openai/gym/gym/envs/robotics/assets/stls/fetch/laser_link.stl

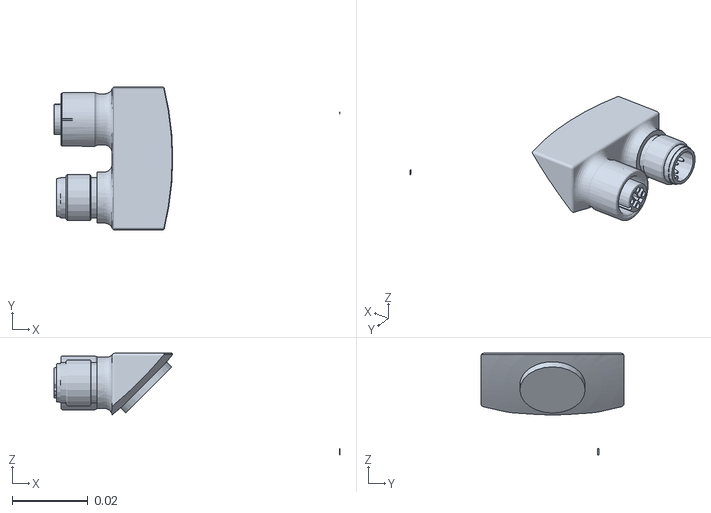
[picture p1: CAD file, 2018-02-26]
gym/envs/robotics/assets/stls/fetch/laser_link.stl
0.0754 x 0.0377 x 0.0268
