openai/gym/gym/envs/robotics/assets/stls/hand/TH2_z.stl

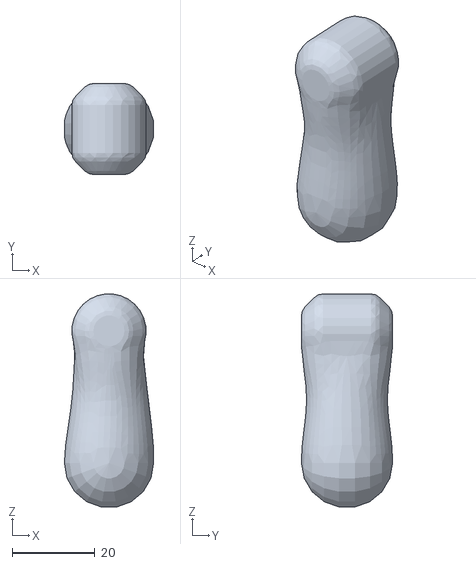
[picture p2: CAD file, 2018-02-26]
gym/envs/robotics/assets/stls/hand/TH2_z.stl
21.6 x 22.1 x 51.6
