openai/gym/gym/envs/robotics/assets/stls/fetch/base_link_collision.stl

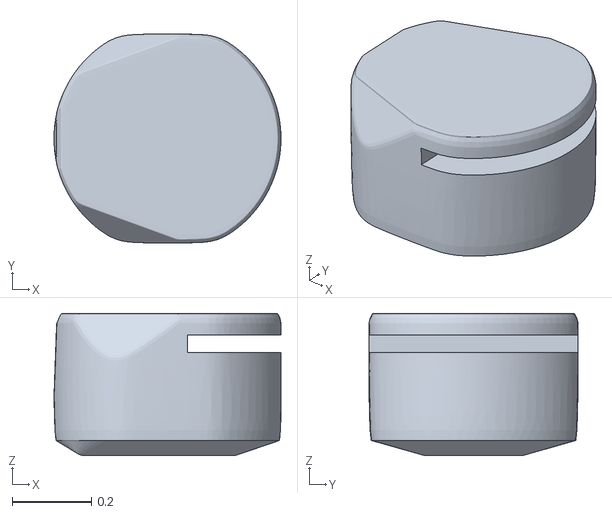
[picture p3: CAD file, 2018-02-26]
gym/envs/robotics/assets/stls/fetch/base_link_collision.stl
0.573 x 0.528 x 0.359
