openai/gym/gym/envs/robotics/assets/stls/hand/F1.stl

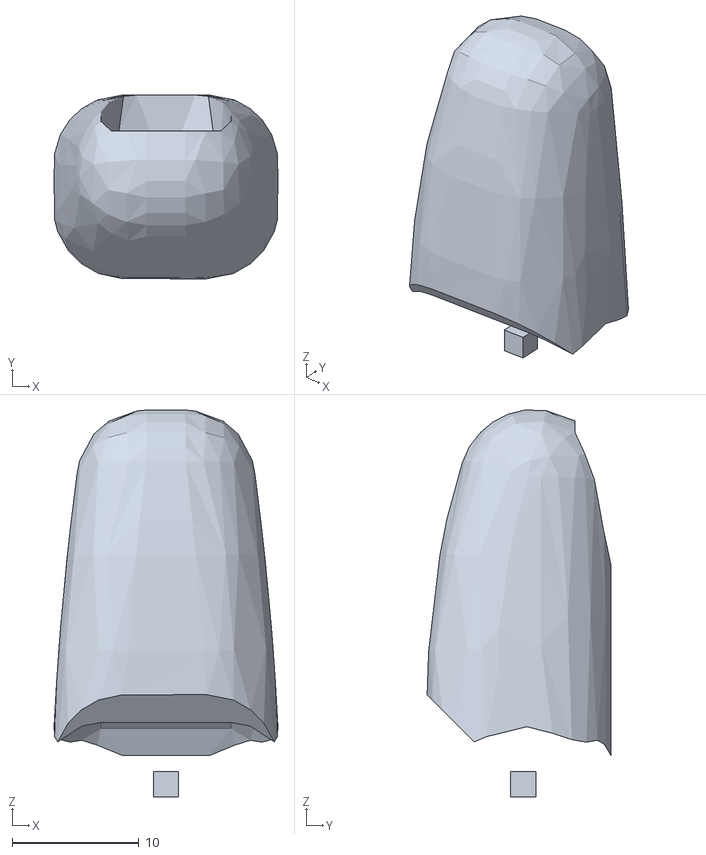
[picture p4: CAD file, 2018-02-26]
gym/envs/robotics/assets/stls/hand/F1.stl
17.7 x 14.5 x 30.5
