openai/gym/gym/envs/robotics/assets/stls/fetch/forearm_roll_link_collision.stl

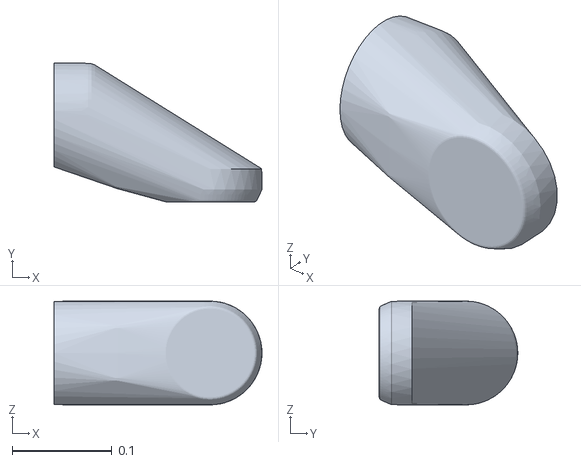
[picture p5: CAD file, 2018-02-26]
gym/envs/robotics/assets/stls/fetch/forearm_roll_link_collision.stl
0.208 x 0.139 x 0.104
