openai/gym/gym/envs/robotics/assets/stls/hand/lfmetacarpal.stl

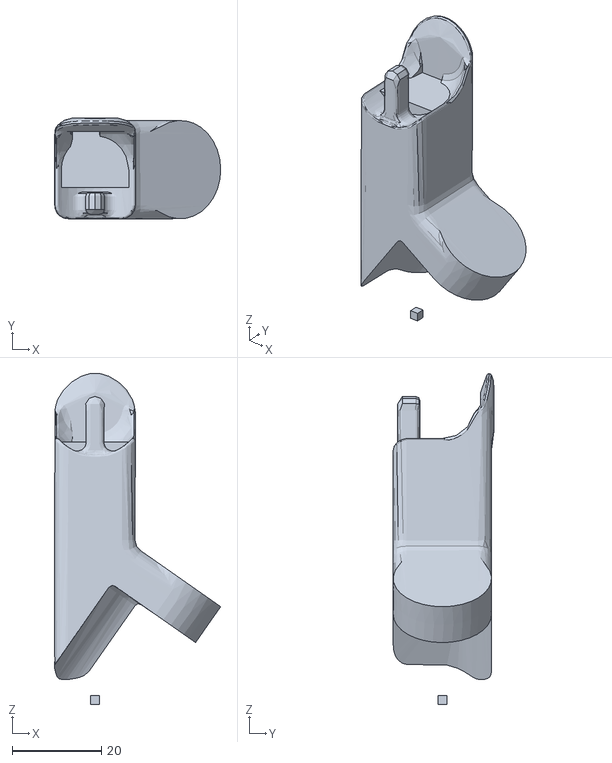
[picture p6: CAD file, 2018-02-26]
gym/envs/robotics/assets/stls/hand/lfmetacarpal.stl
37.3 x 22.5 x 74.1
