openai/gym/gym/envs/robotics/assets/stls/fetch/r_wheel_link_collision.stl

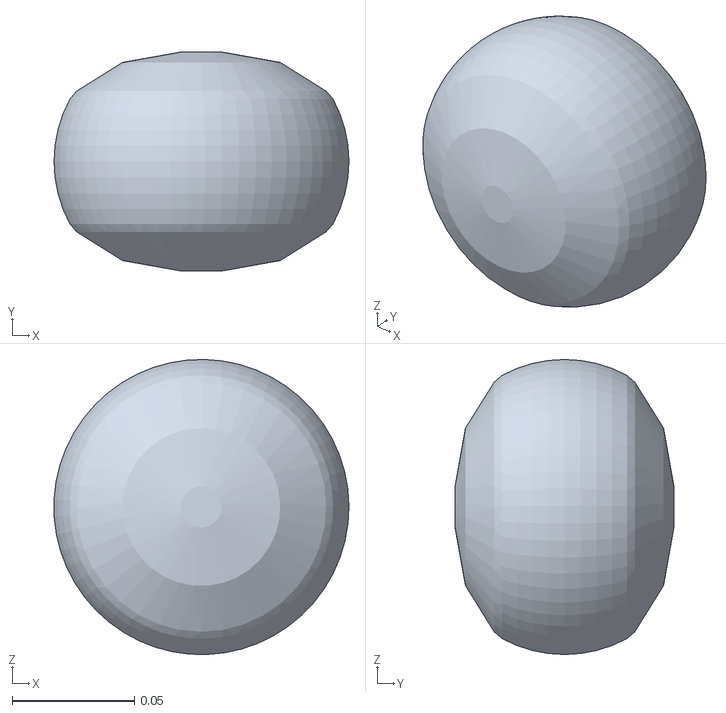
[picture p7: CAD file, 2018-02-26]
gym/envs/robotics/assets/stls/fetch/r_wheel_link_collision.stl
0.121 x 0.0895 x 0.121
