openai/gym/gym/envs/robotics/assets/stls/hand/palm.stl

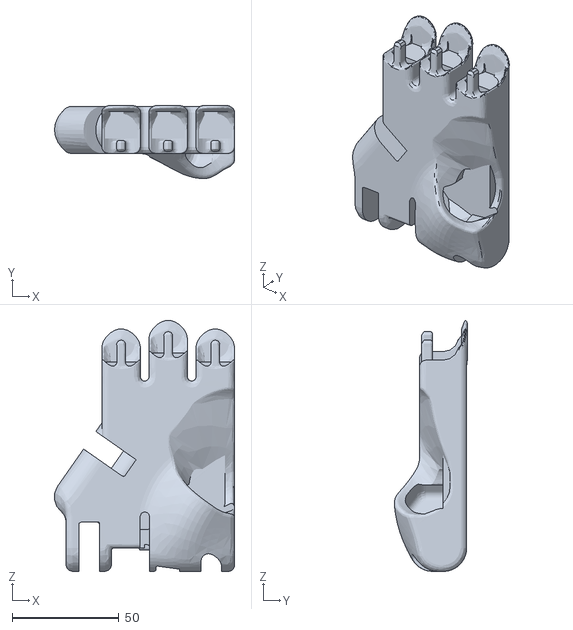
[picture p8: CAD file, 2018-02-26]
gym/envs/robotics/assets/stls/hand/palm.stl
84.2 x 34.3 x 117.3
