openai/gym/gym/envs/robotics/assets/stls/fetch/bellows_link_collision.stl

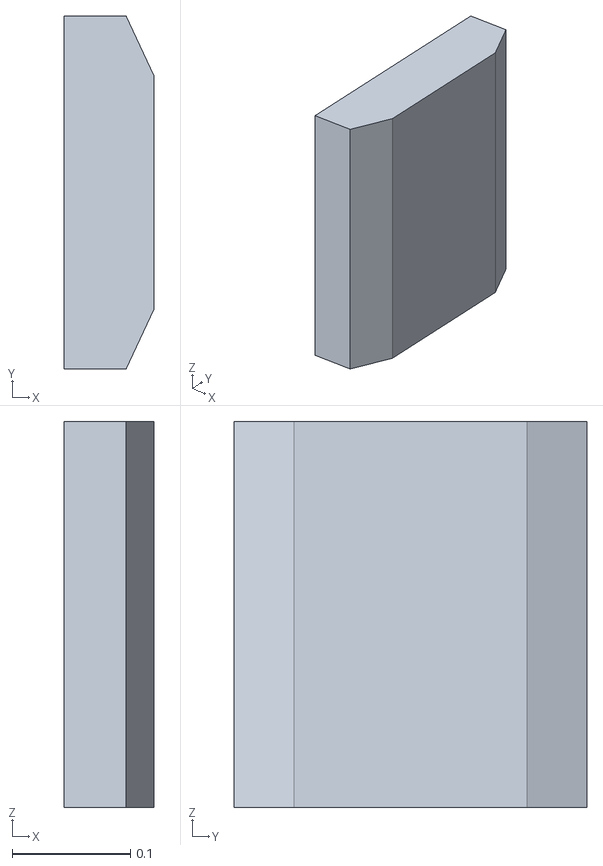
[picture p9: CAD file, 2018-02-26]
gym/envs/robotics/assets/stls/fetch/bellows_link_collision.stl
0.0764 x 0.299 x 0.327
