openai/gym/gym/envs/robotics/assets/stls/hand/wrist.stl

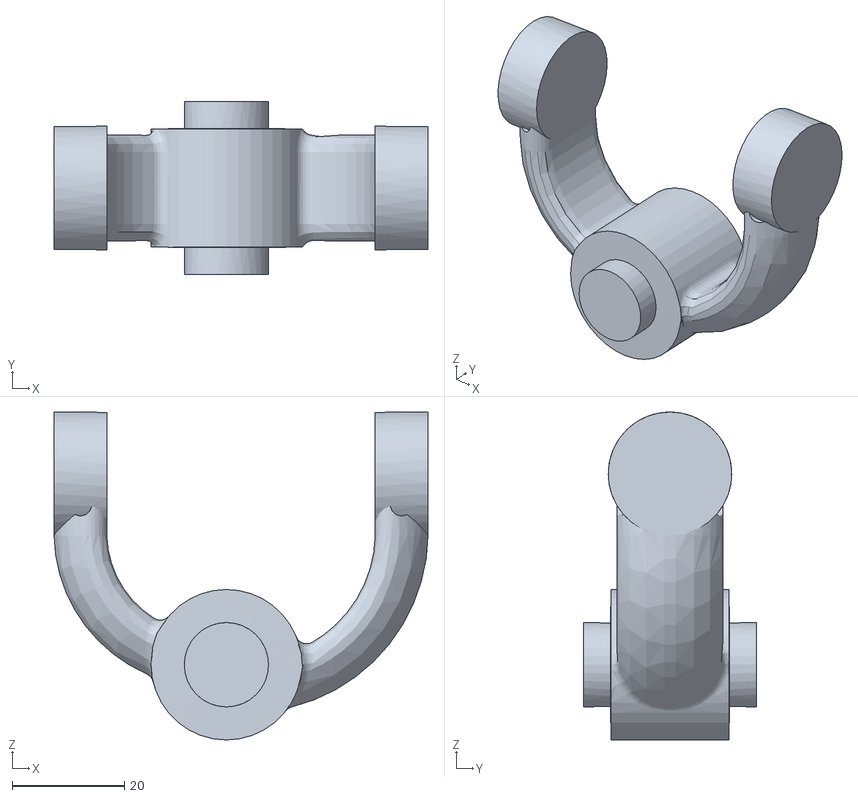
[picture p10: CAD file, 2018-02-26]
gym/envs/robotics/assets/stls/hand/wrist.stl
66.6 x 30.8 x 58.4
