openai/gym/gym/envs/robotics/assets/stls/fetch/wrist_flex_link_collision.stl

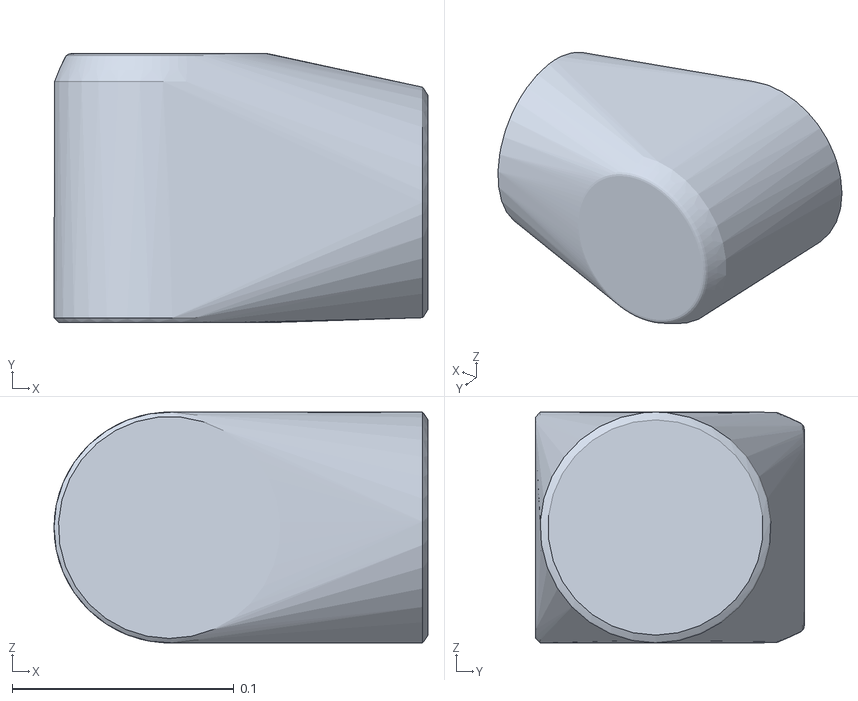
[picture p11: CAD file, 2018-02-26]
gym/envs/robotics/assets/stls/fetch/wrist_flex_link_collision.stl
0.168 x 0.121 x 0.104
