openai/gym/gym/envs/robotics/assets/stls/hand/F2.stl

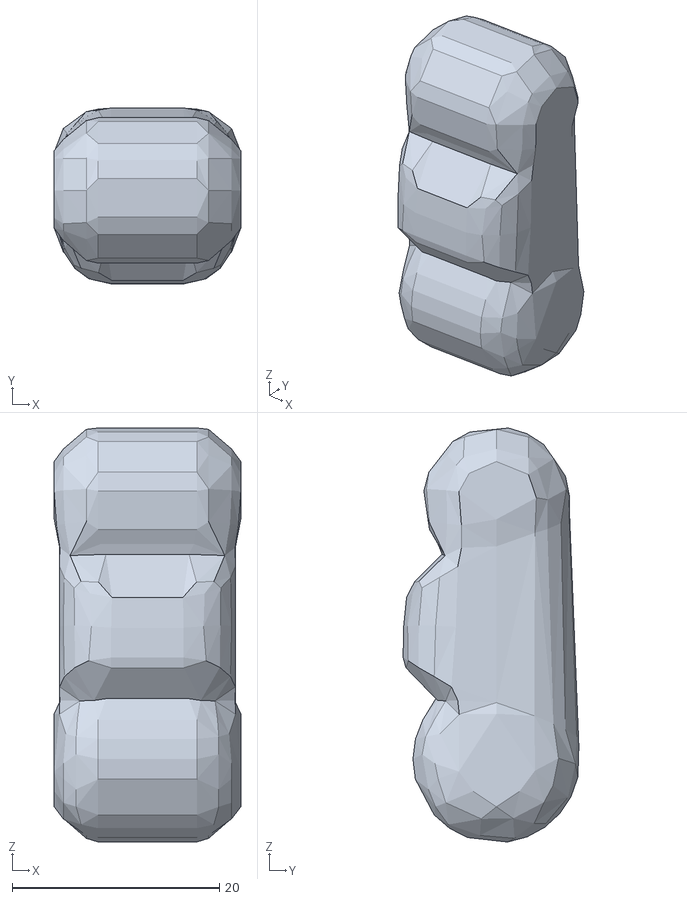
[picture p12: CAD file, 2018-02-26]
gym/envs/robotics/assets/stls/hand/F2.stl
18.0 x 17.0 x 39.9
