openai/gym/gym/envs/robotics/assets/stls/fetch/torso_fixed_link.stl

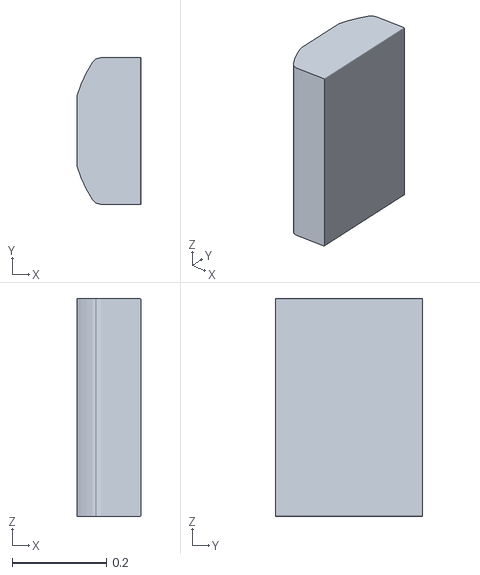
[picture p13: CAD file, 2018-02-26]
gym/envs/robotics/assets/stls/fetch/torso_fixed_link.stl
0.136 x 0.311 x 0.462
