openai/gym/gym/envs/robotics/assets/stls/hand/TH3_z.stl

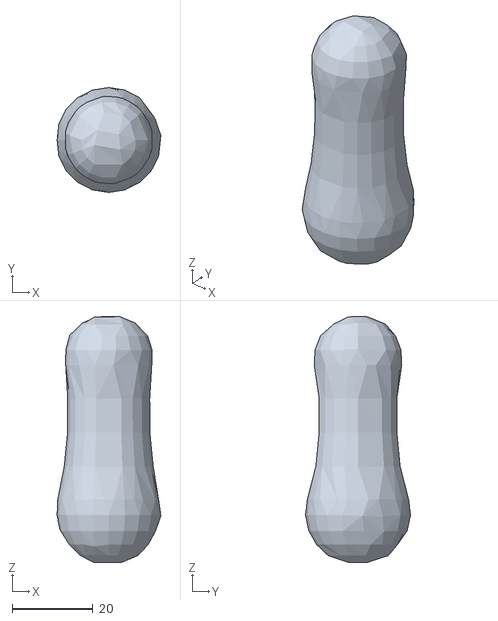
[picture p14: CAD file, 2018-02-26]
gym/envs/robotics/assets/stls/hand/TH3_z.stl
25.7 x 26.0 x 60.8
