openai/gym/gym/envs/robotics/assets/stls/fetch/gripper_link.stl

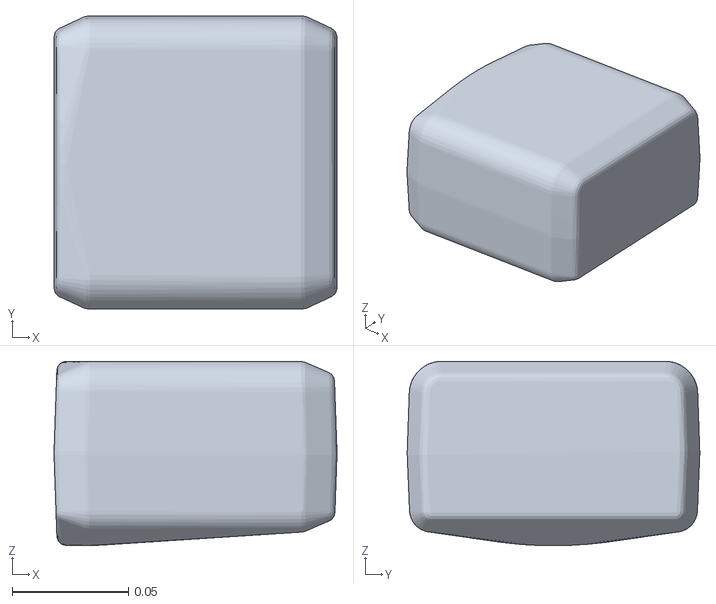
[picture p15: CAD file, 2018-02-26]
gym/envs/robotics/assets/stls/fetch/gripper_link.stl
0.122 x 0.126 x 0.0795
