openai/gym/gym/envs/robotics/assets/stls/hand/TH1_z.stl

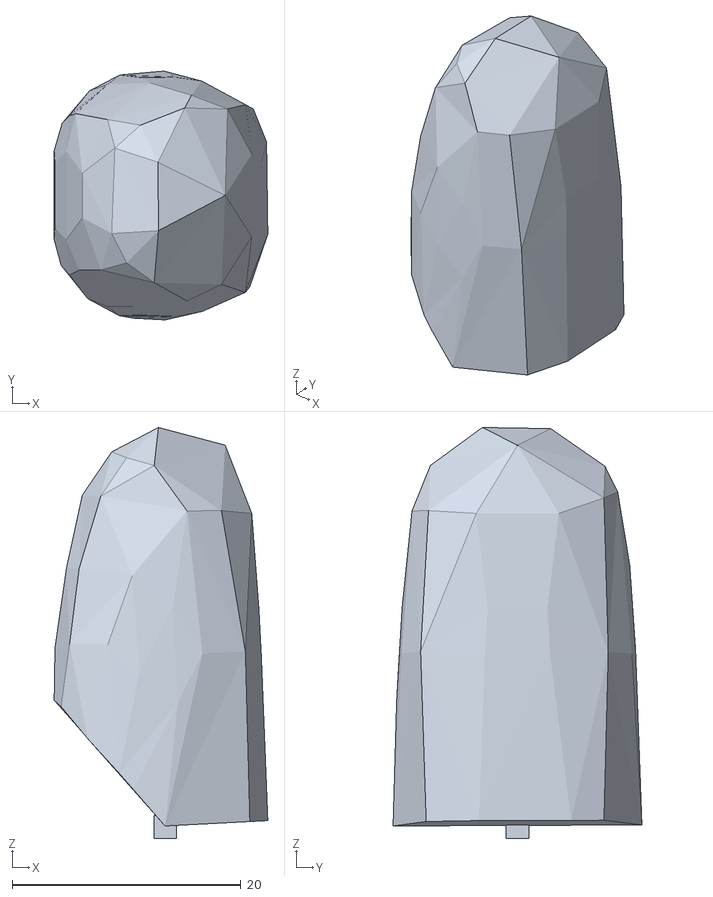
[picture p16: CAD file, 2018-02-26]
gym/envs/robotics/assets/stls/hand/TH1_z.stl
18.7 x 21.8 x 35.9
