openai/gym/gym/envs/robotics/assets/stls/fetch/head_tilt_link_collision.stl

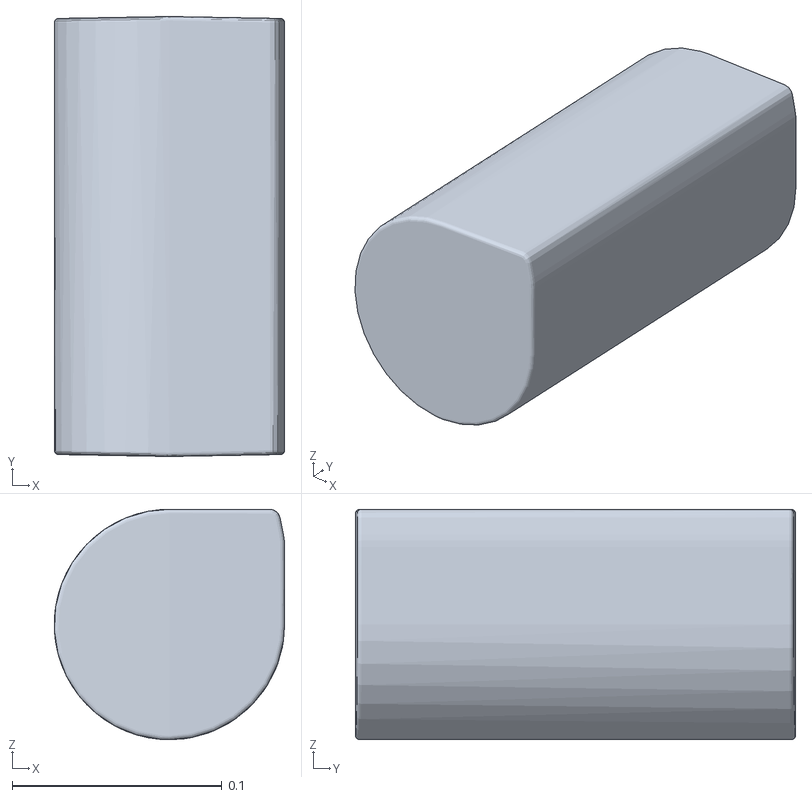
[picture p17: CAD file, 2018-02-26]
gym/envs/robotics/assets/stls/fetch/head_tilt_link_collision.stl
0.11 x 0.21 x 0.11
