openai/gym/gym/envs/robotics/assets/stls/hand/knuckle.stl

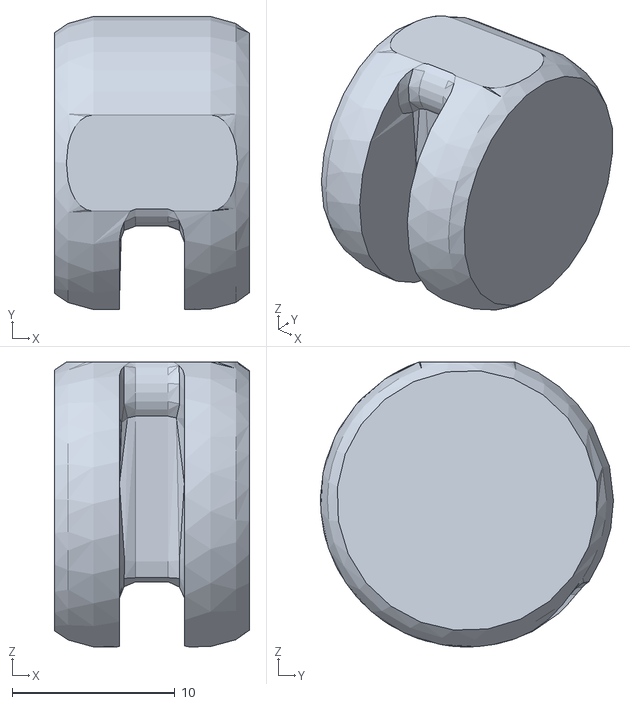
[picture p18: CAD file, 2018-02-26]
gym/envs/robotics/assets/stls/hand/knuckle.stl
12.0 x 18.0 x 17.5
