openai/gym/gym/envs/robotics/assets/stls/fetch/head_pan_link_collision.stl

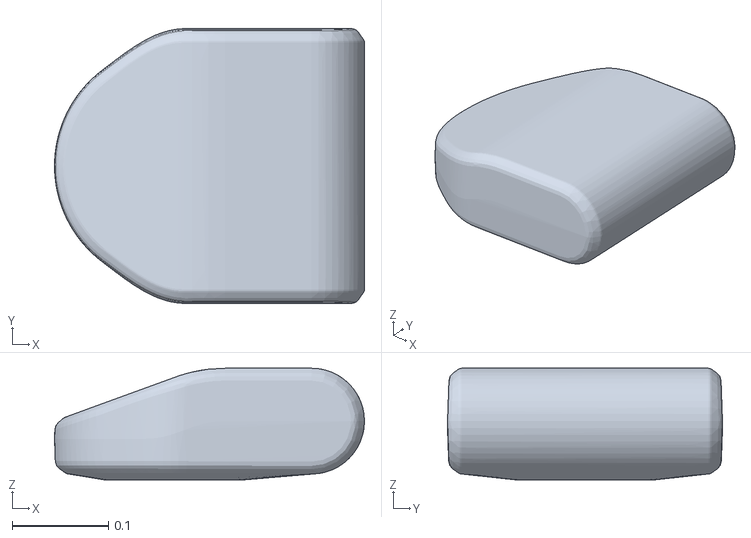
[picture p19: CAD file, 2018-02-26]
gym/envs/robotics/assets/stls/fetch/head_pan_link_collision.stl
0.322 x 0.286 x 0.116
