openai/gym/gym/envs/robotics/assets/stls/hand/forearm_electric_cvx.stl

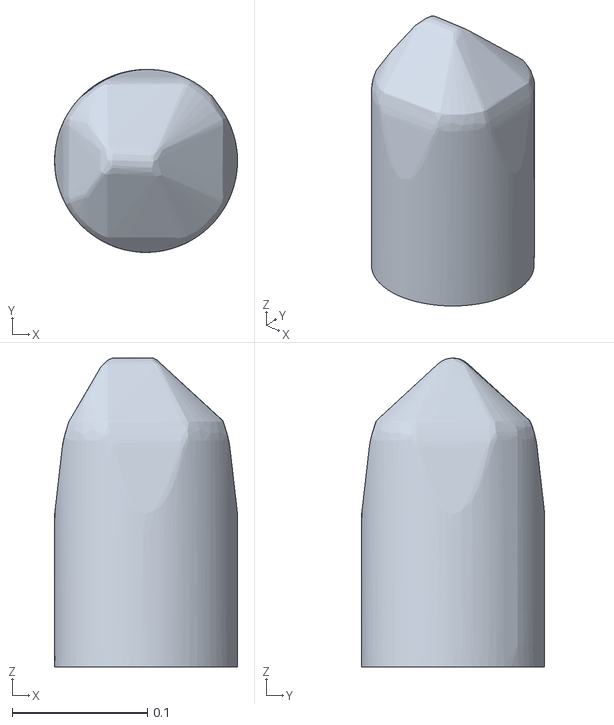
[picture p21: CAD file, 2018-02-26]
gym/envs/robotics/assets/stls/hand/forearm_electric_cvx.stl
0.135 x 0.135 x 0.228
