openai/gym/gym/envs/robotics/assets/stls/fetch/wrist_roll_link_collision.stl

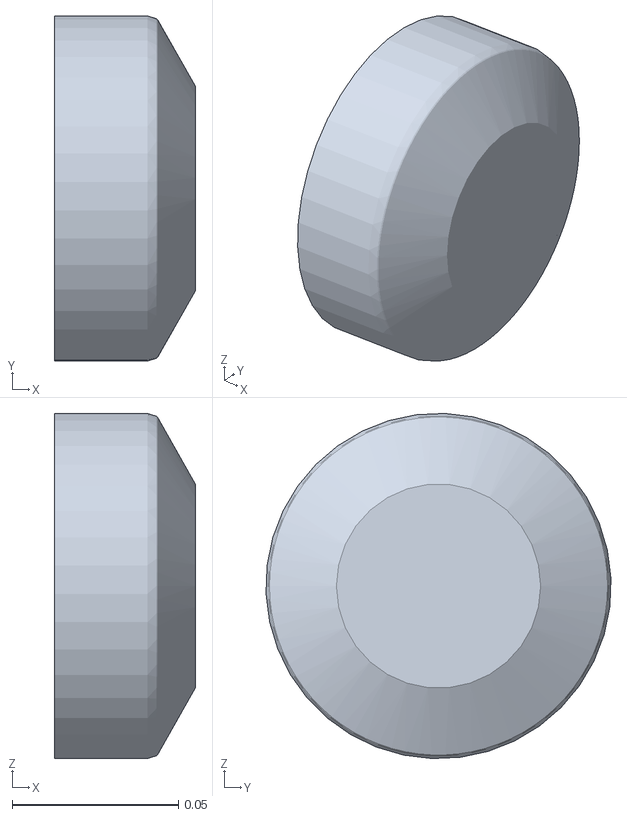
[picture p22: CAD file, 2018-02-26]
gym/envs/robotics/assets/stls/fetch/wrist_roll_link_collision.stl
0.0425 x 0.104 x 0.104
