openai/gym/gym/envs/robotics/assets/stls/hand/F3.stl

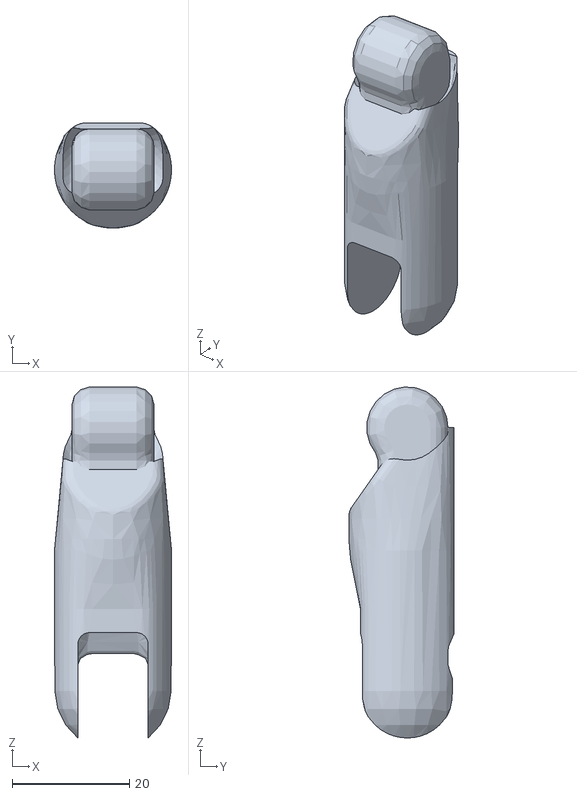
[picture p23: CAD file, 2018-02-26]
gym/envs/robotics/assets/stls/hand/F3.stl
20.0 x 18.0 x 59.9
