openai/gym/gym/envs/robotics/assets/stls/fetch/elbow_flex_link_collision.stl

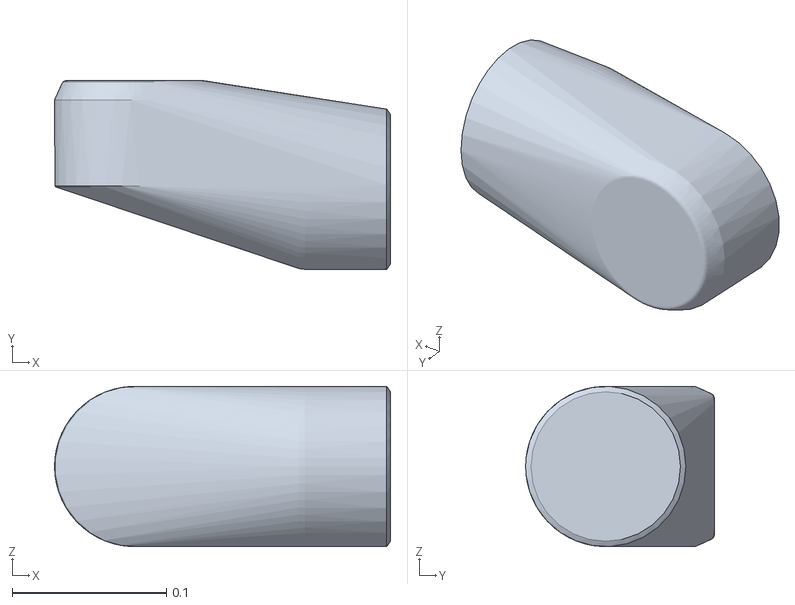
[picture p24: CAD file, 2018-02-26]
gym/envs/robotics/assets/stls/fetch/elbow_flex_link_collision.stl
0.218 x 0.123 x 0.104
