openai/gym/gym/envs/robotics/assets/stls/fetch/upperarm_roll_link_collision.stl

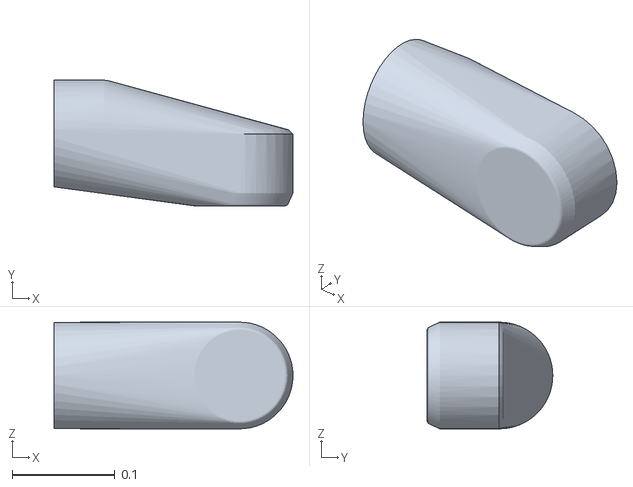
[picture p25: CAD file, 2018-02-26]
gym/envs/robotics/assets/stls/fetch/upperarm_roll_link_collision.stl
0.233 x 0.123 x 0.104
