openai/gym/gym/envs/robotics/assets/stls/fetch/shoulder_pan_link_collision.stl

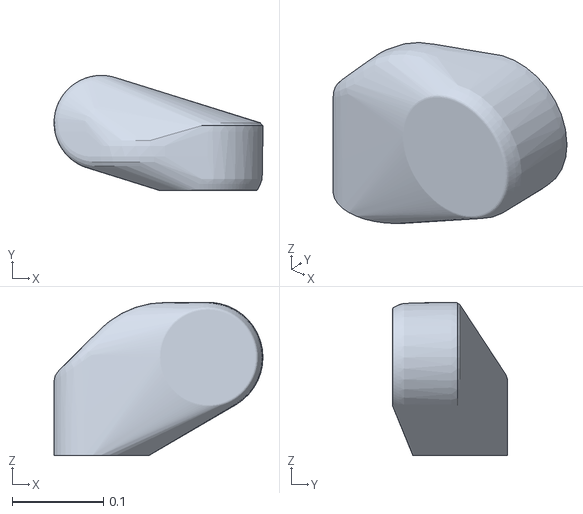
[picture p26: CAD file, 2018-02-26]
gym/envs/robotics/assets/stls/fetch/shoulder_pan_link_collision.stl
0.229 x 0.127 x 0.168
