openai/gym/gym/envs/robotics/assets/stls/fetch/estop_link.stl

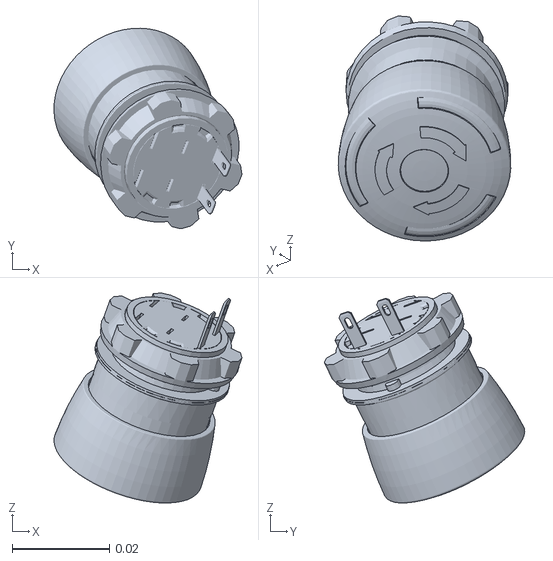
[picture p27: CAD file, 2018-02-26]
gym/envs/robotics/assets/stls/fetch/estop_link.stl
0.0387 x 0.0413 x 0.0433
