openai/gym/gym/envs/robotics/assets/stls/fetch/torso_lift_link_collision.stl

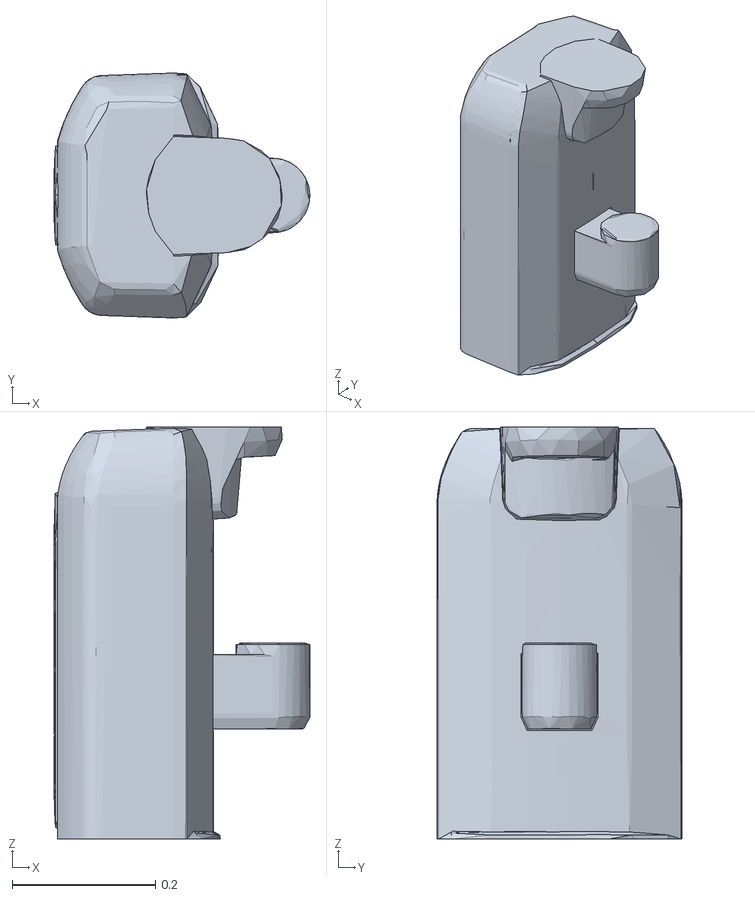
[picture p28: CAD file, 2018-02-26]
gym/envs/robotics/assets/stls/fetch/torso_lift_link_collision.stl
0.357 x 0.342 x 0.575
