openai/gym/gym/envs/robotics/assets/stls/fetch/shoulder_lift_link_collision.stl

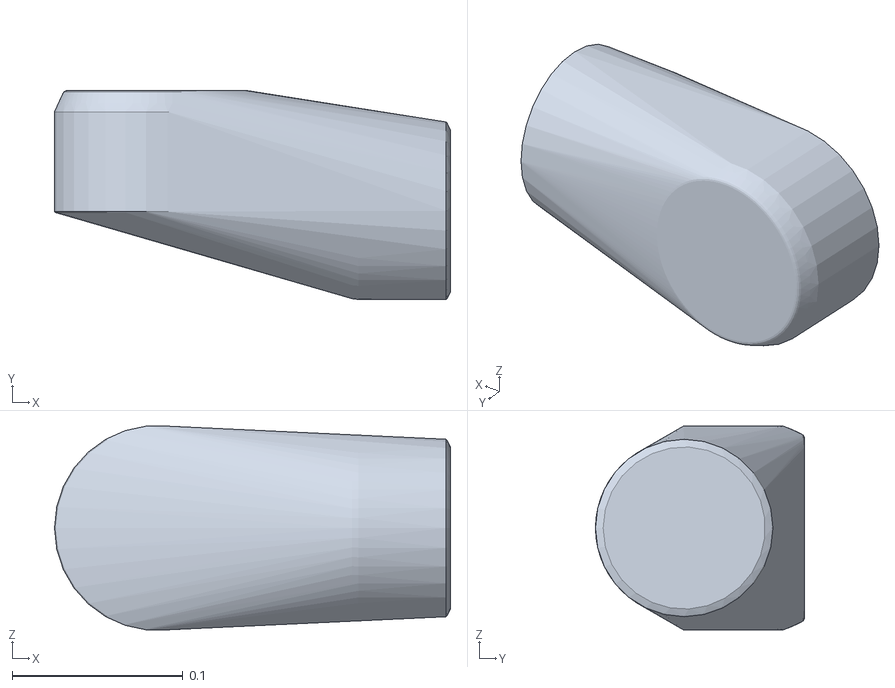
[picture p29: CAD file, 2018-02-26]
gym/envs/robotics/assets/stls/fetch/shoulder_lift_link_collision.stl
0.232 x 0.123 x 0.119
