openai/gym/(list of files, cad)

Other CAD files:
gym/envs/robotics/assets/stls/fetch/l_wheel_link_collision.stl
