openai/gym/docs/tutorials.md

## Getting Started With OpenAI Gym: The Basic Building Blocks

https://blog.paperspace.com/getting-started-with-openai-gym/

A good starting point explaining all the basic building blocks of the Gym API.

## Reinforcement Q-Learning from Scratch in Python with OpenAI Gym
Good Algorithmic Introduction to Reinforcement Learning showcasing how to use Gym API for Training Agents.

https://www.learndatasci.com/tutorials/reinforcement-q-learning-scratch-python-openai-gym/

## Tutorial: An Introduction to Reinforcement Learning Using OpenAI Gym

https://www.gocoder.one/blog/rl-tutorial-with-openai-gym
