openai/gym/(threads)

Thread 3 (2016-04-27):

ipython render window can't be closed

iandanforth, 2016-04-27:
If you attempt to create a notebook with the first CartPole example, the code runs but the rendered window cannot be closed:

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

Neither the standard x, nor ctrl-c, nor terminating the kernel through the notebook UI cause the window to close. If you kill the parent ipython process from the cmd line, that will kill all the child windows as expected.

System: Ubuntu 14.04 64.

Pretty cool this works at all though!

joschu, 2016-04-27:
You should be able to do env.render(close=True)

iandanforth, 2016-04-27:
Thanks! That works. FYI my thought process was to 1. Try reset 2. look for top level methods like env.exit, env.stop, env.close etc.

gdb, 2016-04-28:
Yeah, the `render(close=...)` method is a bit of a compromise: we want to keep the env API as simple as possible, both for implementors and consumers of the interface. I didn't want to add a top-level `close` method, since it's hard to know exactly *what* that'd mean (is the environment now permanently dead)? But if things get more complex, we could add a linked `renderer` object a la `monitor`.

erickrf, 2016-10-18:
I can't solve the problem with `env.render(close=True)` under macOS Sierra. If I try it, the renderized window just goes blank. Each time I call `env.render()`, a new window is created, and I can see all of them under mission control. Is there some way to close them?

capybaralet, 2017-04-18:
I have this problem as well.

If I make two envs (both called env), I lose the handle for the first one, so I can't close the window with env.render.

Is there a solution in this case? (other than closing the interactive session)

ethanluoyc, 2017-05-16:
I think this API is rather confusing indeed. I expect is to allow me to render the rgb view without opening a window but apparently that is not what it is doing. How can I get the desired behaviour?

tlbtlbtlb, 2017-05-16:
Unfortunately the rendering engine (OpenGL) is part of the window system,
and it needs at least an invisible window to associate it with some display
hardware.  Using a separate rendering engine for off-screen drawing is a
big project. Can you describe your use case to help us decide what we might
build?

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
--
Trevor Blackwell   tlb@openai.com    650 776 7870

ethanluoyc, 2017-05-19:
That is unfortunate. I do not really have a hard requirement for not displaying the window, but it is just that sometimes I do not need to see the window at all during training.

tlbtlbtlb, 2017-05-19:
If you don't need the window at all, just don't call `env.render()`.

ethanluoyc, 2017-05-21:
@tlbtlbtlb I think I can't. In my experiment I am using the visual image data directly as feature input. However, I think there is no other API for me to obtain that other than using `render`?

ahsteven, 2018-03-01:
Hi I just installed gym atari today. And ran the test code for atari:

`import gym
env = gym.make('SpaceInvaders-v0')
env.reset()
env.render()`

The Atar window pops open. however when I try to close with

env.render(close=True)

I get the error:
Traceback (most recent call last):
  File "<stdin>", line 1, in <module>
TypeError: render() got an unexpected keyword argument 'close'

cuongqn, 2018-03-04:
@ahsteven I think close is now a top level method. Using `env.close()` at the end when you want to close the window works for Windows 10 on Python 3.5.0.

lcukerd, 2018-05-08:
@cuongqn How do I close it after I interrupt the Kernel? `env.close()` is written at the end and will not work in case of Kernel interrupt. How do I close the window now?

shuruiz, 2018-06-11:
The env.render(close=True) command does not work for me. I got the following error:
---------------------------------------------------------------------------
TypeError                                 Traceback (most recent call last)
<ipython-input-4-56748e507b21> in <module>()
     13                 print("Total reward for episode: {}".format(episode_reward))
     14                 break
---> 15 random_agent(10)

<ipython-input-4-56748e507b21> in random_agent(num_episodes)
      6
      7         for t in range(1000):
----> 8             env.render(close=True)
      9             action =env.action_space.sample()
     10             observation, reward, done,info = env.step(action)

TypeError: render() got an unexpected keyword argument 'close'

nemanja-rakicevic, 2018-07-10:
In the new version of gym==0.9 you should use `env.close()`  but it doesn't close the render window...

skyler237, 2018-11-18:
A workaround I found is to simply wrap the training/simulation loop in a try-finally block so that even if I exit the loop early, the window will close.
For example:
`try:
    # training loop
finally:`

jimhoggey, 2019-07-17:
> env.render(close=True)

this did not work for me in gym retro parallel learning
but what did work was `self.env.render(close=True)`
thanks so much for the help
this has been a long issue that I could't fix but I finally did :)))))

insublee, 2019-10-30:
`env.render(close=True)`
didn't work for me. but
`env.render(mode='close')`
work.

sprakashdash, 2020-03-29:
You can also try `env.close()`. That too works for me!

DhruvaG2000, 2020-07-04:
I am using jupyter-notebook
env.render(close=True)
didn't work, it says 'close' keyword not recognized.
env.close() worked better, but even then sometimes a black window remained.
I had to exit() to close in that case. I guess gym isn't made to run in ipython-like environments?

sprakashdash, 2020-07-04:
The version compatibility might be an issue. The best compatibility is found with `python 3.6` and `gym 0.15`. Another hack is to use `env.render()` at the end of the for loop to close the window (in the same cell) and it works like charm!

samisnotinsane, 2021-06-03:
This issue is still ongoing. When I run CartPole-v0 demo:

```
import gym

env = gym.make('CartPole-v0')
env.reset()

for _ in range(1000):
    env.render()
    env.step(env.action_space.sample()) #take a random action

env.close()
```

The demo runs and then when I go to close it by clicking red X on the window, it freezes. I can force quit using OS and this kills the kernel. Once I restart kernel, I can run again but same behaviour repeats.

System spec:
```
Mac OS Big Sur   : 11.2.3
Python           : 3.8.5
Gym              : 0.18.0
jupyter core     : 4.7.0
jupyter-notebook : 6.1.4
qtconsole        : not installed
ipython          : 7.19.0
ipykernel        : 5.3.4
jupyter client   : 6.1.7
jupyter lab      : 2.2.9
nbconvert        : 6.0.7
ipywidgets       : 7.5.1
nbformat         : 5.0.8
traitlets        : 5.0.5
```

adyomin, 2021-07-23:
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

I get the following warning when I run this, the undefined behavior part seems potentially relevant:

> /home/adyomin/miniconda3/envs/sb3/lib/python3.8/site-packages/gym/logger.py:30: UserWarning: WARN: You are calling 'step()' even though this environment has already returned done = True. You should always call 'reset()' once you receive 'done = True' -- any further steps are undefined behavior.
  warnings.warn(colorize('%s: %s'%('WARN', msg % args), 'yellow'))

Checking for episode termination does solve the issue for me:

```
import gym

env = gym.make('CartPole-v0')
env.reset()

for _ in range(1000):
    env.render()
    obs, rewards, dones, info = env.step(env.action_space.sample()) #take a random action
    if dones:
        env.close()
        break
```

eemelipa, 2021-08-02:
@samisnotinsane as a workaround try to add `from gym.utils import play` to your imports. So run

```
import gym
from gym.utils import play

#%%

env = gym.make('CartPole-v0')
env.reset()

#%%

for _ in range(1000):
    env.render()
    env.step(env.action_space.sample()) #take a random action

env.close()
```

where "#%%" is a code cell separation. That helped for me. No idea why, but now the window closes from the cross and with env.close()  🤷

Almost like the plain gym import is missing something relevant for rendering on Mac.

I've got

```
Mac Os Big Sur      11.5
Python              3.7.11
gym                 0.18.3
jupyter-client      6.1.12
jupyter-console     6.4.0
jupyter-core        4.7.1
ipykernel           5.3.4
ipython             7.22.0
```

Closed 2016-04-28.

Thread 4 (2016-04-27):

video rendering doesn't work on windows

222464, 2016-04-27:
Hello,

I am able to run the gym on my windows machine, for the most part. However, despite ffmpeg being installed and added to the PATH (and detected), I get the following error when trying to render video:

`Clearing 2 monitor files from previous run (because force=True was provided)
[2016-04-27 16:31:49,407] Starting new video recorder writing to C:\tmp\random-agent-results\openaigym.video.0.17236.video000000.mp4
/dev/stdin: No such file or directory
Traceback (most recent call last):
  File "Gym.py", line 76, in <module>
    ob = env.reset()
  File "C:\Users\BlackBox\Anaconda3\envs\py27\lib\site-packages\gym-0.0.3-py2.7.egg\gym\core.py", line 87, in reset
    self.monitor._after_reset(observation)
  File "C:\Users\BlackBox\Anaconda3\envs\py27\lib\site-packages\gym-0.0.3-py2.7.egg\gym\monitoring\monitor.py", line 237, in _after_reset
    self.video_recorder.capture_frame()
  File "C:\Users\BlackBox\Anaconda3\envs\py27\lib\site-packages\gym-0.0.3-py2.7.egg\gym\monitoring\video_recorder.py", line 111, in capture_frame
    self._encode_image_frame(frame)
  File "C:\Users\BlackBox\Anaconda3\envs\py27\lib\site-packages\gym-0.0.3-py2.7.egg\gym\monitoring\video_recorder.py", line 161, in _encode_image_frame
    self.encoder.capture_frame(frame)
  File "C:\Users\BlackBox\Anaconda3\envs\py27\lib\site-packages\gym-0.0.3-py2.7.egg\gym\monitoring\video_recorder.py", line 284, in capture_frame
    self.proc.stdin.write(frame.tobytes())
IOError: [Errno 22] Invalid argument
[2016-04-27 16:31:50,016] VideoRecorder encoder exited with status 1`

When not using video, and explicitly calling env.render(), it works fine.

It seems to be a Linux-specific thing? Is there a quick way to fix this to get it to run on windows?

jonasschneider, 2016-04-27:
Hi, sorry, we currently aren't testing anything on Windows specifically. However, we'd love to help with getting everything to work there (and will definitely merge changes that fix compatibility).

If you have the time, could you try just replacing `/dev/stdin` with `-` in the `video_recorder.py` line mentioned in your log? This particular issue might be an easy fix.

222464, 2016-04-28:
Yes, it seems to work now. Thanks!

Closed 2016-04-28.

Thread 16 (2016-04-28):

[working deep RL demo][need help]Lasagne+Agentnet baselines

justheuristic, 2016-04-28:
Greetings!
We happen to have just pushed into the open source one of the Lasagne-based library for reinforcement learning algorithm design.

* The repo's here: [AgentNet](https://github.com/yandexdataschool/AgentNet)
* [A step-by-step demo for Atari SpaceInvaders ](https://github.com/yandexdataschool/AgentNet/blob/master/examples/Playing%20Atari%20with%20Deep%20Reinforcement%20Learning%20%28OpenAI%20Gym%29.ipynb)
* [Neural Kung-Fu with GRU and actor-critic](https://github.com/yandexdataschool/AgentNet/blob/master/examples/Deep%20Kung-Fu%20with%20GRUs%20and%20A2c%20algorithm%20%28OpenAI%20Gym%29.ipynb)

On the bright side,
- it is capable of sustaining virtually any custom RL (and even non-RL) architecture using minimalistic Lasagne network design
- it has most of the generic reinforcement learning algorithms (Q-learning, K-step algos, SARSA, Advantage Actor-Critic)
- It is also capable of interacting with any external environment with a simple wrapper.

On the gloomy one,  it has been made public ~4 days ago and doesn't have a community yet. Prior to that, it's only been used by several Yandex researchers for tinkering.

I would very much like to provide a set of baseline training/testing stands for several problems (and i will do so shortly), for people to be able to experiment with NN architecture, but i'm a bit doubtful about
- whether the interface of the library doesn't have any flaws worth immediate fixing
- whether there is someone interested in tinkering with openai baselines, provided they're readable and performing reasonably.

The most basic Reinforcement Learning pipeline looks [like this](https://github.com/yandexdataschool/AgentNet/blob/master/examples/Basic%20tutorial%20on%20Boolearn%20Reasoning%20problem.ipynb)

The questions are, again, if there is anyone interested in having such baselines for gym problems, and if so, what are possible api improvements you would recommend?

wojzaremba, 2016-04-28:
Having good, simple baselines is super important. This could tell which simple algorithms work. Feel free to submit your algs, and we will reproduce it, and review it.

justheuristic, 2016-04-29:
It actually turned out that our interfaces are even closer - around 30 lines of code from my example to start plating atari with simple convolutional q-network.

 - [The demo for Atari AirRaid ](https://github.com/yandexdataschool/AgentNet/blob/master/examples/AirRaid%20-%20Simple%20ConvNet.ipynb) (current notebook output is training session that was interrupted earlier than should be)
- [Some tinkering with SpaceInvaders](https://github.com/yandexdataschool/AgentNet/tree/master/research/gym)

Could you please try to run them on your side to see if they are indeed reproducible?

The problem is, to simplify the code i avoided bot recurrent memory layers and DeepMind tricks from atari article - simply trained a NN that tries to act based on current image frame - and of course i forgot that the atari games have flickering effect and some frames are plain rubbish.
So the next step (after some sleep) is definitely adding memory, since that is why the library was built in the first place.

Gym is indeed a super-unified interface, as switching through several atari games boiled down to simply switching their names in the notebook header.

Now the main question is, if these demos are at least somewhat readable, what would be the best course of actions to make them more interpretable?

justheuristic, 2016-04-29:
[updated comment above: the demo became more readable and has better scores]

wojzaremba, 2016-04-29:
Awesome. Looking forward for you submissions.

justheuristic, 2016-04-30:
This one is clearly early-stopped (learning curve still goes up almost linearly), but it works ~somehow~ nevertheless.
https://gym.openai.com/evaluations/eval_yv5uO0fRiS7eNaZGFKacw#reproducibility

justheuristic, 2016-04-30:
The question stands: how to make these more understandable?

justheuristic, 2016-05-01:
Thanks.
Added more detailed NN setup.

Again, please suggest any ways this thing can get easier to understand.

gdb, 2016-05-01:
(I might recommend asking in chat — I think one helpful approach might be to ask a beginner to work through it.)

justheuristic, 2016-05-02:
Well, i was stupid not to. Thanks!

Upd - trained NN to hurt humans using Kung-Fu, GRU and advantage actor-critic
https://github.com/yandexdataschool/AgentNet/blob/master/examples/Deep%20Kung-Fu%20with%20GRUs%20and%20A2c%20algorithm%20%28OpenAI%20Gym%29.ipynb

gdb, 2016-05-16:
(Going to close this; please let me know if there's more to discuss!)

Closed 2016-05-16.

Thread 9 (2016-04-28):

Error try to run monitoring

harshhemani, 2016-04-28:
When trying to run following code on Ubuntu MATE 14.04 LTS on intel i7:
```
import gym
env = gym.make("CartPole-v0")
env.monitor.start("/tmp/cartpole-experiment-1")
for i_episode in xrange(20):
    observation = env.reset()
    for t in xrange(100):
        env.render()
        print observation
        action = env.action_space.sample()
        observation, reward, done, info = env.step(action)
        if done:
            print "Episode finished after {} timesteps".format(t+1)
            break

env.monitor.close()
```

I get following error:
```
[2016-04-28 10:59:12,799] Making new env: CartPole-v0
[2016-04-28 10:59:12,800] Creating monitor directory /tmp/cartpole-experiment-1
[2016-04-28 10:59:12,801] Starting new video recorder writing to /tmp/cartpole-experiment-1/openaigym.video.0.8846.video000000.mp4
avconv version 9.18-6:9.18-0ubuntu0.14.04.1, Copyright (c) 2000-2014 the Libav developers
  built on Mar 16 2015 13:19:10 with gcc 4.8 (Ubuntu 4.8.2-19ubuntu1)
Traceback (most recent call last):
  File "temp.py", line 5, in <module>
    observation = env.reset()
  File "/usr/local/lib/python2.7/dist-packages/gym/core.py", line 87, in reset
    self.monitor._after_reset(observation)
  File "/usr/local/lib/python2.7/dist-packages/gym/monitoring/monitor.py", line 237, in _after_reset
    self.video_recorder.capture_frame()
  File "/usr/local/lib/python2.7/dist-packages/gym/monitoring/video_recorder.py", line 111, in capture_frame
    self._encode_image_frame(frame)
  File "/usr/local/lib/python2.7/dist-packages/gym/monitoring/video_recorder.py", line 161, in _encode_image_frame
    self.encoder.capture_frame(frame)
  File "/usr/local/lib/python2.7/dist-packages/gym/monitoring/video_recorder.py", line 284, in capture_frame
    self.proc.stdin.write(frame.tobytes())
AttributeError: 'numpy.ndarray' object has no attribute 'tobytes'
[2016-04-28 10:59:13,196] Finished writing results. You can upload them to the scoreboard via gym.upload('/tmp/cartpole-experiment-1')
```

Clearly the frame returned by `encoder.capture_frame()` is storing returning ndarray in the `frame`. How can I solve this?
PS: Without monitor, code runs perfectly.

rodrigob, 2016-04-28:
Please check that you are using a recent version of numpy.

Seems that tobytes was introduced in 1.9 back in 2014.
https://github.com/numpy/numpy/issues/6163

harshhemani, 2016-04-29:
Updates numpy, and it worked.
Also, tried fix#9 with old numpy, and it still worked.
Thanks.

Closed 2016-04-29.

Thread 41 (2016-05-01):

More discreet environments (Box2D)

olegklimov, 2016-05-01:
Hello,

I've found very few discreet environments to play with. It's MountainCar and CartPole, that's all, if you don't count Atari. All MuJoCo games have continuous actions.

I happen to have a few Box2D reinforcement learning environments, that I want to port. I think it's a good idea because Box2D is open-source, easy to install (pip install box2d) like the rest of gym. Should be a good start for new people.

1) CartPole swing up, physics, friction, more reward if kept in center (3 actions).

2) MoonLander (6-wide state, 4 actions).

3) PipedalWalker (16-wide state, 4 actuated joints, 3*3*3*3=81 actions).

Greg, John please tell me if you don't need it and not going to merge it, I'll stop.

rickhenderson, 2016-05-02:
Have you posted code for your environments? Maybe if people saw them and tried them out then more people would request they get added. I'm new here so just throwing out suggestions.

joschu, 2016-05-02:
+1: a good first step would be to post the code somewhere, e.g., in it's own github repo.
I'd recommend creating the envs with continuous action spaces. If people need discrete actions, they can discretize themselves.

olegklimov, 2016-05-02:
Please someone test if it works for you.

https://github.com/olegklimov/gym/commits/box2d

I'll make one or two more environments and publish a PR.

olegklimov, 2016-05-02:
To test, run one of these:

```bash
python examples/agents/keyboard.py LunarLander-v0
python examples/agents/keyboard.py CartPoleSwingUp-v0
```

You should get be able to play from keyboard like this:

https://youtu.be/ZTlpZSN5gdA

I don't have a working learning agent at hand, cannot test reward and states of this two environments. If you have, please give it a try.

joschu, 2016-05-02:
These are nice! I'm running learning algorithms on them now.

jonasschneider, 2016-05-03:
These are really cool. Can you open a PR so we can start discussing the code? (In particular, I'm wondering if we can make Box2D installation any easier.)

joschu, 2016-05-03:
What's the reward function for lunar lander? I'm getting the following behavior, is it optimal?
[openaigym.video.0.24.video035000.mp4.zip](https://github.com/openai/gym/files/247258/openaigym.video.0.24.video035000.mp4.zip)
My algorithm didn't solve cart-pole swing-up, but maybe that's just because it's not exploring well enough. Have you verified that it's possible to solve with keyboard control in the allotted timesteps?

jonasschneider, 2016-05-03:
I think the reward function might be missing a component that forces you to land eventually, e.g. a "running out of fuel", or maybe the alive penalty just has to be higher.

Could also imagine penalizing high accelerations, high distances from the helipad, and/or forceful/non-upright ground impact.

olegklimov, 2016-05-03:
> Could also imagine penalizing high accelerations, high distances from the helipad, and/or forceful/non-upright ground impact.

`shaping = - abs(state[0]) - abs(state[1]) - abs(state[2]) - abs(state[3]) - abs(state[4])`

It is distance from helipad (`state[0]` and `state[1]`), high speed (`state[2]` and `state[3]`) and high angular velocity (`state[4]`).

Total potential change from top of the screen to target is about 1.4, i.e. to get to helipad and have zero speed is about 1.4 total reward. On landing (body not awake) it receives additional +1. On crash, -1.

I'm not saying it has no bugs, sure there's something.

> I'm getting the following behavior, is it optimal

Optimal is to come down and get zero speed (+1.4) and land (another +1). Solved is more than 2.0. Hopefully.

olegklimov, 2016-05-03:
> Can you open a PR

I'm working on third environment (with normal and hardcore version), then I'll make another branch (I noticed botched merge on current branch) and PR.

olegklimov, 2016-05-03:
https://github.com/openai/gym/pull/54

gdb, 2016-05-16:
(#54 is merged; closing issue.)

Rokas98765, 2017-11-05:
Is there any chance anyone would know why I'm getting this error? 'pip install gym' worked but it only installed 3 environments, when I try to install 'pip install box2d' this error comes up:

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

Closed 2016-05-16.

Thread 71 (2016-05-08):

Env.step() with no action

keleftheriou, 2016-05-08:
Intuitively, an algorithm should at any point also have the choice of *not* acting at all.

At least in the example of control/physics environments, being able to not act might sometimes be the "best" choice. Defining "best" here can be a long discussion, but as an example an algorithm might be optimizing for *efficiency* (reward/effort), rather than absolute reward.

jonasschneider, 2016-05-08:
This seems like it's mostly a semantic issue with env action spaces. In some envs, "not acting" is meaningless -- take board games like Chess or Go (the latter we have as an env already) for example: if it's your turn, you can't meaningfully choose to "not act".

Also, _efficiency/effort_ are ill-defined concepts whose semantics depend on the env. In fact, what you propose is already implemented in some envs. For example, the mujoco envs penalize you (i.e. reduce reward) based on the joint torques that you specify, i.e. what could intuitively be described as the "effort".

So it seems like this is a per-env semantic issue. We're happy about proposals for definitions of efficiency for specific envs, though!

tlbtlbtlb, 2016-05-08:
In (I think) all the physics environments the actions are converted to torques, so a vector of 0s is a reasonable least-effort action. That might not be obvious from the `action_space`, which usually is a `Box` with `low=[-1, ...]` and `high=[+1, ...]`.

keleftheriou, 2016-05-09:
I've only been playing with the 'CartPole-v0' environment so far, and that has an `action_space` of `spaces.Discrete(2)` which led me to my comment.

I wonder if making `Env.step()` have `action=None` as a default could work, letting the environment  complain if it can't accept it. The API would be more general this way, and the potential for API misuse by either environment users or environment authors seems low.

 Alternatively, 'CartPole-v0' could just be changed to take a `Box` `action_space` instead of a `Discrete` one, although it feels like this particular environment might have been purposefully made to not take variable force values.

Good to know about the mujoco environments utilizing a notion of "effort" through the `reward` returned, thanks.

gdb, 2016-05-09:
The feedback makes sense; thanks for the input!

This isn't part of the standard formulation of RL, so I think for now we shouldn't add it (and I'm not sure if it'd make sense for every env). I'm going to close for now, but if we see more demand for something like this, we'll revisit!

ivanvoid, 2022-09-02:
So you wanna say this issue was never resolved?
Yea 4 years later, please add option to stay still in 'CartPole-v1',
or just help to figure out how to make it possible, this also will be really appreciated.

soroush-bn, 2023-05-26:
@gdb I came across the same problem when I want to add additional actions for "Taxi" environment, I want to add diagonal movements to the grid world, however, it is not possible to perform such action when agent is on the edge of the grid, thus, whether I need to create my custom env or use a "NOOP" action and pass it to env.step() function to see the observation and etc.

meghbhalerao, 2024-12-16:
https://github.com/openai/gym/issues/71#issuecomment-217780087 - why would this not be a part of the standard formualation of RL?
We can have an MDP with an action = None, which would essentially have the following transition probablity distribution -
T(s'|s,a = None) = 1 if s'= s, else = 0.
I think it would be useful to have this, say, if one simply wants to get the current env state. Or am I missing something here?

leafstar, 2025-01-24:
> [#71 (comment)](https://github.com/openai/gym/issues/71#issuecomment-217780087) - why would this not be a part of the standard formualation of RL? We can have an MDP with an action = None, which would essentially have the following transition probablity distribution - T(s'|s,a = None) = 1 if s'= s, else = 0. I think it would be useful to have this, say, if one simply wants to get the current env state. Or am I missing something here?

I don't think so. In cartpole environment, intuitively, if you do nothing when the pole is not vertical to the cart, finally it will fall. Therefore the state will also be changed even if you do nothing.

Closed 2016-05-09.

Thread 95 (2016-05-12):

occasional exception when resetting the environment

yakticus, 2016-05-12:
Symptom is an exception while resetting the environment during monitoring:

```
File "/Users/julie/github/gym/gym/core.py", line 102, in reset
    self.monitor._after_reset(observation)
  File "/Users/julie/github/gym/gym/monitoring/monitor.py", line 250, in _after_reset
    self.video_recorder.capture_frame()
  File "/Users/julie/github/gym/gym/monitoring/video_recorder.py", line 105, in capture_frame
    frame = self.env.render(mode=render_mode)
  File "/Users/julie/github/gym/gym/core.py", line 153, in render
    return self._render(mode=mode, close=close)
  File "/Users/julie/github/gym/gym/envs/classic_control/cartpole.py", line 132, in _render
    return self.viewer.get_array()
  File "/Users/julie/github/gym/gym/envs/classic_control/rendering.py", line 102, in get_array
    arr = arr.reshape(self.height, self.width, 4)
ValueError: total size of new array must be unchanged
```

Unfortunately I don't have exact steps to reproduce as it seems to happen sporadically when using the CartPole-V0 environment (I haven't tried others). Will give more details as they are uncovered.

If it helps, information about my python environment is attached.

[pythonenv.txt](https://github.com/openai/gym/files/262094/pythonenv.txt)

tlbtlbtlb, 2016-05-12:
Puzzling. Could you try replacing the arr.reshape with
```
    try:
        arr = arr.reshape(self.height, self.width, 4)
    except:
        print arr.shape, self.height, self.width
        raise
```
to see what shape it has?

Does your Mac have a Retina screen?

yakticus, 2016-05-12:
This is what I get for `arr.shape, self.height, self.width`:

`(84,) 400 600`

yakticus, 2016-05-12:
some additional context that's worth mentioning - I wrote a quick & dirty wrapper API for the gym so that I could use it from non-Python code. Could the error arise by having the `env` be a global thing that is re-used more than once?

https://gist.github.com/yakticus/de3639c23675a4f6e05b54e5faef56d4

yakticus, 2016-05-12:
> Does your Mac have a Retina screen?
yes

JKCooper2, 2016-05-13:
When you say env is being reused in that do you mean that monitor is being started and closed multiple times? When an env in created a monitor is created along with it which is given a unique monitor id (which is selected using a global variable and a lock). When monitor.close is run it removes the monitor from the monitors dictionary which can cause issues when you try and restart it

Try adding `env = gym.make(envname)` just before line 20 of your wrapper so that each time you call monitor(state=on) the monitor it's doing it with a fresh environment (and a usable monitor)

yakticus, 2016-05-13:
I wasn't aware of the coupling between environment and monitor. Creating a new environment for each monitor seems to have addressed the problem. On a related note, Is there already a place in the repo or website carved out to create more in-depth documentation about the APIs and architecture of the gym? If not, I could start something under docs/api.md so that others don't make the same mistake I did.

JKCooper2, 2016-05-14:
Not currently, although it has been discussed as to how best to document the code so people are aware of what's going on. I think they want to remain very flexible with anything that's done while the beta is running and not make any decisions before they have enough information.Maybe bring this up in chat and seeing if they're happy with an api.md file as a starting point.

gdb, 2016-05-14:
Very happy with an api.md file. And yes, not quite ready to double down on another documentation source yet, though I'm sure as we add more of these doc files we'll figure out what we need over time. Thanks!

Closed 2016-05-16.

Thread 106 (2016-05-18):

Write more documentation about environments

joschu, 2016-05-18:
We should write a more detailed explanation of every environment, in particular, how the reward function is computed.

JKCooper2, 2016-06-02:
Here's how I imagined a basic environment documentation page looking [link](https://docs.google.com/document/d/1bCDna95FRfvFA850qwqqLqZxENdU70psiqaOGob9oLI/edit?usp=sharing). Let me know if you have any suggestions then I'll transfer it to MarkDown and see how it looks in that

nealmcb, 2016-06-13:
@JKCooper2, thanks for the link.  That page seems pretty complete.

I'm not sure how you see the Challenge section working.  Can you add or point to some examples?

But I wonder where we want to document these things.  To avoid duplication, I'd think the code should contain the primary documentation, including what is documented in your sections 1 and 2: Overview and Environment.  I suggest that we should just document each aspect in the appropriate part of the code.  There could ideally be a standard build tool to pull out the appropriate documentation (via tags of some sort?) and update a main landing page on the site for each environment, presumably https://gym.openai.com/envs/CartPole-v0, which also documents how various algorithms have worked on it.

For the "Research" section, a link to some pages on the site that describe relevant research would also be fine in the code.  Or we might just want to just link from the landing page to an associated wiki page on the site, that could discuss research, proposed algorithms, etc.

JKCooper2, 2016-06-14:
For the Challenge section I was thinking that it would have a list of criteria that means you could tell whether your algorithm could theoretically solve the environment (ignoring hyper-parameters / computational limitations).

Examples would include:
 - 1A Discrete versus 1B continuous observation space
 - 2A Discrete versus 2B continuous action space
 - 3A One versus 3B n dimensions in the action space (e.g. Acrobot has three discrete action but they exist along one dimension of the force applied, versus Walker or something where you can control different joints independently)
 - If discrete action: 4A Two versus 4B more than two discrete actions
 - 5 Multiple rewards are available at a single point in time
 - 6 Stochastic action effect (Action can be switched by environment according to percentage)
 - 7 Goal changes over time
 - 8 Observation state incomplete (The observation provided doesn't always contain critical information, e.g. in basketball when the goal end swaps if this were only provided once per quarter)
 - 9 No reward surrounding initial state - any sequence of 20 actions by the agent from the starting state won't results in seeing a reward
 - 10 Task recognition (agent will be trained over multiple environments and need to be able to determine which environment it is currently in)
 - 11 Generalisation (agent will be run over one environment and then needs to apply knowledge to another environment with the same challenge set)

CartPole: 1B, 2A, 3A, 4A
Acrobot: 1B, 2A, 3A, 4B, 9
MountainCar: 1B, 2A, 3A, 4A, 9
Pendulum: 1B, 2B, 3A
Taxi: 1A, 2A, 3B, 4B, 7
Pacman: 1B, 2A, 3B, 4B, 5, 7
Pacmac-Ram: 1B, 2A, 3B, 4B, 5, 7, 8 (maybe)

The idea then being if I create an algorithm that can handle 1B, 2A, 3A, 3B, 4A, 4B, 9 then it should be capable of solving (with only hyper-parameter changes) CartPole and Acrobot, but won't be capable of solving any of the others

That's obviously an incomplete set and the definitions some may not make sense or need to be altered, but it would have a lot of benefits:
1. Easy to tell what your algorithm will/won't work on and why
2. Focus for creating environment's that have challenge sets that don't already exist
3. Good comparability on algorithms with matching 'abilities'
4. Focus for creating algorithms with specific abilities
5. Much simpler to take an rl agent and apply it to a real-world problems (just define the problem and select an algorithm that meets the challenge criteria)
6. Test task recognition and generalisation over similar environments (based on matching challenge sets)

JKCooper2, 2016-06-14:
For the environment documentation I was imagining it like a project/assignment description. I don't think people should need to look in the code for information about how the environment works, and would prefer it to be listed independently even if it means some duplication (although not a lot because it would only be updated if the environment version changes).

The Research section was partly to make it easier for researchers to identify was relevant papers exist for what they are working on, but also to encourage people to replicate existing research algorithms in order to improve the benchmark quality. I think replicated published research algorithms should be given special treatment or at least marked differently so people can easily see "This algorithm is a working copy of this paper". Having wiki style info regarding the papers could be useful, but I think it would work better to have links from the environment documentation research section to a summary page for the paper that has that information.

I was thinking it would sit on something like https://readthedocs.org/ where the documentation would be updated via git and you can have sub-menu's on the side to choose which section you're viewing.

Discussion and comments should be separate from documentation, maybe a forum. The goals as I see it should be to make it simple for people to understand the task (docs), share relevant information (research), come up with new ideas (forum/gitter), and focus effort (challenges/requests for research).

nealmcb, 2016-06-16:
Thanks.  I agree that the documentation should be clear about research that it was based on etc, and the forum/wiki would just be to make it easier for folks to comment and add information.

Re: "Challenge", that was the sense I had, and your details help a lot.

The code already defines a lot of this with great precision via the Env.{action_space,        observation_space,reward_range} variables.  I'm hoping it would be easier to just capture that information via introspection, hopefully as part of the build process, and automatically generate a concise and easy to use representation of it for inclusion in the documentation.  Otherwise, we run the risk of the documentation lagging behind the code or disagreeing with it.

I haven't yet looked at enough environments here to be sure what you mean by 7, 8, 9, but more generally, a useful categorization scheme for AI environments, based on Russell and Norvig (2009), is at https://en.wikibooks.org/wiki/Artificial_Intelligence/AI_Agents_and_their_Environments:

> "[they] can be remembered with the mnemonic "D-SOAKED." They are:

> - Deterministicness (deterministic or stochastic or Non-deterministic): An environment is deterministic if the next state is perfectly predictable given knowledge of the previous state and the agent's action.
 - Staticness (static or dynamic): Static environments do not change while the agent deliberates.
- Observability (full or partial): A fully observable environment is one in which the agent has access to all information in the environment relevant to its task.
- Agency (single or multiple): If there is at least one other agent in the environment, it is a multi-agent environment. Other agents might be apathetic, cooperative, or competitive.
- Knowledge (known or unknown): An environment is considered to be "known" if the agent understands the laws that govern the environment's behavior. For example, in chess, the agent would know that when a piece is "taken" it is removed from the game. On a street, the agent might know that when it rains, the streets get slippery.
- Episodicness (episodic or sequential): Sequential environments require memory of past actions to determine the next best action. Episodic environments are a series of one-shot actions, and only the current (or recent) percept is relevant. An AI that looks at radiology images to determine if there is a sickness is an example of an episodic environment. One image has nothing to do with the next.
- Discreteness (discrete or continuous or ): A discrete environment has fixed locations or time intervals. A continuous environment could be measured quantitatively to any level of precision."

As far as I've seen, the gym might not yet support some of these options.  But adding a way to encode and document and perhaps declare (in the code) the rest of those would indeed be helpful.  I imagine this has come up before - does anyone know if we can leverage other existing work on a typology of environments?

nealmcb, 2016-06-17:
To play around with extracting useful documentation automatically from the code, I wrote a little program to query a bunch of things about the environments for display in a markdown table.  Here is the code and the output, on the subset for which make() works for me at the moment.  A few variables which don't vary in this dataset are commented out.

```
from gym import envs

class NullE:
    def __init__(self):
        self.observation_space = self.action_space = self.reward_range = "N/A"

envall = envs.registry.all()

table = "|Environment Id|Observation Space|Action Space|Reward Range|tStepL|Trials|rThresh\n" # |Local|nonDet|kwargs|
table += "|---|---|---|---|---|---|---|---|---|---|\n"

for e in envall:
    try:
        env = e.make()
    except:
        env = NullE()
        continue  #  Skip these for now
    table += '| {}|{}|{}|{}|{}|{}|{}|\n'.format(e.id,   #|{}|{}|{}
       env.observation_space, env.action_space, env.reward_range,
       e.timestep_limit, e.trials, e.reward_threshold) # ,
       # getattr(e, 'local_only', -1), e.nondeterministic, getattr(e, 'kwargs', ""))

print(table)
```

|Environment Id|Observation Space|Action Space|Reward Range|tStepL|Trials|rThresh
|---|---|---|---|---|---|---|---|---|---|
| CartPole-v0|Box(4,)|Discrete(2)|(-inf, inf)|200|100|195.0|
| NChain-v0|Discrete(5)|Discrete(2)|(-inf, inf)|1000|100|None|
| RepeatCopy-v0|Discrete(6)|Tuple(Discrete(2), Discrete(2), Discrete(5))|(-inf, inf)|200|100|75.0|
| Reverse-v0|Discrete(3)|Tuple(Discrete(2), Discrete(2), Discrete(2))|(-inf, inf)|200|100|25.0|
| ReversedAddition-v0|Discrete(4)|Tuple(Discrete(4), Discrete(2), Discrete(3))|(-inf, inf)|200|100|25.0|
| Acrobot-v0|Box(4,)|Discrete(3)|(-inf, inf)|200|100|-100|
| FrozenLake-v0|Discrete(16)|Discrete(4)|(-inf, inf)|100|100|0.78|
| Taxi-v1|Discrete(500)|Discrete(6)|(-inf, inf)|200|100|9.7|
| Pendulum-v0|Box(3,)|Box(1,)|(-inf, inf)|200|100|None|
| OneRoundNondeterministicReward-v0|Discrete(1)|Discrete(2)|(-inf, inf)|1000|100|None|
| ReversedAddition3-v0|Discrete(4)|Tuple(Discrete(4), Discrete(2), Discrete(3))|(-inf, inf)|200|100|25.0|
| Roulette-v0|Discrete(1)|Discrete(38)|(-inf, inf)|100|100|None|
| MountainCar-v0|Box(2,)|Discrete(3)|(-inf, inf)|200|100|-110.0|
| FrozenLake8x8-v0|Discrete(64)|Discrete(4)|(-inf, inf)|200|100|0.99|
| DuplicatedInput-v0|Discrete(6)|Tuple(Discrete(2), Discrete(2), Discrete(5))|(-inf, inf)|200|100|9.0|
| Blackjack-v0|Tuple(Discrete(32), Discrete(11), Discrete(2))|Discrete(2)|(-inf, inf)|1000|100|None|
| Copy-v0|Discrete(6)|Tuple(Discrete(2), Discrete(2), Discrete(5))|(-inf, inf)|200|100|25.0|
| TwoRoundDeterministicReward-v0|Discrete(3)|Discrete(2)|(-inf, inf)|1000|100|None|
| TwoRoundNondeterministicReward-v0|Discrete(3)|Discrete(2)|(-inf, inf)|1000|100|None|
| OneRoundDeterministicReward-v0|Discrete(1)|Discrete(2)|(-inf, inf)|1000|100|None|

tlbtlbtlb, 2016-06-17:
That table is extremely useful.

JKCooper2, 2016-06-17:
I like the table. It should be possible to export the bounds of the box spaces as well with some minor adjustments. The environments will only change very rarely so I wouldn't get too hung up on having it being exported. The D-SOAKED listing is good but I don't think it covers enough of the agents required abilities, e.g. All of the environments in the classic control section fall under the same D-SOAKED criteria yet you can't take all of the algorithms that solved one and have them solve the rest.

For '7 Goal changes over time' an example could be [Reacher](https://gym.openai.com/envs/Reacher-v1) that has a randomly located target as opposed to [Acrobot](https://gym.openai.com/envs/Acrobot-v0) where the target is always the same. This can also mean that a straight decaying exploration rate mightn't be effective
For '8 Observation state incomplete' I mean that the agent could be given information that it needs to use in future states. E.g. Reacher where the agent is told the position and then has 50 time steps (without being retold the position, it just gets information about it's own location) to reach towards the goal, being scored on the 50th step
'9 Fixed reward surrounding initial state' is to cover exploration scenarios like MountainCar, Acrobot, FrozenLake where the agent needs to perform a long chain of actions in order to see a different reward.

nealmcb, 2016-06-17:
Yes - adding the bounds is on my list.  I actually think that the repr function of a space should conform to the norm and return a full, evalable string with the bounds.  Perhaps the str function could return what repr does now, for simplicity and better upward-compatibility.  And for convenience, the constructor should work with a list of low or high bounds, not just an array of them.

In the meantime, here is a version of the table sorted by parameterization, with hot links, for your viewing pleasure.  One of the values of generating the documentation from the source, or at least from a nice clean machine-readable format, is the ease of sorting, comparing, searching etc.

Note that it seems that some of the environments don't have a page on the gym site yet, and generate "Something went wrong! We've been notified and are fixing it.".  E.g. https://gym.openai.com/envs/OneRoundNondeterministicReward-v0

|Environment Id|Observation Space|Action Space|Reward Range|tStepL|Trials|rThresh
|---|---|---|---|---|---|---|---|---|---|
| [MountainCar-v0](https://gym.openai.com/envs/MountainCar-v0)|Box(2,)|Discrete(3)|(-inf, inf)|200|100|-110.0|
| [SemiSupervisedPendulumRandom-v0](https://gym.openai.com/envs/SemiSupervisedPendulumRandom-v0)|Box(3,)|Box(1,)|(-inf, inf)|1000|100|None|
| [SemiSupervisedPendulumDecay-v0](https://gym.openai.com/envs/SemiSupervisedPendulumDecay-v0)|Box(3,)|Box(1,)|(-inf, inf)|1000|100|None|
| [SemiSupervisedPendulumNoise-v0](https://gym.openai.com/envs/SemiSupervisedPendulumNoise-v0)|Box(3,)|Box(1,)|(-inf, inf)|1000|100|None|
| [Pendulum-v0](https://gym.openai.com/envs/Pendulum-v0)|Box(3,)|Box(1,)|(-inf, inf)|200|100|None|
| [CartPole-v0](https://gym.openai.com/envs/CartPole-v0)|Box(4,)|Discrete(2)|(-inf, inf)|200|100|195.0|
| [Acrobot-v0](https://gym.openai.com/envs/Acrobot-v0)|Box(4,)|Discrete(3)|(-inf, inf)|200|100|-100|
| [InterpretabilityCartpoleObservations-v0](https://gym.openai.com/envs/InterpretabilityCartpoleObservations-v0)|Box(4,)|Tuple(Discrete(2), Box(4,), Box(4,), Box(4,), Box(4,), Box(4,))|(-inf, inf)|1000|100|None|
| [InterpretabilityCartpoleActions-v0](https://gym.openai.com/envs/InterpretabilityCartpoleActions-v0)|Box(4,)|Tuple(Discrete(2), Discrete(2), Discrete(2), Discrete(2), Discrete(2), Discrete(2))|(-inf, inf)|1000|100|None|
| [OneRoundNondeterministicReward-v0](https://gym.openai.com/envs/OneRoundNondeterministicReward-v0)|Discrete(1)|Discrete(2)|(-inf, inf)|1000|100|None|
| [OneRoundDeterministicReward-v0](https://gym.openai.com/envs/OneRoundDeterministicReward-v0)|Discrete(1)|Discrete(2)|(-inf, inf)|1000|100|None|
| [Roulette-v0](https://gym.openai.com/envs/Roulette-v0)|Discrete(1)|Discrete(38)|(-inf, inf)|100|100|None|
| [FrozenLake-v0](https://gym.openai.com/envs/FrozenLake-v0)|Discrete(16)|Discrete(4)|(-inf, inf)|100|100|0.78|
| [TwoRoundDeterministicReward-v0](https://gym.openai.com/envs/TwoRoundDeterministicReward-v0)|Discrete(3)|Discrete(2)|(-inf, inf)|1000|100|None|
| [TwoRoundNondeterministicReward-v0](https://gym.openai.com/envs/TwoRoundNondeterministicReward-v0)|Discrete(3)|Discrete(2)|(-inf, inf)|1000|100|None|
| [Reverse-v0](https://gym.openai.com/envs/Reverse-v0)|Discrete(3)|Tuple(Discrete(2), Discrete(2), Discrete(2))|(-inf, inf)|200|100|25.0|
| [ReversedAddition-v0](https://gym.openai.com/envs/ReversedAddition-v0)|Discrete(4)|Tuple(Discrete(4), Discrete(2), Discrete(3))|(-inf, inf)|200|100|25.0|
| [ReversedAddition3-v0](https://gym.openai.com/envs/ReversedAddition3-v0)|Discrete(4)|Tuple(Discrete(4), Discrete(2), Discrete(3))|(-inf, inf)|200|100|25.0|
| [NChain-v0](https://gym.openai.com/envs/NChain-v0)|Discrete(5)|Discrete(2)|(-inf, inf)|1000|100|None|
| [Taxi-v1](https://gym.openai.com/envs/Taxi-v1)|Discrete(500)|Discrete(6)|(-inf, inf)|200|100|9.7|
| [Copy-v0](https://gym.openai.com/envs/Copy-v0)|Discrete(6)|Tuple(Discrete(2), Discrete(2), Discrete(5))|(-inf, inf)|200|100|25.0|
| [RepeatCopy-v0](https://gym.openai.com/envs/RepeatCopy-v0)|Discrete(6)|Tuple(Discrete(2), Discrete(2), Discrete(5))|(-inf, inf)|200|100|75.0|
| [DuplicatedInput-v0](https://gym.openai.com/envs/DuplicatedInput-v0)|Discrete(6)|Tuple(Discrete(2), Discrete(2), Discrete(5))|(-inf, inf)|200|100|9.0|
| [FrozenLake8x8-v0](https://gym.openai.com/envs/FrozenLake8x8-v0)|Discrete(64)|Discrete(4)|(-inf, inf)|200|100|0.99|
| [OffSwitchCartpole-v0](https://gym.openai.com/envs/OffSwitchCartpole-v0)|Tuple(Discrete(2), Box(4,))|Discrete(2)|(-inf, inf)|1000|100|None|
| [Blackjack-v0](https://gym.openai.com/envs/Blackjack-v0)|Tuple(Discrete(32), Discrete(11), Discrete(2))|Discrete(2)|(-inf, inf)|1000|100|None|

Timopheym, 2016-06-22:
@gdb why not to open a wiki here so we can move this awesome table there and have a community-driven documentation?

nealmcb, 2016-06-23:
I like that idea, @Timopheym.  I don't know if we want to use the wiki feature here, but I went ahead to put up an example of using it for this.  I also expanded the table to 158 environments: all the ones I could "make" with a standard pip install gym[all]:
  https://github.com/openai/gym/wiki/Table-of-environments

gdb, 2016-06-23:
(Enabled the wiki! Please make edits!)

On Wednesday, June 22, 2016, Neal McBurnett <notifications@github.com>
wrote:

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

--
Sent from mobile

kovacspeter, 2016-06-23:
It would be great if there were also bounds for Box actions eg. [-1,1]. And also MuJoCo environments are currently missing.

nkming2, 2017-04-30:
The table is currently not shown correctly on the wiki page. This patch should fix that. Cheers
https://gist.github.com/nkming2/f04d7a350d1e497014b23258ea9f4304

abhigenie92, 2017-07-09:
Is there a way for defining an environment, where I can change the action space at each step?

aurelien-clu, 2017-10-27:
@abhigenie92
How is the action space changing at each step?

If it changes across several expected configuration you could have the following:
- a model with all the possible action as outputs
- a custom final layer choosing the action among the available ones (your changing action space)
- possibly the information about the expected action space as input (ex: Situation A, B or C) to help your model or a negative reward if the model does not recognize the situation (by having activated 'bad' outputs)

Otherwise I think you need to define your own Space class by extending gym.Space:
https://github.com/openai/gym/blob/master/gym/core.py

madvn, 2017-11-02:
Does something like this exist for MuJoCo environments? I am especially interested in finding the values of simulation specific params in MuJoCo such as 'dt' and also termination conditions.

rkaplan, 2018-03-16:
Also wondering if there are more details about the MuJoCo environments. It would be nice to have more information about them on the website. Specifically I'm trying to check which MuJoCo environments are deterministic / stochastic.

ling-pan, 2018-07-15:
I am wondering what each byte in the RAM means. Could anyone explain each field in the RAM, please?

nikonikolov, 2018-07-25:
Hey, I fully agree there should be more documentation about environments. In my personal experience the most commonly needed information is:

1. Observation: space type, shape, limits, components interpretation (if any - e.g. position, speed, etc.)
2. Action space type, shape and limits, components interpretation
3. Deterministic or stochastic. If stochastic, in what way exactly

It is not that this information cannot be found, but it usually takes much more time than it can take if it was properly summarized. For example, currently there is no documentation about stochasticity in MuJoCo environments and only a couple have information about the interpretation of components in the observation/action space. For Atari environments, there is no clear documentation about all the different versions and one has to dig through the code.

I have already collected some info which is currently not in the wiki (mainly about the atari environments, but it is very likely that I will also have to do the same for the MuJoCo ones). I really want to share this info on the wiki. Is there a required/recommended way to do this, or I can just follow the current examples such as https://github.com/openai/gym/wiki/BipedalWalker-v2.

bionicles, 2018-12-31:
`import gym

class String(gym.Space):
    def __init__(self, length=None, min_length=1, max_length=280, min=0, max=127):
        self.length = length
        self.min_length = min_length
        self.max_length = max_length
        self.min = min
        self.max = max

    def sample():
        length = random.randint(self.min, self.max)
        string = ""
        for i in range(length):
            ord = random.randint(min, max)
            character = str(chr(ord))
            string += character
        return string

    def contains(self, x):
        return type(x) is "str" and len(x) > 0`

bionicles, 2018-12-31:
Can a Box shape have None for a dimension?

For example, in our Schrodinger Pymol Env for Bitpharma, we use Atoms and Residues tensors of shape:

residues: (None, 7)
atoms: (None, 17)

For that specific application it might be nice if the core Shape class had an update_dimension method shapes during Reset:
fetch molecule
num_atoms = cmd.count_atoms("all")
self.update_variable("num_atoms", num_atoms)
--> this would recalculate shapes

Also in stock trading the order book is variable size, in music songs are arbitrary lengths. Does Box support this or should we make a new subclass of shape?

Graph shape would be extremely useful because everything is a fractal network...adjacency list variant would rock.

One challenge is -- how do you deal with the fact it's impossible to enumerate all possible shapes?

bionicles, 2018-12-31:
also, it would be epic for meta learning to define a ComputationGraphSpace, then we could make RL agents attend to their own processes ... introspection is probably handy. Do you think AI should be unable to accept its own schematic as input?

adalvigi, 2019-02-24:
@nikonikolov could you please share your info on the Atari environments? I'm finding it very hard to figure them out

nikonikolov, 2019-03-05:
Below is the info I have from my logs. This is from a few months ago, I have not checked if there have been any changes since then.

`AtariEnvNoFrameskip-v4`
  - max_ep_steps = 400000 (300000 for SpaceInvaders)
  - observe every single frame
  - deterministic actions

`AtariEnvNoFrameskip-v0`
  - max_ep_steps = 400000 (300000 for SpaceInvaders)
  - observe every single frame
  - stochastic actions - repeat previous action with probability 0.25

`AtariEnvDeterministic-v4`
  - max_ep_steps = 100000
  - repeat action 4 times and observe only the last frame (3 times for SpaceInvaders)
  - deterministic actions

`AtariEnvDeterministic-v0`
  - max_ep_steps = 100000
  - repeat action 4 times and observe only the last frame (3 times for SpaceInvaders)
  - stochastic actions - repeat previous action with probability 0.25

`AtariEnv-v4`
  - max_ep_steps = 100000
  - repeat action a random number from [2,3,4] and observe only the last frame (random frameskip)
  - deterministic actions

`AtariEnv-v0`
  - max_ep_steps = 100000
  - repeat action a random number from [2,3,4] and observe only the last frame (random frameskip)
  - stochastic actions - repeat previous action with probability 0.25

Additional points to bear in mind:
- The initial state is deterministic
- Most of the Atari papers (including DQN and derivatives by DeepMind) set the max number of steps that the simulator executes to 108000.

Please someone correct me if I got anything wrong.

nealmcb, 2019-04-18:
I dare say this should be part of the Gym codebase, and integrated into updates to the algorithms. But for now here is the latest version of the code, with more sensible natural sorting integrated into it, and used just now to update the [table in the wiki](https://github.com/openai/gym/wiki/Table-of-environments) with the wealth of new environments in Gym.

```
import re
from operator import attrgetter
from gym import envs

class NullE:
    def __init__(self):
        self.observation_space = self.action_space = self.reward_range = "N/A"

def natural_keys(text):
    '''
    alist.sort(key=natural_keys) sorts in human order
    http://nedbatchelder.com/blog/200712/human_sorting.html
    (See Toothy's implementation in the comments)

    >>> alist = [
    ...          'Orange County--1-3-288-117',
    ...          'Orange County--48256-242',
    ...          'Orange County--1-3-388-203',
    ...          'Orange County--1-19-19-150',
    ...          'Orange County--1-1-64-290',
    ...          'Orange County--1-1-55-256']
    >>> alist.sort(key=natural_keys)
    >>> from pprint import pprint
    >>> pprint(alist)
    [u'Orange County--1-1-55-256',
     u'Orange County--1-1-64-290',
     u'Orange County--1-3-288-117',
     u'Orange County--1-3-388-203',
     u'Orange County--1-19-19-150',
     u'Orange County--48256-242']
    '''

    return [ atoi(c) for c in re.split('(\d+)', text.split('|')[2]) ]

def atoi(text):
    "Convert text to integer, or return it unmodified if it isn't numeric"

    return int(text) if text.isdigit() else text

# TODO: Make first column a link, e.g. to [WizardOfWor-ram-v0](https://gym.openai.com/envs/WizardOfWor-ram-v0)
envall = envs.registry.all()

URL_PREFIX = 'https://gym.openai.com/envs'

table = []
for e in envall:
    try:
        env = e.make()
    except:
        env = NullE()
        continue  #  Skip these for now
    table.append('| {}|{}|{}|{}|{}|{}|{}|'.format(
       '[%s](%s/%s)' % (e.id, URL_PREFIX, e.id),
       env.observation_space, env.action_space, env.reward_range,
       e.timestep_limit, e.trials, e.reward_threshold)) # ,
       # getattr(e, 'local_only', -1), e.nondeterministic, getattr(e, 'kwargs', ""))

    # if len(table) > 30:  # For quicker testing
    #   break

# Sort by 2nd column: Observation Space name
table = sorted(table, key=natural_keys)

# Add headings
table = ["|Environment Id|Observation Space|Action Space|Reward Range|tStepL|Trials|rThresh", # |Local|nonDet|kwargs|
         "|---|---|---|---|---|---|---|"] + table

print('\n'.join(table))
```

tycho01, 2019-10-07:
env tables inspired by @nealmcb but using Pandas in a notebook:

```python
from collections import OrderedDict
from operator import mul
from functools import reduce
import numpy as np
import pandas as pd
from gym import envs

def space_size(spc):
  '''number of bytes in a space'''
  return 1 if not spc.shape else spc.dtype.itemsize * (spc.shape if spc.shape is int else reduce(mul, spc.shape, 1))

def space_cont(spc):
  '''whether a space is continuous'''
  return np.issubdtype(spc.dtype, np.floating)

def env_props(env):
  obs = env.observation_space
  act = env.action_space
  return OrderedDict([
    ('name', env.spec.id),
    ('obs_cont', space_cont(obs)),
    ('obs_size', space_size(obs)),
    ('stochastic', env.spec.nondeterministic),  # - deterministic vs stochastic (~= ^?)
    ('act_cont', space_cont(act)),
    ('act_size', space_size(act)),
#     ('reward_range', env.reward_range),
#     ('timestep_limit', env.timestep_limit),
#     ('trials', env.trials),
#     ('reward_threshold', env.reward_threshold),
  ])

def make_env(env_):
    try:
        env = env_.make()
    except:
        env = None
    return env

envall = envs.registry.all()
envs = [make_env(env) for env in envall]
envs = [x for x in envs if x is not None]

rows = [env_props(env) for env in envs]

# our env dataframe, show in a notebook cell
df = pd.DataFrame(rows)
df

# and a pivot!
mean = lambda x: round(np.mean(x), 2)
idx = ['obs_cont', 'act_cont', 'stochastic']
aggs = {
    'name': len,
    'obs_size': mean,
    'act_size': mean,
}
pd.pivot_table(df, index=idx, aggfunc=aggs)
```

Amritpal-001, 2020-07-07:
@joschu @JKCooper2 @nealmcb I compiled documentation on **Fetch environments**
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

Thread 143 (2016-05-30):

Box2d episode 5: Segfault strikes back

justheuristic, 2016-05-30:
A few ticks ago there was an [issue](https://github.com/openai/gym/issues/114) about 2 `BipedalWalker-v1` in parallel causing SegFault whence the first was reset() after the second got initialized.

Than there was a fix that finally allowed us to reset several Box2D `BipedalWalker-v2` 's, but unfortunately we still can't play them.

The new bone of contention looks thusly:
```
import gym
def segfault(env_name = "BipedalWalker-v2"):
    ll0 = gym.make(env_name)
    ll0.reset()
    ll1 = gym.make(env_name)
    ll1.reset()
    ll0.reset()
    ll1.reset()
    ll1.step(ll1.action_space.sample())
    ll0.step(ll1.action_space.sample())
    print "and nothing happened"
```

As usual, it works okay with LunarLander, but fails with BipedalWalker
```
>>> segfault("LunarLander-v2")
[2016-05-30 14:42:40,877] Making new env: LunarLander-v2
libGL error: failed to open drm device: No such file or directory
libGL error: failed to load driver: i965
[2016-05-30 14:42:43,056] Making new env: LunarLander-v2
and nothing happened
```

```
>>> segfault("BipedalWalker-v2")
[2016-05-30 14:43:07,731] Making new env: BipedalWalker-v2
[2016-05-30 14:43:07,769] Making new env: BipedalWalker-v2
Segmentation fault
```

A single bipedal walker works nice and stable in the same setup.

jietang, 2016-05-31:
@olegklimov, any ideas?

olegklimov, 2016-06-02:
I'll look within a few days.

justheuristic, 2016-06-06:
olegklimov@ any ideas so far?

olegklimov, 2016-06-06:
Right now I'm doing the other thing :(  The good news is you can start several environments using that other thing, each one in its own process. Maybe this will help you, to be out soon. But I'll return to this bug anyway, it should be fixed, obviously, crashes are not good.

olegklimov, 2016-06-13:
Okey, don't ask me why this fixes anything, because I don't know :)  But now I can run your code, in a loop.

jietang, 2016-06-14:
I don't really understand what the mechanism behind this fix is. It seems like there are some underlying issues behind how _reset() and contactListeners interact. For example it cropped up as https://github.com/openai/gym/issues/114, and it's now manifesting itself in this different way.

If we're able to repro the segfault, can we dig in and try to understand where it's coming from? Perhaps we're not supposed to directly modify the contactlistener attribute but to use the public interface on b2World instead (http://nullege.com/codes/show/src@b@l@bloodyhell-HEAD@bloodyhell@world@__init__.py/37/Box2D.b2World)?

olegklimov, 2016-06-14:
Well, the fix makes life cycle of contactListener longer. The docs [here](https://github.com/pybox2d/pybox2d/wiki/manual) says "be sure your listener remains in scope while the world object exists". It doesn't work directly this way, because we don't destroy world every reset(), but somehow still works.

And the same things don't happen in LunarLander because initially there are no contacts, so nothing happens at all.

olegklimov, 2016-06-14:
And mechanism for crash is around this lines: some events enqueue towards contactListener, it gets unreferenced by world and disappears, events cause callbacks in contactListener. Sometimes it gets fancier than this, unreferenced object immediately gets replaced by other unrelated object at same memory location, callback becomes strange unrelated method call.

olegklimov, 2016-06-14:
...and they store reference to contactListener in python object in your example, see `self._contact_listener = ContactListener()`

olegklimov, 2016-06-14:
I just found CarRacing also has this bug (fixed), reproducible exactly like in OP.

gdb, 2016-06-15:
Is this now closable?

olegklimov, 2016-06-16:
Sure. I've observed crash go away. @justheuristic please post more bugs, please reopen this one if it breaks again.

justheuristic, 2016-06-16:
Sorry for slow reaction. The bugs are gone indeed.
Thank you again for fixing the issue!

Closed 2016-06-16.

Thread 164 (2016-06-08):

Build error by running "pip install -e .[all]" on OSX 10.11.5

sumethy, 2016-06-08:
Running pip install -e .[all] produces something like:

Failed building wheel for pachi-py
  Running setup.py clean for pachi-py
Failed to build pachi-py

make is version 3.5.2
pip is version 8.1.2

The attached file is the full output
[gym install error.txt](https://github.com/openai/gym/files/304371/gym.install.error.txt)

tlbtlbtlb, 2016-06-08:
It seems like it's trying to build binaries for OSX 10.5, which is incompatible with some recent libraries. Are you on a recent version of OSX? Do you have some global XCode setting requesting an older binary compatibility?

sumethy, 2016-06-09:
I am on the latest OSX version: 10.11.5. I don't even have Xcode installed, just the command line tools, version 7.3.

jietang, 2016-06-09:
Can you run `env | grep OSX_` and `env | grep PATH` and report the results?

sumethy, 2016-06-09:
`env | grep OSX_` produces nothing
`env | grep PATH` produces
```
PATH=/Users/sumethy/miniconda2/bin:/Users/sumethy/torch/install/bin:/Library/Frameworks/Python.framework/Versions/2.7/bin:/usr/local/bin:/usr/bin:/bin:/usr/sbin:/sbin:/opt/X11/bin:/Library/TeX/texbin
CLASSPATH=:/Users/sumethy/algs4/algs4.jar
```

qubey, 2016-06-12:
I suspect the warnings aren't the real issue - it seems like this is the final error that causes the overall failure:
```
    ld: targeted OS version does not support use of thread local variables in _fast_srandom for architecture x86_64
    clang: error: linker command failed with exit code 1 (use -v to see invocation)
```

I'm getting the same issue here.  It seems like this might have something to do with it? http://stackoverflow.com/questions/28094794/why-does-apple-clang-disallow-c11-thread-local-when-official-clang-supports (not too sure though)

act65, 2016-06-12:
same issue here

tlbtlbtlb, 2016-06-13:
For some reason, your system is trying to build for OSX 10.5 compatibility which doesn't have some features (like thread-local variables) required by pachi. OSX 10.5 is quite old (10.6 came out in 2009).

Perhaps you have a very old Python installation. Try `brew upgrade python`.

Or maybe your XCode is out of date, it probably requires XCode 7.

If that doesn't work, could you provide the output of `python -v` and `gcc -v`?

mthrok, 2016-06-13:
I had the same issue (`clang` try to build 10.5) when installing pachi-py from `openai/pachi-py` repo.

In my case, the following command solved it.

`MACOSX_DEPLOYMENT_TARGET=10.11 python setup.py install`

After installing pachi-py, gym installation succeeded.

sumethy, 2016-06-14:
I think the problem is with Anaconda Python. I simply removed Anaconda, built a new Python environment with homebrew. Then running `pip install -e '.[all]'` just worked without any problem.

du-phan, 2016-06-15:
Hi I have the same problem as you. I see that you have solved it by removing Anaconda, but I want to keep it, do you have any other suggestions ? Thank you!

sumethy, 2016-06-16:
@du-phan I am not sure about this, but try making a symbolic link to Anaconda's python into /usr/local/bin just like the way Homebrew does with its python.

lebo1990, 2016-07-18:
@du-phan Did you solve this problem still under Anaconda environment?

adam-erickson, 2016-11-27:
The solution of @mthrok solves this for Anaconda.

sumethy, 2016-11-30:
Just an update. Now I am on MacOS 10.12 with miniconda3 python, inside a conda virtual environment (python 3.5.2) and
```
export MACOSX_DEPLOYMENT_TARGET=10.12
pip install -e '.[all]'
```
works.

Greenwicher, 2016-12-06:
@mthrok  Thanks a lot, it solved similar issue when I tried to build the openai/universe

JulianNorton, 2016-12-19:
Still having this issue, I uninstalled anaconda and changed Deployment Target. No luck.

weiliu620, 2017-07-14:
@sumethy @mthrok thanks very much. I'm on OS X 10.12 and Anaconda python 3.5. You trick of exporting environment variable works.

chtano, 2017-12-22:
Hi
The command MACOSX_DEPLOYMENT_TARGET=10.11 pip install -e '.[all]'
works for me which also can be seen in #811.
Now I have problem with ppaquette-gym...

Vanban-Wu, 2018-01-03:
Hi,

I used the command MACOSX_DEPLOYMENT_TARGET=10.12 then pip install -e '.[all]'
It works for me. But I run into the same problem as 'chtano' user on the ppaquette-gym... Any suggestion to his problem. By the way, I am a MacOS user running on Sierra version. Thanks much.

Vanban-Wu, 2018-01-09:
The solution to ppaquette-gym-doom is by downgrading boost to 1.64 version for MacOS users until they fix the compatibility in newer version:

1. Downgrade the boost version to 1.64 by executing  "brew edit boost"  to edit boost's formula and replace it with the content of this file https://raw.githubusercontent.com/Homebrew/homebrew-core/3df9cdfc25f796ec8d3ffd0a0a12476cf6d413d5/Formula/boost.rb

then  "brew edit boost-python" to edit boost-python's formula and replace it using the content of this file https://raw.githubusercontent.com/Homebrew/homebrew-core/d22f78c56a1c7d8e711a407c2dae5fc42f4ae6c2/Formula/boost-python.rb

 2. brew unlink boost

3. brew unlink boost-python

4. brew install boost boost-python

5. pip install ppaquette-gym-doom

Closed 2016-06-14.

Thread 165 (2016-06-09):

Parallel versions of classic control environment doesn't work !

darshanhegde, 2016-06-09:
I have implemented synchronous parallel DQN, and wanted to test it on classic control environments. I want to test it on rgb_array observation space that are images instead of Box(n,) (joint angles etc. ), but my algorithm requires that I implement a parallel version of the classic environments (k such environments) which takes list of k actions and returns k (observation, reward, done, info) tuples and I'm using env.render() method to get the rgb_array observation that I need.  My implementation looks something like this -

```
import gym
from multiprocessing import Process, Pipe

class EnvWorker(Process):

    def __init__(self, env_name, pipe, name=None):
        Process.__init__(self, name=name)
        self.env = gym.make(env_name)
        self.pipe = pipe
        self.name = name
        print "Environment initialized. ", self.name

    def run(self):
        while True:
            action = self.pipe.recv()
            _, reward, done, _ = self.env.step(action)
            observation = self.env.render(mode="rgb_array")
            self.pipe.send((observation, reward, done))
            if done:
                print "Done with an epsidode for %s" % self.name
                self.env.reset()
    
class ParallelEnvironment(object):

    def __init__(self, env_name, num_env):
        assert num_env > 0, "Number of environments must be postive."
        self.num_env = num_env
        self.workers = []
        self.pipes = []
        self.sample_env = gym.make(env_name)
        for env_idx in range(num_env):
            p_start, p_end = Pipe()
            env_worker = EnvWorker(env_name, p_end, name=str(env_idx))
            env_worker.start()
            self.workers.append(env_worker)
            self.pipes.append(p_start)

    def step(self, actions):
        observations, rewards, dones = [], [], []
        for idx in range(self.num_env):
            self.pipes[idx].send(actions[idx])
        for idx in range(self.num_env):
            observation, reward, done = self.pipes[idx].recv()
            observations.append(observation)
            rewards.append(reward)
            dones.append(done)
        return observations, rewards, dones

    def get_action_space(self):
        return self.sample_env.action_space

    def __del__(self):
        """
        Terminate all spawned processes.
        """
        for worker in self.workers:
            worker.terminate()
            worker.join()

# Works fine if I use Atari environment
num_envs = 4
p_env = ParallelEnvironment("Breakout-v0", num_envs)
action_space = p_env.get_action_space()
for i in range(100):
    actions = [action_space.sample() for _ in range(num_envs)]
    obs, rwds, dones = p_env.step(actions)
    print obs[0].shape

# Just hangs and throws following error if I use classic control environment
num_envs = 4
p_env = ParallelEnvironment("MountainCar-v0", num_envs)
action_space = p_env.get_action_space()
for i in range(100):
    actions = [action_space.sample() for _ in range(num_envs)]
    obs, rwds, dones = p_env.step(actions)
    print obs[0].shape
```

Here is the error it throws -
```
XIO:  fatal IO error 11 (Resource temporarily unavailable) on X server ":0"
      after 141 requests (141 known processed) with 0 events remaining.
XIO:  fatal IO error 11 (Resource temporarily unavailable) on X server ":0"
      after 141 requests (141 known processed) with 0 events remaining.
XIO:  fatal IO error 11 (Resource temporarily unavailable) on X server ":0"
      after 141 requests (141 known processed) with 0 events remaining.
XIO:  fatal IO error 11 (Resource temporarily unavailable) on X server ":0"
      after 142 requests (142 known processed) with 2 events remaining.
```

Can someone suggest a better way of doing this ?

mthrok, 2016-06-09:
I run your code on my MacBookPro and it worked.

my env is gym version 0.1.3 installed with anaconda pip + git

darshanhegde, 2016-06-10:
Thanks. That is really strange ! I was running this inside a docker container, if I run on my local machine with 0.1.3 gym version, it actually works !

empyreanx, 2018-02-06:
Did you every resolve this when using the docker container?

Closed 2016-06-10.

Thread 204 (2016-06-17):

pip install gym failed, can not install pachi-py

du-phan, 2016-06-17:
Hi all, when installing gym, I encountered this problem:  `Failed building wheel for pachi-py`, the final error message is:
`Command "/Users/admin/anaconda/bin/python -u -c "import setuptools, tokenize;__file__='/private/var/folders/jx/x83g474d0pbcqkq46l2x4vvm0000gn/T/pip-build-EIn18D/pachi-py/setup.py';exec(compile(getattr(tokenize, 'open', open)(__file__).read().replace('\r\n', '\n'), __file__, 'exec'))" install --record /var/folders/jx/x83g474d0pbcqkq46l2x4vvm0000gn/T/pip-v9kCGg-record/install-record.txt --single-version-externally-managed --compile" failed with error code 1 in /private/var/folders/jx/x83g474d0pbcqkq46l2x4vvm0000gn/T/pip-build-EIn18D/pachi-py/``

There are some other people having the same issue as mine  (#164) , it seems like it's trying to build binaries for OSX 10.5, and the problem comes from Anaconda. They tried to uninstall Anaconda and succeeded. However I don't want to remove Anaconda as I rely heavily on it, do you have any ideas ? Thank you!

timothy2008, 2016-06-19:
I have the exact same issue as you
The error message is:
Command "/Users/timothy/anaconda/bin/python -u -c "import setuptools, tokenize;__file__='/private/var/folders/37/gr5h7vhj2gnb7cbxzjp5bt6w0000gn/T/pip-build-JXGjpF/pachi-py/setup.py';exec(compile(getattr(tokenize, 'open', open)(__file__).read().replace('\r\n', '\n'), __file__, 'exec'))" install --record /var/folders/37/gr5h7vhj2gnb7cbxzjp5bt6w0000gn/T/pip-RSu5_K-record/install-record.txt --single-version-externally-managed --compile" failed with error code 1 in /private/var/folders/37/gr5h7vhj2gnb7cbxzjp5bt6w0000gn/T/pip-build-JXGjpF/pachi-py/
I doubt this error cause by:
ld: targeted OS version does not support use of thread local variables in _fast_srandom for architecture x86_64
    clang: error: linker command failed with exit code 1 (use -v to see invocation)
    error: command 'g++' failed with exit status 1
at previous stage of compiling.

timothy2008, 2016-06-21:
This is the build log
`Timothys-MacBook-Pro:gym timothy$ pip install -e '.[all]'
Obtaining file:///Users/timothy/Documents/gym/gym
Requirement already satisfied (use --upgrade to upgrade): numpy>=1.10.4 in /Library/Frameworks/Python.framework/Versions/2.7/lib/python2.7/site-packages (from gym==0.1.3)
Requirement already satisfied (use --upgrade to upgrade): requests>=2.0 in /Library/Frameworks/Python.framework/Versions/2.7/lib/python2.7/site-packages (from gym==0.1.3)
Requirement already satisfied (use --upgrade to upgrade): six in /Library/Frameworks/Python.framework/Versions/2.7/lib/python2.7/site-packages (from gym==0.1.3)
Requirement already satisfied (use --upgrade to upgrade): pyglet>=1.2.0 in /Library/Frameworks/Python.framework/Versions/2.7/lib/python2.7/site-packages (from gym==0.1.3)
Requirement already satisfied (use --upgrade to upgrade): atari_py>=0.0.17 in /Library/Frameworks/Python.framework/Versions/2.7/lib/python2.7/site-packages (from gym==0.1.3)
Requirement already satisfied (use --upgrade to upgrade): Pillow in /Library/Frameworks/Python.framework/Versions/2.7/lib/python2.7/site-packages (from gym==0.1.3)
Requirement already satisfied (use --upgrade to upgrade): PyOpenGL in /Library/Frameworks/Python.framework/Versions/2.7/lib/python2.7/site-packages (from gym==0.1.3)
Requirement already satisfied (use --upgrade to upgrade): pachi-py>=0.0.19 in /Library/Frameworks/Python.framework/Versions/2.7/lib/python2.7/site-packages (from gym==0.1.3)
Requirement already satisfied (use --upgrade to upgrade): box2d-py in /Library/Frameworks/Python.framework/Versions/2.7/lib/python2.7/site-packages (from gym==0.1.3)
Collecting doom_py>=0.0.11 (from gym==0.1.3)
  Using cached doom-py-0.0.15.tar.gz
Collecting mujoco_py>=0.4.3 (from gym==0.1.3)
Collecting imageio (from gym==0.1.3)
  Using cached imageio-1.5-cp26.cp27.cp33.cp34.cp35-none-macosx_10_5_x86_64.macosx_10_6_intel.whl
Collecting keras (from gym==0.1.3)
Collecting theano (from gym==0.1.3)
Collecting pyyaml (from keras->gym==0.1.3)
  Using cached PyYAML-3.11.zip
Collecting scipy>=0.11 (from theano->gym==0.1.3)
  Using cached scipy-0.17.1-cp27-cp27m-macosx_10_6_intel.macosx_10_9_intel.macosx_10_9_x86_64.macosx_10_10_intel.macosx_10_10_x86_64.whl
Installing collected packages: doom-py, mujoco-py, imageio, scipy, theano, pyyaml, keras, gym
  Running setup.py install for doom-py ... error
    Complete output from command /Library/Frameworks/Python.framework/Versions/2.7/Resources/Python.app/Contents/MacOS/Python -u -c "import setuptools, tokenize;__file__='/private/var/folders/37/gr5h7vhj2gnb7cbxzjp5bt6w0000gn/T/pip-build-oZe0bx/doom-py/setup.py';exec(compile(getattr(tokenize, 'open', open)(__file__).read().replace('\r\n', '\n'), __file__, 'exec'))" install --record /var/folders/37/gr5h7vhj2gnb7cbxzjp5bt6w0000gn/T/pip-gXL6KD-record/install-record.txt --single-version-externally-managed --compile:
    running install
    running build
    -- The C compiler identification is AppleClang 7.3.0.7030031
    -- The CXX compiler identification is AppleClang 7.3.0.7030031
    -- Check for working C compiler: /Applications/Xcode.app/Contents/Developer/Toolchains/XcodeDefault.xctoolchain/usr/bin/cc
    -- Check for working C compiler: /Applications/Xcode.app/Contents/Developer/Toolchains/XcodeDefault.xctoolchain/usr/bin/cc -- works
    -- Detecting C compiler ABI info
    -- Detecting C compiler ABI info - done
    -- Detecting C compile features
    -- Detecting C compile features - done
    -- Check for working CXX compiler: /Applications/Xcode.app/Contents/Developer/Toolchains/XcodeDefault.xctoolchain/usr/bin/c++
    -- Check for working CXX compiler: /Applications/Xcode.app/Contents/Developer/Toolchains/XcodeDefault.xctoolchain/usr/bin/c++ -- works
    -- Detecting CXX compiler ABI info
    -- Detecting CXX compiler ABI info - done
    -- Detecting CXX compile features
    -- Detecting CXX compile features - done
    -- Looking for pthread.h
    -- Looking for pthread.h - found
    -- Looking for pthread_create
    -- Looking for pthread_create - found
    -- Found Threads: TRUE
    -- Boost version: 1.60.0
    -- Found the following Boost libraries:
    --   filesystem
    --   thread
    --   system
    --   date_time
    --   chrono
    --   regex
    --   iostreams
    --   atomic
    -- Found BZip2: /usr/lib/libbz2.dylib (found version "1.0.6")
    -- Looking for BZ2_bzCompressInit
    -- Looking for BZ2_bzCompressInit - found
    -- Found JPEG: /Users/timothy/anaconda/lib/libjpeg.dylib
    -- Found ZLIB: /Users/timothy/anaconda/lib/libz.dylib (found version "1.2.8")
    -- Could NOT find GME (missing:  GME_LIBRARIES GME_INCLUDE_DIR)
    -- Using system zlib
    -- Using system jpeg library
    -- Using system bzip2 library
    -- Using internal gme library
    -- Performing Test HAVE_NO_ARRAY_BOUNDS
    -- Performing Test HAVE_NO_ARRAY_BOUNDS - Success
    -- Looking for strdup
    -- Looking for strdup - found
    -- Looking for strndup
    -- Looking for strndup - found
    -- Looking for sys/types.h
    -- Looking for sys/types.h - found
    -- Looking for stdint.h
    -- Looking for stdint.h - found
    -- Looking for stddef.h
    -- Looking for stddef.h - found
    -- Check size of char
    -- Check size of char - done
    -- Check size of short
    -- Check size of short - done
    -- Check size of int
    -- Check size of int - done
    -- Check size of long
    -- Check size of long - done
    -- /Users/timothy/anaconda/include
    -- /usr/include
    -- /private/var/folders/37/gr5h7vhj2gnb7cbxzjp5bt6w0000gn/T/pip-build-oZe0bx/doom-py/doom_py/src/vizdoom/lzma/C
    -- Looking for itoa
    -- Looking for itoa - not found
    -- Performing Test DUMB_CAN_USE_SSE
    -- Performing Test DUMB_CAN_USE_SSE - Success
    -- Could NOT find PkgConfig (missing:  PKG_CONFIG_EXECUTABLE)
    -- Found SDL2: /usr/local/lib/libSDL2main.a;/usr/local/lib/libSDL2.dylib;-framework Cocoa
    -- Found OpenAL: /Applications/Xcode.app/Contents/Developer/Platforms/MacOSX.platform/Developer/SDKs/MacOSX10.11.sdk/System/Library/Frameworks/OpenAL.framework
    -- Could not find FMOD include files
    -- Could NOT find SndFile (missing:  SNDFILE_LIBRARY SNDFILE_INCLUDE_DIR)
    -- Could NOT find MPG123 (missing:  MPG123_LIBRARIES MPG123_INCLUDE_DIR)
    -- Could NOT find FluidSynth (missing:  FLUIDSYNTH_LIBRARIES FLUIDSYNTH_INCLUDE_DIR)
    -- Looking for filelength
    -- Looking for filelength - not found
    -- Looking for strupr
    -- Looking for strupr - not found
    -- Looking for stricmp
    -- Looking for stricmp - not found
    -- Looking for strnicmp
    -- Looking for strnicmp - not found
    -- Looking for clock_gettime in rt
    -- Looking for clock_gettime in rt - not found
    -- Looking for clock_gettime
    -- Looking for clock_gettime - not found
    -- Could not find clock_gettime. Timing statistics will not be available.
    -- Performing Test HAS_VA_COPY
    -- Performing Test HAS_VA_COPY - Success
    -- Boost version: 1.60.0
    -- Found the following Boost libraries:
    --   thread
    --   system
    --   date_time
    --   chrono
    --   atomic
    -- Fluid synth libs: FLUIDSYNTH_LIBRARIES-NOTFOUND
    -- Found PythonInterp: /Library/Frameworks/Python.framework/Versions/2.7/Resources/Python.app/Contents/MacOS/Python (found suitable version "2.7.11", minimum required is "2.7")
    -- Found PythonLibs: /Library/Frameworks/Python.framework/Versions/2.7/lib/python2.7/config/libpython2.7.dylib (found suitable version "2.7.11", minimum required is "2.7")
    -- Using python library: /Library/Frameworks/Python.framework/Versions/2.7/lib/python2.7/config/libpython2.7.dylib
    -- Using python include: /Library/Frameworks/Python.framework/Versions/2.7/include/python2.7
    -- Could NOT find Boost
    -- Could NOT find Boost
    -- Boost library python-py27:
    -- Could NOT find Boost
    -- Boost library python27:
    -- Could NOT find Boost
    -- Boost library python-py2:
    -- Could NOT find Boost
    -- Boost library python2:
    -- Boost version: 1.60.0
    -- Found the following Boost libraries:
    --   python
    -- Found NUMPY: /Library/Frameworks/Python.framework/Versions/2.7/lib/python2.7/site-packages/numpy/core/include
    -- Found components for NumPy
    -- NUMPY_ROOT_DIR    = /usr/local
    -- NUMPY_INCLUDES    = /Library/Frameworks/Python.framework/Versions/2.7/lib/python2.7/site-packages/numpy/core/include
    -- NUMPY_LIBRARIES   = /Library/Frameworks/Python.framework/Versions/2.7/lib/python2.7/site-packages/numpy/core/lib/libnpymath.a
    -- NUMPY_API_VERSION = 1.11.0
    -- Configuring done
    CMake Warning (dev):
      Policy CMP0042 is not set: MACOSX_RPATH is enabled by default.  Run "cmake
      --help-policy CMP0042" for policy details.  Use the cmake_policy command to
      set the policy and suppress this warning.

      MACOSX_RPATH is not specified for the following targets:

       libvizdoom_shared

    This warning is for project developers.  Use -Wno-dev to suppress it.

    -- Generating done
    -- Build files have been written to: /private/var/folders/37/gr5h7vhj2gnb7cbxzjp5bt6w0000gn/T/pip-build-oZe0bx/doom-py/doom_py
    Scanning dependencies of target freedoom2
    ./download_freedoom.sh: line 10: wget: command not found
    unzip:  cannot find or open ./bin/freedoom-0.10.1.zip, ./bin/freedoom-0.10.1.zip.zip or ./bin/freedoom-0.10.1.zip.ZIP.
    make[2]: *** [CMakeFiles/freedoom2] Error 9
    make[1]: *** [CMakeFiles/freedoom2.dir/all] Error 2
    make[1]: *** Waiting for unfinished jobs....
    Scanning dependencies of target libvizdoom_shared
    Scanning dependencies of target libvizdoom_static
    [  0%] Building CXX object CMakeFiles/libvizdoom_shared.dir/src/lib/ViZDoomController.cpp.o
    [  0%] Building CXX object CMakeFiles/libvizdoom_static.dir/src/lib/ViZDoomController.cpp.o
    [  1%] Building CXX object CMakeFiles/libvizdoom_static.dir/src/lib/ViZDoomExceptions.cpp.o
    [  2%] Building CXX object CMakeFiles/libvizdoom_shared.dir/src/lib/ViZDoomExceptions.cpp.o
    [  2%] Building CXX object CMakeFiles/libvizdoom_static.dir/src/lib/ViZDoomGame.cpp.o
    /private/var/folders/37/gr5h7vhj2gnb7cbxzjp5bt6w0000gn/T/pip-build-oZe0bx/doom-py/doom_py/src/lib/ViZDoomController.cpp:656:17: warning: 50 enumeration values not handled in switch: 'AMMO0', 'AMMO1', 'AMMO2'... [-Wswitch]
            switch (var) {
                    ^
    /private/var/folders/37/gr5h7vhj2gnb7cbxzjp5bt6w0000gn/T/pip-build-oZe0bx/doom-py/doom_py/src/lib/ViZDoomController.cpp:656:17: warning: 50 enumeration values not handled in switch: 'AMMO0', 'AMMO1', 'AMMO2'... [-Wswitch]
            switch (var) {
                    ^
    1 warning generated.
    [  2%] Building CXX object CMakeFiles/libvizdoom_shared.dir/src/lib/ViZDoomGame.cpp.o
    1 warning generated.
    [  2%] Building CXX object CMakeFiles/libvizdoom_shared.dir/src/lib/ViZDoomUtilities.cpp.o
    [  2%] Building CXX object CMakeFiles/libvizdoom_static.dir/src/lib/ViZDoomUtilities.cpp.o
    [  2%] Linking CXX static library bin/libvizdoom.a
    [  2%] Built target libvizdoom_static
    [  2%] Linking CXX shared library bin/libvizdoom.dylib
    [  2%] Built target libvizdoom_shared
    make: *** [all] Error 2

    Could not build doom-py: Command '['make', '-j', '3']' returned non-zero exit status 2. (HINT: are you sure cmake is installed? You might also be missing a library. doom_py requires boost, boost-python, sdl2 on OSX (installable via 'brew install boost boost-python sdl2')

    Traceback (most recent call last):
      File "<string>", line 1, in <module>
      File "/private/var/folders/37/gr5h7vhj2gnb7cbxzjp5bt6w0000gn/T/pip-build-oZe0bx/doom-py/setup.py", line 88, in <module>
        include_package_data=True,
      File "/Library/Frameworks/Python.framework/Versions/2.7/lib/python2.7/distutils/core.py", line 151, in setup
        dist.run_commands()
      File "/Library/Frameworks/Python.framework/Versions/2.7/lib/python2.7/distutils/dist.py", line 953, in run_commands
        self.run_command(cmd)
      File "/Library/Frameworks/Python.framework/Versions/2.7/lib/python2.7/distutils/dist.py", line 972, in run_command
        cmd_obj.run()
      File "/Library/Frameworks/Python.framework/Versions/2.7/lib/python2.7/site-packages/setuptools/command/install.py", line 61, in run
        return orig.install.run(self)
      File "/Library/Frameworks/Python.framework/Versions/2.7/lib/python2.7/distutils/command/install.py", line 563, in run
        self.run_command('build')
      File "/Library/Frameworks/Python.framework/Versions/2.7/lib/python2.7/distutils/cmd.py", line 326, in run_command
        self.distribution.run_command(command)
      File "/Library/Frameworks/Python.framework/Versions/2.7/lib/python2.7/distutils/dist.py", line 972, in run_command
        cmd_obj.run()
      File "/private/var/folders/37/gr5h7vhj2gnb7cbxzjp5bt6w0000gn/T/pip-build-oZe0bx/doom-py/setup.py", line 63, in run
        build_func()
      File "/private/var/folders/37/gr5h7vhj2gnb7cbxzjp5bt6w0000gn/T/pip-build-oZe0bx/doom-py/setup.py", line 34, in build_osx
        build_common('dylib', cmake_arg_list=['-DOSX_COCOA_BACKEND=OFF'])
      File "/private/var/folders/37/gr5h7vhj2gnb7cbxzjp5bt6w0000gn/T/pip-build-oZe0bx/doom-py/setup.py", line 29, in build_common
        subprocess.check_call(['make', '-j', str(cores_to_use)], cwd='doom_py')
      File "/Library/Frameworks/Python.framework/Versions/2.7/lib/python2.7/subprocess.py", line 540, in check_call
        raise CalledProcessError(retcode, cmd)
    subprocess.CalledProcessError: Command '['make', '-j', '3']' returned non-zero exit status 2

    ----------------------------------------
Command "/Library/Frameworks/Python.framework/Versions/2.7/Resources/Python.app/Contents/MacOS/Python -u -c "import setuptools, tokenize;__file__='/private/var/folders/37/gr5h7vhj2gnb7cbxzjp5bt6w0000gn/T/pip-build-oZe0bx/doom-py/setup.py';exec(compile(getattr(tokenize, 'open', open)(__file__).read().replace('\r\n', '\n'), __file__, 'exec'))" install --record /var/folders/37/gr5h7vhj2gnb7cbxzjp5bt6w0000gn/T/pip-gXL6KD-record/install-record.txt --single-version-externally-managed --compile" failed with error code 1 in /private/var/folders/37/gr5h7vhj2gnb7cbxzjp5bt6w0000gn/T/pip-build-oZe0bx/doom-py/`

This is another result after mdfind.....
`Timothys-MacBook-Pro:gym timothy$ mdfind Developer | grep "\(CommandLineTools\)\|\(Xcode\)"
/Applications/Xcode.app
/Library/Developer/CommandLineTools/Library/Developer
Timothys-MacBook-Pro:gym timothy$ xcode-select -p
/Applications/Xcode.app/Contents/Developer `

jietang, 2016-06-23:
It looks like it's now failing because it can't find wget to download the freedoom dependency

```
    ./download_freedoom.sh: line 10: wget: command not found
    unzip:  cannot find or open ./bin/freedoom-0.10.1.zip, ./bin/freedoom-0.10.1.zip.zip or ./bin/freedoom-0.10.1.zip.ZIP.
```

Can you try brew install wget and then rerunning?

I've added it to our dependency list.

timothy2008, 2016-06-25:
I have installed openssl and wget on mac, but it seems when using wget, openssl cannot verify github.com 's certificate.

```
 -- Generating done
    -- Build files have been written to: /private/var/folders/37/gr5h7vhj2gnb7cbxzjp5bt6w0000gn/T/pip-build-77zlW2/doom-py/doom_py
    Scanning dependencies of target freedoom2
    --2016-06-25 21:25:01--  https://github.com/freedoom/freedoom/releases/download/v0.10.1/freedoom-0.10.1.zip
    Resolving github.com... 192.30.252.122
    Connecting to github.com|192.30.252.122|:443... connected.
    ERROR: cannot verify github.com's certificate, issued by 'CN=DigiCert SHA2 Extended Validation Server CA,OU=www.digicert.com,O=DigiCert Inc,C=US':
      Unable to locally verify the issuer's authority.
    To connect to github.com insecurely, use `--no-check-certificate'.
    unzip:  cannot find or open ./bin/freedoom-0.10.1.zip, ./bin/freedoom-0.10.1.zip.zip or ./bin/freedoom-0.10.1.zip.ZIP.
    make[2]: *** [CMakeFiles/freedoom2] Error 9
    make[1]: *** [CMakeFiles/freedoom2.dir/all] Error 2
    make[1]: *** Waiting for unfinished jobs....
    Scanning dependencies of target libvizdoom_static
    Scanning dependencies of target libvizdoom_shared
    [  1%] Building CXX object CMakeFiles/libvizdoom_static.dir/src/lib/ViZDoomExceptions.cpp.o
    [  1%] Building CXX object CMakeFiles/libvizdoom_static.dir/src/lib/ViZDoomController.cpp.o
    [  1%] Building CXX object CMakeFiles/libvizdoom_shared.dir/src/lib/ViZDoomController.cpp.o
    [  1%] Building CXX object CMakeFiles/libvizdoom_static.dir/src/lib/ViZDoomGame.cpp.o

```

I believe it is because in /System/Library/OpenSSL/certs/ ,there is no .pem and .cer for github.com. Therefore I downloaded the .pem file by

`echo -n | openssl s_client -connect github.com:443 | sed -ne '/-BEGIN CERTIFICATE-/,/-END CERTIFICATE-/p' >  /System/Library/OpenSSL/certs/github.pem`

Unfortunately, it doesn't work at all. wget still not able to verify the CA of github.com.
```
Timothys-MacBook-Pro:tmp timothy$ wget https://github.com
--2016-06-25 21:56:40--  https://github.com/
Resolving github.com... 192.30.252.128
Connecting to github.com|192.30.252.128|:443... connected.
ERROR: cannot verify github.com's certificate, issued by 'CN=DigiCert SHA2 Extended Validation Server CA,OU=www.digicert.com,O=DigiCert Inc,C=US':
  Unable to locally verify the issuer's authority.
To connect to github.com insecurely, use `--no-check-certificate'.
```

Do you have any alternative methods suggest to me?
Thank you very much :)

jietang, 2016-06-29:
Weird.

As a workaround, I suggest cloning the github.com/openai/doom_py repo directly, then running the steps in the doom_py/doom_py/download_freedom.sh script by hand (i.e. downloading and unzipping the freedoom .wad files)

Then you can run
```
python setup.py bdist_wheel
python setup.py install
```
to install doom_py.

Lastly you'll need to rerun `sudo pip install -e '.[all]' `on gym

fferreres, 2016-10-03:
I had the same problem, exactly, regarding pachi_py. The environment variable comment resolved the issue. I installed all of Xcode, and pointed it to a 10.12 SDK. Unfortunately, I am not a developer and I am not sure if I needed all of Xcode -huge thing- vs the command line tools which I used for brew.

Thanks for the solution

scientist1642, 2016-10-08:
Also you should make sure that cmake is installed, tested on 10.12 as well.

fferreres, 2016-10-13:
I was able to solve the problem by fully installing Xcode (not just the
CLT) and exporting the ENV variables to the latest sdk source. Thanks.

On Sat, Oct 8, 2016 at 4:16 PM, Zura Isakadze <notifications@github.com>
wrote:

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

JulianNorton, 2016-12-19:
several issues I had that *finally* got it working.

1. Uninstall anaconda or conda
`rm -rf ~/anaconda`
2. Reinstall pip and pip3
  * pip install --force-reinstall --upgrade pip
  * pip3 install --force-reinstall --upgrade pip3
3. `brew install cmake`
4. `brew install swig`

Instassa, 2017-03-11:
I've been trying to follow the above instructions. However when I am trying `pip install --force-reinstall --upgrade pip & pip3 install --force-reinstall --upgrade pip3`, I get the following:
```
[1] 44921
You are using pip version 7.1.0, however version 9.0.1 is available.
You should consider upgrading via the 'pip install --upgrade pip' command.
Collecting pip
Downloading/unpacking pip3
  Using cached pip-9.0.1-py2.py3-none-any.whl
Installing collected packages: pip
  Found existing installation: pip 7.1.0
    Uninstalling pip-7.1.0:
Exception:
Traceback (most recent call last):
  File "/usr/lib/python2.7/site-packages/pip/basecommand.py", line 223, in main
    status = self.run(options, args)
  File "/usr/lib/python2.7/site-packages/pip/commands/install.py", line 308, in run
    strip_file_prefix=options.strip_file_prefix,
  File "/usr/lib/python2.7/site-packages/pip/req/req_set.py", line 640, in install
    requirement.uninstall(auto_confirm=True)
  File "/usr/lib/python2.7/site-packages/pip/req/req_install.py", line 726, in uninstall
    paths_to_remove.remove(auto_confirm)
  File "/usr/lib/python2.7/site-packages/pip/req/req_uninstall.py", line 125, in remove
    renames(path, new_path)
  File "/usr/lib/python2.7/site-packages/pip/utils/__init__.py", line 314, in renames
    shutil.move(old, new)
  File "/usr/lib64/python2.7/shutil.py", line 302, in move
    os.unlink(src)
OSError: [Errno 13] Permission denied: '/usr/bin/pip'

  Real name of requirement pip3 is pip2
  Could not find any downloads that satisfy the requirement pip3
Cleaning up...
No distributions at all found for pip3
Storing debug log for failure in /afs/inf.ed.ac.uk/user/s16/s1686829/.pip/pip.log
[1]+  Exit 2                  pip install --force-reinstall --upgrade pip
```

After this bullet points 3. and 4. of instructions run normally, but then `pip3 install gym[all]` doesn't.

Any ideas what is going wrong?

tlbtlbtlb, 2017-03-11:
> Permission denied
Add `sudo` at the beginning of the command.

Instassa, 2017-03-12:
> Add `sudo` at the beginning of the command.

When I enter `sudo pip install --force-reinstall --upgrade pip & pip3 install --force-reinstall --upgrade pip3`
I get the following error:
```
[3] 14276
Downloading/unpacking pip3
  Real name of requirement pip3 is pip2
  Could not find any downloads that satisfy the requirement pip3
Cleaning up...
No distributions at all found for pip3
Storing debug log for failure in /afs/inf.ed.ac.uk/user/s16/s1686829/.pip/pip.log

```

JulianNorton, 2017-03-12:
Hey @Instassa ,

http://stackoverflow.com/a/39946882/1943206 might be a good series of steps to try.

https://gist.github.com/JulianNorton/ce4b267d1bc7c675b20427885e23dabc is my personal list that's helped me in the past.

Instassa, 2017-03-16:
Thank you Julian, now everything is installing all right, however when I run my code I get the following error: `AttributeError: module '_Box2D' has no attribute 'RAND_LIMIT_swigconstant'`

It seems to do something with swig, however swig installation went without errors.

Full error I get is this:
```
Using TensorFlow backend.
/disk/scratch/s1686829/anaconda/lib/python3.6/site-packages/keras/legacy/interfaces.py:86: UserWarning: Update your `Dense` call to the Keras 2 API: `Dense(6, input_shape=(6,), kernel_initializer="lecun_uniform")`
  '` call to the Keras 2 API: ' + signature)
/disk/scratch/s1686829/anaconda/lib/python3.6/site-packages/keras/legacy/interfaces.py:86: UserWarning: Update your `Dense` call to the Keras 2 API: `Dense(100, kernel_initializer="lecun_uniform")`
  '` call to the Keras 2 API: ' + signature)
/disk/scratch/s1686829/anaconda/lib/python3.6/site-packages/keras/legacy/interfaces.py:86: UserWarning: Update your `Dense` call to the Keras 2 API: `Dense(50, kernel_initializer="lecun_uniform")`
  '` call to the Keras 2 API: ' + signature)
/disk/scratch/s1686829/anaconda/lib/python3.6/site-packages/keras/legacy/interfaces.py:86: UserWarning: Update your `Dense` call to the Keras 2 API: `Dense(27, kernel_initializer="lecun_uniform")`
  '` call to the Keras 2 API: ' + signature)
[2017-03-16 11:54:57,445] Making new env: CarRacing-v0
Traceback (most recent call last):
  File "CarRacing_newQlearning.py", line 356, in <module>
    Rewards, Times, CummulativeRewards, Weights = Q_learning(model, epochs = 1, stages = 100, gamma = 0.975, epsilon = 0.99, batchSize = 100, buffer = 3000, randSeed = 42, replay = None)
  File "CarRacing_newQlearning.py", line 192, in Q_learning
    env = gym.make('CarRacing-v0')
  File "/disk/scratch/s1686829/anaconda/lib/python3.6/site-packages/gym/envs/registration.py", line 161, in make
    return registry.make(id)
  File "/disk/scratch/s1686829/anaconda/lib/python3.6/site-packages/gym/envs/registration.py", line 119, in make
    env = spec.make()
  File "/disk/scratch/s1686829/anaconda/lib/python3.6/site-packages/gym/envs/registration.py", line 85, in make
    cls = load(self._entry_point)
  File "/disk/scratch/s1686829/anaconda/lib/python3.6/site-packages/gym/envs/registration.py", line 17, in load
    result = entry_point.load(False)
  File "/disk/scratch/s1686829/anaconda/lib/python3.6/site-packages/setuptools-27.2.0-py3.6.egg/pkg_resources/__init__.py", line 2258, in load
  File "/disk/scratch/s1686829/anaconda/lib/python3.6/site-packages/setuptools-27.2.0-py3.6.egg/pkg_resources/__init__.py", line 2264, in resolve
  File "/disk/scratch/s1686829/anaconda/lib/python3.6/site-packages/gym/envs/box2d/__init__.py", line 1, in <module>
    from gym.envs.box2d.lunar_lander import LunarLander
  File "/disk/scratch/s1686829/anaconda/lib/python3.6/site-packages/gym/envs/box2d/lunar_lander.py", line 4, in <module>
    import Box2D
  File "/disk/scratch/s1686829/anaconda/lib/python3.6/site-packages/Box2D/__init__.py", line 20, in <module>
    from .Box2D import *
  File "/disk/scratch/s1686829/anaconda/lib/python3.6/site-packages/Box2D/Box2D.py", line 435, in <module>
    _Box2D.RAND_LIMIT_swigconstant(_Box2D)
AttributeError: module '_Box2D' has no attribute 'RAND_LIMIT_swigconstant'
```

JulianNorton, 2017-03-16:
@Instassa
I think this is the right thread and solution:
* https://github.com/openai/gym/issues/100
* https://github.com/openai/gym/issues/100#issuecomment-219545876

christopherhesse, 2019-05-03:
The box2d swig error should be fixed in master, we also don't use doom_py or pachi_py in gym so any errors with those should be filed on their respective repos.

Closed 2019-05-03.

Thread 247 (2016-07-13):

Rendering causes crash when gym is wrapped in a ROS node

evenmarbles, 2016-07-13:
I wrote a ROS node wrapping openaigym to run the environments an then pass the action from another ROS. But for some reason the code crashes with exit code 139 whenever rendering is turned on. The program works fine without rendering.

Furthermore, when rendering is turned on, it starts by displaying the environment in the window, but crashes when updating the rendering after receiving its first action from the other node. To be more precise it crashes when executing the command glClearColor(1, 1, 1, 1) in gym.env.classic_control.rendering.py (so far I tried it for the CartPole and the MountainCar domains).

As an interesting tidbit, when I am running the ROS node openaigym wrapper, and sample actions in the node and pass it directly into the function dealing with updating the environment and rendering it (without involving the agent ROS node, the program runs just fine (doesn't crash).

So my best guess is that the crash is somehow related to using tcp (since this is how the information is passed from the agent to the environment) and pyglet/opengl.

tlbtlbtlb, 2016-07-14:
Exit code 139 == segmentation fault.

How is the process connecting to the X server?

evenmarbles, 2016-07-14:
The error shown below is without connecting to the X server. However, when I try to connect to the X server as follows:
$ xvfb-run --auto-servernum -s "-screen 0 1400x900x24" bash
$ rosrun ....

I am getting the following error:
_pyglet.gl.glx_info.GLXInfoException: pyglet requires an X server with GLX_

Checking:
$ glxinfo
Reveals the following error:
_name of display: :99
Xlib:  extension "GLX" missing on display ":99".
...
Error: couldn't find RGB GLX visual or fbconfig_

Do you have any suggestions?

tlbtlbtlb, 2016-07-14:
Your installation of xvfb doesn't support GLX (needed for OpenGL).

There is lots written about it at http://stackexchange.com/search?q=xvfb+GLX

Here's what worked for me on ubuntu 14.04 inside a Docker container on an AWS instance:
```
apt-get install \
    xorg-dev \
    libglu1-mesa libgl1-mesa-dev \
    xvfb \
    libxinerama1 libxcursor1 \

xvfb-run -a -s "-screen 0 1400x900x24 +extension RANDR" -- python XXX.py
```

jietang, 2016-07-21:
@evenmarbles any updates here?

luongminh97, 2016-07-21:
@tlbtlbtlb Can you share the AMI you used? I can't seem to get pass the "pyglet requires an X server with GLX" error with your configuration.

hholst80, 2016-07-21:
I get the same error as you @luongminh97. I was recommended to try http://www.karlrunge.com/x11vnc/Xdummy but opt-out and just disabled rendering for now. I also tried virtualgl which works good for `glxgears` and `glxinfo` but `pyglet` still wasn't happy.

tlbtlbtlb, 2016-07-21:
I run this inside docker containers, based on 64-bit Ubuntu 14.04. I haven't tried directly inside an AMI-based system.

The X server log may reveal why it failed to enable GLX.

DavidSanwald, 2016-11-13:
@luongminh97 @hholst80

What @pemami4911  wrote on #366 (THANKS!)  finally pointed me into the right direction.

I didn't xvfb and sadly also X-dummy to work for a long time but when I followed pemami4911's hint and installed the Nvidia driver with --no-opengl-files option and CUDA with --no-opengl-libs xvfb worked right away.
I did not have to do anything complicated, just installing drivers with --no-opengl-files and CUDA with --no-opengl-libs. Just in case I documented the necessary steps [here](https://davidsanwald.github.io/ec2-openAI-gym-tensorflow-GPU-cuda-deep-learning.html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)

vlad17, 2017-08-29:
@DavidSanwald / @tlbtlbtlb do you still do this? It works for me, but it seems that his forces rendering onto the CPU (just basing this off of watching nvidia-smi), and it'd be nice to render on the GPU.

Closed 2019-10-13.

Thread 275 (2016-08-06):

How to obtain skipped frames from the Atari envs?

danijar, 2016-08-06:
Many RL papers stack the last couple of frames into a single observation to address partial observability. The Atari envs repeat actions for 2, 3, or 4 frames, which is also common. However, they only return the new frame afterwards. How can I access the skipped frames from the Atari envs in order to reproduce algorithms such as DQN?

gdb, 2016-08-06:
There's not currently an interface for this.

cc/ @joschu what do you think we should do here?

joschu, 2016-08-06:
You can stack the frames returned by the environment
That's the same thing done in the other papers that use the Atari domain, such as deepmind's paper.
I.e., they stack frames (t, t-4, t-8, t-12), not (t,t-1,t-2,t-3).

danijar, 2016-08-08:
@joschu I know, but the environment already applies each action 2-4 times in a row and the env only returns one observation afterwards. Could you reopen please, or am I getting this wrong?

joschu, 2016-08-08:
That's how we've decided to define the Environment, since that's how it worked in previous papers that reported results on Atari.
If you want to use the skipped frames, you can make a new Environment for your own use.

danijar, 2016-08-09:
Okay, so previous papers skip 2-4 frames and use the last four non-skipped frames as input?

joschu, 2016-08-09:
Correct. (and they are generally a bit ambiguous about it.)
None of the previous papers use the stochastic frame skipping, though.
We did that because otherwise the games are fully deterministic.

danijar, 2016-08-09:
For example, the [2015 Nature paper][1] by Mnih et al. first introduces history frames as:

> The function w from algorithm 1 described below applies this preprocessing to the m most recent frames and stacks them to produce the input to the Q-function, in which m=4, although the algorithm is robust to different values of m (for example, 3 or 5).

By that point, the didn't talk about frame skipping yet, so I assume that the m most recent frames refer to the m last game ticks. They then describe frame skipping later as:

> Following previous approaches to playing Atari 2600 games, we also use a simple frame-skipping technique. More precisely, the agent sees and selects actions on every kth frame instead of every frame, and its last action is repeated on skipped frames.

But I assume that by frames they refer to inputs to the Q-function, in which case, the history stack contains all frames, not just skipped ones.

Anyways, if you're sure about that, that would be very helpful. I can't reproduce DQN and A3C results so far, but it might as well be a problem with the algorithms.

[1]: https://storage.googleapis.com/deepmind-data/assets/papers/DeepMindNature14236Paper.pdf

mthrok, 2016-08-09:
@danijar

You may be interested in these discussions.

https://groups.google.com/forum/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

https://groups.google.com/forum/#!msg/deep-q-learning/7VK6nmj8x8Q/CSOc5SAcAwAJ;context-place=msg/deep-q-learning/JyDjxVKHiFQ/KxGEeLxSBQAJ

https://groups.google.com/forum/#!msg/arcade-learning-environment/N0syOKmRAH4/Gwsjx2KZAgAJ

danijar, 2016-08-10:
Thanks a lot, that made it clear. They stack the last non-skipped frames. Mnih et al. 2015 also take the max of two consecutive frames, at the emulator level. This is not possible with Gym I guess?

joschu, 2016-08-10:
I didn't know about the max operation--good to know. It could be done, but I'm inclined not to, as we're  not necessarily trying to precisely replicate the experimental setup from that paper.

mthrok, 2016-08-10:
Let me summarize this because we see not a few people ask the question on frame skipping.

DeepMind's original DQN paper
- used frame skipping (for fast playing/learning) and
- applied pixel-wise max (to handle flickering) to consecutive frames.

so an input to the neural network is consisted of four frame;

`[max(T-1, T), max(T+3, T+4), max(T+7, T+8), max(T+11, T+12)]`

ALE provides mechanism for frame skipping (combined with adjustable random action repeat) and color averaging over skipped frames. This is also used in `simple_dqn`'s [ALEEnvironment](https://github.com/tambetm/simple_dqn/blob/5c2dab7c6e43a347c2b5bcfe5c2e0b55101191b8/src/environment.py#L44-L46)

Gym's Atari Environment has [built-in stochastic frame skipping](https://github.com/openai/gym/blob/bde0de609d3645e76728b3b8fc2f3bf210187b27/gym/envs/atari/atari_env.py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) common to all games.

The reason behind Gym's stochastic frame skipping is, as mentioned above, to make environment stochastic. (I guess without this, the game will be completely deterministic?)
cf. Interesting thing is that, in `simple_dqn` same randomness is achieved by having agent performs [random number of dummy actions at the beginning of each episode](https://github.com/tambetm/simple_dqn/blob/fe3d97b7ff08edd1b9083299c85e7526eaff3733/src/main.py#L64) when using `ALEEnvironment`.

I think if someone want to reproduce the behavior of the original DQN paper, the easiest will be disabling frame skip and color averaging in `ALEEnvironment` then construct the mechanism on agent side.

danijar, 2016-08-10:
@mthrok Would it be realistic to have a constructor argument to the `AtariEnv` that speficies the choices for the stochastic frame skipping? The default value could be `(2, 3, 3)` and that is what the pre-registered Atari envs use. However, it would make it easy to register the same envs without frame skipping `(0,)`. It would be nice to not having to switch to pure ALE for this.

mthrok, 2016-08-10:
@danijar
Looking at the discussion in https://github.com/openai/gym/pull/282, I thought the same thing (If `kwarg` is introduced to environment creation, we can customize the env for DQN recreation.) and I think the approach is consistent. But since I am outside of the organization so all I can do is just 👍.

allohvk, 2022-10-29:
> That's how we've decided to define the Environment, since that's how it worked in previous papers that reported results on Atari. If you want to use the skipped frames, you can make a new Environment for your own use.

That is not right. Old Atari consoles used the slow decay property of the phospohors (which scintillate the screen) by using 2 successive frames to fully display an object. So a single frame may not contain the full info and a max operator on 2 successive frames at any point of time will have the complete information necessary for the NN to interpret. This max operator works on 2 SUCCESSIVE frames. If we skip a few frames then max will NOT make sense. So it is a legit ask from the OP

Closed 2016-08-06.

Thread 280 (2016-08-09):

Some atari videos are rendered with flashing black screen

ppwwyyxx, 2016-08-09:
For example, here: https://gym.openai.com/evaluations/eval_zIeNk5MxSGOmvGEUxrZDUw
I observed the same thing when I used monitor to record a video.

Haven't checked if the observed state is also like this.

lakshayg, 2017-04-10:
A solution to this problem was pointed out in #378 by @tlbtlbtlb. I am quoting his comment here
> There are versions of the environments that do what I think you want, formed by adding Deterministic or NoFrameSkip to the name. For example, env.make("AirRaidDeterministic-v3").

You can see a list of all the available environments at  https://pastebin.com/pefCGyL7 or
 by running the script https://github.com/openai/gym/blob/master/examples/scripts/list_envs

doronsobol, 2017-10-20:
I tried @lakshayg  idea and ran all the versions of "AirRaid" and I still get mostly black screen.

Using older versions of gym I don't get black screens but those weird images:
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
instead of:
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

If someone have an idea of how to fix that, either by fixing the images of the older version, or by other methods it would be very helpfull.

the code I used:
`env = gym.make('AirRaidNoFrameskip-v0')
env.reset()
game_count = 1
for i in range(50000):
    action_n = env.action_space.sample()
    state, _, done, info = env.step(action_n)
    env.render()
    if done:
        env.reset()`

Thanks

tlbtlbtlb, 2017-10-20:
You probably have incompatible versions of gym and atari-py. Try `pip install atari-py`.

doronsobol, 2017-10-20:
@tlbtlbtlb Thanks for the quick answer, but I'm using the latest atari-py (0.1.1) and gym (0.9.4) and I keep getting black screens - specifically in this game (AirRaid) in all of it's versions.

tlbtlbtlb, 2017-10-20:
Random intervals of blackness are part of the AirRaid game. I think it's simulating the city shutting off the power so the bombers can't see it clearly.  https://en.wikipedia.org/wiki/Air_Raid_(video_game).

It's not a great game, and it was a commercial failure back in the 70s (only a few were sold.) It does seem like an interesting one for RL research, because the agent needs to remember where the attackers are when the screen is black.

A good sanity check on the game-vs-gym behavior is to install [Stella](https://stella-emu.github.io/index.html) which lets you play all the Atari games. It's called "AIR_RAID.BIN" in the menu.

doronsobol, 2017-10-20:
I played this game in Stella and didn't get those black frames, I seems that in the gym almost all of the frames are black.

tlbtlbtlb, 2017-10-20:
Playing under Stella 4.7.3, most of the frames are black. Screen capture from my Mac: https://www.youtube.com/watch?v=tuMfNpsNSns&feature=youtu.be

ppwwyyxx, 2017-10-20:
That's weird. I was playing it with stella 5.0.2 on Linux. Can't see those black frames.
Rom downloaded from atari-py: https://github.com/openai/atari-py/blob/master/atari_py/atari_roms/air_raid.bin

wookayin, 2018-01-21:
For those who might find this thread in the future: see also #596.

trav1s, 2018-01-26:
I had the same issue as @doronsobol with other atari games like breakout and pong. its clearly a display bug and not normal. The workaround from @stefanutti also worked for me:
pip install atari-py==0.0.21

seems some kind of version incompatibility between atari-py and other packages.

wookayin, 2018-10-04:
Any solutions with using recent version of atari-py, say 0.1.6? Why is it happening?

christopherhesse, 2019-08-23:
I looked into the original `air_raid` issue here: https://github.com/openai/gym/issues/1650 and it looks like it's a problem with ALE.

Closed 2019-08-23.

Thread 388 (2016-10-23):

mujoco environments errors

shaneshixiang, 2016-10-23:
Ant-v1  ValueError: b'torso' is not in list
Reacher-v1 ValueError: b'fingertip' is not in list

Other domains work. Thanks!

tlbtlbtlb, 2016-10-24:
This doesn't happen in our tests. Could you provide more details: version of Python, version of Gym, complete stack trace, etc.

shaneshixiang, 2016-11-01:
Python version: Python 3.5.2 |Anaconda 4.2.0 (x86_64)
Gym version: gym 0.4.0

Essentially, line below in get_body_com, mujoco_env.py fails. Called from ant.py and reacher.py.
 idx = self.model.body_names.index(six.b(body_name))

Thanks!

tlbtlbtlb, 2016-11-01:
I can't reproduce this, either with gym-0.4.0 or gym-0.4.9 (latest). Perhaps you have an old version of Mujoco or mujoco_py?

Could you report the result of this script:
```
import gym
import mujoco_py
print(mujoco_py.config.mjpro_path)
e=gym.make('Ant-v1')
print(e.model.body_names)
print(e.reset())
print(e.step(e.action_space.sample()))
```

shaneshixiang, 2016-11-01:
Thanks! Problem was with mujoco_py. rllab had local mujoco_py and it was using that instead.

Closed 2016-11-01.

Thread 427 (2016-12-19):

Blackjack bug for "env.reset()"

RuofanKong, 2016-12-19:
I'm running`Blackjack-v0` with Python 3. I see that `env.reset()` does not reset environment properly, and `state = env.reset()` generates the non-starting `state` for each episode. For example, `(20, 8, False)` is set as the first `state` for the episode, which looks not right as the state first value should be less than 11 in theory. And this would cause the incorrect training results. I wonder if you could help to fix the issue. Thanks!

machinaut, 2016-12-19:
The observation is: player current total, dealer visible total, and whether the player has a usable Ace.

In this case, a draw of 20 could indicate (for example) the player has two 10s.

The blackjack environment class has a documentation string that tries to capture this:
https://github.com/openai/gym/blob/b5108b384ed1e29f3d241d654666b8e347f0f7b9/gym/envs/toy_text/blackjack.py#L64

RuofanKong, 2016-12-19:
Yes I know. But I don't think 20 should appear immediately after I call `state = env.reset()` because the sum for the first card cannot exceed 11.

RuofanKong, 2016-12-19:
OK. Looks like `state = env.reset()` contains data for the first 2 cards in the episode. But seems I still got strange sequence of observations. The following code generates 100-episode games with random actions:

```
import gym

env = gym.make("Blackjack-v0")
env.seed(10)
for i_episode in range(100):
   observation = env.reset()
   print("==============================")
   print("Episode {}:".format(i_episode))
   print("observation reset as: ", observation)
   for t in range(10000):
     action = env.action_space.sample()
     observation, reward, done, info = env.step(action)
     print("action: ", action)
     print("observation: ", observation)
     print("reward: ", reward)
     print("done: ", done)
     if done:
       print("Episode finished after {} timesteps.\n".format(t+1))
       break
```
For some of episodes, the starting observation for `state = env.reset()` is incorrect, for example:

```
==============================
Episode 4:
observation reset as:  (21, 3, True)
action:  1
observation:  (18, 3, False)
reward:  0
done:  False
action:  1
observation:  (27, 3, False)
reward:  -1
done:  True
Episode finished after 2 timesteps.
```
You could see card sum for the second observation 18 is less than the one for the first observation 21, which looks incorrect, and you probably may get issues for several episodes like that. So I wonder if there is something wrong in `env.reset()`. Thanks for any helps!

tlbtlbtlb, 2016-12-20:
I believe the behavior is correct. The first observation `(21, 3, True)` means the player has cards including an ace that sum to 21. Could be [Ace, 10]. It's legal (though silly) to hit on this observation. In this case, it updated to `(18, 3, False)` which probably means the cards are [Ace, 10, 7] which sum to 18 because you now count the ace as 1 instead of 11.

The logic for this is in `usable_ace` and `sum_hand`.

Closed 2016-12-22.

Thread 433 (2016-12-22):

bipedal_walker causes AssertionError

4SkyNet, 2016-12-22:
I get this assertion error in bipedal_walker environments sometimes:
`AssertionError: r.LengthSquared() > 0.0f`

It's a bit strange for me, since I clipped the action before:
`np.clip(action, self.gym.action_space.low, self.gym.action_space.high)`

Can you provide some additional details, which can explain this behaviour?

tlbtlbtlb, 2016-12-22:
@olegklimov The assertion is from
https://github.com/erincatto/Box2D/blob/374664b2a4ce2e7c24fbad6e1ed34bebcc9ab6bc/Box2D/Box2D/Collision/b2DynamicTree.h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
possibly called by this:
https://github.com/openai/gym/blob/312c8b439c5d164c08e111c99ccd2ba8cf3a5857/gym/envs/box2d/bipedal_walker.py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

although I don't see how it could generate identical values for p1 and p2.

@4SkyNet a Python stack trace showing the values of the arguments to the RayCast would be very helpful.

4SkyNet, 2016-12-23:
Thx for your reply > yep, you're right, my call stack is looks like as follows:

`File ".../rl-server/clients/pkg/rl_client_gym/game_env.py", line 80, in act
    screen, reward, terminal, info = self.gym.step(action)`

`File ".../anaconda2/envs/tst/lib/python2.7/site-packages/gym/core.py", line 122, in step
    observation, reward, done, info = self._step(action)`

`File ".../anaconda2/envs/tst/lib/python2.7/site-packages/gym/envs/box2d/bipedal_walker.py", line 390, in _step self.world.RayCast(self.lidar[i], self.lidar[i].p1, self.lidar[i].p2)`

`AssertionError: r.LengthSquared() > 0.0f`

As I said before > I clip any `action` to pass through:
`screen, reward, terminal, info = self.gym.step(action)`

Since that it's a bit strange for me (but most of the time everything is ok)

tlbtlbtlb, 2016-12-23:
Something is causing `(self.lidar[i].p1 - self.lidar[i].p2).LengthSquared() > 0` to be false. If you can look at the values with the python debugger, it might be obvious why. If there's a NaN in there, it's due to a simulator numerical instability in the previous step.

olegklimov, 2016-12-30:
+1 for NaN. I've worked *a lot* with the Walker, have never seen this. @4SkyNet do you have a way to reproduce?

4SkyNet, 2017-01-23:
Sorry for the long delay --> I've ultimately reproduce this error on that machine, which I use for these experiments. Training passed around 12 mil states for 4 parallel clients and all of them died due this error.

I print out the clipped actions for each client before stacking in this assertion.

For the 1st client it looks like as follows:
```python
('act', array([-1., -1., -1., -1.]))
('act', array([-1., -1., -1., -1.]))
('act', array([-1., -1., -1., -1.]))
('act', array([-1., -1., -1., -1.]))
('act', array([-1., -1., -1., -1.]))
('act', array([-1., -1., -1., -1.]))
('act', array([ nan, nan, nan, nan]))
```

2nd looks fine and I take only the last action:
```python
('reset', array([ 0.81319702, 0.01847262, -0.28210664, 0.08144218]))
('act', array([ nan, nan, nan, nan]))
```
3rd also produce some inermediate warning before crashing:
```python
('act', array([ 0.5295043, 1. , -1. , -1. ]))
('act', array([-1., 1., -1., -1.]))
('act', array([ 0.10607028, -1. , -1. , -/home/dvm/anaconda2/envs/tensorflow/lib/python2.7/site-packages/gym/envs/box2d/bipedal_walker.py:371: RuntimeWarning: invalid value encountered in absolute
self.joints[0].maxMotorTorque = float(MOTORS_TORQUE * np.clip(np.abs(action[0]), 0, 1))
/home/dvm/anaconda2/envs/tensorflow/lib/python2.7/site-packages/gym/envs/box2d/bipedal_walker.py:373: RuntimeWarning: invalid value encountered in absolute
self.joints[1].maxMotorTorque = float(MOTORS_TORQUE * np.clip(np.abs(action[1]), 0, 1))
/home/dvm/anaconda2/envs/tensorflow/lib/python2.7/site-packages/gym/envs/box2d/bipedal_walker.py:375: RuntimeWarning: invalid value encountered in absolute
self.joints[2].maxMotorTorque = float(MOTORS_TORQUE * np.clip(np.abs(action[2]), 0, 1))
/home/dvm/anaconda2/envs/tensorflow/lib/python2.7/site-packages/gym/envs/box2d/bipedal_walker.py:377: RuntimeWarning: invalid value encountered in absolute
self.joints[3].maxMotorTorque = float(MOTORS_TORQUE * np.clip(np.abs(action[3]), 0, 1))
1. ]))
('act', array([-1. , -0.47727501, -1. , -1. ]))
('act', array([ nan, nan, nan, nan]))
```
And the 4th also likes ones as 1st:
```python
('act', array([-1. , -1. , -0.84609199, -1. ]))
('act', array([-1., -1., -1., -1.]))
('act', array([-1., -1., -1., -1.]))
('act', array([ nan, nan, nan, nan]))
```

And all of them die with the assertion error mentioned above after that:
```python
Traceback (most recent call last):
...
File ".../my_gym_client/game_env.py", line 81, in act
screen, reward, terminal, info = self.gym.step(action)
File ".../gym/core.py", line 122, in step
observation, reward, done, info = self._step(action)
File ".../gym/envs/box2d/bipedal_walker.py", line 390, in _step
self.world.RayCast(self.lidar[i], self.lidar[i].p1, self.lidar[i].p2)
AssertionError: r.LengthSquared() > 0.0f
```
btw, I've also checked `gym` version on that machine.
It a bit old to my mind:  `0.5.6`

tlbtlbtlb, 2017-01-23:
That looks like your agent is generating the NaNs, and submitting them as the action. That's a problem with your agent, not the gym environment. Actions are required to be within the action space, which is `[-1, -1, -1, -1] to [+1, +1, +1, +1]`.

However, we should fix the gym env to reject such actions immediately rather than propagating NaNs into the simulator. The only checks are like `np.clip(action[0], -1, 1)`, which preserves NaNs. @olegklimov, can you add a check to raise an exception in BipedalWalker._step if action has NaNs?

4SkyNet, 2017-01-23:
Ohh, yeah > it could be my fault > I must to check (at fist) actions produced by my NN with `mu` and `sigma`
(anyway the same trick works fine with trpo-gae instead of da3c continuous)

olegklimov, 2017-02-04:
@tlbtlbtlb Let's close this, there's a lot of environments you can break if you pass NaNs as action?

4SkyNet, 2017-02-04:
@olegklimov definitely! It's ridiculous error, but anyway - I don't have time to check it out for sure again in nearest future (and it seems pretty obvious as is).

4SkyNet, 2017-02-14:
@tlbtlbtlb @olegklimov the problem is in `softplus` function - I've performed experiments one more time.
Anyway, thx for help and care!

edieson, 2020-05-01:
@4SkyNet Hi, I am also experiencing this issue, sac actor produces nan action for BipedalWalkerHardcore-v3, any suggestions on which part of the code to investigate?

Closed 2017-02-14.

Thread 447 (2016-12-29):

Framework for runners and agents?

bstriner, 2016-12-29:
Hi everybody,

Is there a plan to standardize a framework for runners and agents, especially for testing?

A standard API for agents like `new_episode()`, `observe(observation)`, `act()` would mean you could write a standardized test runner that creates an environment, sets the seed, runs the agent, etc. Maybe needs a few callbacks for customization but should ultimately cut down on the amount of boiler plate we have to write. Of course people could still write their own environment loops, but it wouldn't be required.

Looking at examples around the web, not everyone is respecting the done flag, resetting the environment properly, setting the seed, etc. An environment loop within the framework could help.

I would also add `learn(reward, done)` to the API, which the runner would call in training mode but not in test mode.

Please let me know your thoughts on the best way to put agents and environments into a loop in the most reusable way possible.

Cheers,
Ben

bstriner, 2016-12-29:
In cem.py, should `num_steps` be `env.timestep_limit` instead of `200`?

cem.py is an interesting example because it learns over batches of agents. The most common Gym use-case is probably running a single agent and learning each timestep. Maybe second-most common is running single agents or batches of agents and learning at the end of each episode. A handful of configurations would probably cover the majority of situations and eliminate a lot of boilerplate. Changes like timestep_limit could be managed centrally without changing user code.

examples/agents/tabular_q_agent.py looks interesting but there isn't any code to run it. I might add a main like in the other example agents.

BTW, cem.py is using the old Monitor API.

Thanks,
Ben

futurely, 2017-01-02:
The Monitor API has been updated in https://github.com/openai/gym/pull/453.

futurely, 2017-01-02:
"rllab is a framework for developing and evaluating reinforcement learning algorithms, fully compatible with OpenAI Gym. "
https://github.com/openai/rllab

bstriner, 2017-01-05:
Thanks @futurely and @tlbtlbtlb! rllab was the missing component in my mind.

So as I understand it now: roughly speaking, gym is for environments and rllab is for agents. Gym is stand-alone and provides some exemplary agents, but for additional work on agents, rllab is the openai sister project. I'll try working within rllab and raise any agent-related issues there.

Would it make sense to link rllab from the gym readme?

Something like: Gym provides a stand-alone environment for reinforcement learning but additional reinforcement learning agents and a framework for reinforcement learning may be found in the OpenAI sister project, [rllab](https://github.com/openai/rllab).

Cheers,
Ben

futurely, 2017-01-06:
Rllab has implemented many algorithms and is a good starting point. But its development was not very active recently.
https://github.com/openai/rllab/graphs/contributors
https://github.com/openai/rllab/graphs/commit-activity
https://github.com/openai/rllab/graphs/code-frequency

RL is hot today and choices are abundant.
https://github.com/search?o=desc&q=reinforcement+learning&s=stars&type=Repositories&utf8=%E2%9C%93

Some of the latest researches such as dueling network and prioritized replay are not always implemented in the most popular projects.
https://github.com/search?utf8=%E2%9C%93&q=Dueling+Network
https://github.com/search?q=Dueling+Network&type=Code&utf8=%E2%9C%93
https://github.com/search?utf8=%E2%9C%93&q=prioritized+replay
https://github.com/search?q=prioritized+replay&type=Code&utf8=%E2%9C%93

bstriner, 2017-01-06:
If rllab hasn't had enough recent activity, the release of Gym might be a good opportunity to renew interest. If I my goal is to implement the latest research in a reusable framework so other people can use it, maybe rllab is the thing to work on.

Making a standalone module for such-and-such algorithm is good and all, but I would rather be contributing to something bigger.

So, does implementing prioritized replay and dueling networks in rllab sound like a worthwhile project, or is there some better framework out there that we should be using?

Thanks,
Ben

tlbtlbtlb, 2017-01-06:
Universe-starter-agent is intended as a simple agent where you can rip out the algorithm and replace it with something like DQN with prioritized replay. But you could start from scratch too.
I don't think it's important to implement it as part of a particular framework now: if it works and produces better results on some environments, that'll be awesome.

Closed 2017-01-16.

Thread 468 (2017-01-24):

Creating GL Context

melrobin, 2017-01-24:
I am having problems getting a started with gym.  A very simple program fails when trying to load the GL context and I really do not know how to fix it:

[melrobin@scorpion ~]$ python test_gym.py
[2017-01-23 01:36:51,002] Making new env: CartPole-v0
Traceback (most recent call last):
  File "test_gym.py", line 5, in <module>
    env.render()
  File "/home/melrobin/packages/gym/gym/core.py", line 174, in render
    return self._render(mode=mode, close=close)
  File "/home/melrobin/packages/gym/gym/envs/classic_control/cartpole.py", line 113, in _render
    from gym.envs.classic_control import rendering
  File "/home/melrobin/packages/gym/gym/envs/classic_control/rendering.py", line 23, in <module>
    from pyglet.gl import *
  File "/usr/lib/python2.7/site-packages/pyglet/gl/__init__.py", line 236, in <module>
    import pyglet.window
  File "/usr/lib/python2.7/site-packages/pyglet/window/__init__.py", line 1817, in <module>
    gl._create_shadow_window()
  File "/usr/lib/python2.7/site-packages/pyglet/gl/__init__.py", line 205, in _create_shadow_window
    _shadow_window = Window(width=1, height=1, visible=False)
  File "/usr/lib/python2.7/site-packages/pyglet/window/xlib/__init__.py", line 163, in __init__
    super(XlibWindow, self).__init__(*args, **kwargs)
  File "/usr/lib/python2.7/site-packages/pyglet/window/__init__.py", line 516, in __init__
    context = config.create_context(gl.current_context)
  File "/usr/lib/python2.7/site-packages/pyglet/gl/xlib.py", line 188, in create_context
    return XlibContext13(self, share)
  File "/usr/lib/python2.7/site-packages/pyglet/gl/xlib.py", line 296, in __init__
    super(XlibContext13, self).__init__(config, share)
  File "/usr/lib/python2.7/site-packages/pyglet/gl/xlib.py", line 199, in __init__
    raise gl.ContextException('Could not create GL context')
pyglet.gl.ContextException: Could not create GL context

The program is a simple program that I cut and pasted:
import gym
env = gym.make('CartPole-v0')
env.reset()
for _ in range(1000):
    env.render()
    env.step(env.action_space.sample()) # take a random action

My graphics card is an NVIDIA GTX 980.

tlbtlbtlb, 2017-01-24:
Your X server isn't configured to run OpenGL. You can test by running `glxgears` or `glxinfo` at the command prompt (the first one should show spinning gears, the second will give a dump of OpenGL details). If you're using Ubuntu, see https://en.wikibooks.org/wiki/OpenGL_Programming/Installation/Linux

melrobin, 2017-01-24:
OK, this was indeed the problem.  I ran the program on the console with no issues.

livey, 2017-11-29:
use nvidia-xconfig solved the problem
http://uk.download.nvidia.com/XFree86/Linux-x86_64/256.44/README/editxconfig.html

CodArs-van, 2018-04-01:
@livey Could you be more specific on how you solved the problem?

livey, 2018-04-03:
@CodArs-van  just use the command nvidia-xconfig

JobJob, 2018-10-23:
mac users see https://github.com/openai/gym/issues/462#issuecomment-432259137

kcang2, 2019-07-23:
Hi, sorry to reopen this issue. But I am still seeing this error although I run this on terminal.

`import click
import numpy as np
import gym
from simplepg.simple_utils import include_bias, weighted_sample

def point_get_action(theta, ob, rng=np.random):
    ob_1 = include_bias(ob)
    mean = theta.dot(ob_1)
    return rng.normal(loc=mean, scale=1.)

def cartpole_get_action(theta, ob, rng=np.random):
    ob_1 = include_bias(ob)
    logits = ob_1.dot(theta.T)
    return weighted_sample(logits, rng=rng)

@click.command()
@click.argument("env_id", type=str, default="Point-v0")
def main(env_id):
    # Register the environment
    rng = np.random.RandomState(42)

    if env_id == 'CartPole-v0':
        env = gym.make('CartPole-v0')
        get_action = cartpole_get_action
        obs_dim = env.observation_space.shape[0]
        action_dim = env.action_space.n
    elif env_id == 'Point-v0':
        from simplepg import point_env
        env = gym.make('Point-v0')
        get_action = point_get_action
        obs_dim = env.observation_space.shape[0]
        action_dim = env.action_space.shape[0]
    else:
        raise ValueError(
            "Unsupported environment: must be one of 'CartPole-v0', 'Point-v0'")

    env.seed(42)

    # Initialize parameters
    theta = rng.normal(scale=0.01, size=(action_dim, obs_dim + 1))

    while True:
        ob = env.reset()
        done = False
        # Only render the first trajectory
        # Collect a new trajectory
        rewards = []
        while not done:
            action = get_action(theta, ob, rng=rng)
            next_ob, rew, done, _ = env.step(action)
            ob = next_ob
            env.render()
            rewards.append(rew)

        print("Episode reward: %.2f" % np.sum(rewards))

if __name__ == "__main__":
    main()`

Here is the output:
`Traceback (most recent call last):
  File "simplepg/rollout.py", line 80, in <module>
    main()
  File "/opt/conda/envs/deeprlbootcamp/lib/python3.5/site-packages/click/core.py", line 722, in __call__
    return self.main(*args, **kwargs)
  File "/opt/conda/envs/deeprlbootcamp/lib/python3.5/site-packages/click/core.py", line 697, in main
    rv = self.invoke(ctx)
  File "/opt/conda/envs/deeprlbootcamp/lib/python3.5/site-packages/click/core.py", line 895, in invoke
    return ctx.invoke(self.callback, **ctx.params)
  File "/opt/conda/envs/deeprlbootcamp/lib/python3.5/site-packages/click/core.py", line 535, in invoke
    return callback(*args, **kwargs)
  File "simplepg/rollout.py", line 72, in main
    env.render()
  File "/opt/conda/envs/deeprlbootcamp/lib/python3.5/site-packages/gym/core.py", line 150, in render
    return self._render(mode=mode, close=close)
  File "/opt/conda/envs/deeprlbootcamp/lib/python3.5/site-packages/gym/core.py", line 286, in _render
    return self.env.render(mode, close)
  File "/opt/conda/envs/deeprlbootcamp/lib/python3.5/site-packages/gym/core.py", line 150, in render
    return self._render(mode=mode, close=close)
  File "/root/code/bootcamp_pg/simplepg/point_env.py", line 69, in _render
    from gym.envs.classic_control import rendering
  File "/opt/conda/envs/deeprlbootcamp/lib/python3.5/site-packages/gym/envs/classic_control/rendering.py", line 23, in <module>
    from pyglet.gl import *
  File "/opt/conda/envs/deeprlbootcamp/lib/python3.5/site-packages/pyglet/gl/__init__.py", line 236, in <module>
    import pyglet.window
  File "/opt/conda/envs/deeprlbootcamp/lib/python3.5/site-packages/pyglet/window/__init__.py", line 1816, in <module>
    gl._create_shadow_window()
  File "/opt/conda/envs/deeprlbootcamp/lib/python3.5/site-packages/pyglet/gl/__init__.py", line 205, in _create_shadow_window
    _shadow_window = Window(width=1, height=1, visible=False)
  File "/opt/conda/envs/deeprlbootcamp/lib/python3.5/site-packages/pyglet/window/xlib/__init__.py", line 163, in __init__
    super(XlibWindow, self).__init__(*args, **kwargs)
  File "/opt/conda/envs/deeprlbootcamp/lib/python3.5/site-packages/pyglet/window/__init__.py", line 515, in __init__
    context = config.create_context(gl.current_context)
  File "/opt/conda/envs/deeprlbootcamp/lib/python3.5/site-packages/pyglet/gl/xlib.py", line 186, in create_context
    return XlibContextARB(self, share)
  File "/opt/conda/envs/deeprlbootcamp/lib/python3.5/site-packages/pyglet/gl/xlib.py", line 296, in __init__
    super(XlibContext13, self).__init__(config, share)
  File "/opt/conda/envs/deeprlbootcamp/lib/python3.5/site-packages/pyglet/gl/xlib.py", line 199, in __init__
    raise gl.ContextException('Could not create GL context')
pyglet.gl.ContextException: Could not create GL context
`

FYI, this code was taken from [https://drive.google.com/open?id=0B1BwaUH2mk-EbktzeURrNktQVjQ](url)

JonathanLehner, 2022-06-19:
after running nvidia-xconfig you need to reboot or reload the config

Touutae-lab, 2022-07-30:
> Your X server isn't configured to run OpenGL. You can test by running `glxgears` or `glxinfo` at the command prompt (the first one should show spinning gears, the second will give a dump of OpenGL details). If you're using Ubuntu, see https://en.wikibooks.org/wiki/OpenGL_Programming/Installation/Linux

i still have the same problem Couldn't Create GL context even i can run that command

Closed 2017-01-24.

Thread 473 (2017-01-27):

Bad reward function on LunarLander

SamuelePolimi, 2017-01-27:
The robot receives a reward >100. in the position shown:
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

These are the last sequences of <state, action, reward, done,  info>:

('state: ', array([ 0.66872807,  0.31876364,  0.93155613, -1.29488436, -0.51435429,
        0.1669438 ,  0.        ,  0.        ]))
('action: ', 3)
('reward: ', -2.1935851844794727)
('done: ', False)
('info: ', {})
('state: ', array([ 0.67817574,  0.29887105,  0.93890667, -1.32398567, -0.50774068,
        0.13227191,  0.        ,  0.        ]))
('action: ', 2)
('reward: ', -2.1533557847858331)
('done: ', False)
('info: ', {})
('state: ', array([ 0.68794422,  0.27886062,  0.97039976, -1.33165029, -0.50046468,
        0.14552021,  0.        ,  0.        ]))
('action: ', 3)
('reward: ', -2.8515008774707256)
('done: ', False)
('info: ', {})
('state: ', array([ 0.69780025,  0.2584075 ,  0.98143816, -1.36203613, -0.4958019 ,
        0.09325559,  0.        ,  0.        ]))
('action: ', 1)
('reward: ', -0.98382723840089059)
('done: ', False)
('info: ', {})
('state: ', array([ 0.70758858,  0.23759413,  0.97278767, -1.38539073, -0.48901996,
        0.13563849,  0.        ,  0.        ]))
('action: ', 2)
('reward: ', -2.1572379230373029)
('done: ', False)
('info: ', {})
('state: ', array([ 0.71770306,  0.21670242,  1.00481367, -1.39043999, -0.48160586,
        0.14828198,  0.        ,  0.        ]))
('action: ', 3)
('reward: ', -2.5708908531227892)
('done: ', False)
('info: ', {})
('state: ', array([ 0.72787399,  0.19539009,  1.01184149, -1.41900749, -0.47577116,
        0.11669427,  0.        ,  0.        ]))
('action: ', 2)
('reward: ', 8.7827422640659272)
('done: ', False)
('info: ', {})
('state: ', array([ 0.73852997,  0.17441626,  1.05992413, -1.39633013, -0.46950805,
        0.12526217,  1.        ,  0.        ]))
('action: ', 2)
('reward: ', 124.30866382855071)
('done: ', False)
('info: ', {})

Also, there is the issue that when the robot is in the right position (so standing between the flags, landing softly, and remaining in that position), it doesn't receive the correct reward and neither the episode finishes.

olegklimov, 2017-01-28:
This is a correct reward. It is received because hitting a mountain with the leg reduces speed.

You just hit one of things that makes this environment interesting. I've observed agents that try to exploit this bad minima at first, by falling down with great speed, one of legs forward. Good agent eventually gets out of it.

When lander is in the right position and shuts down engines, episode reliably ends. This is tested a lot. Episode ends sometimes even with engines still working, good agent learns how to power down engines from probability of that happening.

I can also assure you there are algorithms that solve this problem, that is one of the most simple tasks in Gym. Working solution should take less than 1M, very good solutions 2M frames.

SamuelePolimi, 2017-01-28:
I trust you, but honestly, it doesn't seem to me a good idea to give such an high reward in that position. I hope that in NASA they don't consider it a good landing too.
While a lot of time my lander lands in a good position, and it doesn't receive any reward higher than 100.
In my own opinion this is a bit wired.
I am using this environment from a while, and I saw it working properly. Then probably I updated something, and now it is no working anymore.

olegklimov, 2017-01-28:
Please note that in order to get positive reward for losing speed, you first get a lot of negative reward for gaining speed.

DollarAkshay, 2019-04-29:
@olegklimov

> Working solution should take less than 1M, very good solutions 2M frames.

Why would a very good solution take more frames than a working solution ? And here when you say !m, you mean 1 million frames ?

Closed 2017-05-16.

Thread 509 (2017-02-24):

How can i deal with 'libGL error: failed to load driver: swrast.'

lfwin, 2017-02-24:
I am using a xrdp remote connecting to a Ubuntu14.04 desktop machine, which successfully installed tensorflow and caffe.
After i install gym and run
`import gym
env = gym.make('CartPole-v0')
env.reset()
for _ in range(1000):
    env.render()
    env.step(env.action_space.sample()) # take a random action`

libGL error occurs.
using "LIBGL_DEBUG=verbose glxgears" , it outputs:
`libGL: screen 0 does not appear to be DRI3 capable
libGL: OpenDriver: trying /usr/lib/x86_64-linux-gnu/dri/tls/swrast_dri.so
libGL: OpenDriver: trying /usr/lib/x86_64-linux-gnu/dri/swrast_dri.so
libGL: driver does not expose __driDriverGetExtensions_swrast(): /usr/lib/x86_64-linux-gnu/dri/swrast_dri.so: undefined symbol: __driDriverGetExtensions_swrast
libGL: Can't open configuration file /home/lfwin/.drirc: No such file or directory.
libGL: Can't open configuration file /home/lfwin/.drirc: No such file or directory.
3751 frames in 5.0 seconds = 750.148 FPS
4278 frames in 5.0 seconds = 855.515 FPS`

I googled, but need reinstall nvidia drivers.

EDIT: After i update nvidia drivers, it works  in local Ubuntu14.04 desktop machine, but still have error in remote connection

tlbtlbtlb, 2017-02-24:
Can you give more detail on what the current problem is?

lfwin, 2017-02-24:
Hi, tlbtlbtlb
Now, the problem is when running on remote computer using xrdp,
`
import pdb
import gym
env = gym.make('CartPole-v0')
env.reset()
for _ in range(1000):
    env.render()
    #pdb.set_trace()
    env.step(env.action_space.sample()) # take a random action
    print("success")
`
 this error below happens:
"
libGL error: failed to load driver: swrast
Traceback (most recent call last):
  File "/home/lfwin/workspace/homework/hw1/test_gym.py", line 7, in <module>
    env.render()
  File "/usr/local/lib/python2.7/dist-packages/gym/core.py", line 174, in render
    return self._render(mode=mode, close=close)
  File "/usr/local/lib/python2.7/dist-packages/gym/envs/classic_control/cartpole.py", line 142, in _render
    return self.viewer.render(return_rgb_array = mode=='rgb_array')
  File "/usr/local/lib/python2.7/dist-packages/gym/envs/classic_control/rendering.py", line 84, in render
    self.window.dispatch_events()
  File "/usr/local/lib/python2.7/dist-packages/pyglet/window/xlib/__init__.py", line 840, in dispatch_events
    self.dispatch_pending_events()
  File "/usr/local/lib/python2.7/dist-packages/pyglet/window/xlib/__init__.py", line 880, in dispatch_pending_events
    EventDispatcher.dispatch_event(self, *self._event_queue.pop(0))
  File "/usr/local/lib/python2.7/dist-packages/pyglet/event.py", line 365, in dispatch_event
    if getattr(self, event_type)(*args):
  File "/usr/local/lib/python2.7/dist-packages/pyglet/window/__init__.py", line 722, in on_resize
    gl.glOrtho(0, width, 0, height, -1, 1)
  File "/usr/local/lib/python2.7/dist-packages/pyglet/gl/lib.py", line 104, in errcheck
    raise GLException(msg)
pyglet.gl.lib.GLException: invalid value
"

but if i run locally in ubuntu14.04  computer, all goes right!!

tlbtlbtlb, 2017-02-24:
You need the swrast driver installed for OpenGL rendering to work in headless mode. Typically, `apt-get intall -y mesa-utils and libgl1-mesa-glx` will do it. But if you have proprietary video drivers installed, it may take some googling to find the answer.

lfwin, 2017-02-25:
Hi,
I run test LIBGL_DEBUG=verbose glxinfo|grep renderer, it outputs
PowerEdge-R730:~$ LIBGL_DEBUG=verbose glxinfo|grep renderer
libGL: OpenDriver: trying /usr/lib/x86_64-linux-gnu/dri/tls/swrast_dri.so
libGL: OpenDriver: trying /usr/lib/x86_64-linux-gnu/dri/swrast_dri.so
libGL: driver does not expose __driDriverGetExtensions_swrast(): /usr/lib/x86_64-linux-gnu/dri/swrast_dri.so: undefined symbol: __driDriverGetExtensions_swrast
libGL: Can't open configuration file /home/lfwin/.drirc: No such file or directory.
libGL: Can't open configuration file /home/lfwin/.drirc: No such file or directory.
libGL error: failed to load driver: swrast

and swarast_dri.so can be find  as follows.
PowerEdge-R730:~$ locate swrast_dri.so
/usr/lib/i386-linux-gnu/dri/swrast_dri.so
/usr/lib/x86_64-linux-gnu/dri/swrast_dri.so

Also, video drivers, mesa-utils and libgl1-mesa-glx all upgraded.

tlbtlbtlb, 2017-02-25:
It's a common problem with Ubuntu 14.04 and nVidia drivers. Easy solutions are to uninstall the nvidia drivers, or upgrade to Ubuntu 16.04. Many other solutions at https://encrypted.google.com/search?hl=en&q=driver%20does%20not%20expose%20__driDriverGetExtensions_swrast

frankcarey, 2017-04-02:
Note: I fixed this by using nvidia-docker instead

allenyllee, 2017-10-31:
Based on the dockerfile of nvidia/cuda, I can solve this problem.
https://gitlab.com/nvidia/cuda/blob/ubuntu16.04/8.0/runtime/Dockerfile

Or you can just use it with nvidia-docker to create another container run all the stuff without touching your OS environments.

ruapotato, 2018-07-02:
Wait so I'm seeing this in a basic chroot (drivers installed on the host and chroot.. trying to load steam)
what part of the Nvidia docker is fixing this? I don't want to use docker but I want 3d drivers.

carlsummer, 2018-10-20:
VMware Ubuntu

2018/10/20 12:53:47 I1020 12:53:47.639172 3702 gymvnc.go:550] [0:localhost:5900] connection established
libGL error: unable to load driver: vmwgfx_dri.so
libGL error: driver pointer missing
libGL error: failed to load driver: vmwgfx
libGL error: unable to load driver: swrast_dri.so
libGL error: failed to load driver: swrast
Traceback (most recent call last):
universe-iizbj6-0 | [tigervnc]  SConnection: Client needs protocol version 3.8
universe-iizbj6-0 | [tigervnc]  SConnection: Client requests security type VncAuth(2)

BuhuanJin, 2020-04-19:
When on CentOS7:
yum install -y mesa-libGLw-devel.x86_64

boogert-lab, 2020-07-23:
Thanks  BuhuanJin, this solved a lot of problems.

itayave, 2020-10-08:
I deal with it in Redhat-8.2 (aarch64) with installing the mesa driver:

sudo dnf install -y mesa-dri-drivers

rohanjuneja, 2021-02-20:
I am receiving a similar issue, and it did't resolved even after updating mesa drivers. Kindly could you please help me with this?
Output of glxgears:
libGL error: No matching fbConfigs or visuals found
libGL error: failed to load driver: swrast
X Error of failed request:  BadValue (integer parameter out of range for operation)
  Major opcode of failed request:  149 (GLX)
  Minor opcode of failed request:  3 (X_GLXCreateContext)
  Value in failed request:  0x0
  Serial number of failed request:  28
  Current serial number in output stream:  30

samlaf, 2021-04-27:
For future reference, you can run your programs with the prefix `LIBGL_DEBUG=verbose` to get debug output.
See https://askubuntu.com/a/566522

bsprime, 2021-07-12:
> You need the swrast driver installed for OpenGL rendering to work in headless mode. Typically, `apt-get intall -y mesa-utils and libgl1-mesa-glx` will do it. But if you have proprietary video drivers installed, it may take some googling to find the answer.

Gazebo on ubuntu, NVIDIA graphics card.
I have encountered this problem while launching gazebo which was installed with ROS neotic.
`sudo apt-get intall -y mesa-utils and libgl1-mesa-glx` has fixed this problem

Jamlee, 2022-11-06:
When on CentOS7:
yum install -y mesa-libGLw-devel.x86_64 # not work

yum install -y mesa-dri-drivers # worked for me

Tectract, 2023-01-13:
commmenting for posterity only to help anyone who lands here

For me, I was working on an old ubuntu 14.04 box, after a motherboard replacement and much messing around with the graphics drivers, which for me were old mesa drivers.

I got out my old backup archive HD for this machine and it had a different libGL.so.0.1.2.0 for me to try, in /usr/lib/fglrx

pointing my system /usr/lib/libGL.so and /usr/lib/libGL.so.1 files in a symlink to this /usr/lib/fglrx/libGLS.so.0.1.2.0 worked for me to restore headless libGL working again on this old machine. So if you are getting this error it means you are likely using the wrong version of libGL.so for your machine to load the swrast libs.

18611429192, 2024-05-23:
> When on CentOS7: yum install -y mesa-libGLw-devel.x86_64

yeah, thanks. You help me a lot.

Closed 2017-02-24.

Thread 550 (2017-04-04):

changing screen size of the rendered environments

julian-ramos, 2017-04-04:
Hi all,

First of, this is not an issue but a request/question I guess this would be a more relevant question for stackoverflow but my guess is that it may be harder to get an answer there. For a very specific application I'm working on the current screen size of the environment produced by the atari environment is way to small, is there any way to modify the screen size without modifying atary_py?

I checked in atary_py and could not find a way to do it there.

tlbtlbtlb, 2017-04-04:
Indeed, on Retina Macs the image is kinda hard to see. The logic is in `gym.envs.classic_control.rendering.SimpleImageViewer` at  https://github.com/openai/gym/blob/master/gym/envs/classic_control/rendering.py#L315 if someone wants to make an attempt at enlarging it. As a proposed policy:
```
  if is_retina:
    scale = max(1, 1000//max(width, height))
  else:
    scale = max(1, 500//max(width, height))
```

andrewschreiber, 2017-04-19:
Investigating this issue. Turns out that using `pyglet` to get screen resolution on a Retina screen results in scaled, not true dimensions.

```
import pyglet
platform = pyglet.window.get_platform()
display = platform.get_default_display()
screen = display.get_default_screen()
screen
// CocoaScreenMode(width=1280, height=800, depth=32, rate=0.0)
```
Now searching for other means of detecting a scaled screen. The pyglet team seems aware of this issue, perhaps we can use [their fix](https://bitbucket.org/pyglet/pyglet/commits/c6c387c)...

julian-ramos, 2017-04-19:
Hi all,

I actually found the next fix, not sure where I found it but it works
```

from gym.envs.classic_control import rendering
def repeat_upsample(rgb_array, k=1, l=1, err=[]):
    # repeat kinda crashes if k/l are zero
    if k <= 0 or l <= 0:
        if not err:
            print "Number of repeats must be larger than 0, k: {}, l: {}, returning default array!".format(k, l)
            err.append('logged')
        return rgb_array

    # repeat the pixels k times along the y axis and l times along the x axis
    # if the input image is of shape (m,n,3), the output image will be of shape (k*m, l*n, 3)

    return np.repeat(np.repeat(rgb_array, k, axis=0), l, axis=1)

viewer = rendering.SimpleImageViewer()
env = gym.make(mapName)
env.reset()
action=0
while run:
    rgb = env.render('rgb_array')
    upscaled=repeat_upsample(rgb,4, 4)
    viewer.imshow(upscaled)
    observation, reward, done, info = env.step(action)

```

andrewschreiber, 2017-04-19:
Okay, glad to hear it. @tlbtlbtlb let me know if you're still interested in a solution within Gym itself.

Closed 2017-04-19.

Thread 585 (2017-05-09):

Descriptions of action spaces & observation spaces

econti, 2017-05-09:
Do descriptions of different environment's action spaces & observation spaces exist anywhere? For example, with Humanoid-V1 the action space is a 17-D vector that presumably maps to different body parts, but are these numbers torques, angles, etc.? Same goes with the observation space - a brief description of what the 376 dimensions correspond to would be incredibly useful to know.

olegklimov, 2017-05-09:
You don't want to know this, unless you're engineering (as opposed to learning) a solution.

If you still need to know which is which, just try those actions one by one, watch the robot.

stevenschmatz, 2017-05-11:
A description could still be useful to understand what the RL algorithm learned.

econti, 2017-05-12:
I see your point @olegklimov, but to @stevenschmatz's point, just for the sake of understanding what your network has learned, it helps to know some detail about the action space and observation space. I do agree with you though that you technically don't need to know these details if you're learning a solution.

filmo, 2017-07-02:
I'm with @econti. I think a description would be good. There may be a case where we want to neutralize certain actions or parts of the observed state space and it's far easier to zero them out if we could consult a description table than to iterate through them all to manually figure them out.

@olegklimov is of course right in that it's not needed for RL learning, but I disagree that there isn't a valid use-case.

erwincoumans, 2018-03-02:
For the Ant, the observation is:
~~~~~~
 def _get_obs(self):
        return np.concatenate([
            self.sim.data.qpos.flat[2:],
            self.sim.data.qvel.flat,
            np.clip(self.sim.data.cfrc_ext, -1, 1).flat,
        ])
~~~~~~
self.sim.data.qpos are the positions, with the first 7 element the 3D position (x,y,z) and orientation (quaternion x,y,z,w) of the torso, and the remaining 8 positions are the joint angles.

The [2:], operation removes the first 2 elements from the position, which is the X and Y position of the agent's torso.

self.sim.data.qvel are the velocities, with the first 6 elements the 3D velocity (x,y,z) and 3D angular velocity (x,y,z) and the remaining 8 are the joint velocities.

The cfrc_ext are the external forces (force x,y,z and torque x,y,z) applied to each of the links at the center of mass. For the Ant, this is 14*6: the ground link, the torso link, and 12 links for all legs (3 links for each leg).

For the Humanoid, the observation adds some more fields:
~~~~~~
def _get_obs(self):
        data = self.sim.data
        return np.concatenate([data.qpos.flat[2:],
                               data.qvel.flat,
                               data.cinert.flat,
                               data.cvel.flat,
                               data.qfrc_actuator.flat,
                               data.cfrc_ext.flat])
~~~~~~

The qfrc_actuator are likely the actuator forces. cinert seems the center of mass based inertia and cvel the center of mass based velocity.

You can track the meaning of the actual joints from the xml file, but it requires some effort. For the humanoid, my PyBullet script that reads the MuJoCo XML file gives:

~~~~~~
b'abdomen_z'
b'abdomen_y'
b'abdomen_x'
b'right_hip_x'
b'right_hip_z'
b'right_hip_y'
b'right_knee'
b'right_ankle_y'
b'right_ankle_x'
b'left_hip_x'
b'left_hip_z'
b'left_hip_y'
b'left_knee'
b'left_ankle_y'
b'left_ankle_x'
b'right_shoulder1'
b'right_shoulder2'
b'right_elbow'
b'left_shoulder1'
b'left_shoulder2'
b'left_elbow'
~~~~~~

stevenschmatz, 2018-03-14:
I think this will need to be done on a case-by-case basis with some documentation. I could get started on this issue this weekend.

benelot, 2018-05-23:
Maybe this helps to some of you:
-https://github.com/openai/mujoco-py/blob/master/mujoco_py/pxd/mjdata.pxd

There are smaller description at the side of each field and it tells you what it is computed by. Unfortunately, it might only help people working intensively with physics engines (like @erwincoumans).

QuXinghuaNTU, 2019-07-17:
Is there any document that describes such physical meaning of other environments (e.g., Walker2D, Hopper and HalfCheetah)? The humanoid in pybullet has 44 dimensions in state space, but only 21 of them are explained in physical meaning. Does that mean some dimensions are unknown with respect to the physical meaning? Additionally, the xml file for urdf is a little bit hard to read.

ajithvallabai, 2020-05-26:
Is there explanation for Walker2D like this https://github.com/openai/gym/wiki/Humanoid-V1 . In xml file only 9 are there other parameters are not there .Totaly there are 22 . @QuXinghuaNTU  were u able to find it

QuXinghuaNTU, 2020-05-28:
> Is there explanation for Walker2D like this https://github.com/openai/gym/wiki/Humanoid-V1 . In xml file only 9 are there other parameters are not there .Totaly there are 22 . @QuXinghuaNTU were u able to find it

Hi,
Indeed, there are some parameters that are unknown of their physical meaning.
I tried to find such documents but failed.
One possible way (from my side) to know the exact meaning of each dimension is by playing the agent with changing the value of each dimension. That, however, is quite time-consuming. Due to I have moved to Atari for a period, it's hard for me to help you on that currently.
If someday I come back to Mujoco, I will post the results here then.
Stay safe and good luck with your research

ryanmaxwell96, 2020-07-07:
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

Can you clarify this? There are 29 observations I believe, but I tried adding up the number you were referring to and got at least 35. For example, what do you mean by 14*6?

ryanmaxwell96, 2020-07-07:
Specifically, I'd really like to know what the state[2] is referring to since that is the one that is triggering the "notdone" signal for Antv2

ryanmaxwell96, 2020-07-07:
I think that is because of parameters .2 and 1 the line:
notdone = np.isfinite(state).all() \
            and state[2] >= 0.2 and state[2] <= 1.0
In ant.py. If I change 0.2 to 0.4 and 1.0 to 2.0, it starts to clearly die if it flips over

ryanmaxwell96, 2020-07-08:
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

My bad. The obs just include qpos and qvel which normally adds up to 29 but the [2:] brings it down to 27. So apparently the contact forces are not actually apart of the observations I think.

ryanmaxwell96, 2020-07-10:
Can someone tell me where each observation is in the 27 length vector? Specifically, which are the observations for each of the joints? (i.e.  Which ones are the left back leg joints, left front leg joints, etc.)

ryanmaxwell96, 2020-07-10:
> Can someone tell me where each observation is in the 27 length vector? Specifically, which are the observations for each of the joints? (i.e. Which ones are the left back leg joints, left front leg joints, etc.)

Ok, so I was not able to figure it out through the code, but I locked each leg in succession and identified which part of the observation was moving. Here are my results:

(Front looking to the right)
Pos (Torso)
0 x

1 y

2 z

Orient (Torso)
3 x

4 y

5 z

6 w

joint angles
7 1 Front left leg hip angle <---

8 2 Front left leg ankle angle <---

9 3 Back left leg hip angle <---

10 4 Back left leg ankle angle <---

11 5 Back left leg hip angle <---

12 6 Back right leg ankle angle <---

13 7 Front right leg hip angle <---

14 8 Front right leg ankle angle <---

Vel (Torso)

15 x

16 y

17 z

Angular Vel (Torso)
18 x

19 y

20 z

joint vel
21 1 Front left leg hip angle <---

22 2 Front left leg ankle angle <---

23 3 Back left leg hip angle <---

24 4 Back left leg ankle angle <---

25 5 Back right leg hip angle <---

26 6 Back right leg ankle angle <---

27 7 Front right leg hip angle <---

28 8 Front right leg ankle angle <---

caffett, 2020-08-03:
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

Why are there 29 variables...

QuXinghuaNTU, 2020-08-04:
Your index starts from 0. That's why there are totally 29 variables.

caffett, 2020-08-04:
> Your index starts from 0. That's why there are totally 29 variables.

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

Is not 27 variables...

27 7 Front right leg hip angle
28 8 Front right leg ankle angle

always unchange?

caffett, 2020-08-04:
https://atomscott.github.io/football/ruby/2019/06/28/Understanding-the-Environment.html This might be useful.

ryanmaxwell96, 2020-08-25:
I disagree that the input action is torque between +1 and -1. For one, I just did a test and I had one value over 1 (1.7). Plus, I can lock legs by setting them to 0.2. If this was torque, a value of 0.2 should not be locking anything. So it seems like it is position instead. Can someone confirm?

ryanmaxwell96, 2020-08-25:
Nevermind. I agree that it is torque now. It was getting stuck at the boundaries specified in ant.xml

fhln, 2020-09-14:
> I disagree that the input action is torque between +1 and -1. For one, I just did a test and I had one value over 1 (1.7). Plus, I can lock legs by setting them to 0.2. If this was torque, a value of 0.2 should not be locking anything. So it seems like it is position instead. Can someone confirm?

The ctrl range is limited between -1 and +1 whether the input is. And strictly speaking, the input action is not torque but torque*150, because of gear definition in ant.xml. More information of these actuators' definition can be found in  http://mujoco.org/book/XMLreference.html#actuator

ferreirafabio, 2020-12-22:
> You don't want to know this, unless you're engineering (as opposed to learning) a solution.
>
> If you still need to know which is which, just try those actions one by one, watch the robot.

Are you completely serious or are you trolling? If you’re serious, let me be serious and straightforward: your response is complete BS. Of course the thread opener wants to know this if he/she is asking for it. Notice that we lack even an overview of some meta features of the Mujoco environments such as „is the action space discrete or continuous?“, „how many dimensions does it have?“, „is it one-hot-encoded?“, or „which joint am I controlling with dimension x?“ and so on.

Dolokhow, 2021-04-23:
> ... Is it the z level of the torso, but this is confusing because new episodes are not triggered when the Ant flips over?

Hi! I am having trouble understanding what you meant by new episodes not being triggered when the ant flips over. I unfortunately do not have access to MuJoCo so I cannot test this myself, but the answer to the following question is critical for me: Does the episode terminate immediately as the ant flips over, or is there a certain period when the ant is flipped over and we are waiting for it to recover? Judging by your very next response it seems to be the latter. Could you please confirm this?

ryanmaxwell96, 2021-04-23:
Hey! I believe the when the ant torso gets closer than some threshold to the ground, the episode immediately restarts. I think you can see this in the ant.py file where z=state[2]

Dolokhow, 2021-04-23:
Got it, thanks!

desueto, 2022-01-21:
Hi everyone! I'm kinda stuck in the same problem: I would like to control a robotic EE in position only, so I wrote in the actuator part of XML code <position> and all the magic stuff needed. The problem I encounter is that during RL the action is sampled in the ctrlrange butI would like to have the whole joint space while keeping a limited action sample. Is that any way to solve this stuff? Thanks!

PBarde, 2022-03-14:
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

Hi @erwincoumans, does your script work for all the gym-mujoco envs? If yes I'd be really interested in it, is it publicly available?
Thanks!

BenGravell, 2023-12-29:
In case anyone from the future stumbles on this thread.

As of December 29, 2023 the following are true:

https://www.gymlibrary.ml/ is broken, presumably deprecated in favor of https://gymnasium.farama.org.

The new gymnasium docs include tables for the complete action and observation spaces. e.g. `Ant` https://gymnasium.farama.org/environments/mujoco/ant/ looks something like this:

Action Space

| Num | Action                                                | Control Min | Control Max | Name (in corresponding XML file) | Joint | Unit        |
|-----|-------------------------------------------------------|-------------|-------------|----------------------------------|-------|-------------|
| 0   | Torque applied on the rotor between the torso and back right hip | -1          | 1           | hip_4 (right_back_leg)           | hinge | torque (N m) |
| 1   | Torque applied on the rotor between the back right two links | -1          | 1           | angle_4 (right_back_leg)         | hinge | torque (N m) |
| 2   | Torque applied on the rotor between the torso and front left hip | -1          | 1           | hip_1 (front_left_leg)           | hinge | torque (N m) |
| 3   | Torque applied on the rotor between the front left two links | -1          | 1           | angle_1 (front_left_leg)         | hinge | torque (N m) |
| 4   | Torque applied on the rotor between the torso and front right hip | -1          | 1           | hip_2 (front_right_leg)          | hinge | torque (N m) |
| 5   | Torque applied on the rotor between the front right two links | -1          | 1           | angle_2 (front_right_leg)        | hinge | torque (N m) |
| 6   | Torque applied on the rotor between the torso and back left hip | -1          | 1           | hip_3 (back_leg)                 | hinge | torque (N m) |
| 7   | Torque applied on the rotor between the back left two links | -1          | 1           | angle_3 (back_leg)               | hinge | torque (N m) |

Observation Space

| Num      | Observation                                          | Min  | Max  | Name (in corresponding XML file) | Joint | Unit                |
|----------|------------------------------------------------------|------|------|----------------------------------|-------|---------------------|
| 0        | z-coordinate of the torso (centre)                   | -Inf | Inf  | torso                            | free  | position (m)        |
| 1        | x-orientation of the torso (centre)                  | -Inf | Inf  | torso                            | free  | angle (rad)         |
| 2        | y-orientation of the torso (centre)                  | -Inf | Inf  | torso                            | free  | angle (rad)         |
| 3        | z-orientation of the torso (centre)                  | -Inf | Inf  | torso                            | free  | angle (rad)         |
| 4        | w-orientation of the torso (centre)                  | -Inf | Inf  | torso                            | free  | angle (rad)         |
| 5        | angle between torso and first link on front left     | -Inf | Inf  | hip_1 (front_left_leg)           | hinge | angle (rad)         |
| 6        | angle between the two links on the front left        | -Inf | Inf  | ankle_1 (front_left_leg)         | hinge | angle (rad)         |
| 7        | angle between torso and first link on front right    | -Inf | Inf  | hip_2 (front_right_leg)          | hinge | angle (rad)         |
| 8        | angle between the two links on the front right       | -Inf | Inf  | ankle_2 (front_right_leg)        | hinge | angle (rad)         |
| 9        | angle between torso and first link on back left      | -Inf | Inf  | hip_3 (back_leg)                 | hinge | angle (rad)         |
| 10       | angle between the two links on the back left         | -Inf | Inf  | ankle_3 (back_leg)               | hinge | angle (rad)         |
| 11       | angle between torso and first link on back right     | -Inf | Inf  | hip_4 (right_back_leg)           | hinge | angle (rad)         |
| 12       | angle between the two links on the back right        | -Inf | Inf  | ankle_4 (right_back_leg)         | hinge | angle (rad)         |
| 13       | x-coordinate velocity of the torso                   | -Inf | Inf  | torso                            | free  | velocity (m/s)      |
| 14       | y-coordinate velocity of the torso                   | -Inf | Inf  | torso                            | free  | velocity (m/s)      |
| 15       | z-coordinate velocity of the torso                   | -Inf | Inf  | torso                            | free  | velocity (m/s)      |
| 16       | x-coordinate angular velocity of the torso           | -Inf | Inf  | torso                            | free  | angular velocity (rad/s) |
| 17       | y-coordinate angular velocity of the torso           | -Inf | Inf  | torso                            | free  | angular velocity (rad/s) |
| 18       | z-coordinate angular velocity of the torso           | -Inf | Inf  | torso                            | free  | angular velocity (rad/s) |
| 19       | angular velocity of angle between torso and front left link | -Inf | Inf  | hip_1 (front_left_leg)           | hinge | angle (rad)         |
| 20       | angular velocity of the angle between front left links | -Inf | Inf  | ankle_1 (front_left_leg)         | hinge | angle (rad)         |
| 21       | angular velocity of angle between torso and front right link | -Inf | Inf  | hip_2 (front_right_leg)          | hinge | angle (rad)         |
| 22       | angular velocity of the angle between front right links | -Inf | Inf  | ankle_2 (front_right_leg)        | hinge | angle (rad)         |
| 23       | angular velocity of angle between torso and back left link | -Inf | Inf  | hip_3 (back_leg)                 | hinge | angle (rad)         |
| 24       | angular velocity of the angle between back left links | -Inf | Inf  | ankle_3 (back_leg)               | hinge | angle (rad)         |
| 25       | angular velocity of angle between torso and back right link | -Inf | Inf  | hip_4 (right_back_leg)           | hinge | angle (rad)         |
| 26       | angular velocity of the angle between back right links | -Inf | Inf  | ankle_4 (right_back_leg)         | hinge | angle (rad)         |
| excluded | x-coordinate of the torso (centre)                   | -Inf | Inf  | torso                            | free  | position (m)        |
| excluded | y-coordinate of the torso (centre)                   | -Inf | Inf  | torso                            | free  | position (m)        |

I say "something like" because a straight copy-paste of the tables from https://gymnasium.farama.org/environments/mujoco/ant/ into the GitHub comment editor did not work, so I asked ChatGPT to convert from HTML to a Markdown compatible table, and that's what I pasted here. There could be translation errors, but I'm not inclined to waste time poring over it, it's close enough to get the main idea that the details that were missing years ago have been filled in.

@jkterry1 Thanks to the maintainers for keeping gym alive & documented!

Closed 2022-03-14.

Thread 659 (2017-07-16):

Classic control `render(mode='rgb_array', close=True)` returns `None`

denizs, 2017-07-16:
# Short Version:

## Expected Behaviour
`env.render(mode='rgb_array', close=True)` returns a numpy array containing the raw pixel representation of the current state.

## Actual Behaviour
The call returns `None` for classic control `env`s leveraging `pyglet` to render, e.g. `CartPole-v0`, `MountainCar-v0`

## How to reproduce:
```python
env = gym.make('CartPole-v0')
env.reset()
obs = env.render(mode='rgb_array', close=True)
print(obs is None)  # >>> True
```

## Reason
The rgb values are extracted from the window `pyglet` renders to. Calling `render` with `close=True`, opening a window is omitted, causing the observation to be `None`.

## Consequences
All python-only `env`s rely on being executed on the main thread when learning from pixels (at least on OSX), as the os doesn't allow UI changes on sub processes. This makes them unsuitable for any parallel / asynchronous agents such as A3C.

## Question
Is there any possibility to make `render(mode='rgb_array', close=True)` work for cc `env`s by e.g. directly writing the changes to an image buffer, making it suitable for A3C and other agents relying on multiple subprocesses?

## Related Issues:
#347

# Slightly less short:

Hi all,
I'm currently working on multiple RL agents, including an A3C implementation, which I'd like use on classic control (cc) `env`s.

As those don't return their pixel representations as their observation, the agents retrieve the rgb values by calling `render(mode='rgb_array')` on the `env` instance.

Unfortunately, this fails for cc `env`s when being called on a subprocess as required by the A3C architecture, while working fine with e.g. `PongDeterministic-v3` and other Atari environments.

Reviewing the implementation, I understand that all cc `env`s leverage pyglet to render to a window and then obtain the rgb values from it, causing python to crash in a parallel setting, as OSX doesn't allow UI operations on sub processes.

After some research, I found #347 introducing the `close` argument of `render()`. Unfortunately it returns `None` for cc `env`s as those require a window to be open.

Is there any possibility to make `render(mode='rgb_array', close=True)` work for cc `env`s by e.g. directly writing the changes to an image buffer, making it suitable for A3C and other agents relying on multiple subprocesses?

I know that this is somewhat more a pyglet related issue, but in case someone can point me in the right direction, I'd be glad to put this into a PR. 🙂

Thanks in advance,
Deniz

A minimal setup to reproduce this would something like:

```python
import gym
from multiprocessing import Process

class Worker(Process):
    def __init__(self, env_name, name=None, render_rgb=False):
        Process.__init__(self, name=name)
        self.env = gym.make(env_name)
        self.env.reset()
        self.render_rgb = render_rgb
        print('Environment initialized. {}'.format(self.name))

    def run(self, render_rgb=False):
        for _ in range(100):
            action = self.env.action_space.sample()
            obs, reward, done, _ = self.env.step(action)
            print(obs)
            if self.render_rgb:
                observation = self.env.render(mode='rgb_array')
            if done:
                print('Done with an epsidode for {}'.format(self.name))
                self.env.reset()

class Agent(object):

    def __init__(self, env_name, num_env, render_rgb=False):
        assert num_env > 0, 'Number of environments must be postive.'
        self.num_env = num_env
        self.workers = []

        for env_idx in range(num_env):
            env_worker = Worker(env_name, name=str(env_idx),
                                   render_rgb=render_rgb)
            self.workers.append(env_worker)

        for w in self.workers:
            w.start()

        for w in self.workers:
            w.join()

if __name__ == '__main__':

    first = Agent('MountainCar-v0', 4, render_rgb=False)  # works

    second = Agent('PongDeterministic-v3', 4, render_rgb=True)  # works

    third = Agent('MountainCar-v0', 4, render_rgb=True)  # will fail
```

olegklimov, 2017-07-16:
You can't have picture without window open.

You don't need picture to learn classic envs.

To visualize learned policy, it works just fine.

Why this issue?

denizs, 2017-07-17:
I know, that I can learn from the observations provided `env.resest()` and `env.step()`, however I'd like my agent to learn from pixel input and not from physical states as it is the case for classic envs. 🙁

olegklimov, 2017-07-17:
You want continuous control from pixels? You best bet is Hopper (super easy task) for Roboschool. You can adjust camera angle in the code, to suit your needs.

Let me close this, nothing to fix.

denizs, 2017-07-17:
Ok thanks :)

sbhaaf, 2017-11-11:
This feature would also be useful if you're assembling the frames to visualize performance in, say, a Jupyter notebook hosted on remote device.

andrecavalcante, 2018-09-20:
This might help https://github.com/hardmaru/WorldModelsExperiments/blob/master/carracing/render_env.py

abagaria, 2019-11-26:
I am also looking for the same feature. Hopper and car-racing are continuous control environments. It would be valuable to be able to experiment with the classic control envs in Gym with pixel observations and without having to open a pyglet window (which slows down training immensely and precludes training on remotely on a cluster).

DuaneNielsen, 2020-01-01:
Gym is a set of TOY environments.  These are used for testing and debugging code that will later be deployed on bigger problems.

Cartpole-v0 is the most basic control problem, a discrete action space, with very low dimensionality and a nearly linear dynamics model.

This means your testing cycle is going to be MUCH shorter than hopper.  Beleive me, I've run both experiements and hopper is many times more complex an RL problem than any of the classic control problems.

Getting results faster means faster development times.

That's why as many features as possible around classic control problems are helpful.

BarisYazici, 2020-02-06:
If you just want to test your algorithm in a simple environment with pixel observations. I would recommend using [Pong-v0](https://gym.openai.com/envs/Pong-v0/) or similar Atari envs based on the documentation by default it supports RGB screen image observations. Action space is discrete as well which might help with training or testing your algorithm.

DuaneNielsen, 2020-02-07:
I agree, Pong-v0 is my first choice for testing with pixel inputs.

Dynamics of Pong is pretty non-linear though, because you have collisions.
Also the input distribution changes as you learn due to the opponent AI.
Pong also requires a little bit of exploration, whereas cartpole doesn't
require any.

All good!

To be honest, it's not hard at all to hack Pygame to give you pixel inputs,
or write your own cartpole simulator for that matter.

Perhaps I will do that and contribute to the project instead of banging on
about it on a github thread :)

On Thu, Feb 6, 2020 at 10:07 AM BarisYazici <notifications@github.com>
wrote:

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

--
Duane
Broadcom
480 760 1559

Closed 2017-07-17.

Thread 681 (2017-08-08):

env.action_space.sample() doesn't follow env.seed() ?

tylerlekang, 2017-08-08:
When I set env.seed(0) (or some other seed) I expected all random elements of env to produce deterministically. However, the env.action_space.sample() function still seems to output randomly.

```
a1 = []
a2 = []

env1 = gym.make('FrozenLake-v0')
env1.seed(0)

s1 = env1.reset()

for _ in range(4):
    a1.append(env1.action_space.sample())

env2 = gym.make('FrozenLake-v0')
env2.seed(0)

s2 = env2.reset()

for _ in range(4):
    a2.append(env2.action_space.sample())

print a1
print a2
```

produces different results for a1 and a2. For example:

```
[1, 0, 2, 2]
[0, 3, 2, 1]
```

Perhaps this was/is desired, but as mentioned above, I thought that setting env.seed() would override that.

koulanurag, 2017-08-08:
That's an acceptable behaviour. The idea of using a seed is to re-generate the same behaviour in case you would like to investigate.
Let's say we have script:
```
>>> import random
>>> random.random()
0.27949910319377835
>>> random.seed(10)
>>> random.random()
0.5714025946899135
>>> random.random()
0.4288890546751146
```

Now, If we run the script again, We will get the same behaviour after setting the same seed. However, if you look closely; the behaviour before setting the seed is different.

```
>>> import random
>>> random.random()
0.20718499743982566
>>> random.seed(10)
>>> random.random()
0.5714025946899135
>>> random.random()
0.4288890546751146
```

I hope this may help!

fjwolski, 2017-08-09:
see in gym source code how do spaces sample; e.g. https://github.com/openai/gym/blob/339415aa03a9b039a51f67798a44f8cd21464091/gym/spaces/box.py#L28-L29 they use separate random number generator that lives in gym.spaces.prng. If you want action / observation space to sample deterministically you will need to
```
from gym.spaces.prng import seed
seed(123)
```

tylerlekang, 2017-08-09:
OK, thanks for that info.

I was questioning if that should be the case, given a seemingly "overarching" nature of a simple line like env.seed(). BUT, if that is the way they want it to be done (or perhaps how it has to be done), I'm fine with that.

jfaleiro, 2019-02-16:
For newer versions use `env.action_space.np_random.seed(123)` - depending on the specific environment you might need `env.seed(123)` for a deterministic behavior.

orrp, 2022-02-24:
Is there a reason why `env.action_space.np_random.seed` is not set by `env.seed`?

RedTachyon, 2022-03-04:
@orrp I think the main reason is that `env.action_space.np_random` doesn't really have to be used often, and probably shouldn't be used for actual algorithms anyways, so it's only initialized when it's actually necessary. We already have the method `env.action_space.seed()`

Oh, and `env.seed` is deprecated now

DominikRoB, 2022-05-14:
@RedTachyon Can you point me to a place where the current handling of seeding is described?

I was just about to set up env.seed just to see here its deprecated?

stefanbschneider, 2022-07-26:
> For newer versions use env.action_space.np_random.seed(123) - depending on the specific environment you might need env.seed(123) for a deterministic behavior.

This means that any space can be seeded independent of an environment. Spaces optionally also take a seed during construction.

Closed 2017-08-09.

Thread 718 (2017-09-13):

Gym Docs Page Is Down

donamin, 2017-09-13:
Hi
https://gym.openai.com/docs
This address is not working.

TheShoutingParrot, 2017-09-13:
Me too. I just get redirected me he3e

Dudder, 2017-09-13:
Same here.

israelzuniga, 2017-09-13:
Both leaderboard and docs sites are down. Seems that now as OpenAI is fully focusing on the library:

[https://twitter.com/gdb/with_replies](https://twitter.com/gdb/with_replies)

gdb, 2017-09-13:
Yep, that's accurate — we'll do a static export of the site soon, but we really haven't maintained it at all, and the library is the focus of the project!

patrafter1999, 2017-09-14:
gym/universe is a truly great framework to experiment RL. Since the doc site is gone now, there is no way to read through all source codes when you try to find out about an environment such as available actions, game descriptions, etc. Although the site may not be perfect, it will be greatly appreciated if you can get the site back up as soon as possible. Great work!!

korroktheslavemaster, 2017-09-14:
https://scoreboard-site-1764008611.us-west-2.elb.amazonaws.com/
They just changed dns [https://twitter.com/gdb/status/908101501058400256](url)

superxingzheng, 2017-09-15:
The site is helpful when people want to look for best implementations or algorithms.

icoxfog417, 2017-09-15:
The leaderboard site is not only useful to share the training result, but also a good first challenge for the beginners to tackle with reinforcement learning.

I held the hands-on event for novices and its goal is to upload the agent to OpenAI Gym site. Many participants had a fun to do it. I understand it is not the main work of OpenAI, but it was so great feature. So I hope it'll keep on somewhere.

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

(Sorry for only Japanese)
https://github.com/icoxfog417/techcircle_openai_handson

gdb, 2017-09-15:
I have an update!

- Read-only export of the old site here: https://gym.openai.com/read-only.html. All the old links should work, and https://gym.openai.com will redirect to the Github repo. (Might still be some caching weirdness for the next hour or so.)
- @hardmaru is going try out setting up the wiki to allow people to submit scores (https://twitter.com/hardmaru/status/908121667854942209). This will be a community-maintained way of submitting scores, and hopefully will be better curated than the Gym site was!

I'm super appreciative that this thread exists — honestly we weren't sure whether there was enough demand to even make the read-only export worthwhile. Thanks everyone, and look forward to seeing how @hardmaru's setup works!

patrafter1999, 2017-09-15:
Thanks a million, gdb!!!!!!!!!!

patrafter1999, 2017-09-15:
The main links in https://gym.openai.com/read-only.html still lead us to
github site. However, https://scoreboard-site-1764008611.us-west-2.elb.
amazonaws.com/ works. I'm just happy with it.

On Fri, Sep 15, 2017 at 12:31 PM, Greg Brockman <notifications@github.com>
wrote:

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

benelot, 2017-09-18:
@hardmaru: If you need any help, just call me in!

ceobillionaire, 2017-09-30:
The Static export ( https://gym.openai.com/read-only.html  ) doesn't displays the env. videos and the learning performance curves are missing.

gdb, 2017-09-30:
I've checked internally. Sadly, there was a miscommunication about what was included in the static export during the shutdown of the old Gym infra. The production S3 bucket containing the videos and learning curves was deleted. This means that we no longer have copies of the videos and learning curves. Sorry for this — was definitely not our intention. On the plus side, all of that data was uploaded directly from clients, so people still may have the primary copy of what was lost.

The rest of the export is intact and isn't going anywhere.

jner14, 2017-11-03:
@gdb If it were me I would just take down the site completely.  As it is now it just reflects poorly on the OpenAI project which I'm personally a fan of.  It's very frustrating to not be able to access the site in its entirety.

benelot, 2017-11-04:
It is common practice for migration to put up a site in read-only mode. It
is not meant to be used any further except for taking the information and
reusing it somewhere else. I think a more community driven approach could
bebetter anyway.

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

dyelax, 2017-11-07:
Super disappointed about this. The ability to easily compare RL results on standardized environments was OpenAI's biggest contribution to the AI community IMO. Sad to see we are regressing in terms of transparency

jner14, 2017-11-07:
@dyelax , I agree.  It feels like they just used the community to get a jump start by taking the best algorithms or finding the best talent and now they don't need the rest of us anymore.

gdb, 2017-11-07:
As I said above, the Gym website never had a big impact, and so we never maintained it. The Gym library, on the other hand, has been very successful. As this thread is no longer about technical reports, I'm going to close it. Feel free to shoot me an email (gdb@openai.com) if you'd like to discuss anything directly.

Closed 2017-11-07.

Thread 828 (2018-01-17):

Observation returning null elements.

scottazord, 2018-01-17:
Hi All, when running the below application, i'm receiving a [null] observation list on env.reset().

I'm unsure how to go about debugging this, any tips?

```
# basic CartPole simulation

import gym
import universe  # register the universe environments

env = gym.make('gym-core.CartPole-v0') # create the environment
env.configure(remotes=1)  # automatically creates a local docker container

def basic_policy(obs): # determines what action to take
    angle = obs[2]
    return 0 if angle < 0 else 1

totals = [] # list of the total reward accumulated for each episode, 10

for episode in range(10):
    episode_rewards = 0 # the rewards for the episode, in this case just "staying alive" or running as long as possible
    obs = env.reset() # initial obersevation, carts horizontal positon (0.0 for center), carts velocity, pole angle, angular velocity (how fast the pole is falling)
    if obs[0] != None:
        action = 1 # move the cart left or right
        for step in range (500): # 1000 total steps, dont want to run forever
            action = basic_policy(obs) # perform an action based on the policy and oberserved env
            env.render()
            obs, reward, done, info = env.step(action) # update the oberservations and reward with the action
            episode_rewards += reward # add the reward at the current time step, 1 in this case
            if done:
                totals.append(episode_rewards)
                break
    else:
        print("empty")

print(totals)
print('The longest number of timesteps the pole was balanced: ' + str(max(totals)))

```

christopherhesse, 2019-09-28:
This sounds like a universe issue, and involves importing universe.  Since universe is no longer supported I will close this issue, please file a new one if this happens just using gym.

Closed 2019-09-28.

Thread 849 (2018-01-30):

Unable to install gym

HenryZhou7, 2018-01-30:
The command I tried to run is
```
pip install gym[all]
```
And it gave me the following output
```
$ pip install gym[all]
Collecting gym[all]
  Using cached gym-0.9.6.tar.gz
Requirement already satisfied: numpy>=1.10.4 in .../python2.7/site-packages (from gym[all])
Requirement already satisfied: requests>=2.0 in .../python2.7/site-packages (from gym[all])
Requirement already satisfied: six in .../python2.7/site-packages (from gym[all])
Requirement already satisfied: pyglet>=1.2.0 in .../python2.7/site-packages (from gym[all])
Requirement already satisfied: Box2D-kengz in .../python2.7/site-packages (from gym[all])
Requirement already satisfied: PyOpenGL in .../python2.7/site-packages (from gym[all])
Requirement already satisfied: atari_py>=0.1.1 in .../python2.7/site-packages (from gym[all])
Requirement already satisfied: Pillow in .../python2.7/site-packages (from gym[all])
Collecting mujoco_py>=1.50 (from gym[all])
  Using cached mujoco-py-1.50.1.34.tar.gz
    Complete output from command python setup.py egg_info:
    Traceback (most recent call last):
      File "<string>", line 1, in <module>
      File "/tmp/pip-build-14edRC/mujoco-py/setup.py", line 2, in <module>
        import importlib.util
    ImportError: No module named util

    ----------------------------------------
Command "python setup.py egg_info" failed with error code 1 in /tmp/pip-build-14edRC/mujoco-py/
```
Can someone help me right here?

hengyuan-hu, 2018-01-31:
try to use python3 and pip3 install. The importlib in python2 seems not compatible

HenryZhou7, 2018-01-31:
Thanks!

I tried with a python3.6 anaconda environment and can bypass that stage. However there is still error saying
```
The C compiler "/usr/bin/cc" is not able to compile a simple test program.

    It fails with the following output:

     Change Dir: /var/tmp/pip-build-9z2q4qq1/pachi-py/pachi_py/build/CMakeFiles/CMakeTmp
...
...
...
fatal error: error closing /tmp/ccFI003w.s: No space left on device
```
It says that there is no space left on device. But there are still hundreds of GBs on my mounted disk. What could be causing this problem? Thanks!

hengyuan-hu, 2018-01-31:
I cannot reproduce this error. In fact, when I try pip3 install gym[all], the installation just hangs at the mujoco installation step. Normally I develop RL stuff in linux and don't use conda so I am not very familiar with this issue.

This problem seems like a permission or system issue. You may want to search online for solution.

hungChien, 2018-03-23:
I used pip3 to install, but I just got stuck at the mujoco-py1.50 installation.I don't know where the problem is.

Accessant, 2018-03-23:
Ignore mujoco - it's the physics engine for 1/3 of the default games, but it's unneeded for the rest.

-------- Original Message --------
Subject: Re: [openai/gym] Unable to install gym (#849)
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

asdalow, 2018-11-22:
I get same error running this:
git clone https://github.com/openai/gym.git
cd gym
sudo pip3 install -e '.[all]'

How do I ignore mujoco?

Sandy4321, 2020-04-24:
please with this problem for windows 10
error is:
E:\WINPYTHON_FULL_apr22\WPy64-3770\scripts>pip install gym[all]
Requirement already satisfied: gym[all] in e:\winpython_full_apr22\wpy64-3770\python-3.7.7.amd64\lib\site-packages (0.17.1)
Requirement already satisfied: numpy>=1.10.4 in e:\winpython_full_apr22\wpy64-3770\python-3.7.7.amd64\lib\site-packages (from gym[all]) (1.18.2+mkl)
Requirement already satisfied: cloudpickle<1.4.0,>=1.2.0 in e:\winpython_full_apr22\wpy64-3770\python-3.7.7.amd64\lib\site-packages (from gym[all]) (1.3.0)
Requirement already satisfied: scipy in e:\winpython_full_apr22\wpy64-3770\python-3.7.7.amd64\lib\site-packages (from gym[all]) (1.4.1)
Requirement already satisfied: pyglet<=1.5.0,>=1.4.0 in e:\winpython_full_apr22\wpy64-3770\python-3.7.7.amd64\lib\site-packages (from gym[all]) (1.5.0)
Requirement already satisfied: six in e:\winpython_full_apr22\wpy64-3770\python-3.7.7.amd64\lib\site-packages (from gym[all]) (1.14.0)
Collecting atari-py~=0.2.0; extra == "all"
  Downloading atari_py-0.2.6-cp37-cp37m-win_amd64.whl (1.8 MB)
     |████████████████████████████████| 1.8 MB 656 kB/s
Collecting mujoco-py<2.0,>=1.50; extra == "all"
  Downloading mujoco-py-1.50.1.68.tar.gz (120 kB)
     |████████████████████████████████| 120 kB 6.8 MB/s
Collecting box2d-py~=2.3.5; extra == "all"
  Downloading box2d-py-2.3.8.tar.gz (374 kB)
     |████████████████████████████████| 374 kB ...
Requirement already satisfied: imageio; extra == "all" in e:\winpython_full_apr22\wpy64-3770\python-3.7.7.amd64\lib\site-packages (from gym[all]) (2.8.0)
Requirement already satisfied: Pillow; extra == "all" in e:\winpython_full_apr22\wpy64-3770\python-3.7.7.amd64\lib\site-packages (from gym[all]) (7.0.0)
Collecting opencv-python; extra == "all"
  Downloading opencv_python-4.2.0.34-cp37-cp37m-win_amd64.whl (33.0 MB)
     |████████████████████████████████| 33.0 MB 819 kB/s
Requirement already satisfied: future in e:\winpython_full_apr22\wpy64-3770\python-3.7.7.amd64\lib\site-packages (from pyglet<=1.5.0,>=1.4.0->gym[all]) (0.18.2)
Collecting glfw>=1.4.0
  Downloading glfw-1.11.0-py2.py27.py3.py30.py31.py32.py33.py34.py35.py36.py37.py38-none-win_amd64.whl (492 kB)
     |████████████████████████████████| 492 kB 3.3 MB/s
Requirement already satisfied: Cython>=0.27.2 in e:\winpython_full_apr22\wpy64-3770\python-3.7.7.amd64\lib\site-packages (from mujoco-py<2.0,>=1.50; extra == "all"->gym[all]) (0.29.15)
Requirement already satisfied: cffi>=1.10 in e:\winpython_full_apr22\wpy64-3770\python-3.7.7.amd64\lib\site-packages (from mujoco-py<2.0,>=1.50; extra == "all"->gym[all]) (1.14.0)
Collecting lockfile>=0.12.2
  Downloading lockfile-0.12.2-py2.py3-none-any.whl (13 kB)
Requirement already satisfied: pycparser in e:\winpython_full_apr22\wpy64-3770\python-3.7.7.amd64\lib\site-packages (from cffi>=1.10->mujoco-py<2.0,>=1.50; extra == "all"->gym[all]) (2.20)
Building wheels for collected packages: mujoco-py, box2d-py
  Building wheel for mujoco-py (setup.py) ... error
  ERROR: Command errored out with exit status 1:
   command: 'E:\WINPYTHON_FULL_apr22\WPy64-3770\python-3.7.7.amd64\python.exe' -u -c 'import sys, setuptools, tokenize; sys.argv[0] = '"'"'C:\\Users\\sndr\\AppData\\Local\\Temp\\pip-install-sql0jwqj\\mujoco-py\\setup.py'"'"'; __file__='"'"'C:\\Users\\sndr\\AppData\\Local\\Temp\\pip-install-sql0jwqj\\mujoco-py\\setup.py'"'"';f=getattr(tokenize, '"'"'open'"'"', open)(__file__);code=f.read().replace('"'"'\r\n'"'"', '"'"'\n'"'"');f.close();exec(compile(code, __file__, '"'"'exec'"'"'))' bdist_wheel -d 'C:\Users\sndr\AppData\Local\Temp\pip-wheel-5jiwopt6'
       cwd: C:\Users\sndr\AppData\Local\Temp\pip-install-sql0jwqj\mujoco-py\
  Complete output (27 lines):
  running bdist_wheel
  running build
  Traceback (most recent call last):
    File "<string>", line 1, in <module>
    File "C:\Users\sndr\AppData\Local\Temp\pip-install-sql0jwqj\mujoco-py\setup.py", line 44, in <module>
      tests_require=read_requirements_file('requirements.dev.txt'),
    File "E:\WINPYTHON_FULL_apr22\WPy64-3770\python-3.7.7.amd64\lib\site-packages\setuptools\__init__.py", line 144, in setup
      return distutils.core.setup(**attrs)
    File "E:\WINPYTHON_FULL_apr22\WPy64-3770\python-3.7.7.amd64\lib\distutils\core.py", line 148, in setup
      dist.run_commands()
    File "E:\WINPYTHON_FULL_apr22\WPy64-3770\python-3.7.7.amd64\lib\distutils\dist.py", line 966, in run_commands
      self.run_command(cmd)
    File "E:\WINPYTHON_FULL_apr22\WPy64-3770\python-3.7.7.amd64\lib\distutils\dist.py", line 985, in run_command
      cmd_obj.run()
    File "E:\WINPYTHON_FULL_apr22\WPy64-3770\python-3.7.7.amd64\lib\site-packages\wheel\bdist_wheel.py", line 223, in run
      self.run_command('build')
    File "E:\WINPYTHON_FULL_apr22\WPy64-3770\python-3.7.7.amd64\lib\distutils\cmd.py", line 313, in run_command
      self.distribution.run_command(command)
    File "E:\WINPYTHON_FULL_apr22\WPy64-3770\python-3.7.7.amd64\lib\distutils\dist.py", line 985, in run_command
      cmd_obj.run()
    File "C:\Users\sndr\AppData\Local\Temp\pip-install-sql0jwqj\mujoco-py\setup.py", line 28, in run
      import mujoco_py  # noqa: force build
    File "C:\Users\sndr\AppData\Local\Temp\pip-install-sql0jwqj\mujoco-py\mujoco_py\__init__.py", line 3, in <module>
      from mujoco_py.builder import cymj, ignore_mujoco_warnings, functions, MujocoException
    File "C:\Users\sndr\AppData\Local\Temp\pip-install-sql0jwqj\mujoco-py\mujoco_py\builder.py", line 20, in <module>
      from lockfile import LockFile
  ModuleNotFoundError: No module named 'lockfile'
  ----------------------------------------
  ERROR: Failed building wheel for mujoco-py
  Running setup.py clean for mujoco-py
  Building wheel for box2d-py (setup.py) ... error
  ERROR: Command errored out with exit status 1:
   command: 'E:\WINPYTHON_FULL_apr22\WPy64-3770\python-3.7.7.amd64\python.exe' -u -c 'import sys, setuptools, tokenize; sys.argv[0] = '"'"'C:\\Users\\sndr\\AppData\\Local\\Temp\\pip-install-sql0jwqj\\box2d-py\\setup.py'"'"'; __file__='"'"'C:\\Users\\sndr\\AppData\\Local\\Temp\\pip-install-sql0jwqj\\box2d-py\\setup.py'"'"';f=getattr(tokenize, '"'"'open'"'"', open)(__file__);code=f.read().replace('"'"'\r\n'"'"', '"'"'\n'"'"');f.close();exec(compile(code, __file__, '"'"'exec'"'"'))' bdist_wheel -d 'C:\Users\sndr\AppData\Local\Temp\pip-wheel-lrgkhbru'
       cwd: C:\Users\sndr\AppData\Local\Temp\pip-install-sql0jwqj\box2d-py\
  Complete output (16 lines):
  Using setuptools (version 46.0.0).
  running bdist_wheel
  running build
  running build_py
  creating build
  creating build\lib.win-amd64-3.7
  creating build\lib.win-amd64-3.7\Box2D
  copying library\Box2D\Box2D.py -> build\lib.win-amd64-3.7\Box2D
  copying library\Box2D\__init__.py -> build\lib.win-amd64-3.7\Box2D
  creating build\lib.win-amd64-3.7\Box2D\b2
  copying library\Box2D\b2\__init__.py -> build\lib.win-amd64-3.7\Box2D\b2
  running build_ext
  building 'Box2D._Box2D' extension
  swigging Box2D\Box2D.i to Box2D\Box2D_wrap.cpp
  swig.exe -python -c++ -IBox2D -small -O -includeall -ignoremissing -w201 -globals b2Globals -outdir library\Box2D -keyword -w511 -D_SWIG_KWARGS -o Box2D\Box2D_wrap.cpp Box2D\Box2D.i
  error: command 'swig.exe' failed: No such file or directory
  ----------------------------------------
  ERROR: Failed building wheel for box2d-py
  Running setup.py clean for box2d-py
Failed to build mujoco-py box2d-py
Installing collected packages: atari-py, glfw, lockfile, mujoco-py, box2d-py, opencv-python
    Running setup.py install for mujoco-py ... error
    ERROR: Command errored out with exit status 1:
     command: 'E:\WINPYTHON_FULL_apr22\WPy64-3770\python-3.7.7.amd64\python.exe' -u -c 'import sys, setuptools, tokenize; sys.argv[0] = '"'"'C:\\Users\\sndr\\AppData\\Local\\Temp\\pip-install-sql0jwqj\\mujoco-py\\setup.py'"'"'; __file__='"'"'C:\\Users\\sndr\\AppData\\Local\\Temp\\pip-install-sql0jwqj\\mujoco-py\\setup.py'"'"';f=getattr(tokenize, '"'"'open'"'"', open)(__file__);code=f.read().replace('"'"'\r\n'"'"', '"'"'\n'"'"');f.close();exec(compile(code, __file__, '"'"'exec'"'"'))' install --record 'C:\Users\sndr\AppData\Local\Temp\pip-record-iavd20ki\install-record.txt' --single-version-externally-managed --compile --install-headers 'E:\WINPYTHON_FULL_apr22\WPy64-3770\python-3.7.7.amd64\Include\mujoco-py'
         cwd: C:\Users\sndr\AppData\Local\Temp\pip-install-sql0jwqj\mujoco-py\
    Complete output (56 lines):
    running install
    running build

    You appear to be missing MuJoCo.  We expected to find the file here: E:\WINPYTHON_FULL_apr22\WPy64-3770\settings\.mujoco\mjpro150

    This package only provides python bindings, the library must be installed separately.

    Please follow the instructions on the README to install MuJoCo

        https://github.com/openai/mujoco-py#install-mujoco

    Which can be downloaded from the website

        https://www.roboti.us/index.html

    Traceback (most recent call last):
      File "<string>", line 1, in <module>
      File "C:\Users\sndr\AppData\Local\Temp\pip-install-sql0jwqj\mujoco-py\setup.py", line 44, in <module>
        tests_require=read_requirements_file('requirements.dev.txt'),
      File "E:\WINPYTHON_FULL_apr22\WPy64-3770\python-3.7.7.amd64\lib\site-packages\setuptools\__init__.py", line 144, in setup
        return distutils.core.setup(**attrs)
      File "E:\WINPYTHON_FULL_apr22\WPy64-3770\python-3.7.7.amd64\lib\distutils\core.py", line 148, in setup
        dist.run_commands()
      File "E:\WINPYTHON_FULL_apr22\WPy64-3770\python-3.7.7.amd64\lib\distutils\dist.py", line 966, in run_commands
        self.run_command(cmd)
      File "E:\WINPYTHON_FULL_apr22\WPy64-3770\python-3.7.7.amd64\lib\distutils\dist.py", line 985, in run_command
        cmd_obj.run()
      File "E:\WINPYTHON_FULL_apr22\WPy64-3770\python-3.7.7.amd64\lib\site-packages\setuptools\command\install.py", line 61, in run
        return orig.install.run(self)
      File "E:\WINPYTHON_FULL_apr22\WPy64-3770\python-3.7.7.amd64\lib\distutils\command\install.py", line 545, in run
        self.run_command('build')
      File "E:\WINPYTHON_FULL_apr22\WPy64-3770\python-3.7.7.amd64\lib\distutils\cmd.py", line 313, in run_command
        self.distribution.run_command(command)
      File "E:\WINPYTHON_FULL_apr22\WPy64-3770\python-3.7.7.amd64\lib\distutils\dist.py", line 985, in run_command
        cmd_obj.run()
      File "C:\Users\sndr\AppData\Local\Temp\pip-install-sql0jwqj\mujoco-py\setup.py", line 28, in run
        import mujoco_py  # noqa: force build
      File "C:\Users\sndr\AppData\Local\Temp\pip-install-sql0jwqj\mujoco-py\mujoco_py\__init__.py", line 3, in <module>
        from mujoco_py.builder import cymj, ignore_mujoco_warnings, functions, MujocoException
      File "C:\Users\sndr\AppData\Local\Temp\pip-install-sql0jwqj\mujoco-py\mujoco_py\builder.py", line 502, in <module>
        mjpro_path, key_path = discover_mujoco()
      File "C:\Users\sndr\AppData\Local\Temp\pip-install-sql0jwqj\mujoco-py\mujoco_py\utils.py", line 93, in discover_mujoco
        raise Exception(message)
    Exception:
    You appear to be missing MuJoCo.  We expected to find the file here: E:\WINPYTHON_FULL_apr22\WPy64-3770\settings\.mujoco\mjpro150

    This package only provides python bindings, the library must be installed separately.

    Please follow the instructions on the README to install MuJoCo

        https://github.com/openai/mujoco-py#install-mujoco

    Which can be downloaded from the website

        https://www.roboti.us/index.html

    ----------------------------------------
ERROR: Command errored out with exit status 1: 'E:\WINPYTHON_FULL_apr22\WPy64-3770\python-3.7.7.amd64\python.exe' -u -c 'import sys, setuptools, tokenize; sys.argv[0] = '"'"'C:\\Users\\sndr\\AppData\\Local\\Temp\\pip-install-sql0jwqj\\mujoco-py\\setup.py'"'"'; __file__='"'"'C:\\Users\\sndr\\AppData\\Local\\Temp\\pip-install-sql0jwqj\\mujoco-py\\setup.py'"'"';f=getattr(tokenize, '"'"'open'"'"', open)(__file__);code=f.read().replace('"'"'\r\n'"'"', '"'"'\n'"'"');f.close();exec(compile(code, __file__, '"'"'exec'"'"'))' install --record 'C:\Users\sndr\AppData\Local\Temp\pip-record-iavd20ki\install-record.txt' --single-version-externally-managed --compile --install-headers 'E:\WINPYTHON_FULL_apr22\WPy64-3770\python-3.7.7.amd64\Include\mujoco-py' Check the logs for full command output.

E:\WINPYTHON_FULL_apr22\WPy64-3770\scripts>

jkterry1, 2022-05-23:
PR #2762 is about to be merged, introducing V4 MuJoCo environments using new bindings and a dramatically newer version of the engine. If this issue still persists with the V4 ones, please create a new issue for it.

Closed 2022-05-23.

Thread 883 (2018-02-12):

Openai headless.

abhigenie92, 2018-02-12:
I am trying to record the video of env, on machine I have sshed to.
Code:
```
import gym
from gym import wrappers
env = gym.make("CartPole-v1")
env = wrappers.Monitor(env, "./try/", force = True)
for i_episode in range(20):
    observation = env.reset()
for t in range(100):
    print(observation)
    action = env.action_space.sample()
    observation, reward, done, info = env.step(action)
    if done:
        print("Episode finished after {} timesteps".format(t+1))
        break
```
Error:
```
python check_code.py
No protocol specified
Traceback (most recent call last):
  File "check_code.py", line 7, in <module>
    observation = env.reset()
  File "/nohome/jaan/abhishek/anaconda3/lib/python3.6/site-packages/gym/core.py", line 104, in reset
    return self._reset()
  File "/nohome/jaan/abhishek/anaconda3/lib/python3.6/site-packages/gym/wrappers/monitoring.py", line 41, in _reset
    self._after_reset(observation)
  File "/nohome/jaan/abhishek/anaconda3/lib/python3.6/site-packages/gym/wrappers/monitoring.py", line 198, in _after_reset
    self._reset_video_recorder()
  File "/nohome/jaan/abhishek/anaconda3/lib/python3.6/site-packages/gym/wrappers/monitoring.py", line 219, in _reset_video_recorder
    self.video_recorder.capture_frame()
  File "/nohome/jaan/abhishek/anaconda3/lib/python3.6/site-packages/gym/monitoring/video_recorder.py", line 106, in capture_frame
    frame = self.env.render(mode=render_mode)
  File "/nohome/jaan/abhishek/anaconda3/lib/python3.6/site-packages/gym/core.py", line 150, in render
    return self._render(mode=mode, close=close)
  File "/nohome/jaan/abhishek/anaconda3/lib/python3.6/site-packages/gym/core.py", line 286, in _render
    return self.env.render(mode, close)
  File "/nohome/jaan/abhishek/anaconda3/lib/python3.6/site-packages/gym/core.py", line 150, in render
    return self._render(mode=mode, close=close)
  File "/nohome/jaan/abhishek/anaconda3/lib/python3.6/site-packages/gym/envs/classic_control/cartpole.py", line 115, in _render
    from gym.envs.classic_control import rendering
  File "/nohome/jaan/abhishek/anaconda3/lib/python3.6/site-packages/gym/envs/classic_control/rendering.py", line 23, in <module>
    from pyglet.gl import *
  File "/nohome/jaan/abhishek/anaconda3/lib/python3.6/site-packages/pyglet/gl/__init__.py", line 239, in <module>
    import pyglet.window
  File "/nohome/jaan/abhishek/anaconda3/lib/python3.6/site-packages/pyglet/window/__init__.py", line 1884, in <module>
    gl._create_shadow_window()
  File "/nohome/jaan/abhishek/anaconda3/lib/python3.6/site-packages/pyglet/gl/__init__.py", line 208, in _create_shadow_window
    _shadow_window = Window(width=1, height=1, visible=False)
  File "/nohome/jaan/abhishek/anaconda3/lib/python3.6/site-packages/pyglet/window/xlib/__init__.py", line 166, in __init__
    super(XlibWindow, self).__init__(*args, **kwargs)
  File "/nohome/jaan/abhishek/anaconda3/lib/python3.6/site-packages/pyglet/window/__init__.py", line 501, in __init__
    display = get_platform().get_default_display()
  File "/nohome/jaan/abhishek/anaconda3/lib/python3.6/site-packages/pyglet/window/__init__.py", line 1833, in get_default_display
    return pyglet.canvas.get_display()
  File "/nohome/jaan/abhishek/anaconda3/lib/python3.6/site-packages/pyglet/canvas/__init__.py", line 82, in get_display
    return Display()
  File "/nohome/jaan/abhishek/anaconda3/lib/python3.6/site-packages/pyglet/canvas/xlib.py", line 86, in __init__
    raise NoSuchDisplayException('Cannot connect to "%s"' % name)
pyglet.canvas.xlib.NoSuchDisplayException: Cannot connect to "None"
```
I followed instructions from here https://github.com/2017-fall-DL-training-program/Setup_tutorial/blob/master/OpenAI-gym-install.md

Anydesk gives me the following error:
```
anydesk
No protocol specified

(anydesk:19087): Gtk-WARNING **: cannot open display: :0
No protocol specified

(anydesk:19089): Gtk-WARNING **: cannot open display: :0
No protocol specified

```

jamsawamsa, 2018-02-15:
bump, having the same issue here

josiahls, 2019-04-27:
I am having the same issue. I call render("rgb_array") and it still loads the env window. This seems like an obvious thing that we would want to avoid. I am using pybullet3 which is a full physics engine, and even that has easy headless rendering

christopherhesse, 2019-07-26:
This looks like a duplicate of https://github.com/openai/gym/issues/366.  The best fix on the gym side would be to support EGL, but it looks like pyglet does not support that yet: https://github.com/openai/gym/issues/1338

Closed 2019-07-26.

Thread 908 (2018-02-25):

Kung Fu Master - sys.meta_path is None error

dalisaydavid, 2018-02-25:
Hi all,

I made a custom agent that uses Q learning to evaluate it's next action. But for some reason, I get a huge string of random digits printed to standard out and then this error pops up when running said code:
```Exception ignored in: <bound method SimpleImageViewer.__del__ of <gym.envs.classic_control.rendering.SimpleImageViewer object at 0x104114eb8>>
Traceback (most recent call last):
  File "/Users/david.dalisay/Arcade-Learning-Environment/lib/python3.6/site-packages/gym/envs/classic_control/rendering.py", line 347, in __del__
  File "/Users/david.dalisay/Arcade-Learning-Environment/lib/python3.6/site-packages/gym/envs/classic_control/rendering.py", line 343, in close
  File "/Users/david.dalisay/Arcade-Learning-Environment/lib/python3.6/site-packages/pyglet/window/cocoa/__init__.py", line 277, in close
  File "/Users/david.dalisay/Arcade-Learning-Environment/lib/python3.6/site-packages/pyglet/window/__init__.py", line 747, in close
ImportError: sys.meta_path is None, Python is likely shutting down
```

I've seen that the program runs fine (screen renders and program plays Kung Fu Master) if I leave out line 60 of the following (I made a comment where the issue is):
```import argparse
from datetime import datetime
import gym
import time
from gym import wrappers, logger
from random import randint

class QLearningAgent(object):
    def __init__(self, action_space):
        self.action_space = action_space
        self.q_table = {}
        self.gamma = 0.8  # discount factor
        self.alpha = 1.0  # learning rate
        self.epsilon = 10 # percentage.

    def update_q_table(self, observation, action, reward):
        function_start_time = datetime.now()
        observation_key = self.get_observation_key(observation)
        current_q_value = self.q_table[observation_key][action]
        new_q_value = current_q_value + self.alpha * (reward + self.gamma * max(self.q_table[observation_key]) - current_q_value)
        self.q_table[observation_key][action] = round(new_q_value, 2)

    def get_observation_key(self, observation):
        return "".join(map(str,observation.flatten()))

    def act(self, observation, reward, done):
        observation_key = self.get_observation_key(observation)
        if observation_key not in self.q_table:
            self.q_table[observation_key] = [0 for action in range(self.action_space.n)]

        if randint(0,100) < self.epsilon:
            action = self.action_space.sample()
        else:
            if sum(self.q_table[observation_key]) > 0:
                action = self.q_table[observation_key].index(max(self.q_table[observation_key]))
            else:
                action = self.action_space.sample()

        return action

if __name__ == '__main__':
    logger.set_level(logger.INFO)

    env = gym.make('KungFuMaster-v4')
    env._max_episode_steps = 1000
    env.seed(0)
    agent = QLearningAgent(env.action_space)

    episode_count = 1
    reward = 0
    done = False

    for i in range(10):
        observation = env.reset()
        observation_index = 0
        while True:
            observation_index += 1
            action = agent.act(observation, reward, done)
            observation, reward, done, _ = env.step(action)

           #### This causes program to break. ###
            agent.update_q_table(observation, action, reward)
            if done:
                break
            env.render()
    env.close()
```

dalisaydavid, 2018-02-25:
This issue is completely unrelated to Gym. I had a dictionary key error. Closing.

Closed 2018-02-25.

Thread 925 (2018-03-04):

Velocity/torque control for Fetch environment

xli4217, 2018-03-04:
Hi, it looks like the current Fetch environments use end-effector position control. I was wondering if it's possible to modify it for joint velocity or torque control. If so where should I start. Thanks

st99315, 2018-05-07:
I have the same question.

WuXinyang2012, 2019-04-08:
same questions. Just want to know how to use the joint velocity/angles rather than directly the position of the gripper to control the robot.

Alonso94, 2019-05-03:
Hi, I have faced the same problem;
For me, modifying the step function works fine:
`    def step(self, action):
        qpos = {
            'robot0:shoulder_pan_joint': action[0],
            'robot0:shoulder_lift_joint': action[1],
            'robot0:upperarm_roll_joint': action[2],
            'robot0:elbow_flex_joint': action[3]
        }
        for name, value in qpos.items():
            self.env.sim.data.set_joint_qpos(name, value)
        self.env.sim.forward()
        ob=self.env._get_obs()
        return ob['achieved_goal']`

kosta-jo, 2021-05-22:
@wangcongrobot Can you add a more detailed guide in step by step manner?

kosta-jo, 2021-05-24:
@xli4217 Have you find the solution? If yes, can you share it?

jkterry1, 2022-05-23:
PR #2762 is about to be merged, introducing V4 MuJoCo environments using new bindings and a dramatically newer version of the engine. If this issue still persists with the V4 ones, please create a new issue for it.

Closed 2022-05-23.

Thread 928 (2018-03-05):

Argument error in env.render()

chennakeshava1998, 2018-03-05:
I was working through the gym tutorial https://gym.openai.com/docs/. But I ran into an error after executing env.render() function. This function executed once properly, but I am not able to execute once more. I understood that after done=True, we need to perform env.reset().  But I wanted to know if there are any other reasons because the error message specifically mentions 'Argument Error'. I ran this code in Jupyter Notebook
Here is the code: (I am not able to show the indentation with markdown, but my code is properly indented)

`import gym`
`env.reset()`
`for _ in range(1000):`
`    env.render()`
`    env.step(env.action_space.sample()) # taking a random action from the possible set of actions`

---------------------------------------------------------------------------
ArgumentError                             Traceback (most recent call last)
<ipython-input-5-24825dd27544> in <module>()
      1 for _ in range(1000):
----> 2     env.render()
      3     env.step(env.action_space.sample()) # taking a random action from the possible set of actions

/usr/local/lib/python3.5/dist-packages/gym/core.py in render(self, mode, close)
    148             elif mode not in modes:
    149                 raise error.UnsupportedMode('Unsupported rendering mode: {}. (Supported modes for {}: {})'.format(mode, self, modes))
--> 150         return self._render(mode=mode, close=close)
    151
    152     def close(self):

/usr/local/lib/python3.5/dist-packages/gym/core.py in _render(self, mode, close)
    284
    285     def _render(self, mode='human', close=False):
--> 286         return self.env.render(mode, close)
    287
    288     def _close(self):

/usr/local/lib/python3.5/dist-packages/gym/core.py in render(self, mode, close)
    148             elif mode not in modes:
    149                 raise error.UnsupportedMode('Unsupported rendering mode: {}. (Supported modes for {}: {})'.format(mode, self, modes))
--> 150         return self._render(mode=mode, close=close)
    151
    152     def close(self):

/usr/local/lib/python3.5/dist-packages/gym/envs/classic_control/cartpole.py in _render(self, mode, close)
    144         self.poletrans.set_rotation(-x[2])
    145
--> 146         return self.viewer.render(return_rgb_array = mode=='rgb_array')

/usr/local/lib/python3.5/dist-packages/gym/envs/classic_control/rendering.py in render(self, return_rgb_array)
     82         self.window.clear()
     83         self.window.switch_to()
---> 84         self.window.dispatch_events()
     85         self.transform.enable()
     86         for geom in self.geoms:

/usr/local/lib/python3.5/dist-packages/pyglet/window/xlib/__init__.py in dispatch_events(self)
    873         # Check for the events specific to this window
    874         while xlib.XCheckWindowEvent(_x_display, _window,
--> 875                                      0x1ffffff, byref(e)):
    876             # Key events are filtered by the xlib window event
    877             # handler so they get a shot at the prefiltered event.

ArgumentError: argument 2: <class 'TypeError'>: wrong type

jleni, 2018-07-05:
At least in my case, it was because the window was previously closed:

From pyglet docs (https://pyglet.readthedocs.io/en/pyglet-1.2-maintenance/api/pyglet/window/pyglet.window.Window.html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)

> After closing the window, the GL context will be invalid. The window instance cannot be reused once closed (see also set_visible).

christopherhesse, 2019-04-19:
Thanks for answering this @jleni!

cduguet, 2020-02-17:
So the workaround would be to create a new env?

ay1011, 2020-05-02:
# Create an environment again solves the problem for me
env = gym.make('MountainCar-v0')

Closed 2019-04-19.

Thread 934 (2018-03-06):

Standard API for multi-agent environments

nicomon24, 2018-03-06:
Hi everyone,
I'm developing a multi-agent env (multi-snake, latest Request for Research) and I thought that having a common API interface for multi-agent environments would be great. Here some of my thoughts:

- Real-time multi-agent environments: each player take an action at every step call (e.g. multi-snake)
  - Step function should accept a vector of actions, while returning a vector of observations, vector of rewards, vector of done flags, vector of infos (as in https://github.com/openai/multiagent-particle-envs/blob/master/multiagent/environment.py)
  - Reset function should also return a vector of observations
  - We could support different observation and actions spaces for different players (e.g. players have different visibility or different set of possible actions) by providing a list *players* in which each element is a tuple *(observation_space, actions_space, reward_range)*
  - Render function should render the observation of a particular player
- Turn-based multi-agent environments: e.g. go or tic-tac-toe
  - Step() should take a player index and an action (check internally if it's the current player's turn)
  - We could also support games in which a turn consists in multiple actions (e.g. risk), by making the step function return a *turn_end* signal
  - Same issue of different observations/actions as before

I'm currently working on this, so I wanted to discuss here if any idea comes up :)

FirefoxMetzger, 2018-03-06:
I think we should differentiate between actual real-time games (where there is actual, continous time) and games where multiple agents make moves in the same turn.

The latter is just a special case of a turn-based multi-agent environment where agents take turns proposing a move and the environment updates jointly after all proposals are available (to the environment).

I think it would also make implementation a lot simpler. You could append a "player=1" as optional input parameter to step, render, action_space (getter), observation_space (getter), [...] and have the environment worry about the logic behind it. From an agent's pov it would look a lot like the usual environments.

The only problem I see is `reset`. Since the agent(s) don't actually reset the environment but rather the learning algorithm does, it gets a bit clunky as to how to pass the initial observations to each agent.

Regarding your proposal for multi-agent environments I think it should be up to the learning algorithm to decide which agent to give control over the current turn. Take self play as an example where there is no need to enforce which players turn it is as both are the same. Still the environment needs to track turns to keep up with potentially different observations or actions.

The same line of thought goes for "multi-step" turn-based environments. It should be up to the algorithm to decide whom to give control over the current turn. If the environment features "multi-step" turns the algorithm has to take care of adhering to that (or not, depending on the setup).

nicomon24, 2018-03-06:
> I think we should differentiate between actual real-time games (where there is actual, continous time) and games where multiple agents make moves in the same turn.

Good point, it would be great! Does gym have any environment with continuous time yet to take inspiration?

> The latter is just a special case of a turn-based multi-agent environment where agents take turns proposing a move and the environment updates jointly after all proposals are available (to the environment).

So every agent makes a blocking call to the step method? Because it must wait for every agent before getting an observation

> Regarding your proposal for multi-agent environments I think it should be up to the learning algorithm to decide which agent to give control over the current turn.

Should we not try to abstract "environment mechanics" from the particular algorithm chosen? This is obviously my personal idea :) For example, in self-play, the environment should not know anything about the fact that we have the same agent playing itself, while it should know that there are N players that must take turns or can take actions jointly.

FirefoxMetzger, 2018-03-06:
I gave this a bit more thought and have to revise my idea. I no longer think it makes sense to have a `player=1` kind of parameter in either `step()`, `render()` or similar. In fact, the current API already supports (almost) all aspects discussed so far.

`render()` is actually `render(self, mode=human)` and while using "human", "rgb_array" and "ansi" have special meaning, nothing stops an environment from implementing `mode=player_one` to render views for specific players if they are only partially observable and different. So that part can go unchanged.

> Reset function should also return a vector of observations
Currently, I would agree. The orchestrating code will have to worry about getting observations to each agent. Again, there is no real need to change the existing API since multidimensional spaces are already supported (e.g. a tuple-space) =). `reset()` is something that the orchestrating code around the agent(s) is concerned with, not the actual agent. [I previously referenced to that code as "learning algorithm" - very poor phrasing on my end, sorry]

`step()` is more interesting. I think there is no argument that `observation` and `action` are already flexible enough to support multi-agent environments as is. `done` doesn't need to be anything more then a flag, because it's main intention is to signal the orchestrating code when an episode terminates.
The only thing stopping your suggestion is `reward`, because according to the spec it only supports `float`. Then again, this is Python and you can easily ignore this detail of the spec and return an array. That is probably the only thing that is missing from the spec to implement what you are looking for.

> We could support different observation and actions spaces for different players
The current API already supports that. The action space (and observation space) can change after every step, so using the "trick" of decomposing one step where every agent makes it's move to multiple steps where agents get to "propose" moves can accomplish unique observation and action spaces.

> So every agent makes a blocking call to the step method?
This forces people that want to use the API to write multi-threaded code. I think the costs will outweigh the benefit (but that is my opinion, feel free to disagree). Instead agents can split their "pick_action" and "update" parts (which many do anyway) and hand control back to the orchestrating code in between. That way each agent's "pick_action" can be executed and passed to the environment by calling `step()` N times (accounting for different observability and actions). On the N-th call the environment updates (which produces the actual reward(s) and observations) and the orchestrating code can pass the appropriate new observations and rewards to the each agent's "update" part.

> Does gym have any environment with continuous time yet to take inspiration?
I don't know actually. RL generally has a problem with continuous time as it is based on MDPs, which assume you get to make a sequence of discrete choices.

nicomon24, 2018-03-06:
> I don't know actually. RL generally has a problem with continuous time as it is based on MDPs, which assume you get to make a sequence of discrete choices.

Yeah, I was kinda reflecting on this, in fact any digital device will "discretize" time, so no worries.

About your "tricks", you're obviously right, there is almost nothing that cannot be done with the current standard environment (in fact, I already did in my env :) ). Since I've seen different repos of multi-agent environment that uses different and specific approaches, I was more interested in finding common "guidelines" for the creation of new multi-agent environments, in order to make them "consistent" with each other (I think the simple and standard interface of gym is its main strength in fact).

ishan00, 2018-10-14:
@nicomon24, @FirefoxMetzger. What is the current status of this issue? Does gym support any multi-agent environment yet?

gvgramazio, 2018-11-07:
Other than multi-agent environment, I think that the general Env class could be expanded also considering under which condition the decision is taken: at the same time, turn based, turn and phase based.

- In pong we have two players that act at the same time. In this case the observation could be shared by both of them and the action could be the concatenation of the actions of the two players. One smaller problem is the reward that is currently defined as float. The biggest problem is how it should be handled the step method in order to take an input from both agents.
- In chess, checkers, battleship, etc. we have turns. Each agent takes rewards and observation from the step function but it should take at least an observation (and maybe also a reward) when the other player make a step. This could be a bit difficult to implement.
- In poker, we have turns but also phases. It means that at each phase of the game the observation_space change. In case of more than two players is also possible that the number of players currently active (i.e. that haven't folded yet) could be variable.

VinQbator, 2019-02-25:
+1
Keeping an eye on the topic. I'm currently dealing with some multi-agent experiments and trying to keep them compatible with gym and keras-rl. Standardized interface would be really nice to have.

alsora, 2019-03-23:
+1
I am currently developing a [Briscola  RL framework](https://github.com/alsora/deep-briscola) (popular italian turn based card game).
Now I would like to integrate it with `gym` in order to also test more advanced algorithms and have more standard APIs.

I'm not an expert of the `gym` APIs, but I think that the main issue here is that there are different possible "timings" about when observe/act/get_reward.

In a standard, single agent, environment we have something like this

```
 def step(self, a):
    done = self.act(a)
    state = self.observe()
    reward = self.get_reward()
    return (state, reward, done, {})
```

In a chess-like, multi-agent, environment I do not see how it is possible to have a single method which does all the following

```
for agent in agents:
    state = env.observe(agent.id)
    action = agent.select_action(state)
    done = env.act(action)

multi_rewards = env.get_reward()
```

billtubbs, 2019-05-25:
This is a good discussion.  I'm also interested in multi-agent environments.

@alsora has identified one important issue:

> I think that the main issue here is that there are different possible "timings" about when observe/act/get_reward.

E.g. in Tic-Tac-Toe, player 1 may get a terminal reward after player 2's move.

I stumbled into this problem a few years ago when I implemented [a tic-tac-toe game environment](https://github.com/billtubbs/game-learner) (as a learning exercise).

I can't see how that could be achieved with the current Gym method:

`observation, reward, done, info = env.step(action)`

If it's any help, the way I solved it in the end was to have three object types:
- agents
- environment (the game)
- controller

Here is how it worked:
```
>>> game = TicTacToeGame()
>>> players = [HumanPlayer("Joe"), TDLearner("TD")]
>>> ctrl = GameController(game, players)
>>> ctrl.play()
```

With this structure in place, the GameController basically manages the communication of rewards so they can be passed to each agent immediately after they take an action or later after all agents made their move.

Hope that helps.  If you do implement multiple agent environments it would be good to allow for the idea of agents that can communicate with each other or share the same value function for example.

koulanurag, 2019-08-18:
I stumbled upon this discussion thread and wanted to share similar work: [ma-gym](https://github.com/koulanurag/ma-gym)

Please, refer to the [Usage Wiki](https://github.com/koulanurag/ma-gym/wiki/Usage) for details on my compliance with the open-ai gym.

I hope this might be useful to others.

AdamGleave, 2019-10-17:
I think this issue should remain open. It's a major lack in Gym's current API that will become only more acute over time with the renewed emphasis on multi-agent systems (OpenAI 5, AlphaStar, ...) in modern deep RL.

yannbouteiller, 2020-01-06:
I have a kinda philosophical question on this matter.

Wandering across projects that use gym in MARL environments, I have noticed that people usually use python lists for e.g. action_n whereas rllib, that I use a lot, typically use dictionaries (e.g. action_dict) for everything. What should be the proper way according to you ?

For example, in multiagent gym environments I found, the return of step(): obs_n, rew_n, done_n, info_n would be python lists, whereas in rllib they would be dictionaries with one entry for each agent name. This allows for variable number of agents over time, heterogeneous episode lengths, etc.

dat-boris, 2020-01-07:
I like that @yannbouteiller.   Using an action dict like rllib's approach is sound [1] for arbitrary agents entering and exiting.

Would love to hear other's who have more experience in using rllib's multi-agent environment to see if there is missing use-case from rllib's API?

[1] https://ray.readthedocs.io/en/latest/rllib-env.html#multi-agent-and-hierarchical

MouseAndKeyboard, 2020-01-08:
I've been thinking about this for a while as I've had multiple projects where having a standard multi-agent API would be great.
In order the achieve "real-time" multi-agent games and separate observations + rewards I think it would be necessary to take some form of "Server-to-Client" architecture in the API

The simulator (server) will run the environment and should execute the agents' (clients') actions as requested.
An important concept to note is that there has to be some implementation of a "default action". For example, in StarCraft II presumably the default action is doing nothing but in contrast in an environment where the agent is controlling a bio-inspired character (e.g. a humanoid), the default action should not be to 'do nothing' as that might suggest making the character to go limp.

A server-client architecture is also more logical because each agent will receive their own observations and rewards (without the need for dealing with tuples).

server-client also allows for agents to connect and disconnect which may help model real world situations where agents can join and leave a simulation.

yannbouteiller, 2020-01-08:
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

All the RL algorithms I know assume a time-step, even in the real time setting, and many MARL algorithms use the global information during training with a global time-step (e.g. centralized critics). I have been thinking about this as well but I don't really see the point of a client-server asynchronous architecture over the current synchronous way of using step() considering these facts?

MouseAndKeyboard, 2020-01-08:
You're leaving it up to the person writing the agents to be calling step at periodic intervals. Ideally you would want this to be handled by the environment otherwise sharing gyms would also require the user to write new code each time.

Perhaps a client-server might be overkill but it naively seems quite intuitive/user friendly.

eager-seeker, 2020-02-06:
> I don't really see the point

> calling step at periodic intervals

> it would be good to allow for the idea of agents that can communicate with each other

Allowing between-env-step inter-agent communication (if, indeed, this is a valid MARL approach) is a possible use-case for asynchronous interactions and multi-node, distributed arrangements. I've tried this with [SPADE](https://github.com/javipalanca/spade) but have been slowed by [scale and memory issues](https://github.com/javipalanca/spade/issues/76). I'd tried some of the gym environment approaches mentioned above (thanks, contributors), but with a single coordinator game-master or tournament-master agent (context is games in this case). This is how I've managed to allow for the inter-agent interactions between steps. Has anyone found a better solution for allowing distributed agents to interact with a central multi-agent gym environment, while allowing for such async interactons between steps?

jkterry1, 2021-07-30:
Check out https://github.com/PettingZoo-Team/PettingZoo. It's linked from the readme now too.

Closed 2021-07-30.

Thread 983 (2018-04-09):

How to specify custom keys to action mapping

ignacioalvmar, 2018-04-09:
This is not so much an issue as a lack of clarity.
I was trying to enable CarRacing-v0 to be played by user using custom keys I thought I could have this using utils.play like this:

```
import gym
from gym.utils.play import *

play(gym.make("CarRacing-v0"))
```
It works fine for the atari environments but in this case I got
```
---------------------------------------------------------------------------
AssertionError                            Traceback (most recent call last)
<ipython-input-3-080385c697d2> in <module>()
      8 # play.keys_to_action = KEYWORD_TO_KEY
      9
---> 10 play(gym.make("CarRacing-v0"))
     11
     12 # mapping of keys

~/Documents/openai/gym/gym/utils/play.py in play(env, transpose, fps, zoom, callback, keys_to_action)
     92         else:
     93             assert False, env.spec.id + " does not have explicit key to action mapping, " + \
---> 94                           "please specify one manually"
     95     relevant_keys = set(sum(map(list, keys_to_action.keys()),[]))
     96

AssertionError: CarRacing-v0 does not have explicit key to action mapping, please specify one manually
```
So I was wondering how to do this custom action mapping?
The comment in the play code says it's a mapping keys_to_action: dict: tuple(int) -> int

The atari_env does it this way:
```
KEYWORD_TO_KEY = {
            'UP':      ord('w'),
            'DOWN':    ord('s'),
            'LEFT':    ord('a'),
            'RIGHT':   ord('d'),
            'FIRE':    ord(' '),
        }
```
I know the car_racing script does this by capturing the keys pressed into an 3 element array and passing that value to env.step. So I tried a similar way here:
```
KEYWORD_TO_KEY = {'STEER':ord('a'),'GAS':ord('w'),'BREAK':ord('s')}
play.keys_to_action = KEYWORD_TO_KEY
```
It didn't work. I know steer is wrong but I thought I'd get at least the vehicle turning one way.
Then I checked remapping the keywords to a custom combination on one of the Atari games.
The game worked but the key mapping was the original not my modification.

Can you throw some more clarity to how to do this custom key mapping?

jamiesalter, 2018-04-29:
I ran into the same thing, but found the answer in the comments of `car_racing.py`

To play the car racing game using your keyboard, you can run `python gym/envs/box2d/car_racing.py`

Alternatively, you can copy the code at the bottom of `car_racing.py` and run:
```
from gym.envs.box2d import car_racing
from pyglet.window import key

a = np.array([0.0, 0.0, 0.0])

def key_press(k, mod):
    global restart
    if k == 0xff0d: restart = True
    if k == key.LEFT:  a[0] = -1.0
    if k == key.RIGHT: a[0] = +1.0
    if k == key.UP:    a[1] = +1.0
    if k == key.DOWN:  a[2] = +0.8  # set 1.0 for wheels to block to zero rotation

def key_release(k, mod):
    if k == key.LEFT and a[0] == -1.0: a[0] = 0
    if k == key.RIGHT and a[0] == +1.0: a[0] = 0
    if k == key.UP:    a[1] = 0
    if k == key.DOWN:  a[2] = 0

env = car_racing.CarRacing()
env.render()
record_video = False
if record_video:
    env.monitor.start('/tmp/video-test', force=True)
env.viewer.window.on_key_press = key_press
env.viewer.window.on_key_release = key_release
while True:
    env.reset()
    total_reward = 0.0
    steps = 0
    restart = False
    while True:
        s, r, done, info = env.step(a)
        total_reward += r
        if steps % 200 == 0 or done:
            print("\naction " + str(["{:+0.2f}".format(x) for x in a]))
            print("step {} total_reward {:+0.2f}".format(steps, total_reward))
            # import matplotlib.pyplot as plt
            # plt.imshow(s)
            # plt.savefig("test.jpeg")
        steps += 1
        if not record_video:  # Faster, but you can as well call env.render() every time to play full window.
            env.render()
        if done or restart: break
env.close()
```

I couldn't get `play(gym.make("CarRacing-v0"), keys_to_action=KEYWORD_TO_KEY)` to work.

As for custom key mappings, you can see what key mappings are being used by default (for Pong for example) by running:
```
from gym.utils.play import *

env = gym.make("Pong-v0")
if hasattr(env, 'get_keys_to_action'):
    keys_to_action = env.get_keys_to_action()
elif hasattr(env.unwrapped, 'get_keys_to_action'):
    keys_to_action = env.unwrapped.get_keys_to_action()
print(keys_to_action)
```

The output is `{(32, 97): 5, (32,): 1, (97,): 3, (32, 100): 4, (): 0, (100,): 2}`
So I think the format of your `KEYWORD_TO_KEY` needs to be `dict: tuple(int) -> int `.  So something like:
```
{
    (ord('w'), ): 1,
    (ord('d'), ): 2,
    ...
}
```

You can get a list of action meanings at the bottom of the `atari_env.py` module.

I'm absolutely new to this so apologies if some of this isn't correct!

christopherhesse, 2019-04-26:
Thanks for answering this @jamiesalter!  It seems like the `play()` function needs some improvements.  There's an example interactive script in `retro` here: https://github.com/openai/retro/blob/master/retro/examples/interactive.py that might be useful to generalize for all gym environments that support `render='rgb_array'` although in this case it would produce two windows and they might not share OpenGL contexts correctly.

winutta, 2019-05-14:
Try reordering the order of the keys and values in the dictionary to match the format in @jamiesalter 's answer. You can also alter the play function in the module to have a selected value for when no keys are pressed (it is set to 0 by default, and has to be an element of the action_space). 👍

Closed 2019-10-12.

Thread 1000 (2018-04-16):

MuJoCo render incompatible with newer versions of MuJoCo Py

AdamGleave, 2018-04-16:
MujucoEnv's render method assumes the viewer has a 500x500 display. If it is larger than this, it will select pixels from the bottom-left corner when called with `mode='rgb_array'`. There's a comment which suggests this size used to be the default for mujoco-py, but with the latest mujoco-py it defaults to the screen resolution: see opengl_context.pyx:89 in _create_window.

This issue can be fixed by adding the line `self.viewer.opengl_context.set_buffer_size(W, H)` in `_get_viewer` to manually specify the desired frame size. (Oddly, I need to set both dimensions to twice the desired size, I think due to an overzealous workaround for Mac's on opengl_context.pyx:113.) But this is pretty hacky.

I'm a little confused why we're rendering anything on the screen for `render(mode='rgb_array')`, which is typically used for video capture in a batch setting. In particular, MjViewer has the annoyance of showing an overlay menu by default, rarely desired for video capture. It might be better to use `mujoco_py.MjRenderContextOffscreen` instead for this purpose. If we allow render to be called with different modes, however, this would require making a breaking change to the interface for `viewer_setup` (or some hacking to make `self.viewer` point to different objects depending on the last call).

I'd be happy to work on a pull request to address these issues if we can agree on a good way forward for this.

AdamGleave, 2018-04-17:
A more serious issue is that close() calls the method finish() on the viewer which no longer exists in the latest mujoco_py version. To reproduce:

1. Install latest version of mujoco-py (1.50.1.56 from PyPi, same as Git master)
2. Run:
`
import gym                                                                                                                                                                                    

env = gym.make('Reacher-v2')
ob = env.reset()
env.step([0.0, 0.0])
env.render()
env.close()
`
3. Output:
`
Creating window glfw                                                                                                                                                                          
Traceback (most recent call last):                                                                                                                                                            
  File "test_mjc.py", line 8, in <module>
    env.close()
  File "/home/adam/dev/gym/gym/core.py", line 288, in close
    return self.env.close()
  File "/home/adam/dev/gym/gym/envs/mujoco/mujoco_env.py", line 115, in close
    self.viewer.finish()
AttributeError: 'MjViewer' object has no attribute 'finish
`

I assume there's some version of mujoco-py where this all worked -- we could perhaps pin the Gym requirements to that version as a workaround, while a more permanent fix is developed?

AdamGleave, 2018-05-14:
Could @matthiasplappert or another Gym committer working on MuJoCo take a look at this? I've had several people e-mail me as a result of this issue, so this seems to be a common problem for people. My PR provides a workaround, but a proper fix will require a coordinated change between gym and mujoco_py.

AdamGleave, 2018-05-15:
Hi Matthias,

1. Apologies about the messy PR -- this was a rebase gone wrong when I incorporated some recent changes in Gym master. This is fixed now (in PR #1013).
2. This is also my impression -- I was hesitant to make this modification as it would be a breaking API change for any end-users that subclass MujocoEnv. Although it is easy enough for people to fix.
3. You're right, there seems to be a lot of code duplication between RobotEnv and MujocoEnv. I'm not sure how to fix this (without resorting to multiple inheritance) given RobotEnv inherits from GoalEnv.

Encapsulating the logic to switch between viewers in a meta viewer could be more elegant, but I think is fundamentally the same approach as my workaround, and so does still feel less clean to me than your proposal (2).

kirk86, 2018-07-26:
Hi folks, I still face the issue of `env.close()` not properly working with `mujoco`. I have the latest gym and latest mujoco installed `mujoco 1.5.0`.

tianheyu927, 2018-08-20:
Is there any progress on fixing `env.close()`?

LonelyCloud97, 2018-10-28:
MjViewer is implemented by GLFW, so maybe you can write env.close() by yourself.
```python
import glfw
import gym
from types import MethodType

# override env.close()
def env_wrapper(env):
    def close(self):
        if self.viewer is not None:
            glfw.terminate()
            self.viewer = None

    env.unwrapped.close = MethodType(close, env.unwrapped)
    return env

def test():
    env = env_wrapper(gym.make("Reacher-v2"))
    env.reset()
    for _ in range(50):
        env.render()
        env.step([0, 0])
    env.close()

if __name__ == '__main__':
    test()

```
It works well with no error, but I am not sure if there are some side effects.
```
"C:\Program Files\Python36\python.exe" D:/File/LAB/project/fix_problem.py
WARN: gym.spaces.Box autodetected dtype as <class 'numpy.float32'>. Please provide explicit dtype.
WARN: gym.spaces.Box autodetected dtype as <class 'numpy.float32'>. Please provide explicit dtype.
Creating window glfw

Process finished with exit code 0
```

AdamGleave, 2018-10-28:
@JiangengDong will this close all GLFW windows from the application? (One can have multiple environments in the same process.)

JiangengDong, 2018-10-29:
@AdamGleave Just as you say, `glfw.terminate()` will close all windows.  A better method is to use `glfw.destroy_window()` instead.

New version:
```python
def close(self):
    if self.viewer is not None:
        glfw.destroy_window(self.viewer.window)
        self.viewer = None
```

Thanks for your advice.

Closed 2018-05-30.

Thread 1004 (2018-04-19):

Present way of returning rgb array, removed close=True.

alcaster, 2018-04-19:
In release v0.9.6 argument close in render method was removed.
What's the current way of returning rgb array.
In basic enviroments for example Mountain car:
```python
import gym

env = gym.make('MountainCar-v0')
    env.reset()
    while 1:
        env.step(env.action_space.sample())
        obs = env.render(mode='rgb_array')
    env.close()
```
The array is returned correctly but the window is still appearing.
This code will run server-side so I only need an array to pass on.

carlosgmartin, 2018-06-12:
I'm having the same issue. How can we render to an array without opening a window?

christopherhesse, 2019-03-22:
It's possible to do it without creating a visible window, but but until pyglet supports EGL rendering, this will still require an X11 server on linux.  Is the problem that the window is visible or that there is a window at all?

christopherhesse, 2019-04-19:
Closing due to lack of activity.

Closed 2019-04-19.

Thread 1015 (2018-04-24):

Box2d won't find some RAND_LIMIT_swigconstant

Omegastick, 2018-04-24:
As far as I'm aware, #100 isn't fixed, but is still closed. This has been acknowledged a couple of times in that issue but isn't being reopened for some reason.

A workaround is to uninstall box2d-kengz (`pip uninstall box2d-kengz`) then install [pybox2d](https://github.com/pybox2d/pybox2d).

Can we get pybox2d as a dependency for gym perhaps?

brtknr, 2018-05-07:
i also have this issue

aransena, 2018-06-07:
Just to pitch in as I haven't seen this particular error/solution noted previously, I've just had this same issue and found it was due to missing a package that would cause an error during Box2D installation, but not stop the installation process.

First uninstall Box2D
`pip uninstall Box2D`

If you try reinstall with pip install Box2D, and see this launchpadlib error
`launchpadlib 1.10.3 requires testresources, which is not installed.`

Uninstall Box2D again, and then install testresources
`pip install testresources`

Then finally resintall Box2D, hopefully now your code runs.
`pip install Box2D`

DuaneNielsen, 2018-07-19:
Yeah, I just hit this same issue on gym.__version__ 0.10.5.  In fact, Box2D did not correctly install as a dependency of gym, then when manually installed, it borks with this "rand_int" error.  Perhaps Box2D was not the best design choice?  Maybe it should be replaced with something more reliable?

alexp9982, 2018-07-26:
Thank you so much aransena, you have fixed my problem!

avilay, 2018-11-12:
## Install [pybox2d](https://github.com/pybox2d/pybox2d) (not available on pypi) instead of Box2D

Hit this issue on Debian 9. Had swig 3.0.10 (this is the one that is installed by default upon running)
```
sudo apt install swig
```

My issue was that I was installing a Python package called Box2D. But when I uninstalled Box2D and installed pybox2d (https://github.com/pybox2d/pybox2d) everything started to work. Note, pybox2d is not available on pypi, so you have to install it following the instructions in INSTALL.md in the github repo. But here it is for your convenience:

#### Download the repo
    wget https://github.com/pybox2d/pybox2d/archive/master.zip

#### Unzip the source
    unzip master.zip

#### Change directory to the unzipped directory
    cd pybox2d-master

#### Build Box2D
This is the original Box2D C++ package found here (https://box2d.org/) and does not own the Python package Box2D.

    python3 setup.py build

Ignore all warnings it shows.

#### Install pybox2d
    python3 setup.py install

Depending on python3 installation, you might have to run the last command with a `sudo`.

christopherhesse, 2019-03-22:
This should be fixed with `box2d-py` (not `pybox2d`) that we now use in setup.py, please file a new issue if that is not the case: https://github.com/openai/gym/blob/master/setup.py#L11

Kamier1, 2023-05-30:
> Thank you so much ！
pip install --user box2d-py==2.3.5

Closed 2019-03-22.

Thread 1050 (2018-05-24):

gym.wrappers.Monitor does not record the correct video on mujoco locomotion environments

zihualiu, 2018-05-24:
`gym.wrappers.Monitor` returns an image of 500x500 section of the screen instead of a full recording of the agent. This problem is only applicable to mujoco environments such as HalfCheetah-v2, Hopper-v2 and is fine for many Atari environments. This problem is also replicable on mac and Ubuntu 16.04.

Minimally reproducible code:
```
import gym
from gym.wrappers import Monitor
env = gym.make('HalfCheetah-v2')
env = Monitor(env, './video')
env.reset()
while True:
	env.render()
	obs, r, done, info = env.step([0,0,0,0,0,0])
	if done: break
```

hzyjerry, 2018-05-30:
I have the same issue

matthiasplappert, 2018-05-30:
Can you re-try this with the lastest version on master? We have just merged a fix for Mujoco rendering that should hopefully help here.

sharma-arjun, 2018-09-11:
I just pulled in the latest master and built it, but it is still not fixed.

christopherhesse, 2019-03-29:
I can't reproduce this issue anymore, is anyone still able to reproduce it?

anandtrex, 2019-04-10:
I still have the problem.
I get this particular warning:
```
/home/anand/.virtualenvs/rl-online/lib/python3.5/site-packages/gym/logger.py:30: UserWarning: WARN: Tried to pass invalid video frame, marking as broken: Your frame has shape (0, 0, 3), but the VideoRecorder is configured for shape (400, 600, 3).
  warnings.warn(colorize('%s: %s'%('WARN', msg % args), 'yellow'))
```

jaekyeom, 2019-04-11:
I haven't tried reproducing this issue, but these might be related: #953 #1182

Rowing0914, 2019-07-17:
I am having the same issue.

```
/usr/local/bin/python3.6 /home/username/Desktop/research/TF_RL/test/MuJoCo/mujoco_recording_test.py
Found 1 GPUs for rendering. Using device 0.
Traceback (most recent call last):
  File "/home/noio0925/Desktop/research/TF_RL/test/MuJoCo/mujoco_recording_test.py", line 5, in <module>
    env.reset()
  File "/usr/local/lib/python3.6/site-packages/gym/wrappers/monitor.py", line 39, in reset
    self._after_reset(observation)
  File "/usr/local/lib/python3.6/site-packages/gym/wrappers/monitor.py", line 188, in _after_reset
    self.reset_video_recorder()
  File "/usr/local/lib/python3.6/site-packages/gym/wrappers/monitor.py", line 209, in reset_video_recorder
    self.video_recorder.capture_frame()
  File "/usr/local/lib/python3.6/site-packages/gym/wrappers/monitoring/video_recorder.py", line 101, in capture_frame
    frame = self.env.render(mode=render_mode)
  File "/usr/local/lib/python3.6/site-packages/gym/core.py", line 233, in render
    return self.env.render(mode, **kwargs)
  File "/usr/local/lib/python3.6/site-packages/gym/envs/mujoco/mujoco_env.py", line 134, in render
    self._get_viewer(mode).render(width, height, camera_id=camera_id)
  File "/usr/local/lib/python3.6/site-packages/gym/envs/mujoco/mujoco_env.py", line 161, in _get_viewer
    self.viewer = mujoco_py.MjRenderContextOffscreen(self.sim, -1)
  File "mujoco_py/mjrendercontext.pyx", line 43, in mujoco_py.cymj.MjRenderContext.__init__
  File "mujoco_py/mjrendercontext.pyx", line 108, in mujoco_py.cymj.MjRenderContext._setup_opengl_context
  File "mujoco_py/opengl_context.pyx", line 128, in mujoco_py.cymj.OffscreenOpenGLContext.__init__
RuntimeError: Failed to initialize OpenGL

Process finished with exit code 1
```

Closed 2019-12-11.

Thread 1083 (2018-06-22):

Bug in multi-dimensional continuous action space envs: single dimension action gets accepted by environment and circumvent Halfcheetah movement penalty

watchernyu, 2018-06-22:
Hi! Would like to report a possible bug, when testing with the HalfCheetah-v2 environment, we find that if you just do env.step() with one single action (instead of a 6-dim action vector specified by the env.action_space), things actually work and the underlying code is extending this one action to a list of the same actions, and you also circumvent HalfCheetah-v2's penalty calculation for 5 out of 6 actions, the result is that you are getting much higher rewards from the environment although your model is not learning as much. Not sure if this is a problem that people are aware of?

I have written the following simple test code to show this bug. If you just put in a scalar action (e.g. 1) to env.step(), it works without giving an error, and also your reward is much higher compared to if you input a vector (1,1,1,1,1,1), if you give an action of 0, the reward is same compared to (0,0,0,0,0,0). If you give a vector of dimension 2-5, there actually will be error message, but a single action works just fine.

The major problem is that for HalfCheetah-v2, a well-trained agent achieves performance approximately the same as an agent that trained on giving only 1 action while getting much higher reward from the environment through this bug, this information can be very misleading for researchers using this environment.

This might also be a problem for other mujoco environments, I'm not sure. Would be great if this can be fixed in future versions! Thanks!

`
import numpy as np
import gym

envname = 'HalfCheetah-v2'
print("testing for ",envname)
env = gym.make(envname)
discrete = isinstance(env.action_space, gym.spaces.Discrete)
print("discrete env: ", discrete)
if discrete:
    n_action = env.action_space.n
else:
    n_action = env.action_space.shape[0]
test_action = 1 ## if test action is 0, then there is no difference in penalty

#######################################
env.seed(100)
np.random.seed(100)

for i_episode in range(5):
    total_reward = 0
    observation = env.reset()
    for t in range(100):
        # env.render()
        action =test_action ## use one single action actually works without error
        observation, reward, done, info = env.step(action)
        total_reward += reward
        if done or t==100-1:
            print("Episode finished, r:",total_reward)
            break

print('#################################')
env.seed(100)
np.random.seed(100)

for i_episode in range(5):
    total_reward = 0
    observation = env.reset()
    for t in range(100):
        # env.render()
        ## this should be the same as using one single action
        ## but gives much higher penalty
        action = [test_action for _ in range(n_action)]
        observation, reward, done, info = env.step(action)
        total_reward += reward
        if done or t==100-1:
            print("Episode finished, r:",total_reward)
            break

print('#################################')
## this part gives the error
## trace the error and can see that
"""
  File "/home/watcher/Desktop/gym/gym/envs/mujoco/half_cheetah.py", line 12, in step
    self.do_simulation(action, self.frame_skip)
    ## in here we can see this line
    reward_ctrl = - 0.1 * np.square(action).sum()
    ## which calculates the penalty for big actions, and this part will be circumvented
    ## if your input action is 1-dim instead of 6-dim
    ## then you get less penalty and no error or warning
File "/home/watcher/Desktop/gym/gym/envs/mujoco/mujoco_env.py", line 104, in do_simulation
    self.sim.data.ctrl[:] = ctrl
    ## this part seems to extend a single action to a list of actions
"""
env.seed(100)
np.random.seed(100)

for i_episode in range(5):
    total_reward = 0
    observation = env.reset()
    for t in range(100):
        # env.render()
        action = env.action_space.sample()
        action = [test_action for _ in range(2)]
        observation, reward, done, info = env.step(action)
        total_reward += reward
        if done or t==100-1:
            print("Episode finished, r:",total_reward)
            break
`

jkterry1, 2022-05-23:
PR #2762 is about to be merged, introducing V4 MuJoCo environments using new bindings and a dramatically newer version of the engine. If this issue still persists with the V4 ones, please create a new issue for it.

Closed 2022-05-23.

Thread 1086 (2018-06-26):

Error installing gym

HamKenza, 2018-06-26:
I tried to install gym on a server 'pip install gym' but I get the following error:

Failed building wheel for atari-py
  Running setup.py clean for atari-py
Failed to build Box2D-kengz atari-py
Installing collected packages: pyglet, chardet, urllib3, idna, requests, PyOpenGL, imageio, glfw, pycparser, cffi, Cython, mujoco-py, Box2D-kengz, atari-py, gym

Exception:
Traceback (most recent call last):
  File "/usr/local/lib/python2.7/dist-packages/pip/basecommand.py", line 215, in main
    status = self.run(options, args)
  File "/usr/local/lib/python2.7/dist-packages/pip/commands/install.py", line 342, in run
    prefix=options.prefix_path,
  File "/usr/local/lib/python2.7/dist-packages/pip/req/req_set.py", line 784, in install
    **kwargs
  File "/usr/local/lib/python2.7/dist-packages/pip/req/req_install.py", line 851, in install
    self.move_wheel_files(self.source_dir, root=root, prefix=prefix)
  File "/usr/local/lib/python2.7/dist-packages/pip/req/req_install.py", line 1064, in move_wheel_files
    isolated=self.isolated,
  File "/usr/local/lib/python2.7/dist-packages/pip/wheel.py", line 345, in move_wheel_files
    clobber(source, lib_dir, True)
  File "/usr/local/lib/python2.7/dist-packages/pip/wheel.py", line 323, in clobber
    shutil.copyfile(srcfile, destfile)
  File "/usr/lib/python2.7/shutil.py", line 84, in copyfile
    copyfileobj(fsrc, fdst)
IOError: [Errno 28] No space left on device

leonardoaraujosantos, 2018-06-27:
Hi @HamKenza, sorry for the lame answer but IMHO the issue seems disk space (check the last message)
```IOError: [Errno 28] No space left on device```

christopherhesse, 2019-03-09:
You should free up some disk space, thanks for answering @leonardoaraujosantos

Closed 2019-03-09.

Thread 1091 (2018-07-02):

Rendering slowly in server

Cuiyirui, 2018-07-02:
My system environment is CentOS, and I can run the demo successfully. The speed of rendering, however, is very very slow, approximate 1 frame per second.
My code is:

> import gym
import time
env = gym.make('CartPole-v0')   # create enviroment
env.mode = 'fast'
observation = env.reset()  # start the process
print(env.action_space)    #action space
print(env.observation_space) # observation space
for i in range(1000):
    env.render()
    print(i)
    env.step(env.action_space.sample()) # take a random action

When I comment "env.render()", the program can run normally.

vishma, 2018-09-06:
I faced the same issue. I think it has to do something with your pyglet versions installed in python environment. As a workaround you can create a virtual environment using conda/pipenv and install gym and other required dependencies. A fresh install worked for me.

conda : https://conda.io/docs/user-guide/tasks/manage-environments.html
pipenv : https://pipenv.readthedocs.io/en/latest/install/#installing-packages-for-your-project

christopherhesse, 2019-02-16:
Thanks for answering this @vishma!  There could also be some issue with your linux setup that causes slow rendering.

Closed 2019-02-16.

Thread 1094 (2018-07-09):

TypeError: 'NoneType' object is not iterable

boyliwensheng, 2018-07-09:
when I run in pycharm with this code.
`import gym`
`env= gym.make('CartPole-v0')`
` env.reset()`
` env.render()`

 I got a error :TypeError: 'NoneType' object is not iterable.  Can you tell me what's wrong with it

mpSchrader, 2018-07-10:
Can you give more information, like version, full trace?

lucko515, 2018-07-17:
Hello, I have the same error.

Here is the trace:

 [33mWARN: gym.spaces.Box autodetected dtype as <class 'numpy.float32'>. Please provide explicit dtype. [0m
Exception ignored in: <bound method Viewer.__del__ of <gym.envs.classic_control.rendering.Viewer object at 0x7fa46c038400>>
Traceback (most recent call last):
  File "/home/luka/Documents/rl/gym/gym/envs/classic_control/rendering.py", line 143, in __del__
  File "/home/luka/Documents/rl/gym/gym/envs/classic_control/rendering.py", line 62, in close
  File "/home/luka/anaconda3/envs/rl/lib/python3.5/site-packages/pyglet/window/xlib/__init__.py", line 480, in close
  File "/home/luka/anaconda3/envs/rl/lib/python3.5/site-packages/pyglet/gl/xlib.py", line 345, in destroy
  File "/home/luka/anaconda3/envs/rl/lib/python3.5/site-packages/pyglet/gl/base.py", line 334, in destroy
  File "/home/luka/anaconda3/envs/rl/lib/python3.5/site-packages/pyglet/gl/xlib.py", line 335, in detach
  File "/home/luka/anaconda3/envs/rl/lib/python3.5/site-packages/pyglet/gl/lib.py", line 97, in errcheck
  File "<frozen importlib._bootstrap>", line 969, in _find_and_load
  File "<frozen importlib._bootstrap>", line 954, in _find_and_load_unlocked
  File "<frozen importlib._bootstrap>", line 887, in _find_spec
TypeError: 'NoneType' object is not iterable

Magic-wei, 2018-07-24:
I had the same error.
- my OS is ubuntu 16.04 LTS, and
- I install gym from source, master branch

I tested the codes like this:
```python
#! /usr/bin/env python3
# -*- coding = utf-8 -*-

import gym
env = gym.make('CartPole-v0')
for i_episode in range(20):
    observation = env.reset()
    for t in range(100):
        env.render()
        print(observation)
        action = env.action_space.sample()
        observation, reward, done, info = env.step(action)
        if done:
            print("Episode finished after {} timesteps".format(t+1))
            break
```
And the trace is here ~ (I show some info before this error, it maybe helpful to figure out the problem)
```bash
[-0.04731956 -0.03730637 -0.0084249  -0.02162919]
[-0.04806568  0.15793539 -0.00885748 -0.31695832]
[-0.04490698  0.35318237 -0.01519665 -0.61242138]
[-0.03784333  0.15827606 -0.02744508 -0.32456331]
[-0.03467781  0.35377783 -0.03393634 -0.62577336]
[-0.02760225  0.15914563 -0.04645181 -0.34396854]
[-0.02441934 -0.03528578 -0.05333118 -0.06628795]
[-0.02512505  0.16055863 -0.05465694 -0.37530881]
[-0.02191388  0.3564126  -0.06216312 -0.68471221]
[-0.01478563  0.55234003 -0.07585736 -0.99629988]
[-0.00373883  0.35830996 -0.09578336 -0.72837245]
[ 0.00342737  0.55461632 -0.11035081 -1.04959954]
[ 0.0145197  0.7510154 -0.1313428 -1.3747836]
[ 0.02954     0.55775656 -0.15883847 -1.12589602]
[ 0.04069514  0.75456248 -0.18135639 -1.46389111]
Episode finished after 15 timesteps
[ 0.01058637  0.02918534  0.00631525  0.01827018]
[ 0.01117008  0.22421616  0.00668065 -0.27241354]
[ 0.0156544   0.41924215  0.00123238 -0.5629819 ]
[ 0.02403924  0.22410292 -0.01002725 -0.26991096]
[ 0.0285213   0.02912549 -0.01542547  0.01959252]
[ 0.02910381  0.22446522 -0.01503362 -0.27791713]
[ 0.03359312  0.41979838 -0.02059197 -0.57530348]
[ 0.04198908  0.22497106 -0.03209803 -0.28917806]
[ 0.04648851  0.42053567 -0.0378816  -0.59180908]
[ 0.05489922  0.61616691 -0.04971778 -0.89617994]
[ 0.06722256  0.8119264  -0.06764138 -1.20406733]
[ 0.08346108  1.00785437 -0.09172272 -1.51715862]
[ 0.10361817  1.20395833 -0.1220659  -1.83700673]
[ 0.12769734  1.40019978 -0.15880603 -2.16497693]
[ 0.15570133  1.20694772 -0.20210557 -1.92523942]
Episode finished after 15 timesteps
Exception ignored in: <bound method Viewer.__del__ of <gym.envs.classic_control.rendering.Viewer object at 0x7ff378b69048>>
Traceback (most recent call last):
  File "/home/wangwei/github/OpenAI/gym/gym/envs/classic_control/rendering.py", line 143, in __del__
  File "/home/wangwei/github/OpenAI/gym/gym/envs/classic_control/rendering.py", line 62, in close
  File "/usr/local/lib/python3.5/dist-packages/pyglet/window/xlib/__init__.py", line 480, in close
  File "/usr/local/lib/python3.5/dist-packages/pyglet/gl/xlib.py", line 345, in destroy
  File "/usr/local/lib/python3.5/dist-packages/pyglet/gl/base.py", line 334, in destroy
  File "/usr/local/lib/python3.5/dist-packages/pyglet/gl/xlib.py", line 335, in detach
  File "/usr/local/lib/python3.5/dist-packages/pyglet/gl/lib.py", line 97, in errcheck
  File "<frozen importlib._bootstrap>", line 969, in _find_and_load
  File "<frozen importlib._bootstrap>", line 954, in _find_and_load_unlocked
  File "<frozen importlib._bootstrap>", line 887, in _find_spec
TypeError: 'NoneType' object is not iterable
```

Magic-wei, 2018-07-24:
@boyliwensheng  maybe it's better to add label **_help wanted_** to this issue.

sunjeet95, 2018-07-27:
Even I am having the same error:

`UserWarning: DEPRECATION WARNING: to improve load times, gym no longer automatically loads gym.spaces. Please run "import gym.spaces" to load gym.spaces on your own. This warning will turn into an error in a future version of gym.
  warnings.warn('DEPRECATION WARNING: to improve load times, gym no longer automatically loads gym.spaces. Please run "import gym.spaces" to load gym.spaces on your own. This warning will turn into an error in a future version of gym.')
WARN: gym.spaces.Box autodetected dtype as <class 'numpy.float32'>. Please provide explicit dtype.
WARN: You are calling 'step()' even though this environment has already returned done = True. You should always call 'reset()' once you receive 'done = True' -- any further steps are undefined behavior.
Exception ignored in: <bound method Viewer.__del__ of <gym.envs.classic_control.rendering.Viewer object at 0x7f29a40d49e8>>
Traceback (most recent call last):
  File "/home/sunjeet/gym/gym/envs/classic_control/rendering.py", line 143, in __del__
  File "/home/sunjeet/gym/gym/envs/classic_control/rendering.py", line 62, in close
  File "/home/sunjeet/anaconda2/envs/tensorflow_gpu_python3/lib/python3.5/site-packages/pyglet/window/xlib/__init__.py", line 480, in close
  File "/home/sunjeet/anaconda2/envs/tensorflow_gpu_python3/lib/python3.5/site-packages/pyglet/gl/xlib.py", line 345, in destroy
  File "/home/sunjeet/anaconda2/envs/tensorflow_gpu_python3/lib/python3.5/site-packages/pyglet/gl/base.py", line 334, in destroy
  File "/home/sunjeet/anaconda2/envs/tensorflow_gpu_python3/lib/python3.5/site-packages/pyglet/gl/xlib.py", line 335, in detach
  File "/home/sunjeet/anaconda2/envs/tensorflow_gpu_python3/lib/python3.5/site-packages/pyglet/gl/lib.py", line 97, in errcheck
  File "<frozen importlib._bootstrap>", line 968, in _find_and_load
  File "<frozen importlib._bootstrap>", line 953, in _find_and_load_unlocked
  File "<frozen importlib._bootstrap>", line 887, in _find_spec
TypeError: 'NoneType' object is not iterable
`

sunjeet95, 2018-07-27:
Even I am the same exact error.

Magic-wei, 2018-07-29:
@mpSchrader More info has been given here. Please help us if you have time. Thx.

mpSchrader, 2018-07-29:
Hi guys,

 For me it looks like it is a problem when Python is shutting down and an environment has been render previously.
 My observation is that everything is working well as long as Python is not shut down. When I run the code as a script I get the error right away. On the other hand when I run the code in the Python shell, I don't get the code right away. The error occurs as soon as I exit the shell.

Overall the problem only occurs when you render the environment. From my point of view this is just a rendering problem.

I will try to find the bug. Nevertheless you should be good to go develop your own code and ignore the error for now!

Best,
Max

mpSchrader, 2018-07-29:
Small addition:
The problem does not occur when you probperly close the env bevor shutting down Python.
Here the proper code:

```Python
import gym
env = gym.make('CartPole-v0')
for i_episode in range(20):
    observation = env.reset()
    for t in range(100):
        env.render()
        print(observation)
        action = env.action_space.sample()
        observation, reward, done, info = env.step(action)
        if done:
            print("Episode finished after {} timesteps".format(t+1))
            print((i_episode+1), "/", 20)
            break
env.close()

```

mpSchrader, 2018-07-29:
Please confirm that this solves your problem! @boyliwensheng
If so please close the issue! :smile:

Magic-wei, 2018-07-29:
@mpSchrader It works! Thank you for help!

pglombardo, 2018-10-12:
This solved the issue for me as well.  Thanks.

HightMike, 2018-11-25:
Thank you

mpSchrader, 2018-12-02:
Hi @YMMS,

the problem result from the following lines:
```python
env = gym.make('CartPole-v0')
...
env = wrappers.Monitor(env, directory=outdir, force=True)
...
env.close()
```
I will explain you why. First you create a regular CartPole environment, which you then use to create a wrapped environment, so you no have two environments. But in the end you only close the wrapped environment.
One solution for that could look as follows:

```python
import gym
from gym import wrappers, logger

logger.set_level(logger.INFO)
env_to_wrap = gym.make('CartPole-v0')
outdir = './random-agent-results'
env = wrappers.Monitor(env_to_wrap, directory=outdir, force=True)
#env = wrappers.Monitor(env, force=True)
for i_episode in range(20):
    observation = env.reset()
    for t in range(100):
        env.render()
        print(observation)
        action = env.action_space.sample()
        observation, reward, done, info = env.step(action)
        if done:
            print("Episode finished after {} timesteps".format(t+1))
            print((i_episode+1), "/", 20)
            break
env.close()
env_to_wrap.close()
```

You should always close every environment you created.
I hope this helps! :-)

YMMS, 2018-12-05:
@mpSchrader Thank you, it works

brandonskerritt, 2018-12-20:
Hey, I still get the NoneType error despite closing my environments

```python
import gym
import numpy as np
from gym import wrappers

# instantiate a gym environment
# version 0 because that's the latest version available for this
env = gym.make('CartPole-v0')

done = False
count = 0

best_length = 0
episode_lengths = []
best_weights = np.zeros(4)
length = []

for i in range(100):
    # allows us to make an more intelligent decision about moving right or left
    # if positive move right, if negative move left
    new_weights = np.random.uniform(-1.0, 1.0, 4)
    length = []
    for j in range(100):
        # you must reset the environment before you use it
        observation = env.reset()
        done = False
        count = 0
        while not done:
            # render the environment visually
            #env.render()
            count += 1

            action = 1 if np.dot(observation, new_weights) > 0 else 0

            # we need to decide an action. either left or right
            # this api gives us a random action from its possible sample space
            # action= env.action_space.sample()

            # vector with 4 quantities, position, cart, angle of pole
            observation, reward, done, info = env.step(action)

            if done:
                break
        length.append(count)

    average_length = float(sum(length) / len(length))

    if average_length > best_length:
        best_length = average_length
        best_weights = new_weights

    episode_lengths.append(average_length)
    if i % 19 == 0:
        print('best length is ', best_length)

done = False
count = 0
# records it
env_to_wrap = gym.make('CartPole-v0')
env = wrappers.Monitor(env_to_wrap, 'MovieFiles', force=True)
#observation = env.reset()

while not done:
    # render the environment visually
    #env.render()
    count += 1

    action = 1 if np.dot(observation, best_weights) > 0 else 0
    observation, reward, done, info = env.step(action)

print('with best weights game lasted ', count)

env.close()
env_to_wrap.close()
```

Any suggestions?

PixnBits, 2018-12-22:
This occurs for me when running the example that uses the done flag in https://gym.openai.com/docs/
I can't find the repo/branch for that site but would like to open a PR to add the `env.close` line if someone knows where that is?

sprakasdash, 2018-12-24:
@brandonskerritt It shows no error when you write:
 `observation = env.reset()` before the second `while not done:` statement.

asdalow, 2019-01-08:
@brandonskerritt
########################## You do:
env = gym.make('CartPole-v0')
env_to_wrap = gym.make('CartPole-v0')
env = wrappers.Monitor(env_to_wrap, 'MovieFiles', force=True)
env.close()
env_to_wrap.close()
########################## You should do:
env = gym.make('CartPole-v0')
env_to_wrap = gym.make('CartPole-v0')
env_wrapped = wrappers.Monitor(env_to_wrap, 'MovieFiles', force=True)
env.close()
env_to_wrap.close()
env_wrapped.close()

christopherhesse, 2019-02-09:
Thanks for looking into this @mpSchrader!

Abhimanyu8713, 2019-02-23:
Thanks it worked.

zhaoyucong, 2019-05-22:
@mpSchrader
Traceback (most recent call last):
  File "VDSR.py", line 161, in <module>
    for w in weights:
TypeError: 'NoneType' object is not iterable

part code：
weights=weights_o.append(weights_w)

	for w in weights:
		loss += tf.nn.l2_loss(w)*1e-4
I am not the reason,can you help me

mpSchrader, 2019-05-22:
Hi @zhaoyucong,
This does not look like a gym issue to me. It looks like the weights you try to iterate over are not a list.
`append` is a inplace function and there for returns the type `None`. Your error there for is in the line:
`weights=weights_o.append(weights_w)`

Closed 2019-02-09.

Thread 1175 (2018-09-22):

Breakout-v4 does not step

nevakanezzar, 2018-09-22:
Environment for Breakout-v4 does not step in case it is provided only 0, 2, or 3 as actions.

Minimum Working Example:

```
import gym

GAME = "Breakout-v4"
#GAME = "MsPacman-v4"

env = gym.make(GAME)
env.reset()

while 1:
    aa = 0 #env.action_space.sample()
    _,_,e_done,_ = env.step(aa)
    print(aa)
    env.render()
    if e_done:
        break

env.close()
```

This currently hangs. aa = 2 and aa = 3 do not work either.

Replacing the game with MsPacman-v4 works as expected. Replacing aa = 0 with actions sampled from env.action_space works as expected.

pzhokhov, 2018-10-23:
This is not a bug, but a property of Breakout. In the starting state, the game waits for player(actor) to hit fire (action 1). Game starts with 5 lives; and every time player (actor) fails to return the ball, number of lives goes down and the game waits for fire again. Hence, if you pass constant actions that are not 1, the actual game never starts.

You should try playing the game yourself with the keyboard, it is fun :) You can use the following script (may need a couple of extra dependencies though):
```
import gym
from gym.utils.play import play

GAME = "Breakout-v4"
# GAME = "MsPacman-v4"

env = gym.make(GAME)
play(env)
```
A key is left, D is right, space is fire.

Closed 2018-10-23.

Thread 1184 (2018-10-03):

MountainCarContinuous-v0 NaN reward

TM6501, 2018-10-03:
The MountainCarContinuous-v0 environment occasionally returns 'NaN' as the return reward from the environment.step(action) function call.

I've been unable to reproduce it consistently, though it is frequent and generally after it happens once, all subsequent calls to environment.step() will return a 'NaN' reward until the environment is reset.

ishan00, 2018-10-09:
Hello, I tried to reproduce this but was unable to do so. Could you please post the observation of the environment (ie `[position, velocity]`) when the reward turns NaN.

Also I looked at the code of `step` for MountainCarContinuous which I am copying below. I couldn't find any line where NaN might appear. It may be the case that the action you are providing to the environment is itself NaN in which case the `math.pow` will return NaN.

https://docs.python.org/2/library/math.html#math.pow

```python
def step(self, action):

        position = self.state[0]
        velocity = self.state[1]
        force = min(max(action[0], -1.0), 1.0)

        velocity += force*self.power -0.0025 * math.cos(3*position)
        if (velocity > self.max_speed): velocity = self.max_speed
        if (velocity < -self.max_speed): velocity = -self.max_speed
        position += velocity
        if (position > self.max_position): position = self.max_position
        if (position < self.min_position): position = self.min_position
        if (position==self.min_position and velocity<0): velocity = 0

        done = bool(position >= self.goal_position)

        reward = 0
        if done:
            reward = 100.0
        reward-= math.pow(action[0],2)*0.1

        self.state = np.array([position, velocity])
        return self.state, reward, done, {}
```

TM6501, 2018-10-09:
When attempting to collect observations to post here, I found that what you suspected is true: NaN is only returned when NaN is passed in.  So, the bug is in my agent, not in the environment.   If you're still interested, I get observations of [nan nan] when the reward is nan.

Sorry to have wasted your time; I wasn't aware of this bug in my code as it seems to only crop up with this particular environment.

Closed 2018-10-09.

Thread 1193 (2018-10-09):

Are Half Cheetah and other Mujoco environments deterministic ?

anchit, 2018-10-09:
We have noticed that some of the Mujoco envs Half Cheetah in particular is not deterministic i.e taking the exact same action from the same state can result in different next states. Here is a minimal script to reproduce the issue. (It terminates after during the 21st iteration)
```python
"""
Gym Environment Testing for a trajectory.

This script records a full (s0, a0, s1, a1, ..., sn) trajectory on a gym env.

It then runs the following tests.

Test 1 - Force simulator to state s0. Play a0, a1, ..., a(n-1) and assert state is sn.
Test 2 - Force simulator to state s1. Play a1, ..., a(n-1) and assert state is sn.
Test 3 - Force simulator to state s0. Play a0. Assert state is s1.
         Next, force simulator to state s1. Play a1, ..., a(n-1) and assert state is sn.

Notes:
     HalfCheetah playback fails after 20th iteration...
"""

import numpy as np
import gym

env_name = "HalfCheetah-v2"
# env_name = "FetchPush-v1"

for _ITER in range(1000):
    print(_ITER)
    states = []
    actions = []

    env = gym.make(env_name)
    env.seed(1234)
    o0 = env.reset()
    # env.render()
    for i in range(100):
        s = env.env.sim.get_state().flatten()
        states.append(s)
        a = env.action_space.sample()
        actions.append(a)
        env.step(a)
        # env.render()

    s = env.env.sim.get_state().flatten()
    states.append(s)

    print("\nPLAYBACK from s0 \n")

    env = gym.make(env_name)
    env.seed(1234)
    env.reset()
    env.env.sim.set_state_from_flattened(states[0])
    env.env.sim.forward()
    # env.render()

    for i in range(100):
        env.step(actions[i])
        # env.render()

    print("state s is {}".format(env.env.sim.get_state().flatten()))
    print("state s should be {}".format(states[-1]))
    assert(np.allclose(env.env.sim.get_state().flatten(), states[-1]))

    print("\nPLAYBACK from s1 \n")

    env = gym.make(env_name)
    env.seed(1234)
    env.reset()
    env.env.sim.set_state_from_flattened(states[1])
    env.env.sim.forward()
    # env.render()

    for i in range(99):
        env.step(actions[i + 1])
        # env.render()

    print("state s is {}".format(env.env.sim.get_state().flatten()))
    print("state s should be {}".format(states[-1]))
    assert(np.allclose(env.env.sim.get_state().flatten(), states[-1]))

    print("\nPLAYBACK from s0, but force state at s1 \n")

    env = gym.make(env_name)
    env.seed(1234)
    env.reset()
    env.env.sim.set_state_from_flattened(states[0])
    env.step(actions[0])
    assert(np.allclose(env.env.sim.get_state().flatten(), states[1]))
    env.env.sim.set_state_from_flattened(states[1])
    env.env.sim.forward()
    # env.render()

    for i in range(99):
        env.step(actions[i + 1])
        # env.render()

    print("state s is {}".format(env.env.sim.get_state().flatten()))
    print("state s should be {}".format(states[-1]))
    assert(np.allclose(env.env.sim.get_state().flatten(), states[-1]))

    print("All tests passed!")
```

Mujoco according to its documentation and comments by Emo on the forums maintain that it is deterministic so we wanted to know what this source of non-determinism may be ?

zacwellmer, 2018-12-21:
Any updates on this?

alimuldal, 2019-06-04:
I suspect this comes from the fact that MuJoCo's constraint solver defaults to using warm-starts, so the previous solution can influence the constraint forces that are calculated for the next step after you reset the state (see [here](https://github.com/deepmind/dm_control/issues/64#issuecomment-442041584)).

You could try disabling warm-starts by setting `<flag warmstart="disabled"/>` [in the XML](http://www.mujoco.org/book/XMLreference.html#option-flag) (this will probably slow down your simulation), or you could [copy over the contents](http://www.mujoco.org/forum/index.php?threads/capturing-a-state-in-simulation.3956/) of `mjData->qacc_warmstart` when you reset the state.

cijerezg, 2022-04-15:
Any updates on this? Halfcheetah seems to be non-deterministic.

jkterry1, 2022-04-15:
So the answer is that it's supposed to be, but likely is not due to issues. This will be merged in the next week or so probably, and should fix this if all goes well: https://github.com/openai/gym/pull/2595

Closed 2022-04-15.

Thread 1197 (2018-10-12):

Import Error when trying to use custom environment

atrox1227, 2018-10-12:
I have created a custom environment to the exact specifications that are listed here:

https://github.com/openai/gym/tree/master/gym/envs

I have the exact file structure and init components listed. I have inserted the folder with all my files in the envs folder of the gym package (created a new folder for my environment, I didn't add it into any of the existing folders). I have added the registration of my environment into the main gym registration init, and it does work because the custom environment shows up when I give the command: print(envs.registry.all())

When I try the command:

gym.make('myEnv-v0')

I get the error:

ImportError: cannot import name 'myEnv'

Trace-back shows the error occurring in the init that is similar to:

"from gym_foo.envs.foo_env import FooEnv"

as is recommended in the link I gave above. I have spent hours trying the figure out how to fix this and would appreciate any help.

atrox1227, 2018-10-12:
I went into my code for the environment and noticed that instead of defining "render", I was instead defining "_render". Changed this and problem went away.

HarshayuGirase, 2019-10-22:
im getting the same error, but inside the render method im doing nothing

Closed 2018-10-12.

Thread 1198 (2018-10-12):

Fail to render gym environment in Pyenv installed python

mjlbach, 2018-10-12:
As context, I'm running all code locally on my Macbook Pro under MacOS Mojave 10.14.

Homebrew recently updated python to 3.7 which is currently not compatible with tensorflow. I reinstalled pyenv so I can manage my active python version and installed tensorflow + ai gym on 3.6.6. When I try to render an environment:

```
import gym
env = gym.make('CartPole-v0')
env.reset()

for i in range(1000):
    env.step(env.action_space.sample())
    env.render()
```

I get a blank rendering window when using the pyenv installed interpreter (3.6.6 and 3.7). When I use the hombrew installed intepreter (3.7) the rendering works fine.

Anyone else have this issue? I posted here as any suggestions as to what the majority of the community is using for their development environment (I've used conda, docker, and singularity before) would be welcome.

damienstanton, 2018-10-15:
I can confirm the same issue, in a similar environment (Python 3.7.0 and macOS 10.14). I have tried in a standalone script, called by the `python` and `ipython` interpreters, as well as a jupyter session.

In my case, the same problem occurs in both the system installed Python as well as in a `venv` module virtual environment. I do not use Anaconda.

venv:
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

System:
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

It is not pictured, but in both cases the mouse is in an infinite "beach ball" loop. I have to kill the kernel/interpreter in all cases.

pzhokhov, 2018-10-23:
@mjlbach @damienstanton your issues actually look different to me.
From what I understand, in @mjlbach 's case, rendering works with python 3.7, but does not with 3.6.6 in pyenv; whereas in @damienstanton 's case rendering does not work with with python 3.7.
Unfortunately, I have no good timeline for the fix (we don't have CI set up for osx - blame travis for lack of python support there, and I don't think anyone working on the gym has switched to Mojave just yet). However, @mjlbach , if you are open to use docker, you should have no problems - we have dockerfiles detailing installation on ubuntu 18.04 and 16.04. Also, if you don't want to deal with X forwarding from docker, but still would like to see what agents are going, it is possible to record and save the videos using VideoRecorder (https://github.com/openai/gym/blob/master/gym/wrappers/monitoring/video_recorder.py)
Sorry I cannot be more helpful here, as soon as I have a way to reproduce this, I'll get back to it.

mjlbach, 2018-10-23:
No worries! I just wanted to document the issue. I've been using gym in a docker environment with X forwarding. Thanks for the suggestion about recording videos!

damienstanton, 2018-10-24:
@mjlbach sounds like a great workaround in the meantime. Could you share how toy use x forwarding in this case for gym?

imanesh, 2018-11-04:
same problem here after upgrading the OSX to Mojave, any fix for this blank screen issue?

Abdisalan, 2018-11-15:
Same issue, using Mojave w/ Python 3.7.1

gauthiermartin, 2018-11-29:
Same issue using Mojave w/ Python 3.7.1

damienstanton, 2018-11-29:
@mjlbach
Can you share how you use
> I've been using gym in a docker environment with X forwarding.

gauthiermartin, 2018-11-30:
Simple pyenv in my local environment

Journerist, 2018-12-07:
same issue here running python 3.6.4 via pyenv

AL-JShen, 2018-12-26:
Same issue. Mojave 10.14.1 with Python 3.7.1.

gauthiermartin, 2018-12-27:
Does anyone other than @AL-JShen confirm that after updating to 10.14.2 the issue is fixed ?

AL-JShen, 2018-12-27:
@gauthiermartin

https://github.com/openai/gym/issues/1236

Check out this thread, a few others in there have also fixed their problems by updating.

damienstanton, 2018-12-28:
This is great news. Not to be too negative, but I'm very glad that my current Mac laptop is the last Mac I will be using professionally 🙂

mjlbach, 2018-12-28:
Closed because 10.14.2 fixes the issue, and alternative solutions (Docker, rendering to video) were available.

Closed 2018-12-28.

Thread 1230 (2018-11-20):

Time limits being handled incorrectly?

JulianoLagana, 2018-11-20:
I recently read the paper [Time Limits in Reinforcement Learning](https://arxiv.org/abs/1712.00378), where the authors discuss what are the correct ways of dealing with time limits in reinforcement learning. Unfortunately, it seems that `gym` is not adhering to these recommendations.

As it currently stands, the `time_limit` wrapper [overwrites the `done` flag returned by the environment to `True`](https://github.com/openai/gym/blob/a488c2fe2fbd4408ba9e193985ec2d86033cab6d/gym/wrappers/time_limit.py#L37) if a timeout ocurred. This makes it impossible for an agent to know whether an episode is being terminated because of a timeout or because the agent reached a terminal state, thus conflating both scenarios.

The problem with this is that now environments which are time limited are not fully observable anymore, hence not MDPs, since their termination function depends on something (time in this case), which is not observable for the agent.

In the paper the authors discuss the consequences of this to learning algorithms, and also show two ways to fix this issue. The first one is to simply add time as part of the state of the agent, if you really want the optimal policy of the MDP to be time-aware. I don't think this is in the spirit of most environments, and it increases the dimensionality of the state, which creates its own problems.

The second one works for value-based RL algorithms, like DDQN. In this, whenever the agent uses a transition to compute the gradients in which the resulting state (`s_prime`) is terminal, the agent computes its target as only the immediate reward, not bootstrapping from the value of the next state (so as to ground the value of the next state, which is terminal, to zero). **However**, if the agent uses a transition which resulted in a timeout, it **should bootstrap** from the value of the next state. This is why it seems necessary to either separate timeout flags from terminal flags, or leave the responsibility of restarting the episode for the user of the environment.

JulianoLagana, 2019-01-29:
This is still an issue. Any idea if this will be addressed?

christopherhesse, 2019-02-15:
The baselines TimeLimit wrapper seems to solve this: https://github.com/openai/baselines/blob/d80acbb4d1f8b3359c143543dd3f21a3b12679c8/baselines/common/retro_wrappers.py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

Would that work for you?  We may want to consider putting that in gym.

JulianoLagana, 2019-02-18:
Their wrapper has exactly the same problem, since [it overwrites the `done` flag when a timeout occurs](https://github.com/openai/baselines/blob/d80acbb4d1f8b3359c143543dd3f21a3b12679c8/baselines/common/retro_wrappers.py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).

By the way, I already solved it for my project by overwriting the gym's `time_limit` wrapper and adding some custom code. I created the issue because, based on my current understanding, the current implementation makes all time-limited environments unnecessarily more difficult to train. This is not a matter of adding functionality. It's about implementing time limits in the "correct" way (as in, time limits that don't transform the MDP into a POMDP, for instance).

christopherhesse, 2019-03-02:
Well if you can recover (`env_done`, `timeout_done`) from the info dict (which you can almost do with the one I linked), then the information would not be lost, right?  If you include the current step count along with the observation, that seems like it would make the MDP gym environments still MDPs.  Though for instance, the Atari environments are POMDPs.

JulianoLagana, 2019-03-04:
You are right, @christopherhesse. I overlooked the fact that the `info` dictionary has the relevant information for deciding if the `done` flag was overwritten.

You are also correct in saying that by adding the current step count to the observation retains observability in the MDP. However, the article I mentioned explains that this will actually yield a policy which is time-dependent (as in e.g., use the knowledge of whether or not it is close to the end of an episode to change its behavior). There are cases where this is indeed what we want (if the original environment is actually supposed to end after a certain amount of time-steps). However, in most scenarios we're adding the `TimeLimit` wrapper because the original environment does *not* terminate after a certain amount of time-steps, but we still want the episodes to not take too long, such that the training data has more diversity.

To illustrate what I wrote above, imagine a continuing environment where the agent is supposed to learn how to move horizontally as fast as possible (something like [Hopper](https://gym.openai.com/envs/Hopper-v2/), for instance). The optimal policy we're looking for is something that can be applied for an infinite amount of steps, and would give us the highest expected return. Probably something that learns how to move efficiently. If we add a time-limit to this environment (maybe to speed up training), at say, 500 time-steps, and add time as part of the observation, the agent could probably learn to make a big leap forward when the episode is close to an end, to maximize its horizontal displacement in exchange for probably falling. This is because the consequence of falling would never be accounted by the agent, since after falling (or maybe right before) the episode would end. This would definitely not be the policy we're looking for.

It would be much better in this particular case to do what they prescribe in [Time Limits in Reinforcement Learning](https://arxiv.org/abs/1712.00378) for these cases, which is bootstrapping from all transitions that ended in a terminal state due to a timeout (and not bootstrapping from all other terminal states, as usual). They showed that this actually yields the time-invariant policy we're looking for in this type of environments.

christopherhesse, 2019-03-22:
Sounds good, but I guess my question is, what needs to change in the TimeLimit wrapper to make it possible to do that?  I think the Gym TimeLimit wrapper should likely support this case, but bootstrapping from particular transitions sounds like it's up to the algorithm.

JulianoLagana, 2019-03-24:
One idea is:  when a time-out occurs, instead of [overwriting the `done` flag](https://github.com/openai/gym/blob/a488c2fe2fbd4408ba9e193985ec2d86033cab6d/gym/wrappers/time_limit.py#L37), add another key to the `info` dictionary that is set to `True`.

zuoxingdong, 2019-03-27:
@JulianoLagana Maybe it's a bit off topic here, I was quite curious about the effects on Time Limit in policy optimization.

I've tested VPG (+GAE) on `HalfCheetah-v2` and `Hopper-v2`, where the bootstrapping continues with the episode cut by Time Limit, i.e. do not set V(s_T) to zero if done=True at T is a result from Time Limit.

But it seems this does not give better final performance. I am wondering if this is expected.

JulianoLagana, 2019-03-28:
@zuoxingdong I suggest you read the [Time-limits paper I mentioned](https://arxiv.org/abs/1712.00378). It's not a hard read at all, and skimming it would probably give you a lot of insight already. In short, correctly handling the time limits won't necessarily give you a performance boost (it may even do the opposite, like I mentioned in the Hopper example previously). Sometimes it does facilitate learning, since learning an MDP is easier than a POMDP in general, which can result in better performance. But that's not the point of it. It's more about making sure that the policy you learn does not exploit artificial time-limits that you created only to increase data variety (or making sure that it does exploit time-limits that are not artificial, but are actually important parts of the task).

christopherhesse, 2019-03-29:
@JulianoLagana @zuoxingdong has a PR here: https://github.com/openai/gym/pull/1402 any objections?

JulianoLagana, 2019-04-01:
@christopherhesse I'm glad this is being addressed! I've added my thoughts to the PR.

ZhaomingXie, 2019-04-10:
Just wondering, why make it so complicated? A quick fix is just never reaches the time limit during training. Honestly, 1000 time steps for a typical Mujoco environment is too long for training purpose.

JulianoLagana, 2019-04-11:
@ZhaomingXie People usually cap the allowed number of time-steps as an easy way to increase data diversity.

christopherhesse, 2019-04-19:
The new timelimit wrapper from https://github.com/openai/gym/pull/1402 should let you recover the underlying `done` of the environment now.

Closed 2019-04-19.

Thread 1253 (2018-12-06):

Custom env - action_space & observation_space

bbartling, 2018-12-06:
Hi I am attempting to create a custom RL env with the step function and I was interested to learn a little more about what is needed for the action_space & observation_space.

There is not a lot of wisdom here on my end but in my Python class for the step function env I am just attempting:
```
    #possible actions from more_heat less heat functions
    self.action_space = np.array([ 0,  1,  2])

    #possible deviation values from temp - setpoint
    self.observation_space = np.arange(50,150,1)
```

The application that I am using it for is to drive an electronic control valve on a piping system where I am hoping to train an RL agent to maintain a temperature setpoint. So there are 3 available actions (not shown) that are functions for more_heat, less_heat, and do_nothing. And the possible ranges of temperatures that are possible for the sensor are values from 50 to 150 degrees. Is this what could be utilized in calculating a Q Table? Something like:

```
action_size = action_space
state_size = observation_space

qtable = np.zeros((state_size, action_size))
print(qtable)
```

But the problem is I get an error for `TypeError: only integer scalar arrays can be converted to a scalar index`

Thank you for any help, tips, wisdom here that I can apply on my quest!

bbartling, 2018-12-10:
I actually used this to print a Q table... But it maybe not best practice. I think this GitHub issue could deleted unless someone could post a best practice answer... Like how I could incorporate 15 buckets with a width of 5 instead of a 150.

```
action_size = action_space.shape[0]
state_size = observation_space.shape[0]
```

christopherhesse, 2019-03-01:
You should just use a `gym.spaces.Discrete` and then have the environment convert to the correct range.

So something like:

```
observation_space = gym.spaces.Discrete(100)
```

And when you have some output, you can convert it to an observation:
```
observation = output - 50
```

Closed 2019-03-01.

Thread 1267 (2018-12-27):

Value Error "Can not squeeze" for CarRacing-v0 environment

Bhaney44, 2018-12-27:
I have tried running the ppo, ddpg, and vpg for the CarRacing-v0 and continuously receive the same ValueError :

ValueError: Can not squeeze dim[1], expected a dimension of 1, got 96 for 'v/Squeeze' (op: 'Squeeze') with input shapes: [?,96,96,1].

Additionally, the below error also appears earlier in the output- invalidArgumentError:

tensorflow.python.framework.errors_impl.InvalidArgumentError: Can not squeeze dim[1], expected a dimension of 1, got 96 for 'v/Squeeze' (op: 'Squeeze') with input shapes: [?,96,96,1].

Below is the command line code I ran in bold and the script code for the VPG I ran. Both, returned the same result.

_Experiment 3
Changes = vpg_

**python -m spinup.run vpg --exp_name Car3 --env CarRacing-v0 --epochs 50 --data_dir /Users/brianhaney/Desktop/Gym/CarRacing --dt**

#results = returned non-zero exit status 1

    from spinup import vpg
    import tensorflow as tf
    import gym

    env_fn = lambda : gym.make('CarRacing-v0')

    ac_kwargs = dict(hidden_sizes=[64,64], activation=tf.nn.relu)

    logger_kwargs = dict(output_dir='path/to/output_dir', exp_name='experiment_name')

    vpg(env_fn=env_fn, ac_kwargs=ac_kwargs, steps_per_epoch=5000, epochs=250,
    logger_kwargs=logger_kwargs)

I am running TensorFlow Version: 1.10.1 on my machine. I'm not sure what the error means - other than some input dimensions for Tensorflow were off. The closest issue I have found on the internet was on [StackOverFlow](https://stackoverflow.com/questions/49083984/valueerror-can-not-squeeze-dim1-expected-a-dimension-of-1-got-3-for-sparse).

The correct response to the question on Stack explains - (vector labels must provide a single specific index for the true class for each row of logits. So, vector labels must include only class-indices.) But, I am not sure that answer is relevant in this case.

Going forward, I have three hypotheses about what is going wrong:
1. There is an issue with Tensorflow on my machine. However, I'm not sure what that could be.
2. There is an issue with the way the environment is being loaded on my machine. I have successfully run other Box2D environments - LunarLander and LunarLanderContinuous - on my machine. But, this error is relating to an input shape - which makes me think it could be an environment problem.
3. For some reason the code I am writing is buggy. I don't think this is the case because the code is pretty straight forward, I have successfully executed all three algorithms in other environments, and follows the same format as the [documentation](https://spinningup.openai.com/en/latest/algorithms/vpg.html). But, it is always a possibility.

I would really appreciate any help, ideas, or suggestions in resolving this issue. Thanks!

FlavioLorenzi, 2019-02-24:
Have you solved this problem??? I have the same now :(

Bhaney44, 2019-02-24:
@FlavioLorenzi I have not solved the problem yet. I have tried running the code on a new machine, but received the same problem. I still need to figure out what the error message:

"Can not squeeze dim[1], expected a dimension of 1, got 96 for 'v/Squeeze' (op: 'Squeeze') with input shapes: [?,96,96,1]."

means. My thought was to review and re-read the [TensorFlow Documentation](https://www.tensorflow.org/tutorials) to try and develop a solution. I am happy to help any way I can and will be sure to post a solution when I develop one!

FlavioLorenzi, 2019-02-24:
I don’t think that’s about TensorFlow but I think the problem is something about the different size of input output data flow between rl-algorithms and Car-Racing observation size(we have a vector of 3 elements: 96, 96, 3). In rl-algo it pretends a vector of size 1 in observation space.
Working with SAC algo I received another similiar error: Could not broadcast input array from shape (96,96,3) into shape (3).
I’m going crazy...

Bhaney44, 2019-02-24:
It sounds like you are ahead of me in trying to resolve the issue. I tried it with SAC, VPG, DDPG, and PPO and I got errors for all of them. What do you mean by: "the different size of input output data flow between rl-algorithms and Car-Racing observation size(we have a vector of 3 elements: 96, 96, 3)"?

FlavioLorenzi, 2019-02-24:
If you look the code, in the observation space of CarRacing, there is a vector (created by .Box) of shape STATE_H,STATE_W and 3 (with STATE=96 in the init part).
So we have a size of 3 elements that I think they describe resolution(number of pixel), while RL algorithms “expect a dimension of 1”.

SAC for example receives this vector as input in its obs-space, but it’s predifined for a code (like lunarLander) with a one-dimensional vector(there’s compatibility!).
So the problem is only whit Car Racing: how convert this sequence? And how “reshape” a vector that describe pixels? 😫

FlavioLorenzi, 2019-02-24:
I hope I was clear. It’s difficult also explain all this... Tell me if you not understand.
I started only yesterday to work on it, I hope to find solution soon. If you have any idea let me know!

Bhaney44, 2019-02-24:
That makes sense. Thanks for the description. I will let you know if I find anything further!

Bhaney44, 2019-02-26:
@FlavioLorenzi this [thread](https://github.com/openai/spinningup/issues/114) may be of help. However, I still cannot figure out how to run the modified SAC algorithm in the CarRacing-v0 environment. Let me know what you think.

FlavioLorenzi, 2019-02-26:
Yes, it seems that RL SpinningUp is only for codes with flat observations and not for image-like (pixel in the CarRacing). So we must create a new function that can take as input this type of image.
The problem is that I have no idea how.

Bhaney44, 2019-02-27:
@FlavioLorenzi This is a cool problem. I am going to work on it today and see what I can come up with.

christopherhesse, 2019-03-01:
I think @FlavioLorenzi is correct here, while Spinning up does support some of the Box2D environments, CarRacing-v0 uses pixel observations which it looks like are not supported.  This discussion should be moved to @FlavioLorenzi's issue on spinning up: https://github.com/openai/spinningup/issues/120

Bhaney44, 2019-03-02:
@FlavioLorenzi @FlavioLorenzi That makes absolutely no sense. "while Spinning up does support some of the Box2D environments, CarRacing-v0 uses pixel observations which "it looks like" are not supported." That description is laced with passive voice revealing a passive mind. Solving the problem of running a deep reinforcement learning algorithm for autonomous vehicle control in a 2-D environment does not require SpinningUp or CarRacing-v0. So it is irrelevant whether pixel observations are supported. Indeed, a convolutional neural network, by definition, observes pixels to make predictions about the value of current and future state-action pair values. [Flavio's Issue](https://github.com/openai/gym/issues/1267) is sufficiently different than this question. This question has not been answered and should be re-opened.

elsheikh21, 2019-03-12:
Did you find any solution for that yet or not???

Bhaney44, 2019-03-12:
No. Nothing.

FlavioLorenzi, 2019-03-12:
Me neither. I moved to another environment...

jachiam, 2019-03-14:
Hi all, author of Spinning Up here. Chiming in to confirm @christopherhesse: the default actor-critic code for SAC (and other algorithms in Spinning Up) creates MLP networks, which expect vector inputs and will produce errors for image-shaped inputs (as you have found). If you want to use the Spinning Up algorithm implementations with CarRacing-v0, you will have to write custom actor-critic functions that are compatible with image-shaped inputs.

Bhaney44, 2019-03-14:
@jachiam First of all, your work on SpinningUp is incredible. It is a phenomenal platform and I sincerely appreciate your hard work. Second, thanks for the response - that clears things up.

jachiam, 2019-03-14:
Glad to help! I also realized shortly after I made that post---there is a second issue for DDPG/TD3/SAC (which is not present, I believe, in VPG/TRPO/PPO). My DDPG/TD3/SAC code build replay buffers and placeholders for observations which also assume vector inputs, and these would need to be amended for the code to support image observations. The VPG/TRPO/PPO codes have examples of how to implement those (since their replay buffers and placeholders use `space.shape` as the basis for their sizes instead of `space.shape[0]`).

Bhaney44, 2019-03-17:
@jachiam @FlavioLorenzi @christopherhesse Would everyone be open to opening the issue because the problem hasn't been solved. A solution would require a modified SAC performing in the car racing environment. I am going to work on developing one. Once, I post it - or someone beats me to it - you can mark it closed. But, my issue still isn't fixed - so, this problem is not closed.

Bhaney44, 2019-03-18:
**This is the ppo I am running from the command line:**

`python -m spinup.run ppo --exp_name carr --env CarRacing-v0 --epochs 50 --data_dir /Users/brianhaney/Desktop --dt`

**This is the error I am getting:**

`Traceback (most recent call last):
  File "/Users/brianhaney/spinningup/spinup/utils/run_entrypoint.py", line 11, in <module>
    thunk()
  File "/Users/brianhaney/spinningup/spinup/utils/run_utils.py", line 162, in thunk_plus
    thunk(**kwargs)
  File "/Users/brianhaney/spinningup/spinup/algos/ppo/ppo.py", line 187, in ppo
    pi, logp, logp_pi, v = actor_critic(x_ph, a_ph, **ac_kwargs)
  File "/Users/brianhaney/spinningup/spinup/algos/ppo/core.py", line 103, in mlp_actor_critic
    v = tf.squeeze(mlp(x, list(hidden_sizes)+[1], activation, None), axis=1)
  File "/anaconda3/envs/spinningup/lib/python3.7/site-packages/tensorflow/python/util/deprecation.py", line 507, in new_func
    return func(*args, **kwargs)
  File "/anaconda3/envs/spinningup/lib/python3.7/site-packages/tensorflow/python/ops/array_ops.py", line 3146, in squeeze
    return gen_array_ops.squeeze(input, axis, name)
  File "/anaconda3/envs/spinningup/lib/python3.7/site-packages/tensorflow/python/ops/gen_array_ops.py", line 9043, in squeeze
    "Squeeze", input=input, squeeze_dims=axis, name=name)
  File "/anaconda3/envs/spinningup/lib/python3.7/site-packages/tensorflow/python/framework/op_def_library.py", line 788, in _apply_op_helper
    op_def=op_def)
  File "/anaconda3/envs/spinningup/lib/python3.7/site-packages/tensorflow/python/util/deprecation.py", line 507, in new_func
    return func(*args, **kwargs)
  File "/anaconda3/envs/spinningup/lib/python3.7/site-packages/tensorflow/python/framework/ops.py", line 3300, in create_op
    op_def=op_def)
  File "/anaconda3/envs/spinningup/lib/python3.7/site-packages/tensorflow/python/framework/ops.py", line 1823, in __init__
    control_input_ops)
  File "/anaconda3/envs/spinningup/lib/python3.7/site-packages/tensorflow/python/framework/ops.py", line 1662, in _create_c_op
    raise ValueError(str(e))
ValueError: Can not squeeze dim[1], expected a dimension of 1, got 96 for 'v/Squeeze' (op: 'Squeeze') with input shapes: [?,96,96,1].
`

_PPO Analysis_

First I am looking at the array_ops.py file and the ops.py file. But I don't know how these files relate to the gym enviornment or the ppo.py. One of the error lines says:

`packages/tensorflow/python/ops/gen_array_ops.py", line 9043, in squeeze "Squeeze", input=input, squeeze_dims=axis, name=name)`

But, the file isn't 9043 lines long - So, I don't know where to keep looking for the bug.

**This is the SAC I am running:**

`spinningup brianhaney$ python -m spinup.run sac --exp_name carr0 --env CarRacing-v0 --epochs 50 --data_dir /Users/brianhaney/Desktop`

**This is the error I am getting:**

`2019-03-17 20:14:43.643281: I tensorflow/core/platform/cpu_feature_guard.cc:141] Your CPU supports instructions that this TensorFlow binary was not compiled to use: AVX2 FMA
Track generation: 923..1158 -> 235-tiles track
Traceback (most recent call last):
  File "/Users/brianhaney/spinningup/spinup/utils/run_entrypoint.py", line 11, in <module>
    thunk()
  File "/Users/brianhaney/spinningup/spinup/utils/run_utils.py", line 162, in thunk_plus
    thunk(**kwargs)
  File "/Users/brianhaney/spinningup/spinup/algos/sac/sac.py", line 259, in sac
    replay_buffer.store(o, a, r, o2, d)
  File "/Users/brianhaney/spinningup/spinup/algos/sac/sac.py", line 24, in store
    self.obs1_buf[self.ptr] = obs
ValueError: could not broadcast input array from shape (96,96,3) into shape (96)`

_SAC Analysis_
In both instances there is an issue with an input array or shape. In the case of the SAC the error is coming from line 24, which is in bold:

`class ReplayBuffer:
    """
    A simple FIFO experience replay buffer for SAC agents.
    """

    def __init__(self, obs_dim, act_dim, size):
        self.obs1_buf = np.zeros([size, obs_dim], dtype=np.float32)
        self.obs2_buf = np.zeros([size, obs_dim], dtype=np.float32)
        self.acts_buf = np.zeros([size, act_dim], dtype=np.float32)
        self.rews_buf = np.zeros(size, dtype=np.float32)
        self.done_buf = np.zeros(size, dtype=np.float32)
        self.ptr, self.size, self.max_size = 0, 0, size

    def store(self, obs, act, rew, next_obs, done):
        **self.obs1_buf[self.ptr] = obs**
        self.obs2_buf[self.ptr] = next_obs
        self.acts_buf[self.ptr] = act
        self.rews_buf[self.ptr] = rew
        self.done_buf[self.ptr] = done
        self.ptr = (self.ptr+1) % self.max_size
        self.size = min(self.size+1, self.max_size)

    def sample_batch(self, batch_size=32):
        idxs = np.random.randint(0, self.size, size=batch_size)
        return dict(obs1=self.obs1_buf[idxs],
                    obs2=self.obs2_buf[idxs],
                    acts=self.acts_buf[idxs],
                    rews=self.rews_buf[idxs],
                    done=self.done_buf[idxs])`

I am not not sure the purpose of this line or how it relates to the value error and input arrays. Any advice would be appreciated.

Thanks

elsheikh21, 2019-03-18:
Guys can you try the following
`
observation = env.reset()
# Crop the image to 84x84
image = image[0:self.84, :]
image = image[:, 96-84:]
# Convert image to grayscale
np.dot(image[..., :3], [0.299, 0.587, 0.114])
# normalize the image
min_image = np.min(image)
max_image = np.max(image)
if min_image != max_image:
      image = 2 * (image - min_image) / (max_image - min_image) - 1.0
else:
     image[:,:] = 0
image = image[:, :, np.newaxis]
# Image shape will be (84, 84, 1)
`

pzhokhov, 2019-03-18:
@Bhaney44 @FlavioLorenzi @christopherhesse I generally hate pulling the rank in this fashion, but, as a DRI for the gym I declare this issue closed, and object to reopening it here, because it has nothing to do with the gym. As suggested by @christopherhesse and supported by the author of spinning up @jachiam spinning up code assumes vector observations, whereas CarRacing Environment produces image observations. Ergo, in order to make Spinning Up code work with CarRacing, one needs to write custom actor-critic functions compatible with spinning up on one end, and with image observations on other end (and modify replay buffers per @jachiam's suggestion). At the fear of repeating myself - the issue is not related to openai gym, or tensorflow for that matter, only to the way spinningup is currently structured. If need be, this discussion can be moved into either https://github.com/openai/spinningup/issues/120 or a new issue in spinning up. @Bhaney44 If you are using ppo, and don't want to figure out how to make spinning up work with image observations, I would recommend using implementation of ppo that is compatible with images out of the box - for instance, openai baselines (https://github.com/openai/baselines) or stable baselines (https://github.com/hill-a/stable-baselines).

Bhaney44, 2019-03-20:
@pzhokhov you "generally hate pulling the rank in this fashion" because you are trying to abuse whatever pseudo-authority you believe you have. In addition to your atrocious use of phrases like "in order to" your response is wrong. As I clearly stated "the problem hasn't been solved." I have worked hard at solving this problem, I am not finished, and no one else has proposed a solution. With that said, I have no interest continuing to interact with you or anyone else at your "non-profit." I will solve future issues on my own.

Brian S. Haney

Closed 2019-03-01.

Thread 1274 (2019-01-02):

Feature Request: spaces.Array

bionicles, 2019-01-02:
I just verified it is not possible to set the default Box space to have a None value in one dimension. This is problematic because often we need to allow inputs of arbitrary lengths -- graphs have different numbers of nodes and edges, songs last variable amounts of time, molecules might be big or small, etc

To solve this I'm testing a new Space called Array which is a clone of Box except without the check for None values. This means we can't sample the values, but really we only use Sample for Actions when we don't have an Agent. We don't usually Sample observations because we can just call Env.reset() and get a real chunk of data...

Array type allows us to specify _partial_ constraints on data -- but then it would be critical for Envs which use this to update the constraints on the Action space after getting data in reset. Otherwise, we can't sample actions when we test the Env.

Another option is to give the Array constructor some default dimensionality and update it later. But then it might fail silently. That's bad. So we'll just move the None checks in Box.__init__ into Array.sample() and if you sample an Array with a None-valued dimension, you get an error

TLDR:
Box -> All dimensions must be specified -> throws an error if the dimensions are not specified
Array -> Some dimensions may be unspecified -> throws an error during SAMPLING if dimensions are not specified.

input welcome!

bionicles, 2019-01-02:
```
class Array(gym.Space):
    def __init__(self, shape, variance=1., mean=0., high=None, low=None, dtype=np.float32):
        self.shape = shape
        self.dtype = dtype
        # sampling
        self.variance = variance
        self.mean = mean
        # constraints
        self.high = high
        self.low = low

    def sample(self):
        if self.shape is not None and None in self.shape:
            raise AttributeError("cannot sample arrays with unspecified dimensionality")
        else:
            sample = np.random.normal(self.mean, self.variance, self.shape)
            if self.low is not None and self.high is not None:
                sample = np.clip(sample, self.low, self.high)
            return sample

    def contains(self, x):
        if x.shape is self.shape:
            if all(self.low < x < self.high):
                return True
        return False
```

bionicles, 2019-01-02:
need to handle integer sampling case ... but it's a start

bionicles, 2019-01-03:
one issue with space.Dict is it doesn't support item assignment: this means we have to create a new space during reset instead of updating the original spaces.Dict object.

how do you make spaces.Dict easier to use?

it would be great if the Dict space were similar to AttrDict ---> then we could set and get attribute values from the dict easily like this:

`self.action_space = spaces.Dict( { "potentials": spaces.Array(shape=(None, 3)) } `

... later in reset we get num_atoms so we can set the shape of the potentials array in the action space:

`self.action_space.potentials.shape[0]  == num_atoms`

right now we have to create a whole new object like this:
`self.action_space = spaces.Dict( { "potentials": spaces.Array(shape=(num_atoms, 3)) } `

Eriz11, 2019-02-13:
@bionicles ¿Have you finally implemented this? I'm also interested in this specific case.

In my case, I have an observation_space within a spaces.Dict. However, one of the input arrays is of the same length every time (say shape=(10,3)) but the other input array can be of an arbitrary length (i.e. sometimes shape=(15,2), other time shape=(20,2) etc.).

Any improvement in that would be awesome.

bionicles, 2019-02-13:
Yeah  it works, I’ll check to see if I tinkered more but it’s basically a fork of box with the ability to set None dimensionality

Eriz11, 2019-02-14:
That's nice. Many thanks for the work.

¿Could you illustrate how to integrate the new space into the framework and use it like the other spaces?

Also, and maybe it is a silly question because on my early deepen into RL, ¿Does having variable length observations function properly within the agents? For example, in some DL algorithms we must fill with zeros when the inputs are not of the same shape.

Thanks in advance for the guidance,

christopherhesse, 2019-04-05:
Seems interesting, if you end up packaging that as a library, might be nice to link from this issue.  I don't think we're going to change the built-in gym spaces at this time though.

Closed 2019-04-05.

Thread 1280 (2019-01-08):

Difference between Breakout-v0, Breakout-v4 and BreakoutDeterministic-v4?

tianlinxu312, 2019-01-08:
Can anyone explain the difference between Breakout-v0, Breakout-v4 and BreakoutDeterministic-v4?

xysun, 2019-02-24:
If you look at the atari_env [source code](https://github.com/openai/gym/blob/master/gym/envs/__init__.py#L449), essentially:
- `v0` vs `v4`: `v0` has `repeat_action_probability` of 0.25 (meaning 25% of the time the previous action will be used instead of the new action), while `v4` has 0 (always follow your issued action)
- `Deterministic`: a fixed frameskip of 4, while for the env without `Deterministic`, frameskip is sampled from (2,5) (code [here](https://github.com/openai/gym/blob/master/gym/envs/atari/atari_env.py#L24))

There is also `NoFrameskip-v4` with no frame skip and no action repeat stochasticity.

tianlinxu312, 2019-02-25:
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

Thank you very much.  That's very clear.

xysun, 2019-02-28:
Glad to help! Can you close the issue now it's solved?

christopherhesse, 2019-03-01:
Thanks for answering @xysun!

rfali, 2021-12-22:
**Breakout-v0 vs Breakout-v4**
v0: repeat_action_probability of 0.25 (meaning 25% of the time the previous action will be used instead of the new action)
v4: repeat_action_probability of 0 (always follow issued action)

**Breakout-v4 vs BreakoutDeterministic-v4 vs BreakoutNoFrameskip-v4**
game-vX: frameskip is sampled from (2,5), meaning either 2, 3 or 4 frames are skipped [low: inclusive, high: exclusive]
game-Deterministic-vX: a fixed frame skip of 4
game-NoFrameskip-vX:  with no frame skip

**Breakout-v4 vs Breakout-ram-v4**
game-vX: Observation Space (128,). Observation is given as a vector of size 128.
game-ram-vX: Observation Space (210,160,3). Observation is given as pixels of Width:210, Height:160, Depth:3

The atari environment source code has been removed from Gym [AFAIK] and you can see it on the ALE's GitHub. See source code [here](https://github.com/mgbellemare/Arcade-Learning-Environment/blob/master/src/gym/envs/atari/environment.py)

Other useful references:
This [video](https://www.youtube.com/watch?v=WnSUQdFnKyY)
ALE v0.7 [Blog](https://brosa.ca/blog/ale-release-v0.7)

alexxcollins, 2022-04-19:
This thread has helped me out a lot.

@rfali - I think you may have a typo and your post should read:

Breakout-v4 vs Breakout-ram-v4
game-**_ram_**-vX: Observation Space (128,). Observation is given as a vector of size 128.
game-vX: Observation Space (210,160,3). Observation is given as pixels of Width:210, Height:160, Depth:3

kknydnai, 2022-04-30:
Dear rfali,
I have checked, what you have written in game-v4 / game-ram-v4 is swapped up as alexxcollins said

rfali, 2022-05-01:
@alexxcollins @kknydnai thanks for noticing that typo, I have updated my comment!

Closed 2019-03-01.

Thread 1303 (2019-01-30):

Cannot Run Any OpenAi Code Even The "Simplest"

iseegr8tfuldeadppl, 2019-01-30:
so i was trying to run the following code copied from the repository and it errored me out with the huge text, i'm not sure what is wrong with docker anyone got a clue!
```
import gym
import universe  # register the universe environments

env = gym.make('flashgames.DuskDrive-v0')
env.configure(remotes=1)  # automatically creates a local docker container
observation_n = env.reset()

while True:
  action_n = [[('KeyEvent', 'ArrowUp', True)] for ob in observation_n]  # your agent here
  observation_n, reward_n, done_n, info = env.step(action_n)
  env.render()
```
`

`kream@KRIMSON:~/openai$ python openai_test.py
[2019-01-31 00:28:49,830] Making new env: flashgames.DuskDrive-v0
/home/kream/.local/lib/python2.7/site-packages/gym/envs/registration.py:17: PkgResourcesDeprecationWarning: Parameters to load are deprecated.  Call .resolve and .require separately.
  result = entry_point.load(False)
[2019-01-31 00:28:49,834] Writing logs to file: /tmp/universe-15684.log
[2019-01-31 00:28:49,836] Connection pool is full, discarding connection: localhost
Traceback (most recent call last):
  File "openai_test.py", line 5, in <module>
    env.configure(remotes=1)  # automatically creates a local docker container
  File "/home/kream/universe/universe/wrappers/timer.py", line 14, in configure
    self.env.configure(**kwargs)
  File "/home/kream/universe/universe/wrappers/render.py", line 21, in configure
    self.env.configure(**kwargs)
  File "/home/kream/universe/universe/wrappers/throttle.py", line 32, in configure
    self.env.configure(**kwargs)
  File "/home/kream/universe/universe/envs/vnc_env.py", line 199, in configure
    use_recorder_ports=record,
  File "/home/kream/universe/universe/remotes/build.py", line 19, in build
    n=n,
  File "/home/kream/universe/universe/remotes/docker_remote.py", line 44, in __init__
    self._assigner = PortAssigner(reuse=reuse)
  File "/home/kream/universe/universe/remotes/docker_remote.py", line 163, in __init__
    self.client, self.info = get_client()
  File "/home/kream/universe/universe/remotes/docker_remote.py", line 157, in get_client
    return docker.Client(base_url=host, version=client_api_version), info
  File "/home/kream/.local/lib/python2.7/site-packages/docker/client.py", line 99, in __init__
    self._version = self._retrieve_server_version()
  File "/home/kream/.local/lib/python2.7/site-packages/docker/client.py", line 124, in _retrieve_server_version
    'Error while fetching server API version: {0}'.format(e)
docker.errors.DockerException: Error while fetching server API version: Timeout value connect was Timeout(connect=60, read=60, total=None), but it must be an int or float.
kream@KRIMSON:~/openai$ `

shuruiz, 2019-02-04:
It's too vague. Can you comment the env.render() line and post the running result again?

christopherhesse, 2019-02-16:
I'm afraid this is an issue with `universe`, which is not currently supported.  Sorry about that!

Closed 2019-02-16.

Thread 1394 (2019-03-17):

Standard pattern for delayed feedback in `Environment`s?

macks22, 2019-03-17:
**I'm wondering if there is a standard pattern to adapt the `Environment` interface for delayed feedback?**

**Delayed feedback** is common in realistic bandit problems and has been studied by many (though a minority of) papers in the academic literature. Basically, you take an action and the reward doesn't arrive immediately. It may eventually arrive after the next N steps, after some amount of time elapses, or after some stochastic period of time or number of steps. For a realistic example, consider display advertising in which the goal is to optimize for product purchases rather than click-throughs.

**Options Considered**
I can imagine a few options that involves bundling the delayed rewards into the `observation`. Basically, on each call to `step`, the `observation` object contains a `delayed_feedback` property. It could be a:

1.  mapping from time steps to rewards that are now arriving for that time step. This would necessitate the agent tracking which observations correspond to which time step, or alternatively, that the environment provide a mapping from time steps to historical observations (via nonstandard methods).
2.  mapping from time steps to tuples of `(observation, action, reward)`. This would mean the environment ends up returning every observation twice and track the actions the agent takes.

Both of these seem to be workable solutions -- even if the rewards arrive after a time delay rather than after some number of `step` calls, the agent will still be able to observe the rewards before taking the next action. I'm inclined to go with the first; it seems to lead to a simpler `Environment`, and agents that deal with delayed feedback will probably be tracking historical observations anyway. **Before choosing one of these, I'd love to know if either is standard or if there is another standard pattern I should use for compatibility with other environments/algorithms?**

Thanks!

christopherhesse, 2019-03-22:
I'm not aware of a standard pattern here, but you should be able to easily do this with a wrapper: https://github.com/openai/gym/blob/master/gym/core.py#L209 and you could just delay the reward stream, though you'd probably have to insert extra observations at the end of an episode for any delayed rewards.

wiesbadener, 2021-02-07:
@macks22  How did you end up implementing it?

> 1. mapping from time steps to rewards that are now arriving for that time step. This would necessitate the agent tracking which observations correspond to which time step, or alternatively, that the environment provide a mapping from time steps to historical observations (via nonstandard methods).

I guess this often represents real use-cases, as the environment model is likely to cause the delays.

E.g. one step in a gym environment represents a certain time increment (dt) of the simulation model. Within this dt the agent didn't observe the response associated with the last action.

An other example would be stock keeping (I think it's mentioned in [Bertsekas' Book "Dynamic Programming and Optimal Control](http://www.athenasc.com/dpbook.html)". The agent orders products to fill up inventory (action). They are delivered with _some time delay_. There is some demand per time step. Stock amount is the state. Reward could be (sales income - stock keeping and purchase costs ).

I think from a mathematical point of view the time delay makes it non-Markovian. But a non-MDP can be transformed into a Markovian one by a redefinition of the state considering history.

daffarg, 2025-07-21:
@macks22 @wiesbadener @christopherhesse Do you have any practical sample code in custom env to handle the delayed feedback problem, especially in `step()` function? I have this problem with my project as the observation can only be obtained 10 seconds later after I applied an action. My current naive approach is using `time.Sleep()` in the `step()` function after I applied an action.

Closed 2019-03-22.

Thread 1409 (2019-03-25):

CartPole.render()  always creates a new window even when 'mode=rgb_array'

ZyUestc, 2019-03-25:
I want to find a method that don't have to create windows so that it runs over server.

christopherhesse, 2019-03-25:
What error do you get when running this on the server?

ZyUestc, 2019-03-26:
Sorry for insufficient description!
This is total: I run jupyter notebook over a ubuntu server,  then I want to test some function. Here is my code first:
import gym
env = gym.make('CartPole-v0')
env.reset()
for _ in range(1000):
    env.render(mode='rgb_array'))
    env.step(env.action_space.sample()) # take a random action
env.close()
then I got error with
---------------------------------------------------------------------------
NoSuchDisplayException                    Traceback (most recent call last)
<ipython-input-4-9942aa34e878> in <module>()
      3 env.reset()
      4 for _ in range(1000):
----> 5     print(env.render(mode='rgb_array'))
      6     env.step(env.action_space.sample()) # take a random action
      7 env.close()

~/gym/gym/core.py in render(self, mode, **kwargs)
    247
    248     def render(self, mode='human', **kwargs):
--> 249         return self.env.render(mode, **kwargs)
    250
    251     def close(self):

~/gym/gym/envs/classic_control/cartpole.py in render(self, mode)
    148
    149         if self.viewer is None:
--> 150             from gym.envs.classic_control import rendering
    151             self.viewer = rendering.Viewer(screen_width, screen_height)
    152             l,r,t,b = -cartwidth/2, cartwidth/2, cartheight/2, -cartheight/2

~/gym/gym/envs/classic_control/rendering.py in <module>()
     25
     26 try:
---> 27     from pyglet.gl import *
     28 except ImportError as e:
     29     raise ImportError('''

/anaconda3/lib/python3.6/site-packages/pyglet/gl/__init__.py in <module>()
    237     # trickery is for circular import
    238     _pyglet.gl = _sys.modules[__name__]
--> 239     import pyglet.window

anaconda3/lib/python3.6/site-packages/pyglet/window/__init__.py in <module>()
   1894 if not _is_pyglet_docgen:
   1895     pyglet.window = sys.modules[__name__]
-> 1896     gl._create_shadow_window()
   1897

/anaconda3/lib/python3.6/site-packages/pyglet/gl/__init__.py in _create_shadow_window()
    206
    207     from pyglet.window import Window
--> 208     _shadow_window = Window(width=1, height=1, visible=False)
    209     _shadow_window.switch_to()
    210

/anaconda3/lib/python3.6/site-packages/pyglet/window/xlib/__init__.py in __init__(self, *args, **kwargs)
    164                     self._event_handlers[message] = func
    165
--> 166         super(XlibWindow, self).__init__(*args, **kwargs)
    167
    168         global _can_detect_autorepeat

/anaconda3/lib/python3.6/site-packages/pyglet/window/__init__.py in __init__(self, width, height, caption, resizable, style, fullscreen, visible, vsync, display, screen, config, context, mode)
    499
    500         if not display:
--> 501             display = get_platform().get_default_display()
    502
    503         if not screen:

/anaconda3/lib/python3.6/site-packages/pyglet/window/__init__.py in get_default_display(self)
   1843         :rtype: `Display`
   1844         """
-> 1845         return pyglet.canvas.get_display()
   1846
   1847 if _is_pyglet_docgen:

/anaconda3/lib/python3.6/site-packages/pyglet/canvas/__init__.py in get_display()
     80
     81     # Otherwise, create a new display and return it.
---> 82     return Display()
     83
     84 if _is_pyglet_docgen:

/anaconda3/lib/python3.6/site-packages/pyglet/canvas/xlib.py in __init__(self, name, x_screen)
     84         self._display = xlib.XOpenDisplay(name)
     85         if not self._display:
---> 86             raise NoSuchDisplayException('Cannot connect to "%s"' % name)
     87
     88         screen_count = xlib.XScreenCount(self._display)

NoSuchDisplayException: Cannot connect to "None"
So I turn to look source code of 'CartPole' then  I **found it always renders image first**,  the parameter 'rgb_array' has influence only on return.  It seems to we should check mode is 'human' or not then renders image).
After I try with 'Breakout-v0' and other environments in 'atari',  I got a np.array instance and not renders image anymore.

christopherhesse, 2019-03-26:
Are you running an X11 server?  If not you should run everything using Xvfb to create a fake one so that rendering will work.  An X11 server is required until pyglet adds EGL support: https://bitbucket.org/pyglet/pyglet/issues/219/egl-support-headless-rendering

christopherhesse, 2019-03-26:
Also see https://github.com/openai/gym#rendering-on-a-server

Closed 2019-03-26.

Thread 1452 (2019-04-22):

Failed to render: Symbol not found

hughplay, 2019-04-22:
Hi,

I am struggling to make `env.render()` work on my Mac.

When I running the code below:

``` py
import gym
env = gym.make('CartPole-v0')
env.reset()
for _ in range(1000):
    env.render()
    env.step(env.action_space.sample()) # take a random action
env.close()
```

Error raised:

```
Traceback (most recent call last):
  File "dqn.py", line 5, in <module>
    env.render()
  File "/Users/hugh/Documents/code/project/rl/gym/gym/core.py", line 249, in render
    return self.env.render(mode, **kwargs)
  File "/Users/hugh/Documents/code/project/rl/gym/gym/envs/classic_control/cartpole.py", line 150, in render
    from gym.envs.classic_control import rendering
  File "/Users/hugh/Documents/code/project/rl/gym/gym/envs/classic_control/rendering.py", line 27, in <module>
    from pyglet.gl import *
  File "/Users/hugh/anaconda3/lib/python3.6/site-packages/pyglet/gl/__init__.py", line 100, in <module>
    from pyglet.gl.lib import GLException
  File "/Users/hugh/anaconda3/lib/python3.6/site-packages/pyglet/gl/lib.py", line 141, in <module>
    from pyglet.gl.lib_agl import link_GL, link_GLU, link_AGL
  File "/Users/hugh/anaconda3/lib/python3.6/site-packages/pyglet/gl/lib_agl.py", line 51, in <module>
    framework='/System/Library/Frameworks/AGL.framework')
  File "/Users/hugh/anaconda3/lib/python3.6/site-packages/pyglet/lib.py", line 118, in load_library
    return self.load_framework(kwargs['framework'])
  File "/Users/hugh/anaconda3/lib/python3.6/site-packages/pyglet/lib.py", line 279, in load_framework
    lib = ctypes.cdll.LoadLibrary(realpath)
  File "/Users/hugh/anaconda3/lib/python3.6/ctypes/__init__.py", line 426, in LoadLibrary
    return self._dlltype(name)
  File "/Users/hugh/anaconda3/lib/python3.6/ctypes/__init__.py", line 348, in __init__
    self._handle = _dlopen(self._name, mode)
OSError: dlopen(/System/Library/Frameworks/AGL.framework/AGL, 6): Symbol not found: _CGLChoosePixelFormat
  Referenced from: /System/Library/Frameworks/AGL.framework/Versions/A/AGL
  Expected in: flat namespace
 in /System/Library/Frameworks/AGL.framework/Versions/A/AGL
```

The environment of mine is shown below:

- System: macOS Mojave 10.14.4
- xcode-select version 2354
- conda: 4.6.13
- Python 3.6.8 :: Anaconda, Inc.

And of course I installed the dependencies by running the following command:

``` sh
brew install cmake boost boost-python sdl2 swig wget
```

So could you help me with this problem?
I find nothing similar with googling and updating `xcode-select` seems not help at all.

hughplay, 2019-04-22:
I found I can run `Breakout-v0` successfully in jupyter lab:

``` py
import gym
from IPython import display
import matplotlib.pyplot as plt
%matplotlib inline

env = gym.make('Breakout-v0')
env.reset()
for _ in range(1000):
    plt.imshow(env.render(mode='rgb_array'))
    display.clear_output(wait=True)
    display.display(plt.gcf())
    env.step(env.action_space.sample())
```

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

But it still failed with `CartPole-v0` and `CartPole-v1` and all [classic control](https://gym.openai.com/envs/#classic_control).

Error when running `CartPole-v0`:

```
---------------------------------------------------------------------------
OSError                                   Traceback (most recent call last)
<ipython-input-25-bd78134a2c9e> in <module>
      7 env.reset()
      8 for _ in range(1000):
----> 9     plt.imshow(env.render(mode='rgb_array'))
     10     display.clear_output(wait=True)
     11     display.display(plt.gcf())

~/Documents/code/project/rl/gym/gym/core.py in render(self, mode, **kwargs)
    247
    248     def render(self, mode='human', **kwargs):
--> 249         return self.env.render(mode, **kwargs)
    250
    251     def close(self):

~/Documents/code/project/rl/gym/gym/envs/classic_control/cartpole.py in render(self, mode)
    148
    149         if self.viewer is None:
--> 150             from gym.envs.classic_control import rendering
    151             self.viewer = rendering.Viewer(screen_width, screen_height)
    152             l,r,t,b = -cartwidth/2, cartwidth/2, cartheight/2, -cartheight/2

~/Documents/code/project/rl/gym/gym/envs/classic_control/rendering.py in <module>
     25
     26 try:
---> 27     from pyglet.gl import *
     28 except ImportError as e:
     29     raise ImportError('''

~/anaconda3/lib/python3.6/site-packages/pyglet/gl/__init__.py in <module>
    222 elif compat_platform == 'darwin':
    223     if _pyglet.options['darwin_cocoa']:
--> 224         from .cocoa import CocoaConfig as Config
    225     else:
    226         from .carbon import CarbonConfig as Config

~/anaconda3/lib/python3.6/site-packages/pyglet/gl/cocoa.py in <module>
     15 from pyglet.gl import agl
     16
---> 17 from pyglet.canvas.cocoa import CocoaCanvas
     18
     19 from pyglet.libs.darwin.cocoapy import *

~/anaconda3/lib/python3.6/site-packages/pyglet/canvas/__init__.py in <module>
     89         from pyglet import options as pyglet_options
     90         if pyglet_options['darwin_cocoa']:
---> 91             from pyglet.canvas.cocoa import CocoaDisplay as Display
     92             from pyglet.canvas.cocoa import CocoaScreen as Screen
     93             from pyglet.canvas.cocoa import CocoaCanvas as Canvas

~/anaconda3/lib/python3.6/site-packages/pyglet/canvas/cocoa.py in <module>
     14 from .base import Display, Screen, ScreenMode, Canvas
     15
---> 16 from pyglet.libs.darwin.cocoapy import *
     17
     18

~/anaconda3/lib/python3.6/site-packages/pyglet/libs/darwin/__init__.py in <module>
      5 if pyglet.options['darwin_cocoa']:
      6
----> 7     from .cocoapy import *
      8
      9 # Carbon implementation:

~/anaconda3/lib/python3.6/site-packages/pyglet/libs/darwin/cocoapy/__init__.py in <module>
     35
     36 from .cocoatypes import *
---> 37 from .cocoalibs import *

~/anaconda3/lib/python3.6/site-packages/pyglet/libs/darwin/cocoapy/cocoalibs.py in <module>
    334 # QUARTZ / COREGRAPHICS
    335
--> 336 quartz = cdll.LoadLibrary(util.find_library('quartz'))
    337
    338 CGDirectDisplayID = c_uint32     # CGDirectDisplay.h

~/anaconda3/lib/python3.6/ctypes/__init__.py in LoadLibrary(self, name)
    424
    425     def LoadLibrary(self, name):
--> 426         return self._dlltype(name)
    427
    428 cdll = LibraryLoader(CDLL)

~/anaconda3/lib/python3.6/ctypes/__init__.py in __init__(self, name, mode, handle, use_errno, use_last_error)
    346
    347         if handle is None:
--> 348             self._handle = _dlopen(self._name, mode)
    349         else:
    350             self._handle = handle

OSError: dlopen(/System/Library/Frameworks/quartz.framework/quartz, 6): Symbol not found: _NSAccessibilityDecrementAction
  Referenced from: /System/Library/Frameworks/QTKit.framework/Versions/A/QTKit
  Expected in: flat namespace
 in /System/Library/Frameworks/QTKit.framework/Versions/A/QTKit
```

christopherhesse, 2019-04-25:
It looks like your mac os libraries are all broken, can you try on a different mac?

hughplay, 2019-04-26:
I think you are right.
I make gym run on my Mac with docker and `render` in jupyter notebook.

No idea about how to fix os libraries...

christopherhesse, 2019-04-26:
Could you try reinstalling the operating system?  I don't think I've seen mac os frameworks unable to find symbols before.

hughplay, 2019-04-27:
That will be a huge engineering.
I will try when I get some time.  :sweat_smile:

christopherhesse, 2019-05-03:
Okay, I'm going to close this issue for now since I doubt it could be reproduced anyway.  Please file a new issue if this happens on multiple machines.

hughplay, 2019-05-31:
I finally find this problem is caused by `export DYLD_FORCE_FLAT_NAMESPACE=1` in my `.zshrc`.
It was used for fixing python crash with vim and YCM plugin. Now I use neovim so everything is fine now., except I reinstalled my system before I found this...

VineetTambe, 2020-03-22:
Okay, but how do you resolve this issue?

Closed 2019-05-03.

Thread 1541 (2019-06-20):

Contact forces are zero in Ant-v2/v3

pratikac, 2019-06-20:
The contact forces are all zero in the the MuJoCo Ant-v2/v3 environments. If one runs

```
import gym
import numpy as np

e = gym.make('Ant-v3')
for _ in range(100):
    e.reset()
    for i in range(1000):
        x=e.step(e.action_space.sample())[0]
        print(np.linalg.norm(x[27:]))
```

the last 84 dimensions in the state out of 111 dimensions are always zero. These dimensions are the contact forces in ant_v3.py (https://github.com/openai/gym/blob/master/gym/envs/mujoco/ant_v3.py#L124). Since the ant is in contact with the ground, I believe there should be some contact forces that are non-zero. Can you please clarify if this is the expected behavior?

AlexanderGri, 2019-10-11:
The same goes for the Humanoid environment - contact forces are zero in the case of MuJoCo 2.0 . The environment uses ([v2](https://github.com/openai/gym/blob/master/gym/envs/mujoco/humanoid.py#L32) and [v3](https://github.com/openai/gym/blob/master/gym/envs/mujoco/humanoid_v3.py#L63)) the `cfrc_ext` field of `PyMjData` which is a proxy to the `cfrc_ext` field of MuJoCo C structure `_mjData` . But the [changelog](https://www.roboti.us/index.html#changelist) to MuJoCo 2.0 contains the following line:

> The function mj_rnePostConstraint **is no longer called by default**. Instead, it is called only when the model contains force-related sensors which need the results of this function. The user **can** still **call it directly** in order **to compute** the mjData fields cacc, **cfrc_ext**, cfrc_int if desired.

Due to this Humanoid and Ant reward structure differs between MuJoCo 2.0 and <2.0 . Is it intentional?

pshvechikov, 2019-10-14:
Also, found this very frustrating.
Algorithm benchmarks differ between versions of MuJoCo.
This can misguide researchers and invalidate comparison to previously published papers.
So, this seems like a severe bug.
Please, @christopherhesse @pzhokhov, led some light on the issue, as soon as it is possible for you.
Thanks in advance.

christopherhesse, 2019-10-18:
Thanks for reporting this bug!  It looks like this could have been introduced by https://github.com/openai/gym/pull/1401

Can you guys verify that using `mujoco-py==1.50.1.68` fixes this issue?

AlexanderGri, 2019-10-19:
Thanks for your response!

Using `mujoco-py<2.0` will fix this issue since older versions enforce using `MuJoCo<2.0` which computes contact forces by default.

I see two other options to not to lose MuJoCo updates:
- Use force-related sensors in `.xml` models as suggested in [changelog](https://www.roboti.us/index.html#changelist)
> > The function mj_rnePostConstraint is no longer called by default. Instead, **it is called only when the model contains force-related sensors which need the results of this function**. The user can still call it directly in order to compute the mjData fields cacc, cfrc_ext, cfrc_int if desired.
- Maybe it is possible to use `mj_rnePostConstraint` with `mujoco-py` API without modifying library. [Here](https://github.com/AlexanderGri/mujoco-py/commit/9ff2ce74d21fb1dab5af6b23041e489200fde98d) is an example of dirty solution requiring recompile

christopherhesse, 2019-11-01:
I don't know if we are supporting two different versions of mujoco for any particular reason.  I think I'd rather just stick to the old version of there is no compelling reason to upgrade.  Any objections?

AlexanderGri, 2019-11-05:
> I don't know if we are supporting two different versions of mujoco for any particular reason. I think I'd rather just stick to the old version of there is no compelling reason to upgrade. Any objections?

I see several possible issues with this decision:
- mujoco<2.0 can't be used to simulate interactions with deformable objects
I saw at least two RL papers of such kind last month (one uses Bullet, the other - mujoco 2.0)
- mujoco 2.0 contains several new features in its simulator `*/mujoco200/sample/simulate.cpp` (but i'm not sure if it is just presented in code samples in 2.0 or it is new functionality)
- gym will restrict itself to the existing features being unable to incorporate new ones (in fact, the generalization of previous two issues)

christopherhesse, 2019-11-08:
gym doesn't depend on any particular mujoco version, just the gym mujoco environments, so this should not affect other uses of gym + mujoco 2.0.

christopherhesse, 2019-11-08:
This means you can't use the gym-mujoco environments with mujoco 2.0 (unless you override the requirements) but they don't really work with mujoco 2.0 anyway.  Users of `pip install gym` will not be affected, only users of `pip install gym[mujoco]`

Thanks for the bug report @pratikac!

DanielTakeshi, 2019-11-22:
@christopherhesse Sorry  for the late question, but I just want to make sure I understand the implication of research that has used MuJoCo 2.0 for these environments (Ant-v2, Hopper-v2, HalfCheetah-v2, etc). Does this issue mean that results and learning curves in papers which use those -v2 environments cannot be considered trusted, reliable, or interesting?

tarod13, 2019-11-22:
I'd say that those results where clearly obtained under different conditions and so comparisons with others that use the previous versions of MuJoCo are pointless. However, comparisons between methods on the same environments should be as valid as other comparisons. In fact, these environments could be harder, since less information is provided to the agent.

DanielTakeshi, 2019-11-22:
@tarod13  That's a good point. My main concern would be if we see a set of papers that show:

- Under MuJoCo 1.5, with environments at v1, algorithm X is better than prior state of the art methods.
- Under MuJoCo 2.0, with environments at v2, algorithm Y is better than prior state of the art methods, including algorithm X.

But, under MuJoCo 1.5, algorithm X is actually still better than Y.

I guess this might be unavoidable, though.

brickerino, 2019-11-22:
Guys, it's a different thing. Versions of environments do not depend on version of MuJoCo and vice versa. You can use v2 or v3 with MuJoCo 1.5 for example.

tarod13, 2019-11-22:
Yes, you are right. However, different versions of MuJoCo make the v2 and v3 environments provide different information. That's why I say that they are not comparable if the MuJoCo version is different and also why using MuJoCo 2.0 may result in ultimately harder environments, while they are actually the same environments.

Closed 2019-11-08.

Thread 1546 (2019-06-21):

VectorEnv close() uses logger which performs late import of `six` resulting in odd error message

christopherhesse, 2019-06-21:
```
from gym.vector import make

venv = make("PongNoFrameskip-v4", num_envs=3)
obs, rews, dones, infos = venv.step(venv.action_space.sample())
print(obs.shape, rews, dones, infos)
```

This script sometimes produces an extra exception:

```
ERROR: Received the following error from Worker-0: AssertionError: Cannot call env.step() before calling reset()
ERROR: Shutting down Worker-0.
ERROR: Received the following error from Worker-2: AssertionError: Cannot call env.step() before calling reset()
ERROR: Shutting down Worker-2.
ERROR: Received the following error from Worker-1: AssertionError: Cannot call env.step() before calling reset()
ERROR: Shutting down Worker-1.
ERROR: Raising the last exception back to the main process.
Traceback (most recent call last):
  File "/Users/csh/miniconda3/envs/py37/lib/python3.7/runpy.py", line 193, in _run_module_as_main
    "__main__", mod_spec)
  File "/Users/csh/miniconda3/envs/py37/lib/python3.7/runpy.py", line 85, in _run_code
    exec(code, run_globals)
  File "/Users/csh/agi/sandbox/oneoff/try_vec_env.py", line 4, in <module>
    obs, rews, dones, infos = venv.step(venv.action_space.sample())
  File "/Users/csh/agi/gym/gym/vector/vector_env.py", line 54, in step
    return self.step_wait()
  File "/Users/csh/agi/gym/gym/vector/async_vector_env.py", line 228, in step_wait
    self._raise_if_errors()
  File "/Users/csh/agi/gym/gym/vector/async_vector_env.py", line 327, in _raise_if_errors
    raise exctype(value)
AssertionError: Cannot call env.step() before calling reset()
Exception ignored in: <function AsyncVectorEnv.__del__ at 0x111340950>
Traceback (most recent call last):
  File "/Users/csh/agi/gym/gym/vector/async_vector_env.py", line 332, in __del__
  File "/Users/csh/agi/gym/gym/vector/async_vector_env.py", line 263, in close
  File "/Users/csh/agi/gym/gym/logger.py", line 30, in warn
  File "/Users/csh/agi/gym/gym/utils/colorize.py", line 27, in colorize
ModuleNotFoundError: import of six halted; None in sys.modules
```

There's an extra `ModuleNotFoundError` due to a late import of `six` in `colorize`.

christopherhesse, 2019-06-21:
Sometimes this script produces the following output:

```
Traceback (most recent call last):
  File "/Users/csh/miniconda3/envs/py37/lib/python3.7/runpy.py", line 193, in _run_module_as_main
    "__main__", mod_spec)
  File "/Users/csh/miniconda3/envs/py37/lib/python3.7/runpy.py", line 85, in _run_code
    exec(code, run_globals)
  File "/Users/csh/agi/sandbox/oneoff/try_vec_env.py", line 4, in <module>
    obs, rews, dones, infos = venv.step(venv.action_space.sample())
  File "/Users/csh/agi/gym/gym/vector/vector_env.py", line 54, in step
    return self.step_wait()
  File "/Users/csh/agi/gym/gym/vector/async_vector_env.py", line 231, in step_wait
    observations_list, rewards, dones, infos = zip(*results)
TypeError: zip argument #1 must support iteration
```

Seems like some sort of race condition.

tristandeleu, 2019-06-22:
This might be a race condition, I can't reproduce it unfortunately

Closed 2019-06-28.

Thread 1614 (2019-07-22):

Installing everything error in macos

ghost, 2019-07-22:
when i install everything,the following will error occur:
.. code:: shell

Building wheel for box2d-py (setup.py) ... error
  ERROR: Complete output from command /anaconda2/envs/gymlab/bin/python -u -c 'import setuptools, tokenize;__file__='"'"'/private/var/folders/0v/m2krff5x0y9_ygsf4ct4pvww0000gn/T/pip-install-Pv2tKa/box2d-py/setup.py'"'"';f=getattr(tokenize, '"'"'open'"'"', open)(__file__);code=f.read().replace('"'"'\r\n'"'"', '"'"'\n'"'"');f.close();exec(compile(code, __file__, '"'"'exec'"'"'))' bdist_wheel -d /private/var/folders/0v/m2krff5x0y9_ygsf4ct4pvww0000gn/T/pip-wheel-GyjM36 --python-tag cp27:

i use macos mojave-10.14.5, conda-4.5.11,python-2.7

pzhokhov, 2019-07-22:
could you post the rest of the output here please? Also, if you are using gym for box2d, atari or mujoco environments, I would recommend using python 3.5+

AlbertTHuanG, 2019-07-24:
the rest of the output:
`Building wheel for box2d-py (setup.py) ... error
  ERROR: Complete output from command /anaconda2/envs/gymlab/bin/python -u -c 'import setuptools, tokenize;__file__='"'"'/private/var/folders/0v/m2krff5x0y9_ygsf4ct4pvww0000gn/T/pip-install-T5iJc5/box2d-py/setup.py'"'"';f=getattr(tokenize, '"'"'open'"'"', open)(__file__);code=f.read().replace('"'"'\r\n'"'"', '"'"'\n'"'"');f.close();exec(compile(code, __file__, '"'"'exec'"'"'))' bdist_wheel -d /private/var/folders/0v/m2krff5x0y9_ygsf4ct4pvww0000gn/T/pip-wheel-5_iUBg --python-tag cp27:
  ERROR: Using setuptools (version 41.0.1).
  running bdist_wheel
  running build
  running build_py
  creating build
  creating build/lib.macosx-10.6-x86_64-2.7
  creating build/lib.macosx-10.6-x86_64-2.7/Box2D
  copying library/Box2D/Box2D.py -> build/lib.macosx-10.6-x86_64-2.7/Box2D
  copying library/Box2D/__init__.py -> build/lib.macosx-10.6-x86_64-2.7/Box2D
  creating build/lib.macosx-10.6-x86_64-2.7/Box2D/b2
  copying library/Box2D/b2/__init__.py -> build/lib.macosx-10.6-x86_64-2.7/Box2D/b2
  running build_ext
  building 'Box2D._Box2D' extension
  swigging Box2D/Box2D.i to Box2D/Box2D_wrap.cpp
  swig -python -c++ -IBox2D -small -O -includeall -ignoremissing -w201 -globals b2Globals -outdir library/Box2D -keyword -w511 -D_SWIG_KWARGS -o Box2D/Box2D_wrap.cpp Box2D/Box2D.i
  Box2D/Common/b2Math.h:67: Warning 302: Identifier 'b2Vec2' redefined by %extend (ignored),
  Box2D/Box2D_math.i:47: Warning 302: %extend definition of 'b2Vec2'.
  Box2D/Common/b2Math.h:158: Warning 302: Identifier 'b2Vec3' redefined by %extend (ignored),
  Box2D/Box2D_math.i:168: Warning 302: %extend definition of 'b2Vec3'.
  Box2D/Common/b2Math.h:197: Warning 302: Identifier 'b2Mat22' redefined by %extend (ignored),
  Box2D/Box2D_math.i:301: Warning 302: %extend definition of 'b2Mat22'.
  Box2D/Common/b2Math.h:271: Warning 302: Identifier 'b2Mat33' redefined by %extend (ignored),
  Box2D/Box2D_math.i:372: Warning 302: %extend definition of 'b2Mat33'.
  Box2D/Collision/b2DynamicTree.h:44: Warning 312: Nested union not currently supported (ignored).
  Box2D/Common/b2Settings.h:144: Warning 506: Can't wrap varargs with keyword arguments enabled
  Box2D/Common/b2Math.h:91: Warning 509: Overloaded method b2Vec2::operator ()(int32) effectively ignored,
  Box2D/Common/b2Math.h:85: Warning 509: as it is shadowed by b2Vec2::operator ()(int32) const.
  creating build/temp.macosx-10.6-x86_64-2.7
  creating build/temp.macosx-10.6-x86_64-2.7/Box2D
  creating build/temp.macosx-10.6-x86_64-2.7/Box2D/Dynamics
  creating build/temp.macosx-10.6-x86_64-2.7/Box2D/Dynamics/Contacts
  creating build/temp.macosx-10.6-x86_64-2.7/Box2D/Dynamics/Joints
  creating build/temp.macosx-10.6-x86_64-2.7/Box2D/Common
  creating build/temp.macosx-10.6-x86_64-2.7/Box2D/Collision
  creating build/temp.macosx-10.6-x86_64-2.7/Box2D/Collision/Shapes
  gcc -fno-strict-aliasing -I/anaconda2/envs/gymlab/include -arch x86_64 -DNDEBUG -g -fwrapv -O3 -Wall -Wstrict-prototypes -I/anaconda2/envs/gymlab/include/python2.7 -c Box2D/Box2D_wrap.cpp -o build/temp.macosx-10.6-x86_64-2.7/Box2D/Box2D_wrap.o -I. -Wno-unused
  warning: include path for stdlibc++ headers not found; pass '-stdlib=libc++' on the command line to use the libc++ standard library instead [-Wstdlibcxx-not-found]
  Box2D/Box2D_wrap.cpp:2686:10: fatal error: 'string' file not found
  #include <string>
           ^~~~~~~~
  1 warning and 1 error generated.
  error: command 'gcc' failed with exit status 1
  ----------------------------------------
  ERROR: Failed building wheel for box2d-py
  Running setup.py clean for box2d-py`

I can use atari in python-2.7.
wait for your reply

AlbertTHuanG, 2019-07-24:
the rest of the output

`Building wheel for box2d-py (setup.py) ... error
  ERROR: Complete output from command /anaconda2/envs/gymlab/bin/python -u -c 'import setuptools, tokenize;__file__='"'"'/private/var/folders/0v/m2krff5x0y9_ygsf4ct4pvww0000gn/T/pip-install-T5iJc5/box2d-py/setup.py'"'"';f=getattr(tokenize, '"'"'open'"'"', open)(__file__);code=f.read().replace('"'"'\r\n'"'"', '"'"'\n'"'"');f.close();exec(compile(code, __file__, '"'"'exec'"'"'))' bdist_wheel -d /private/var/folders/0v/m2krff5x0y9_ygsf4ct4pvww0000gn/T/pip-wheel-5_iUBg --python-tag cp27:
  ERROR: Using setuptools (version 41.0.1).
  running bdist_wheel
  running build
  running build_py
  creating build
  creating build/lib.macosx-10.6-x86_64-2.7
  creating build/lib.macosx-10.6-x86_64-2.7/Box2D
  copying library/Box2D/Box2D.py -> build/lib.macosx-10.6-x86_64-2.7/Box2D
  copying library/Box2D/__init__.py -> build/lib.macosx-10.6-x86_64-2.7/Box2D
  creating build/lib.macosx-10.6-x86_64-2.7/Box2D/b2
  copying library/Box2D/b2/__init__.py -> build/lib.macosx-10.6-x86_64-2.7/Box2D/b2
  running build_ext
  building 'Box2D._Box2D' extension
  swigging Box2D/Box2D.i to Box2D/Box2D_wrap.cpp
  swig -python -c++ -IBox2D -small -O -includeall -ignoremissing -w201 -globals b2Globals -outdir library/Box2D -keyword -w511 -D_SWIG_KWARGS -o Box2D/Box2D_wrap.cpp Box2D/Box2D.i
  Box2D/Common/b2Math.h:67: Warning 302: Identifier 'b2Vec2' redefined by %extend (ignored),
  Box2D/Box2D_math.i:47: Warning 302: %extend definition of 'b2Vec2'.
  Box2D/Common/b2Math.h:158: Warning 302: Identifier 'b2Vec3' redefined by %extend (ignored),
  Box2D/Box2D_math.i:168: Warning 302: %extend definition of 'b2Vec3'.
  Box2D/Common/b2Math.h:197: Warning 302: Identifier 'b2Mat22' redefined by %extend (ignored),
  Box2D/Box2D_math.i:301: Warning 302: %extend definition of 'b2Mat22'.
  Box2D/Common/b2Math.h:271: Warning 302: Identifier 'b2Mat33' redefined by %extend (ignored),
  Box2D/Box2D_math.i:372: Warning 302: %extend definition of 'b2Mat33'.
  Box2D/Collision/b2DynamicTree.h:44: Warning 312: Nested union not currently supported (ignored).
  Box2D/Common/b2Settings.h:144: Warning 506: Can't wrap varargs with keyword arguments enabled
  Box2D/Common/b2Math.h:91: Warning 509: Overloaded method b2Vec2::operator ()(int32) effectively ignored,
  Box2D/Common/b2Math.h:85: Warning 509: as it is shadowed by b2Vec2::operator ()(int32) const.
  creating build/temp.macosx-10.6-x86_64-2.7
  creating build/temp.macosx-10.6-x86_64-2.7/Box2D
  creating build/temp.macosx-10.6-x86_64-2.7/Box2D/Dynamics
  creating build/temp.macosx-10.6-x86_64-2.7/Box2D/Dynamics/Contacts
  creating build/temp.macosx-10.6-x86_64-2.7/Box2D/Dynamics/Joints
  creating build/temp.macosx-10.6-x86_64-2.7/Box2D/Common
  creating build/temp.macosx-10.6-x86_64-2.7/Box2D/Collision
  creating build/temp.macosx-10.6-x86_64-2.7/Box2D/Collision/Shapes
  gcc -fno-strict-aliasing -I/anaconda2/envs/gymlab/include -arch x86_64 -DNDEBUG -g -fwrapv -O3 -Wall -Wstrict-prototypes -I/anaconda2/envs/gymlab/include/python2.7 -c Box2D/Box2D_wrap.cpp -o build/temp.macosx-10.6-x86_64-2.7/Box2D/Box2D_wrap.o -I. -Wno-unused
  warning: include path for stdlibc++ headers not found; pass '-stdlib=libc++' on the command line to use the libc++ standard library instead [-Wstdlibcxx-not-found]
  Box2D/Box2D_wrap.cpp:2686:10: fatal error: 'string' file not found
  #include <string>
           ^~~~~~~~
  1 warning and 1 error generated.
  error: command 'gcc' failed with exit status 1
  ----------------------------------------
  ERROR: Failed building wheel for box2d-py
  Running setup.py clean for box2d-py`

I can use atari in python-2.7
wait for your reply

AlbertTHuanG, 2019-07-24:
the rest of the output

'''
Building wheel for box2d-py (setup.py) ... error
  ERROR: Complete output from command /anaconda2/envs/gymlab/bin/python -u -c 'import setuptools, tokenize;__file__='"'"'/private/var/folders/0v/m2krff5x0y9_ygsf4ct4pvww0000gn/T/pip-install-T5iJc5/box2d-py/setup.py'"'"';f=getattr(tokenize, '"'"'open'"'"', open)(__file__);code=f.read().replace('"'"'\r\n'"'"', '"'"'\n'"'"');f.close();exec(compile(code, __file__, '"'"'exec'"'"'))' bdist_wheel -d /private/var/folders/0v/m2krff5x0y9_ygsf4ct4pvww0000gn/T/pip-wheel-5_iUBg --python-tag cp27:
  ERROR: Using setuptools (version 41.0.1).
  running bdist_wheel
  running build
  running build_py
  creating build
  creating build/lib.macosx-10.6-x86_64-2.7
  creating build/lib.macosx-10.6-x86_64-2.7/Box2D
  copying library/Box2D/Box2D.py -> build/lib.macosx-10.6-x86_64-2.7/Box2D
  copying library/Box2D/__init__.py -> build/lib.macosx-10.6-x86_64-2.7/Box2D
  creating build/lib.macosx-10.6-x86_64-2.7/Box2D/b2
  copying library/Box2D/b2/__init__.py -> build/lib.macosx-10.6-x86_64-2.7/Box2D/b2
  running build_ext
  building 'Box2D._Box2D' extension
  swigging Box2D/Box2D.i to Box2D/Box2D_wrap.cpp
  swig -python -c++ -IBox2D -small -O -includeall -ignoremissing -w201 -globals b2Globals -outdir library/Box2D -keyword -w511 -D_SWIG_KWARGS -o Box2D/Box2D_wrap.cpp Box2D/Box2D.i
  Box2D/Common/b2Math.h:67: Warning 302: Identifier 'b2Vec2' redefined by %extend (ignored),
  Box2D/Box2D_math.i:47: Warning 302: %extend definition of 'b2Vec2'.
  Box2D/Common/b2Math.h:158: Warning 302: Identifier 'b2Vec3' redefined by %extend (ignored),
  Box2D/Box2D_math.i:168: Warning 302: %extend definition of 'b2Vec3'.
  Box2D/Common/b2Math.h:197: Warning 302: Identifier 'b2Mat22' redefined by %extend (ignored),
  Box2D/Box2D_math.i:301: Warning 302: %extend definition of 'b2Mat22'.
  Box2D/Common/b2Math.h:271: Warning 302: Identifier 'b2Mat33' redefined by %extend (ignored),
  Box2D/Box2D_math.i:372: Warning 302: %extend definition of 'b2Mat33'.
  Box2D/Collision/b2DynamicTree.h:44: Warning 312: Nested union not currently supported (ignored).
  Box2D/Common/b2Settings.h:144: Warning 506: Can't wrap varargs with keyword arguments enabled
  Box2D/Common/b2Math.h:91: Warning 509: Overloaded method b2Vec2::operator ()(int32) effectively ignored,
  Box2D/Common/b2Math.h:85: Warning 509: as it is shadowed by b2Vec2::operator ()(int32) const.
  creating build/temp.macosx-10.6-x86_64-2.7
  creating build/temp.macosx-10.6-x86_64-2.7/Box2D
  creating build/temp.macosx-10.6-x86_64-2.7/Box2D/Dynamics
  creating build/temp.macosx-10.6-x86_64-2.7/Box2D/Dynamics/Contacts
  creating build/temp.macosx-10.6-x86_64-2.7/Box2D/Dynamics/Joints
  creating build/temp.macosx-10.6-x86_64-2.7/Box2D/Common
  creating build/temp.macosx-10.6-x86_64-2.7/Box2D/Collision
  creating build/temp.macosx-10.6-x86_64-2.7/Box2D/Collision/Shapes
  gcc -fno-strict-aliasing -I/anaconda2/envs/gymlab/include -arch x86_64 -DNDEBUG -g -fwrapv -O3 -Wall -Wstrict-prototypes -I/anaconda2/envs/gymlab/include/python2.7 -c Box2D/Box2D_wrap.cpp -o build/temp.macosx-10.6-x86_64-2.7/Box2D/Box2D_wrap.o -I. -Wno-unused
  warning: include path for stdlibc++ headers not found; pass '-stdlib=libc++' on the command line to use the libc++ standard library instead [-Wstdlibcxx-not-found]
  Box2D/Box2D_wrap.cpp:2686:10: fatal error: 'string' file not found
  #include <string>
           ^~~~~~~~
  1 warning and 1 error generated.
  error: command 'gcc' failed with exit status 1
  ----------------------------------------
  ERROR: Failed building wheel for box2d-py
  Running setup.py clean for box2d-py
'''

I can use atari in python2.7
wait for your reply

christopherhesse, 2019-07-26:
Is there a reason you are using python2.7?  Python 3.5+ have prebuilt binaries and would be unlikely to fail in this way.

christopherhesse, 2019-07-26:
Based on some google searching you can also try `xcode-select --install` and see if it fixes your header issue.

AlbertTHuanG, 2019-07-30:
> Based on some google searching you can also try `xcode-select --install` and see if it fixes your header issue.

Thanks for the advice, but it didn't work

BolunDai0216, 2019-09-13:
Can you check what python you are using by running "which python" or "which python3", I have experienced issues when using anaconda's python if that makes sense.

When switching to /usr/bin/python3 I noticed a lot of the issues would just magically go away.

christopherhesse, 2019-09-28:
Does it work with python 3.5+?

winstonmo9, 2021-06-13:
I just had the exact same problem....

jkterry1, 2021-07-30:
I'm closing this due to inactivity

Closed 2021-07-30.

Thread 1641 (2019-08-07):

[gym numpy ray] Error pickling numpy random state

giuse, 2019-08-07:
I got a pretty nasty-to-track error using gym with Ray about pickling numpy.random. My money is on a problem with numpy serializing the recently overhauled random state, but 1. I am not competent to make such call (new to Python), 2. could not pinpoint the problem (ay Ray...), 3. was told straight to include you folks in the conversation [ https://github.com/numpy/numpy/issues/14210#issuecomment-519050123 ].

I am copying the original issue below for your convenience, but would appreciate if you could have a look at the discussion so far at https://github.com/numpy/numpy/issues/14210 .
Thanks!

------------------

Still unsure if this problem is on numpy's side, but I tried downgrading to 1.14 (minimum numpy version for my dependencies) and verified it all works, no errors.
Given the recent changes on `random` I thought of bringing it up with you guys, particularly @charris @mattip (from https://github.com/numpy/numpy/pull/14207 )

I am sorry I could not isolate a simple reproducible example yet, my setup is inconveniently convoluted ATM.

I am using [Ray](https://github.com/ray-project/ray) to parallelize calls to the [OpenAI Gym](https://github.com/openai/gym), this in turn implying a numpy random state is pickled for storage on its Redis-based object store. The un-pickling after Redis does not find the function [`__randomstate_ctor()`](https://github.com/numpy/numpy/blob/master/numpy/random/_pickle.py#L62).
I tried adding it to the [__init()__](https://github.com/numpy/numpy/blob/master/numpy/random/__init__.py) on the same fashion as (the suspiciously similar) [__RandomState_ctor()](https://github.com/numpy/numpy/blob/master/numpy/random/__init__.py#L194), but to no avail.

My hope is that someone with a better knowledge of this code will find something useful in the error.

### Reproducing code example:

Sorry too complex yet, unable to isolate it.

### Error message:

(Getting one of each from each worker, hundreds of them running async)

```
2019-08-06 14:18:59,907	ERROR worker.py:1714 -- Failed to unpickle the remote function '__main__.<lambda>' with function ID 84d9aba7e5b48a67d1b84d50bbf3f47e94bd0f4b. Traceback:
Traceback (most recent call last):
  File "/home/giuse/.local/share/virtualenvs/des-htl_CtVS/lib/python3.6/site-packages/ray/function_manager.py", line 424, in fetch_and_register_remote_function
    function = pickle.loads(serialized_function)
AttributeError: Can't get attribute '__randomstate_ctor' on <module 'numpy.random._pickle' from '/home/giuse/.local/share/virtualenvs/des-htl_CtVS/lib/python3.6/site-packages/numpy/random/_pickle.py'>

2019-08-06 14:18:59,861	ERROR worker.py:1654 -- Possible unhandled error from worker: ray_BlockWorker:run() (pid=28613, host=diufrm148)
  File "/home/giuse/des/block_worker.py", line 61, in run
    fitnesses = self.parallel_eval(population)
  File "/home/giuse/des/block_worker.py", line 91, in parallel_eval
    return ray.get([ ev.evaluate.remote(ind) for ev, ind in zip(self.fitness_evaluators, population) ])
ray.exceptions.RayTaskError: ray_FitnessEvaluator:evaluate() (pid=29830, host=diufrm148)
  File "pyarrow/serialization.pxi", line 461, in pyarrow.lib.deserialize
  File "pyarrow/serialization.pxi", line 424, in pyarrow.lib.deserialize_from
  File "pyarrow/serialization.pxi", line 275, in pyarrow.lib.SerializedPyObject.deserialize
  File "pyarrow/serialization.pxi", line 174, in pyarrow.lib.SerializationContext._deserialize_callback
AttributeError: Can't get attribute '__randomstate_ctor' on <module 'numpy.random._pickle' from '/home/giuse/.local/share/virtualenvs/des-htl_CtVS/lib/python3.6/site-packages/numpy/random/_pickle.py'>
```

### Numpy/Python version information:

```
1.17.0 3.6.8 (default, Jan 14 2019, 11:02:34)
[GCC 8.0.1 20180414 (experimental) [trunk revision 259383]]
```

christopherhesse, 2019-08-09:
I tried to pickle a gym space and it seemed to work fine.  It sounds like it could be some ray arrow serialization issue, you should try filing this issue on the ray repo: https://github.com/ray-project/ray

If you're able to make a short reproduction script and it looks like gym is to blame, please create a new issue.

Also as a workaround, you can try to avoid pickling anything that causes this error, some gym envs are unpickleable, so I avoid issues by just never pickling them.

Closed 2019-08-09.

Thread 1673 (2019-09-09):

change torso mass of mujoco environments

HareshMiriyala, 2019-09-09:
Hi all,

I've looked around and I cant seem to find a good way to change the model parameters of an agent on the fly. I ideally want to be changing the torso mass of environments like swimmer, hopper and halfcheetah. I've looked at their xml config files and it doesnt seem intuitive. there is no explicit parameter like 'mass' that i can change.

Here's the xml file for swimmer :

```
<mujoco model="swimmer">
  <compiler angle="degree" coordinate="local" inertiafromgeom="true"/>
  <option collision="predefined" density="4000" integrator="RK4" timestep="0.01" viscosity="0.1"/>
  <default>
    <geom conaffinity="1" condim="1" contype="1" material="geom" rgba="0.8 0.6 .4 1"/>
    <joint armature='0.1'  />
  </default>
  <asset>
    <texture builtin="gradient" height="100" rgb1="1 1 1" rgb2="0 0 0" type="skybox" width="100"/>
    <texture builtin="flat" height="1278" mark="cross" markrgb="1 1 1" name="texgeom" random="0.01" rgb1="0.8 0.6 0.4" rgb2="0.8 0.6 0.4" type="cube" width="127"/>
    <texture builtin="checker" height="100" name="texplane" rgb1="0 0 0" rgb2="0.8 0.8 0.8" type="2d" width="100"/>
    <material name="MatPlane" reflectance="0.5" shininess="1" specular="1" texrepeat="30 30" texture="texplane"/>
    <material name="geom" texture="texgeom" texuniform="true"/>
  </asset>
  <worldbody>
    <light cutoff="100" diffuse="1 1 1" dir="-0 0 -1.3" directional="true" exponent="1" pos="0 0 1.3" specular=".1 .1 .1"/>
    <geom conaffinity="1" condim="3" material="MatPlane" name="floor" pos="0 0 -0.1" rgba="0.8 0.9 0.8 1" size="40 40 0.1" type="plane"/>
    <!--  ================= SWIMMER ================= /-->
    <body name="torso" pos="0 0 0">
      <camera name="track" mode="trackcom" pos="0 -3 3" xyaxes="1 0 0 0 1 1"/>
      <geom density="1000" fromto="1.5 0 0 0.5 0 0" size="0.1" type="capsule"/>
      <joint axis="1 0 0" name="slider1" pos="0 0 0" type="slide"/>
      <joint axis="0 1 0" name="slider2" pos="0 0 0" type="slide"/>
      <joint axis="0 0 1" name="rot" pos="0 0 0" type="hinge"/>
      <body name="mid" pos="0.5 0 0">
        <geom density="1000" fromto="0 0 0 -1 0 0" size="0.1" type="capsule"/>
        <joint axis="0 0 1" limited="true" name="rot2" pos="0 0 0" range="-100 100" type="hinge"/>
        <body name="back" pos="-1 0 0">
          <geom density="1000" fromto="0 0 0 -1 0 0" size="0.1" type="capsule"/>
          <joint axis="0 0 1" limited="true" name="rot3" pos="0 0 0" range="-100 100" type="hinge"/>
        </body>
      </body>
    </body>
  </worldbody>
  <actuator>
    <motor ctrllimited="true" ctrlrange="-1 1" gear="150.0" joint="rot2"/>
    <motor ctrllimited="true" ctrlrange="-1 1" gear="150.0" joint="rot3"/>
  </actuator>
</mujoco>
```

Can someone point me to a good tutorial / sample code where it is shown how to change model parameters ?

christopherhesse, 2019-09-13:
From http://www.mujoco.org/book/XMLreference.html it looks like you can set the `geom`'s `density` property:

```
density : real, "1000"
Material density used to compute the geom mass and inertia. The computation is based on the geom shape and the assumption of uniform density. The internal default of 1000 is the density of water in SI units. This attribute is used only when the mass attribute above is unspecified.
```

Closed 2019-09-13.

Thread 1685 (2019-09-18):

Can I randomise the scenario played in the OpenAI Gym Atari environments?

dimitar-hristov, 2019-09-18:
I am looking at the Seaquest Atari game in OpenAI Gym and I have the following code snippet:
```
import gym
import time
import random

env = gym.make('Seaquest-v4')

for i_episode in range(10):
    seed = (int)(time.time())
    random.seed(seed)
    env.seed(seed)
    observation = env.reset()
    for t in range(800):
        env.render()
        time.sleep(0.01)
        action = 0
        observation, reward, done, info = env.step(action)
        if done:
            print("Episode finished after {} timesteps".format(t+1))
            break
env.close()
```
The code above renders 10 games, however, even though I reset the seed every time to be unique, I still get the same scenario of the game. As a result the agent is trained on the same scenario. Could someone suggest a way to fix this? I am just trying to find a way to make the Atari emulator to produce different scenarios of the game.

christopherhesse, 2019-09-20:
In general no, atari games are entirely deterministic.

ALE supports different difficulty modes which are like a small number of unique scenarios.  Your other options are: add action noise (like sticky frame skip from this paper: https://arxiv.org/pdf/1804.03720.pdf), or collect a set of starting states and restore to a random state on each reset (this isn't supported by all gym environments, but ALE happens to have this feature).  Collecting a set of starting state can be done by playing the game a bunch or having the agent play the game a bunch, though in the second case your game states might not be very diverse.

Closed 2019-09-20.

Thread 1692 (2019-09-26):

enlarging scene in Box2d

MohammadHossein-Bahari, 2019-09-26:
I want to make the whole scene (not the observations but the whole road image like the attached image) larger in Box2d. I know I have to change VIDEO_W, VIDEO_H, WINDOW_W and WINDOW_H but when I change them, it generates shifted images. Where is the offset in the code?
Here are the values I use:

STATE_W = 96   # less than Atari 160x192
STATE_H = 96
VIDEO_W = 2000
VIDEO_H = 2000
WINDOW_W = 2000
WINDOW_H = 2000

SCALE       = 5.0        # Track scale
window_scale = 2#1.95
TRACK_RAD   = 900/SCALE  # Track is heavily morphed circle with this radius
PLAYFIELD   = 2000/SCALE # Game over boundary
FPS         = 1          # Originally was 30, I (Hossein) changed it to 1
ZOOM        = 1.0        # Camera zoom
ZOOM_FOLLOW = True       # Set to False for fixed view (don't use zoom)

TRACK_DETAIL_STEP = 21/SCALE #21/SCALE
TRACK_TURN_RATE = 0.31
TRACK_WIDTH = 40/SCALE #140
BORDER = 8/SCALE
BORDER_MIN_COUNT = 4

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

MohammadHossein-Bahari, 2019-10-09:
I finally solved the issue!
It seems that it comes from issues with the screen size as I have different results with different screens but here is a trick to get rid of it.
There is a function : get_track(self, num_checkpoints, track_rad=900/SCALE, x_bias=-20, y_bias=0).
Just change the bias values and it shifts the road.

Closed 2019-10-09.

Thread 1698 (2019-10-03):

Defender-ram-v0 doesn't initialize

jacekplocharczyk, 2019-10-03:
Hi,
could you check why `Defender-ram-v0` cannot initialize the environment?

I've tested it in the jupyter online https://jupyter.org/try - jupyter lab.
```Python
!pip install gym[atari]

import gym
env = gym.make('DemonAttack-ram-v0') # works
print(env)
env = gym.make('Defender-ram-v0') # doesn't work (it hangs)
print(env)
```

Edit.
I've tested all environments in my docker container and all versions of the `Defender-*` doesn't work.

christopherhesse, 2019-10-12:
I was able to reproduce this on colaboratory, but not on a normal linux machine.  This could be a bug in https://github.com/mgbellemare/Arcade-Learning-Environment or else a bug in how colab/jupyter handles something.

Can you try running this directly on a linux machine without docker?

jacekplocharczyk, 2019-10-16:
Unfortunately I can't recreate the whole docker setup (there are a lot of CUDA related stuff and I don't want to mess with the NVIDIA drivers).

If that helps here is the [Dockerfile](https://github.com/jacekplocharczyk/jupyter-lab-server/blob/master/Dockerfile).

christopherhesse, 2019-10-25:
This looks to be an issue with the defender rom, the following Dockerfile seems to work for me:

```
FROM continuumio/miniconda:4.7.12
RUN conda install python==3.7.3
RUN pip install gym[atari]
RUN apt-get update && apt-get install -y procps
RUN pip install py-spy
RUN python -c "import gym; env = gym.make('DemonAttack-ram-v0'); print(env.reset().shape)"
RUN md5sum /opt/conda/lib/python3.7/site-packages/atari_py/atari_roms/defender.bin
ADD defender.bin /opt/conda/lib/python3.7/site-packages/atari_py/atari_roms/defender.bin
RUN md5sum /opt/conda/lib/python3.7/site-packages/atari_py/atari_roms/defender.bin
RUN python -c "import gym; env = gym.make('Defender-ram-v0'); print(env.reset().shape)"
```

The newest version of atari-py doesn't have this issue because it doesn't include the bad rom (https://github.com/openai/atari-py#roms).  Your ROM md5 should match the one in this file: https://github.com/mgbellemare/Arcade-Learning-Environment/blob/master/md5.txt

We should upgrade atari-py to the new ale-py when that is available and it should fix this issue in general: https://github.com/mgbellemare/Arcade-Learning-Environment/pull/272

gitanshu, 2020-03-05:
Bump!
I still see the same issue, can reliably reproduce on ubuntu 18.04 on local, and in docker on CI, even with latest release of gym.
It works fine though if I downgrade `atari-py` to latest `0.1.x`.

christopherhesse, 2020-06-24:
I think the new version of ale-py is almost ready, and @JesseFarebro was considering upgrading the version gym uses, but I haven't heard about the status of that recently.

JesseFarebro, 2020-06-24:
I am blocked on a couple of things right now but I'll push to have this completed in the next couple of weeks.

Closed 2021-08-10.

Thread 1700 (2019-10-05):

env.render() needs MESA_swap_control on raspberry 4b

pengyusi, 2019-10-05:
i've installed the OpenGL and the nessecery libs, but when i run the first example CartPole, the function render goes wrong like the following:

Traceback (most recent call last):
  File "gymtest.py", line 5, in <module>
    env.render()
  File "/home/pi/Documents/Reinforcement_Learning/reinforcement-learning-master/Introduction/gym/gym/core.py", line 233, in render
    return self.env.render(mode, **kwargs)
  File "/home/pi/Documents/Reinforcement_Learning/reinforcement-learning-master/Introduction/gym/gym/envs/classic_control/cartpole.py", line 150, in render
    from gym.envs.classic_control import rendering
  File "/home/pi/Documents/Reinforcement_Learning/reinforcement-learning-master/Introduction/gym/gym/envs/classic_control/rendering.py", line 27, in <module>
    from pyglet.gl import *
  File "/usr/local/lib/python3.7/dist-packages/pyglet/gl/__init__.py", line 236, in <module>
    import pyglet.window
  File "/usr/local/lib/python3.7/dist-packages/pyglet/window/__init__.py", line 1816, in <module>
    gl._create_shadow_window()
  File "/usr/local/lib/python3.7/dist-packages/pyglet/gl/__init__.py", line 205, in _create_shadow_window
    _shadow_window = Window(width=1, height=1, visible=False)
  File "/usr/local/lib/python3.7/dist-packages/pyglet/window/xlib/__init__.py", line 163, in __init__
    super(XlibWindow, self).__init__(*args, **kwargs)
  File "/usr/local/lib/python3.7/dist-packages/pyglet/window/__init__.py", line 558, in __init__
    self._create()
  File "/usr/local/lib/python3.7/dist-packages/pyglet/window/xlib/__init__.py", line 261, in _create
    self.context.set_vsync(self._vsync) # XXX ?
  File "/usr/local/lib/python3.7/dist-packages/pyglet/gl/xlib.py", line 228, in set_vsync
    glxext_mesa.glXSwapIntervalMESA(interval)
  File "/usr/local/lib/python3.7/dist-packages/pyglet/gl/lib.py", line 62, in MissingFunction
    raise MissingFunctionException(name, requires, suggestions)
pyglet.gl.lib.MissingFunctionException: glXSwapIntervalMESA is not exported by the available OpenGL driver.  MESA_swap_control is required for this functionality.

christopherhesse, 2019-10-11:
Are you able to run `glxgears`?  This seems like a not good mesa driver, could you try using the newest mesa driver as well?

sgabor1, 2019-12-18:
Changing line ~/virtualenvs/env/lib/python3.7/site-packages/pyglet/gl/xlib.py:209:
`self._have_MESA_swap_control = config.glx_info.have_extension('GLX_MESA_swap_control')`
to
`self._have_MESA_swap_control = config.glx_info.have_extension('GLX_EXT_swap_control')`
did the trick for me on Raspberry Pi 4B

Credit goes to: https://www.mail-archive.com/pyglet-users@googlegroups.com/msg11146.html

Closed 2019-12-20.

Thread 1729 (2019-11-01):

Sampling Bug

gowtham1997, 2019-11-01:
Gym Version: 0.15.3
issue: Box samples numbers above the `high` parameter.

```
from gym.spaces import Box
observation_space = Box(low=-3, high=-1, shape=(9,), dtype='int')
print(observation_space.sample())
>> [ 0 -2  0 -2  0 -1  0 -2  0]
```
The current implementation samples float numbers from uniform distribution of [`low`, `high`] and then converts the resulting samples to desired `dtype`. This runs into the problem of sampling `low` parameter very rarely(and not uniformly) when `dtype` is `int`(as we are converting the floats back to int which results in ceil operation in case of negative numbers) i.e in the above example -3 is almost never sampled as most of the low sampled floats like -2.85, -2.9 get converted to -2.
https://github.com/openai/gym/blob/0cd9266d986d470ed9c0dd87a41cd680b65cfe1c/gym/spaces/box.py#L93-L97

pzhokhov, 2019-11-01:
moved the discussion into the PR

Closed 2019-11-01.

Thread 1742 (2019-11-12):

Deactivate rendering of desired goal in MuJoCo Envs

weidler, 2019-11-12:
I need the rendered frames from the HandEnv, but without the slightly transparent desired goal. Camera, colors, etc. were easily adjustable using viewer and sim, but I cannot find a way to completely deactivate the desired goal. Is it possible to add this as a parameter to the Environment class?

And until then, what would be a reasonable workaround? I could make the desired goal's texture completely transparent, but I assume it then is still "rendered", which adds computation time.

pzhokhov, 2019-12-20:
@MillionIntegrals @ntezak do you know if that's possible / easy to implement?

jkterry1, 2022-05-23:
PR #2762 is about to be merged, introducing V4 MuJoCo environments using new bindings and a dramatically newer version of the engine. If this issue still persists with the V4 ones, please create a new issue for it.

Closed 2022-05-23.

Thread 1757 (2019-12-01):

distutils.errors.LinkError: command 'gcc' failed with exit status 1 on Import

mehrotrasan16, 2019-12-01:
>> python3 gymtest.py # this imports mujoco and tries to make an environment
Choosing the latest nvidia driver: /usr/lib/nvidia-430, among ['/usr/lib/nvidia-375', '/usr/lib/nvidia-430']
Choosing the latest nvidia driver: /usr/lib/nvidia-430, among ['/usr/lib/nvidia-375', '/usr/lib/nvidia-430']
running build_ext
building 'mujoco_py.cymj' extension
gcc -pthread -B /home/sanket/anaconda3/compiler_compat -Wl,--sysroot=/ -Wsign-compare -DNDEBUG -g -fwrapv -O3 -Wall -fPIC -Imujoco_py -I/home/sanket/.mujoco/mujoco-py/mujoco_py -I/home/sanket/.mujoco/mujoco200/include -I/home/sanket/anaconda3/lib/python3.7/site-packages/numpy/core/include -I/home/sanket/.mujoco/mujoco-py/mujoco_py/vendor/egl -I/home/sanket/anaconda3/include/python3.7m -c /home/sanket/.mujoco/mujoco-py/mujoco_py/cymj.c -o /home/sanket/.mujoco/mujoco-py/mujoco_py/generated/_pyxbld_2.0.2.7_37_linuxgpuextensionbuilder/temp.linux-x86_64-3.7/home/sanket/.mujoco/mujoco-py/mujoco_py/cymj.o -fopenmp -w
gcc -pthread -B /home/sanket/anaconda3/compiler_compat -Wl,--sysroot=/ -Wsign-compare -DNDEBUG -g -fwrapv -O3 -Wall -fPIC -Imujoco_py -I/home/sanket/.mujoco/mujoco-py/mujoco_py -I/home/sanket/.mujoco/mujoco200/include -I/home/sanket/anaconda3/lib/python3.7/site-packages/numpy/core/include -I/home/sanket/.mujoco/mujoco-py/mujoco_py/vendor/egl -I/home/sanket/anaconda3/include/python3.7m -c /home/sanket/.mujoco/mujoco-py/mujoco_py/gl/eglshim.c -o /home/sanket/.mujoco/mujoco-py/mujoco_py/generated/_pyxbld_2.0.2.7_37_linuxgpuextensionbuilder/temp.linux-x86_64-3.7/home/sanket/.mujoco/mujoco-py/mujoco_py/gl/eglshim.o -fopenmp -w
gcc -pthread -shared -B /home/sanket/anaconda3/compiler_compat -L/home/sanket/anaconda3/lib -Wl,-rpath=/home/sanket/anaconda3/lib -Wl,--no-as-needed -Wl,--sysroot=/ /home/sanket/.mujoco/mujoco-py/mujoco_py/generated/_pyxbld_2.0.2.7_37_linuxgpuextensionbuilder/temp.linux-x86_64-3.7/home/sanket/.mujoco/mujoco-py/mujoco_py/cymj.o /home/sanket/.mujoco/mujoco-py/mujoco_py/generated/_pyxbld_2.0.2.7_37_linuxgpuextensionbuilder/temp.linux-x86_64-3.7/home/sanket/.mujoco/mujoco-py/mujoco_py/gl/eglshim.o -L/home/sanket/.mujoco/mujoco200/bin -Wl,-R/home/sanket/.mujoco/mujoco200/bin -lmujoco200 -lglewegl -o /home/sanket/.mujoco/mujoco-py/mujoco_py/generated/_pyxbld_2.0.2.7_37_linuxgpuextensionbuilder/lib.linux-x86_64-3.7/mujoco_py/cymj.cpython-37m-x86_64-linux-gnu.so -fopenmp
/home/sanket/anaconda3/compiler_compat/ld: cannot find -lmujoco200
/home/sanket/anaconda3/compiler_compat/ld: cannot find -lglewegl
collect2: error: ld returned 1 exit status
Traceback (most recent call last):
  File "/home/sanket/anaconda3/lib/python3.7/distutils/unixccompiler.py", line 205, in link
    self.spawn(linker + ld_args)
  File "/home/sanket/anaconda3/lib/python3.7/distutils/ccompiler.py", line 909, in spawn
    spawn(cmd, dry_run=self.dry_run)
  File "/home/sanket/anaconda3/lib/python3.7/distutils/spawn.py", line 36, in spawn
    _spawn_posix(cmd, search_path, dry_run=dry_run)
  File "/home/sanket/anaconda3/lib/python3.7/distutils/spawn.py", line 159, in _spawn_posix
    % (cmd, exit_status))
distutils.errors.DistutilsExecError: command 'gcc' failed with exit status 1

During handling of the above exception, another exception occurred:

Traceback (most recent call last):
  File "gymtest.py", line 3, in <module>
    from gym.envs.mujoco import mujoco_env
  File "/home/sanket/anaconda3/lib/python3.7/site-packages/gym/envs/mujoco/__init__.py", line 1, in <module>
    from gym.envs.mujoco.mujoco_env import MujocoEnv
  File "/home/sanket/anaconda3/lib/python3.7/site-packages/gym/envs/mujoco/mujoco_env.py", line 12, in <module>
    import mujoco_py
  File "/home/sanket/.mujoco/mujoco-py/mujoco_py/__init__.py", line 3, in <module>
    from mujoco_py.builder import cymj, ignore_mujoco_warnings, functions, MujocoException
  File "/home/sanket/.mujoco/mujoco-py/mujoco_py/builder.py", line 506, in <module>
    cymj = load_cython_ext(mujoco_path)
  File "/home/sanket/.mujoco/mujoco-py/mujoco_py/builder.py", line 105, in load_cython_ext
    cext_so_path = builder.build()
  File "/home/sanket/.mujoco/mujoco-py/mujoco_py/builder.py", line 221, in build
    built_so_file_path = self._build_impl()
  File "/home/sanket/.mujoco/mujoco-py/mujoco_py/builder.py", line 291, in _build_impl
    so_file_path = super()._build_impl()
  File "/home/sanket/.mujoco/mujoco-py/mujoco_py/builder.py", line 244, in _build_impl
    dist.run_commands()
  File "/home/sanket/anaconda3/lib/python3.7/distutils/dist.py", line 966, in run_commands
    self.run_command(cmd)
  File "/home/sanket/anaconda3/lib/python3.7/distutils/dist.py", line 985, in run_command
    cmd_obj.run()
  File "/home/sanket/anaconda3/lib/python3.7/site-packages/Cython/Distutils/old_build_ext.py", line 186, in run
    _build_ext.build_ext.run(self)
  File "/home/sanket/anaconda3/lib/python3.7/distutils/command/build_ext.py", line 340, in run
    self.build_extensions()
  File "/home/sanket/.mujoco/mujoco-py/mujoco_py/builder.py", line 144, in build_extensions
    build_ext.build_extensions(self)
  File "/home/sanket/anaconda3/lib/python3.7/site-packages/Cython/Distutils/old_build_ext.py", line 194, in build_extensions
    self.build_extension(ext)
  File "/home/sanket/anaconda3/lib/python3.7/distutils/command/build_ext.py", line 559, in build_extension
    target_lang=language)
  File "/home/sanket/anaconda3/lib/python3.7/distutils/ccompiler.py", line 717, in link_shared_object
    extra_preargs, extra_postargs, build_temp, target_lang)
  File "/home/sanket/anaconda3/lib/python3.7/distutils/unixccompiler.py", line 207, in link
    raise LinkError(msg)
distutils.errors.LinkError: command 'gcc' failed with exit status 1

I get that it is because
/home/sanket/anaconda3/compiler_compat/ld: cannot find -lmujoco200
/home/sanket/anaconda3/compiler_compat/ld: cannot find -lglewegl
are missing but i can't find too much about what they are and how to fix it.

mehrotrasan16, 2019-12-01:
Accidentally opened this issue in gym instead of mujoco-py. I am sorry for the inconvenience.

Closed 2019-12-01.

Thread 1770 (2019-12-20):

PixelObservationWrapper: suppress render window

biggzlar, 2019-12-20:
Is this implemented already? I did not find any documentation about how to suppress the actual rendering when using PixelObservationWrapper on either box2d or mujoco environments.

pzhokhov, 2019-12-20:
@biggzlar you mean `render(mode='rgb_array' )` such that no extra windows show up on the screen? I don't think we ever engineered for that. Other than the small nuisance of the new windows, what is the harm in the actual rendering?

biggzlar, 2019-12-20:
The only issue is that you can't run these in headless environments. Not sure if that is feasible with the current wrapper, but that would be a valuable addition, I believe.

biggzlar, 2019-12-21:
Additionally, although this might be a corner case: on the machine I use to prototype, rendering an atari environment during training adds about 0.5 seconds to each training step (128 timesteps in single environment). That's about a 25% increase in time spent on every update.

pzhokhov, 2019-12-21:
The issue of headless environments - sure you can! use xfvb-run, or xvfb daemon (here's an example of how we use it in the gym to run CI on the environments:
https://github.com/openai/gym/blob/master/bin/docker_entrypoint
and
https://github.com/openai/gym/blob/master/py.Dockerfile#L24

The issue of rendering speed - you are right, the atari to lunar lander comparison is not a very fair one (engine is different, rendering is different etc). Which is not to say LunarLander cannot possibly be optimized to run faster - it probably can; however, to my knowledge rendering and stepping of lunarlander are rarely a bottleneck. Those 15s / iteration - what iteration do you mean?

Matplotlib crashing - that's an interesting one (although I suspect that's indeed pyglet or matplotlib issue)... Could you provide more details? I ran
```
(gym) peterz-macbook:gym peterz$ python
Python 3.7.0 (v3.7.0:1bf9cc5093, Jun 26 2018, 23:26:24)
[Clang 6.0 (clang-600.0.57)] on darwin
Type "help", "copyright", "credits" or "license" for more information.
>>> import matplotlib.pyplot as plt
>>> import gym
>>> env = gym.make('LunarLander-v2')
/Users/peterz/dev/gym/gym/logger.py:30: UserWarning: WARN: Box bound precision lowered by casting to float32
  warnings.warn(colorize('%s: %s'%('WARN', msg % args), 'yellow'))
>>> env.reset()
array([ 0.00685616,  1.4052299 ,  0.6944416 , -0.2529169 , -0.0079378 ,
       -0.15730134,  0.        ,  0.        ], dtype=float32)
>>> img = env.render(mode='rgb_array')
2019-12-21 16:36:03.220 Python[42097:528016535] ApplePersistenceIgnoreState: Existing state will not be touched. New state will be written to (null)
>>> plt.imshow(img)
<matplotlib.image.AxesImage object at 0x123062080>
>>> plt.show()
```
and it worked fine (venv python 3.7 , osx 10.14.6, pyglet==1.3.3, matplotlib==3.1.1)

Closed 2021-12-30.

Thread 1777 (2020-01-05):

Behaviors of Atari envs have changed by atari-py>=0.2

muupan, 2020-01-05:
The behaviors of Atari envs seem affected by the version of `atari-py` even though the env id the same.

```python
import gym

env = gym.make('MsPacmanNoFrameskip-v4')
env.seed(0)
env.reset()
done = False
t = 0
R = 0
while not done:
    _, r, done, _ = env.step(1)
    t += 1
    R += r
print(t, R)
```
Below is the output of this code for each pair of `gym` and `atari-py`. It seem like `atari-py` is the cause of the difference, but since `gym` requires `atari-py~=0.2.0` in `setup.py` from 1.3.0 (https://github.com/openai/gym/pull/1535) it should be responsible for the version of `atari-py`. That is why I opened this issue here, not in https://github.com/openai/atari-py.
- `gym==0.15.4` `atari-py==0.2.6`: 2009 90.0
- `gym==0.15.4` `atari-py==0.2.0`: 2009 90.0
- `gym==0.15.4` `atari-py==0.1.15`: 1329 90.0
- `gym==0.15.4` `atari-py==0.1.4`: 1329 90.0
- `gym==0.12.6` `atari-py==0.2.6`: 2009 90.0
- `gym==0.12.6` `atari-py==0.2.0`: 2009 90.0
- `gym==0.12.6` `atari-py==0.1.15`: 1329 90.0
- `gym==0.12.6` `atari-py==0.1.4`: 1329 90.0

I also confirmed such a difference for `ChopperCommandNoFrameskip-v4`.

I am concerned that these differences might significantly affect the evaluation of RL algorithms. Has anyone investigated the effect?

muupan, 2020-01-06:
Below are the results obtained by my PPO implementation on Atari using 3 different seeds for each configuration. `gym==0.12.1` was used. It seems that it actually affect the performance for some games. I'm not sure what change in atari-py or ALE caused this though.

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

kngwyu, 2020-01-06:
https://github.com/openai/atari-py/pull/49 looks the biggest change

christopherhesse, 2020-01-10:
The changes were meant specifically to not change the behavior of the environments: https://github.com/openai/atari-py/pull/49#issuecomment-495732015

@JesseFarebro any idea what might be going on here?

christopherhesse, 2020-01-10:
Thanks for investigating this @muupan

JesseFarebro, 2020-01-11:
Hi @muupan @christopherhesse,

Thanks for bringing this to my attention. I'll investigate further and let you know what my findings are.

JesseFarebro, 2020-01-11:
Thanks for the reproduction @muupan.

With regards to **Ms. Pacman**: Essentially what is happening is once you press the select button too many times the game just begins. We press the select button in order to select modes and difficulties. The following commit introduced this bug: https://github.com/mgbellemare/Arcade-Learning-Environment/commit/7bff96b4b64edcffbeb2d9bb83b1685ab506ea2b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. I will open an issue upstream and see what can be done about this. This should have minimal effects on performance comparisons between `v0.5.2` and `v0.6.*`. This bug makes it so there would be different episode starting locations. Here are two images, each contains the first frame between versions `v0.5.2` and `v0.6.0`.

### Ms. Pacman v0.5.2
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
### Ms. Pacman v0.6.0
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

With regards to **Chopper Command**: The issue that affects Ms. Pacman also affects Chopper Command. The call to `softReset` happens in two places. The one linked above and also https://github.com/mgbellemare/Arcade-Learning-Environment/commit/31d8e17f404ead5c84cef834f7323a24226003cb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.

As for the performance difference in your PPO agent that doesn't actually strike me as overly surprising. If we assume that these two runs weren't completely deterministic (due to a different episode starting point as discussed above, or an improper seed) these curves seem within reason for 3 seeds. I looked at the original PPO paper and their results on Chopper Command show large variance between runs their 3 runs.

I'll post these issues upstream along with your learning curves and we'll see what @mgbellemare and @mcmachado think. I'm not too familiar with the `v0.5.2` -> `v0.6.0` code so maybe they can provide more insight on the `softReset()` calls.

Hopefully, this helps clear some things up.

christopherhesse, 2020-01-17:
Thanks for investigating @JesseFarebro!

JesseFarebro, 2021-08-05:
This is being tracked upstream https://github.com/mgbellemare/Arcade-Learning-Environment/issues/291. Feel free to close this.

Closed 2021-08-05.

Thread 1785 (2020-01-14):

env.render returns error: item 1 in _argtypes_ passes a union by value

julienroyd, 2020-01-14:
Hi,

I use Ubuntu 18.04. I can reproduce this error in a minimal example by creating a new conda environment and only `pip install gym`, so that the env only contains the following packages:

```
certifi==2019.11.28
cloudpickle==1.2.2
future==0.18.2
gym==0.15.4
numpy==1.18.1
opencv-python==4.1.2.30
pyglet==1.3.2
scipy==1.4.1
six==1.13.0
```

When I run the following code in that env:

```
import gym
env = gym.make('CartPole-v0')
env.reset()

for _ in range(1000):
    env.render()
    env.step(env.action_space.sample())
```

I get the following error:

```
Traceback (most recent call last):
  File "<frozen importlib._bootstrap>", line 1035, in _handle_fromlist
  File "<frozen importlib._bootstrap>", line 219, in _call_with_frames_removed
  File "/home/jroy4/anaconda3/envs/irl/lib/python3.7/site-packages/gym/envs/classic_control/rendering.py", line 27, in <module>
    from pyglet.gl import *
  File "/home/jroy4/anaconda3/envs/irl/lib/python3.7/site-packages/pyglet/gl/__init__.py", line 221, in <module>
    from .xlib import XlibConfig as Config
  File "/home/jroy4/anaconda3/envs/irl/lib/python3.7/site-packages/pyglet/gl/xlib.py", line 12, in <module>
    from pyglet.canvas.xlib import XlibCanvas
  File "/home/jroy4/anaconda3/envs/irl/lib/python3.7/site-packages/pyglet/canvas/__init__.py", line 103, in <module>
    from pyglet.canvas.xlib import XlibDisplay as Display
  File "/home/jroy4/anaconda3/envs/irl/lib/python3.7/site-packages/pyglet/canvas/xlib.py", line 19, in <module>
    from . import xlib_vidmoderestore
  File "/home/jroy4/anaconda3/envs/irl/lib/python3.7/site-packages/pyglet/canvas/xlib_vidmoderestore.py", line 23, in <module>
    from pyglet.libs.x11 import xlib
  File "/home/jroy4/anaconda3/envs/irl/lib/python3.7/site-packages/pyglet/libs/x11/xlib.py", line 2928, in <module>
    XEHeadOfExtensionList.argtypes = [XEDataObject]
TypeError: item 1 in _argtypes_ passes a union by value, which is unsupported.
```

Any idea what is going on? Thanks!

**Edit: I use python=3.7.6**

julienroyd, 2020-01-14:
It seems that the error only occurs with `python=3.7.6`

The code sample works fine with `python=3.7.4`

0dj0bz, 2020-01-17:
Based on similar issues found in Google searches, it seems that 3.7.6 "fixed" some bugs that has broken quite a few libraries.

0dj0bz, 2020-01-17:
I upgraded pyglet to 1.4.10 and this fixed my issue with `python=3.7.6`.

christopherhesse, 2020-01-17:
Thanks @0dj0bz for the workaround.  https://github.com/openai/gym/pull/1771 should hopefully fix this

HenryJia, 2020-01-18:
Using pyglet>=1.4 seems to instead give me

```
Traceback (most recent call last):
  File "ppo-lunarlandercontinuous.py", line 49, in <module>
    recorder.capture_frame()
  File "/usr/lib/python3.8/site-packages/gym/wrappers/monitoring/video_recorder.py", line 101, in capture_frame
    frame = self.env.render(mode=render_mode)
  File "/usr/lib/python3.8/site-packages/gym/core.py", line 235, in render
    return self.env.render(mode, **kwargs)
  File "/usr/lib/python3.8/site-packages/gym/envs/box2d/lunar_lander.py", line 354, in render
    return self.viewer.render(return_rgb_array = mode=='rgb_array')
  File "/usr/lib/python3.8/site-packages/gym/envs/classic_control/rendering.py", line 105, in render
    arr = np.frombuffer(image_data.data, dtype=np.uint8)
AttributeError: 'ImageData' object has no attribute 'data'
```

Although I am using python 3.8

christopherhesse, 2020-02-07:
#1771  was merged, please file a new issue if you observe this with `gym>=0.15.6`

Closed 2020-02-07.

Thread 1811 (2020-02-15):

gym+mujoco finish execute raise OpenGL.error.NullFunctionError

yaoxunji, 2020-02-15:
I try to test gym+mujoco using this code
```
import gym
env = gym.make('Walker2d-v1')
for i_episode in range(20):
    observation = env.reset()
    for t in range(100):
        env.render()
        action = env.action_space.sample()
        observation, reward, done, info = env.step(action)
        if done:
            print("Episode {} finished after {} timesteps".format(i_episode,t+1))
            break
```
when finish execute it raise

> OpenGL.error.NullFunctionError: Attempt to call an undefined function glIsFramebuffer, check for bool(glIsFramebuffer) before calling

all error:
```
Error in atexit._run_exitfuncs:
Traceback (most recent call last):
  File "D:\Anaconda\envs\mujoco\lib\site-packages\gym\utils\closer.py", line 67, in close
    closeable.close()
  File "D:\Anaconda\envs\mujoco\lib\site-packages\gym\core.py", line 167, in close
    self.render(close=True)
  File "D:\Anaconda\envs\mujoco\lib\site-packages\gym\core.py", line 153, in render
    return self._render(mode=mode, close=close)
  File "D:\Anaconda\envs\mujoco\lib\site-packages\gym\envs\mujoco\mujoco_env.py", line 105, in _render
    self._get_viewer().finish()
  File "D:\Anaconda\envs\mujoco\lib\site-packages\mujoco_py\mjviewer.py", line 327, in finish
    if gl.glIsFramebuffer(self._fbo):
  File "D:\Anaconda\envs\mujoco\lib\site-packages\OpenGL\platform\baseplatform.py", line 425, in __call__
    self.__name__, self.__name__,
OpenGL.error.NullFunctionError: Attempt to call an undefined function glIsFramebuffer, check for bool(glIsFramebuffer) before calling
Exception ignored in: <bound method Env.__del__ of <TimeLimit<Walker2dEnv<Walker2d-v1>>>>
Traceback (most recent call last):
  File "D:\Anaconda\envs\mujoco\lib\site-packages\gym\core.py", line 202, in __del__
  File "D:\Anaconda\envs\mujoco\lib\site-packages\gym\core.py", line 169, in close
  File "D:\Anaconda\envs\mujoco\lib\site-packages\gym\core.py", line 288, in _close
  File "D:\Anaconda\envs\mujoco\lib\site-packages\gym\core.py", line 167, in close
  File "D:\Anaconda\envs\mujoco\lib\site-packages\gym\core.py", line 153, in render
  File "D:\Anaconda\envs\mujoco\lib\site-packages\gym\envs\mujoco\mujoco_env.py", line 105, in _render
  File "D:\Anaconda\envs\mujoco\lib\site-packages\mujoco_py\mjviewer.py", line 325, in finish
  File "D:\Anaconda\envs\mujoco\lib\site-packages\mujoco_py\glfw.py", line 808, in destroy_window
OSError: exception: access violation reading 0x0000000000000000
Exception ignored in: <bound method Env.__del__ of <gym.envs.mujoco.walker2d.Walker2dEnv object at 0x000001FE7D20A7B8>>
Traceback (most recent call last):
  File "D:\Anaconda\envs\mujoco\lib\site-packages\gym\core.py", line 202, in __del__
  File "D:\Anaconda\envs\mujoco\lib\site-packages\gym\core.py", line 167, in close
  File "D:\Anaconda\envs\mujoco\lib\site-packages\gym\core.py", line 153, in render
  File "D:\Anaconda\envs\mujoco\lib\site-packages\gym\envs\mujoco\mujoco_env.py", line 105, in _render
  File "D:\Anaconda\envs\mujoco\lib\site-packages\mujoco_py\mjviewer.py", line 325, in finish
  File "D:\Anaconda\envs\mujoco\lib\site-packages\mujoco_py\glfw.py", line 808, in destroy_window
OSError: exception: access violation reading 0x0000000000000000
```
my configuration as follows and in win10 and python 3.6
```
mujoco-py            0.5.7
gym         0.9.1
PyOpenGL            3.1.5
```

christopherhesse, 2020-02-21:
That seems like the function should exist, are you using some sort of super old video card?

gfreund123, 2020-09-03:
Same issue

1009351456, 2021-07-16:
same issue!! why nobody answer this question!

jkterry1, 2022-05-23:
PR #2762 is about to be merged, introducing V4 MuJoCo environments using new bindings and a dramatically newer version of the engine. If this issue still persists with the V4 ones, please create a new issue for it.

Closed 2022-05-23.

Thread 1833 (2020-03-03):

error while creating custom gym env : No registered env with id: Env-v4

pgsudheesh, 2020-03-03:
>>>gym.make('Env-v4') is the command, the error is
Traceback (most recent call last):
  File "C:\Python\Python38\lib\site-packages\gym\envs\registration.py", line 118, in spec
    return self.env_specs[id]
KeyError: 'Env-v4'

During handling of the above exception, another exception occurred:

Traceback (most recent call last):
  File "<stdin>", line 1, in <module>
  File "C:\Python\Python38\lib\site-packages\gym\envs\registration.py", line 142, in make
    return registry.make(id, **kwargs)
  File "C:\Python\Python38\lib\site-packages\gym\envs\registration.py", line 86, in make
    spec = self.spec(path)
  File "C:\Python\Python38\lib\site-packages\gym\envs\registration.py", line 128, in spec
    raise error.UnregisteredEnv('No registered env with id: {}'.format(id))
gym.error.UnregisteredEnv: No registered env with id: Env-v4

custom_env.py is import gym
class CustomEnv(gym.Env):
    def __init__(self):
        print('Environment initialized')
    def step(self):
        print('Step successful!')
    def reset(self):
        print('Environment reset')
two init.py are
from envs.custom_env_dir.custom_env import CustomEnv
and
from gym.envs.registration import  register
register(id='Env-v4',
    entry_point='envs.custom_env_dir:CustomEnv',
    tags={'wrapper_config.TimeLimit.max_episode_steps': 200},
    reward_threshold=8, # optimum = 8.46
)

after pip install -e .   i called import gym, import envs, env=gym.make('Env-v4')

What is the error here
what is the reason of error

kirstenrichardson, 2020-03-05:
Having the same problem and tried everything in all the comments of the associated issues, must be missing something small. Grateful of any help

kirstenrichardson, 2020-03-05:
Just to let you know (despite making myself look stupid) my issue was that my init.py files had single underscores either side instead of double so they weren't running ...... just on the off-chance you've done the same

pgsudheesh, 2020-03-06:
that worked. please dont call me stupid :). thanks by the way

christopherhesse, 2020-03-06:
Thanks for answering this @kirstenrichardson!

nndei, 2020-07-09:
Hello, I still have the issue although my init files have double _.

What I did to register my environment was ok, I think. Running the `pip3 install -e .` command told me that my env was added. However, if I `import gym` and `from gym import envs` and print them all, mine isn't present.

Now, I don't understand how to run the training because I'm quite new to it. However, I'd need to run the HER algorithm + DDPG on my environment and I'd do so by saying `python3 -m baselines.run --alg=her --env=dVRLReach-v0 --num_timesteps=5000`.

The baselines folder is in the same directory as the folder that contains the init files and .py files of my env. So in that directory I try to run that command from terminal but it exits with `gym.error.UnregisteredEnv: No registered env with id: Reach-v0`.

Maybe running the algorithm somehow after importing that environment folder would fix the issue? But how can I say import Reach and then python3... if I import inside python3 itself

kirstenrichardson, 2020-07-09:
When I use my custom environment with Stable Baselines the env ID has to be in the format 'gym_envname:envname-version' so perhaps 'gym_Reach:Reach-v0' in your case. That might not be the solution to your problem, there may be something else amiss there, but worth a try.

nndei, 2020-07-09:
Thank you for the advice, I will try it.

However, I am trying to make things work for a previous repository from which I took the gym setup and the folder isn't called like that. The creators of the repository aren't answering unfortunately.

nndei, 2020-07-10:
Hello,

I have tried that, but it doesn't work, still. Is there anyway I can find an implementation of HER + DDPG to train my environment that doesn't rely on the "python3 -m ..." command and run.py file?

I mean, stable-baselines has implementations of the single algorithms that are explained and you can write a script and manage your imports. I can't find a similar thing for the original baselines... Is it only done through that command?
I need to use baselines.

Best regards

bainro, 2020-09-17:
I just solved a similar issue, I'd forgotten to import my custom env module at the top of the script.

nndei, 2020-09-17:
> I just solved a similar issue, I'd forgotten to import my custom env module at the top of the script.

Yeah, that worked for me too! I forgot this post. Must import everything in every main file of the libraries

Closed 2020-03-06.

Thread 1851 (2020-03-26):

Mujoco environments: qvel is different to computed velocity in the step method

albertcthomas, 2020-03-26:
When looking at the code of the [`step`](https://github.com/openai/gym/blob/54f22cf4db2e43063093a1b15d968a57a32b6e90/gym/envs/mujoco/swimmer.py#L10) method of the `SwimmerEnv` I noticed that the velocity along the x axis used in the reward is computed from the positions:
```python
    def step(self, a):
        ctrl_cost_coeff = 0.0001
        xposbefore = self.sim.data.qpos[0]
        self.do_simulation(a, self.frame_skip)
        xposafter = self.sim.data.qpos[0]
        reward_fwd = (xposafter - xposbefore) / self.dt
```
However I would have expected the velocity to be taken directly from `self.sim.data.qvel[0]` but when looking at the values of `self.sim.data.qvel[0]` they are not equal to `reward_fwd`. Is there a good reason to compute the velocity from the positions and not use `self.sim.data.qvel[0]`?

There is a similar question on the [MuJoCo forum](http://www.mujoco.org/forum/index.php?threads/qpos-qvel-meaning-of-freejoint.3658/).

albertcthomas, 2020-03-30:
I investigated this a bit more and I think the difference can be explained by the fact that
1. According to the xml files, `SwimmerEnv` is using Runge-Kutta integration and not Euler integration as it it the case for `HalfCheetahEnv` for instance,
2. `frame_skip` is strictly larger than 1, so one step in gym is actually several steps in MuJoCo (this is the case for `SwimmerEnv` and `HalfCheetahEnv`)
That being said I am still not sure why the velocity part for the reward is computed from the positions and not from `qvel`.

TigerStone93, 2020-11-04:
`frame_skip` affects `dt`
dt = timestep * frame_skip

jkterry1, 2022-05-23:
PR #2762 is about to be merged, introducing V4 MuJoCo environments using new bindings and a dramatically newer version of the engine. If this issue still persists with the V4 ones, please create a new issue for it.

Closed 2022-05-23.

Thread 1874 (2020-04-11):

multiprocessing led to FetchPush-v1's 'ERROR: GLEW initalization error: Missing GL version'

Jiankai-Sun, 2020-04-11:
**Describe the bug**
`multiprocessing` led to mujoco-py's 'ERROR: GLEW initalization error: Missing GL version'. It can pass the first Async(), but failed at the 2nd Async().

**To Reproduce**
Run the following code with Python 3.6, mujoco-py 2.0, mujoco 200 can reproduce the bug. If you do not use Class Async(), no bug is reported.

```python
import traceback, os, sys, atexit, threading
import numpy as np
import skimage.transform

class AtariFetch(object):

  LOCK = threading.Lock()

  def __init__(
      self, name, size=(84, 84), params=None):
    import gym
    with self.LOCK:
      self._env = gym.make('{}-v1'.format(name))
      if hasattr(params, 'dense_reward') and params.dense_reward:
        self._env.env.reward_type = "dense"
    self._size = size
    self._random = np.random.RandomState(seed=None)

  @property
  def observation_space(self):
    shape = self._size + (3,)
    space = gym.spaces.Box(low=0, high=255, shape=shape, dtype=np.uint8)
    return gym.spaces.Dict({'image': space})

  @property
  def action_space(self):
    return self._env.action_space

  def close(self):
    return self._env.close()

  def reset(self):
    with self.LOCK:
      self._env.reset()
    return self._get_obs()

  def step(self, action):
    _, reward, done, info = self._env.step(action)
    obs = self._get_obs()
    return obs, reward, done, info

  def render(self, mode='rgb_array'):
    return self._env.render(mode)

  def _get_obs(self):
    image = skimage.transform.resize(
        self.render(mode='rgb_array'), output_shape=self._size, mode='edge', order=1,
        preserve_range=True)
    image = np.clip(image, 0, 255).astype(np.uint8)
    return {'image': image}

class Async(object):

  # Message types for communication via the pipe.
  _ACCESS = 1
  _CALL = 2
  _RESULT = 3
  _EXCEPTION = 4
  _CLOSE = 5

  def __init__(self, constructor, strategy='thread'):
    if strategy == 'thread':
      import multiprocessing.dummy as mp
    elif strategy == 'process':
      import multiprocessing as mp
    else:
      raise NotImplementedError(strategy)
    self._strategy = strategy
    self._conn, conn = mp.Pipe()
    self._process = mp.Process(target=self._worker, args=(constructor, conn))
    atexit.register(self.close)
    self._process.start()
    self._observ_space = None
    self._action_space = None

  @property
  def observation_space(self):
    if not self._observ_space:
      self._observ_space = self.__getattr__('observation_space')
    return self._observ_space

  @property
  def action_space(self):
    if not self._action_space:
      self._action_space = self.__getattr__('action_space')
    return self._action_space

  def __getattr__(self, name):
    self._conn.send((self._ACCESS, name))
    return self._receive()

  def call(self, name, *args, **kwargs):
    payload = name, args, kwargs
    self._conn.send((self._CALL, payload))
    return self._receive

  def close(self):
    try:
      self._conn.send((self._CLOSE, None))
      self._conn.close()
    except IOError:
      # The connection was already closed.
      pass
    self._process.join()

  def step(self, action, blocking=True):
    promise = self.call('step', action)
    if blocking:
      return promise()
    else:
      return promise

  def reset(self, blocking=True):
    print('reset:', os.environ)
    promise = self.call('reset')
    if blocking:
      ret = promise()
      print('reset:', os.environ)
      return ret
    else:
      return promise

  def _receive(self):
    try:
      message, payload = self._conn.recv()
    except (OSError, EOFError):
      raise RuntimeError('Lost connection to environment worker.')
    # Re-raise exceptions in the main process.
    if message == self._EXCEPTION:
      stacktrace = payload
      raise Exception(stacktrace)
    if message == self._RESULT:
      return payload
    raise KeyError('Received message of unexpected type {}'.format(message))

  def _worker(self, constructor, conn):
    try:
      env = constructor()
      while True:
        try:
          # Only block for short times to have keyboard exceptions be raised.
          if not conn.poll(0.1):
            continue
          message, payload = conn.recv()
        except (EOFError, KeyboardInterrupt):
          break
        if message == self._ACCESS:
          name = payload
          result = getattr(env, name)
          conn.send((self._RESULT, result))
          continue
        if message == self._CALL:
          name, args, kwargs = payload
          result = getattr(env, name)(*args, **kwargs)
          conn.send((self._RESULT, result))
          continue
        if message == self._CLOSE:
          assert payload is None
          break
        raise KeyError('Received message of unknown type {}'.format(message))
    except Exception:
      stacktrace = ''.join(traceback.format_exception(*sys.exc_info()))
      print('Error in environment process: {}'.format(stacktrace))
      try:
        conn.send((self._EXCEPTION, stacktrace))
      except Exception:
        print('Failed to send exception back to main process.')
    try:
      conn.close()
    except Exception:
      print('Failed to properly close connection.')

if __name__ == "__main__":
    print('1st Async')
    env = lambda: AtariFetch(name='FetchPush')
    env = Async(env, 'thread')
    # env = env()

    env.reset()
    env.render()
    env.step(0)
    print('2nd Async')
    env2 = lambda: AtariFetch(name='FetchPush')
    env2 = Async(env2, 'thread')
    # env2 = env2()

    env2.reset()
    env2.render()
    env2.step(0)
```

**Expected behavior**

No 'ERROR: GLEW initalization error: Missing GL version' reported.

**Error Messages**
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

**Desktop (please complete the following information):**
 - OS: Ubuntu 16.04
 - Python Version 3.6.10
 - Mujoco Version 2.0
 - mujoco-py version 2.0.2.9

**Environment**
 - output of: `/home/user/.mujoco/mujoco200/bin`
 - output of: `/home/user`
 - output of: `user`

**Additional context**
The output of `os.environ` is changed after the first launch of the environment. That is due to mujoco-py add 'DYLD_LIBRARY_PATH': '/home/user/.mujoco/mujoco200/bin:' to `os.environ`.

jkterry1, 2022-05-23:
PR #2762 is about to be merged, introducing V4 MuJoCo environments using new bindings and a dramatically newer version of the engine. If this issue still persists with the V4 ones, please create a new issue for it.

Closed 2022-05-23.

Thread 1881 (2020-04-14):

Sampling numbers that sum to a constant from spaces.box

ckrk, 2020-04-14:
Description:
##########
I am developing a custom environment for gym.
In my action space, I want to study strategic consequences when arbitrary dividing a fixed quantity Q into a (possibly fixed) number of parts. Hence, the action space is continuous and uses spaces.box.

I want to be able to draw several numbers a1, ..., aN and have the guarantee that they sum up to
Q =  a1 + .... +aN.

I believe since spaces.box allows only for independent sampling, this is currently not possible.

Example:
##########
Assume I want 3 samples from spaces.box that sum up to 5.
Assume I draw sample_1 from [0,5] and get 2.
Then sample_2 needs to be drawn from [0,5-sample_1]=[0,3], not from [0,5]!
Assume I draw sample_2=0.5
Finally sample_3 needs to be drawn from [0,5-sample_1-sample_2]=[0,2.5]

In contrast, box spaces has fixed limits.
If using it 3 times in limits [0,5], we could get the sequence (3,3,5). 3+3+5 would exceed the limit 5 though, since the 2nd and 3rd sample do not know about the earlier results and hence can not respect the limit of 5. I believe that all othe spaces have similar problems.

Possible Use-Cases:
##########
- Dividing profits or flows
- Action spaces restricted by a capacity (storage, transport, etc...)
- Probability normalization (i.e. pick weights p1+p2+p3=1)

Suggestions and Questions:
##########
- Is there any known best practice to include this?

- If not I would ask for the inclusion of such a sampling mechanism

- I think the use-cases above are pretty general and should not be restricted to my problem

- I would like to avoid post-processing since this is really a property of the action space.
I am not sure how this interact with learning algorithms and whether it would "secretly" change the underlying probabilities. In the spirit of gym, these environment properties should be resolved within the environment and not touch on the algorithmic side for inter-comparability.

-I have already asked a [stack exchange question](https://ai.stackexchange.com/questions/20003/how-to-formulate-normalization-probability-conditions-on-state-action-spaces-in), that was not unanswered but up-voted.
Therefore I believe, that my issue is not trivial.

instance01, 2020-04-25:
Is drawing integers a requirement?

ckrk, 2020-04-25:
@instance01 Thank you for your reply! Drawing integers is not required. I am working in a continuous setting, hence the drawn numbers can be arbitrary real numbers.

instance01, 2020-04-25:
How about the following:

```
>>> box = spaces.Box(0, 1, shape=(1,10))
>>> sample = box.sample()
>>> sample
array([[0.56555617, 0.5769829 , 0.07108209, 0.10859283, 0.47241163,
        0.56022567, 0.4106281 , 0.9875782 , 0.13131236, 0.40297922]],
      dtype=float32)
>>> Q = 5
>>> sample = sample * Q / sample.sum()
>>> sample
array([[0.6595639 , 0.67289007, 0.08289748, 0.12664333, 0.55093676,
        0.6533474 , 0.47888348, 1.1517352 , 0.15313934, 0.46996316]],
      dtype=float32)
>>> sample.sum()
5.0
>>> sample.sum() == Q
True
```

The main interesting line is this one: `sample = sample * Q / sample.sum()`

instance01, 2020-04-25:
Ah wait, I just saw that you want to avoid post-processing..

instance01, 2020-04-25:
Also, you are right. The distribution may change (i.e. become non-uniform) if you're not careful (like my answer above).
More about that: https://stackoverflow.com/questions/8064629/random-numbers-that-add-to-100-matlab/8068956#8068956

ckrk, 2020-04-26:
@instance01 Thank you for your input!  Surely, one could go for a similar solution as you propose, however it seems a bit like a work around. Your stackexchange perfectly shows what i am concerned about. Maybe the effect isnt even strong, but it is not easy for me to asess this apriori.

Closed 2021-09-25.

Thread 1887 (2020-04-17):

IndexError: index 8 is out of bounds for axis 0 with size 6

Space-Fighter, 2020-04-17:
Hello I am using gym 0.17.1 and I am using the pong environment. The error is occuring **at the step function -**
```py
new_state, reward, done, info = env.step(action)
````
I am getting my action from the following function -
```py
def choose_action(self, state):
		if np.random.random() < self.epsilon:
			action = env.action_space.sample()

		else: # we exploit
      		# print(type(state)) ##nd array which is mismatch
			state = tf.cast(state, dtype=tf.float32) ## cast the state to a tensor
			actions = self.model.advantage(state)
			action = np.argmax(actions, axis=1)
		return action
```
When I run this it gives me the error -
```py
IndexError: index 8 is out of bounds for axis 0 with size 6
```
In fact this is not only true for the pong environment but as well as **other environments** such as enduro and MsPacman. I **tried printing out ```env.action_space.n``` againt the very same error**.
According to the error it is **happening in the following files -**
```
Python\Python37\lib\site-packages\gym\wrappers\time_limit.py
```
and in
```
\Python\Python37\lib\site-packages\gym\envs\atari\atari_env.py
```

**and in ```atari-env.py``` at line 113**
```py
def step(self, a):
        reward = 0.0
        action = self._action_set[a] # Here is where the error is occuring.

        if isinstance(self.frameskip, int):
            num_steps = self.frameskip
        else:
            num_steps = self.np_random.randint(self.frameskip[0], self.frameskip[1])
        for _ in range(num_steps):
            reward += self.ale.act(action)
        ob = self._get_obs()

        return ob, reward, self.ale.game_over(), {"ale.lives": self.ale.lives()}
```

In fact I even **tried uninstalling and reinstalling gym and different versions of it**. The very same thing happened. What should I change to get rid of this error or which version of gym should I install.

christopherhesse, 2020-04-17:
Do you still get the error if you only return `env.action_space.sample()` inside of `choose_action`?

Space-Fighter, 2020-04-18:
@christopherhesse  Yeah

christopherhesse, 2020-04-24:
I ran this script and didn't get any errors:

```
import gym

def main():
    env = gym.make("PongNoFrameskip-v4")
    env.reset()
    for i in range(10000):
        print(i)
        obs, rew, done, info = env.step(env.action_space.sample())
        if done:
            env.reset()

if __name__ == "__main__":
    main()
```

Do you have a script that reproduces this issue?

Space-Fighter, 2020-04-25:
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

Space-Fighter, 2020-04-26:
@christopherhesse It seems to work without the dqn model but with it, it still gives me erors for some reason

Space-Fighter, 2020-04-27:
@christopherhesse I am taking time in it. Trying to debug. There are tons of errors and all.

christopherhesse, 2020-05-01:
Well you should reset the environment when it is done, it's an error to not do that.

It sounds like your dqn model is outputting invalid actions, you should check the dimensions of your tensors to make sure they match up with the action space of the environment.

Closed 2020-05-01.

Thread 1911 (2020-05-11):

The observation of fetchreah_env

13350068164, 2020-05-11:
1. For example ,the obs in fetchreah_env. Why the observation include the grriper_velp ,gripper_vel,gripper_state  instead of the angle of each joint?
2. And in fetchreah_env,i don't konw the gripper_vel and gripper_state really mean,because the gripper doesn't need to open or close.

Thank you for your help.

13350068164, 2020-05-12:
And I try change obs in fetchreach_env.
Like this :obs = grip_pos.
Just the xyz of the grip,and use HER to train a model ,the success rate after 10 epochs is 1.
Could anybody help me and tell me why.

spitis, 2020-05-22:
Your first post: (1) Why not? That's just how it's defined. (2) They are extraneous.
Your second post: FetchReach is easy. You don't need velocity info to solve it.

Amritpal-001, 2020-07-07:
@13350068164  gripper needs to open or close, depending on the environment you use.  For Fetch reacher, slider, pusher - the gripper is blocked. But in PickAndPlace - the gripper is needed.
If you look into source code you can find valuable info there. Or you can check out my article on Fetch environments by OpenAI [https://link.medium.com/CV6la7YfV7](url) , I hope it's helpfull.

jkterry1, 2022-05-23:
PR #2762 is about to be merged, introducing V4 MuJoCo environments using new bindings and a dramatically newer version of the engine. If this issue still persists with the V4 ones, please create a new issue for it.

Closed 2022-05-23.

Thread 1925 (2020-05-21):

Cannot record the video by Wrappers.Monitor

JingruiYu, 2020-05-21:
I am trying to record the performance by the wrappers.Monitor. However, only .json files were generated, not any video files. No error was reported. How can I get the video file?

**system**
ubuntu 16, version 0.17.2,

**code**
`env = gym.make('CartPole-v0')
    env = gym.wrappers.Monitor(env, "recording",force=True)`

Thank you very much!

christopherhesse, 2020-05-22:
I ran the following script and it worked fine, are you actually stepping the environment?

```
import gym
env = gym.make('CartPole-v0')
env = gym.wrappers.Monitor(env, "recording",force=True)
env.reset()
while True:
    obs, rew, done, info = env.step(env.action_space.sample())
    if done:
        break
```

JianmingTONG, 2020-12-31:
Hi, I do get the video under "recording" directory. However, this video cannot be played successfully. Is there any solution to it?
I am using:
Ubuntu 18.04
gym 0.18.0

https://user-images.githubusercontent.com/30002985/103414749-3c252680-4bba-11eb-8ee1-c2cbded08d28.mp4

cxk1998, 2021-01-02:
I have the same problem. I get a video but it's only 1kb.

pavlexander, 2021-01-02:
same issue... been trying to investigate it with no success...

First enable logging:
```python
gym.logger.set_level(gym.logger.DEBUG)
```

Logs:

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

So 20 timesteps were supposed to be written. In the destination folder we have a bunch of files. The video file is only 1kb and is unplayable.

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

The code used:

```python
env = gym.make('CartPole-v0')
env = gym.wrappers.Monitor(env, "./vid", force=True)
env.seed(0)
for i_episode in range(1):
    observation = env.reset()
    for t in range(100):
        env.render()
        print(observation)
        action = env.action_space.sample()  # take a random action
        observation, reward, done, info = env.step(action)
        if done:
            print("Episode finished after {} timesteps".format(t+1))
            break
env.close()
```

I have been able to successfully use the `ffmpeg` python wrapper.. so this must not be an issue. The ffmpeg is in PATH and is locatable by the python virtual environment..

```python
try:
    probe = ffmpeg.probe(input_video)
    video_stream = next((stream for stream in probe['streams'] if stream['codec_type'] == 'video'), None)
    width = int(video_stream['width'])
    height = int(video_stream['height'])

    print(width)
    print(height)
except ffmpeg.Error as e:
    if e.stdout:
        print(e.stdout.decode('utf8'))
    if e.stderr:
        print(e.stderr.decode('utf8'))

exit(0)
```

works OK. So the issue must be somewhere in gym wrapper or the arguments it is using to encode the video..

- win 10
- Python 3.8.6 (tags/v3.8.6:db45529, Sep 23 2020, 15:52:53) [MSC v.1927 64 bit (AMD64)] on win32
- ffmpeg-4.3.1-2021-01-01-full_build
- gym 0.18.0

pavlexander, 2021-01-02:
Actually neverminded.. I found the issue. It's a bug in the code.

To fix the issue temporary (until devs fix it in public repo) you have to edit the `video_recorder.py` and remove some tabs:

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

The condition to write frames to the video file is never executed in the current gym library version.

i-am-neet, 2021-01-19:
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

Hi, I tried to remove one indent by following your suggestion, as figure as below.
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

The size of video file seems normally.
But I still can not play the video with vlc player :((

Any suggestion?

i-am-neet, 2021-01-26:
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

I notice that remove indent in function `capture_frame` is right track.
But need to use `video_recorder` directly instead of `Monitor`

```python
import gym
from gym.wrappers.monitoring import video_recorder
env = gym.make('CartPole-v0')
vid = video_recorder.VideoRecorder(env,path="./recording/vid.mp4")
for i_episode in range(20):
    observation = env.reset()
    for t in range(100):
        env.render()
        vid.capture_frame()
        print(observation)
        action = env.action_space.sample()
        observation, reward, done, info = env.step(action)
        if done:
            print("Episode finished after {} timesteps".format(t+1))
            break
env.close()
```

Any suggestion is welcome :)

mwilbz, 2021-03-14:
FWIW downgrading to `gym==0.17.3` was a workaround for me. Thanks @pavlexander !

vakker, 2021-03-17:
This was fixed and merged into the master branch in #2139

rcshubhadeep, 2021-04-01:
Is the latest fix available in pip? I tried with 0.18 and I could not make it work so I downgraded to 0.17.3 as mentioned in @mwilbz comment and it worked.

aterenin, 2021-04-02:
Confirmed same issue on latest version in pip. Manually removing the indent fixes the issue.

aterenin, 2021-04-02:
If anyone else is using VideoRecorder as part of a larger logging framework, the following code patches `capture_frame` at runtime.

```python
frame = env.render("rgb_array")
self.video_recorder.encoder = gym.wrappers.monitoring.video_recorder.ImageEncoder(self.video_recorder.path, frame.shape, self.video_recorder.frames_per_sec, self.video_recorder.output_frames_per_sec)
def capture_frame(self, frame):
    if not isinstance(frame, (np.ndarray, np.generic)):
        raise gym.error.InvalidFrame('Wrong type {} for {} (must be np.ndarray or np.generic)'.format(type(frame), frame))
    if frame.shape != self.frame_shape:
        raise gym.error.InvalidFrame("Your frame has shape {}, but the VideoRecorder is configured for shape {}.".format(frame.shape, self.frame_shape))
    if frame.dtype != np.uint8:
        raise gym.error.InvalidFrame("Your frame has data type {}, but we require uint8 (i.e. RGB values from 0-255).".format(frame.dtype))
    self.proc.stdin.write(frame.tobytes())
self.video_recorder.encoder.capture_frame = types.MethodType(capture_frame, self.video_recorder.encoder)
```

Looks like this is already fixed in an above-linked PR, so hopefully won't be long before this dirty hack is removed.

UntotaufUrlaub, 2021-05-10:
Is the fix allready available by pip?
(editing the file manually worked for me)

shapeng1998, 2021-05-12:
> Is the fix allready available by pip?
> (editing the file manually worked for me)

I have the same problem, the source code works, but the package on pypi seems have not updated yet.
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

bhatiaabhinav, 2021-05-28:
I just install gym 0.18.3 via pip. The issue is resolved.

jkterry1, 2021-08-06:
Fix is in master

binakn, 2023-06-21:
>

I just had a similar issue today: for me .json files were generated, but videos were not created / saved.
In my case this was caused by the metadata of the environment, because `render.modes` was empty after initialization. This turned of the video recorder upon initialization of the `VideoRecorder` object and hence didn't capture any video.

Setting them manually, such that it would include `rgb_array` fixed my issue.

Closed 2021-08-06.

Thread 1929 (2020-05-23):

Integer overflows in unbounded integer Box spaces

iamlucaswolf, 2020-05-23:
Hi,

I believe I noticed some peculiar bugs in `gym.spaces.Box` around the representation of integer box spaces with unbounded upper ends (e.g. [0, inf)).

First of all, instantiating a Box space with an upper bound of `np.inf` will immediately result in an integer overflow:

```python
>>> space = Box(low=0, high=np.inf, shape=(1,), dtype=np.int)
>>> space.high
array([-9223372036854775808])
```

This is due to line 45f in `gym/spaces/box.py`, which broadcasts the upper bound to all dimensions in the constructed space if the input argument `high` is scalar. The implementation uses `np.full`, which will cause the overflow.

```python
>>> np.full((1,), np.inf, dtype=np.int)
array([-9223372036854775808])
```

While it's certainly debatable whether these are the intended semantics of float to int conversion (after all, `type(np.inf) == float`), there exists an easy workaround for this issue...

```python
>>> space = Box(low=0, high=np.iinfo(np.int).max, shape=(1,), dtype=np.int)
>>> space.high
array([9223372036854775807])
```

... which will however result in more problems down the line. If we now try to sample from this space, we get:

```python
>>> space = Box(low=0, high=np.iinfo(np.int).max, shape=(1,), dtype=np.int)
>>> space.sample()
array([-8746956029393751040])
```

In this case, the overflow happens in line 95 (in `Box.sample()`), which sets `high = self.high.astype('int64') + 1`; `high` is then used as an (exclusive) upper bound for uniform sampling in 117f.

**TL;DR**

Currently, it seems that integer Box spaces with unbounded upper endpoints can not be represented in `gym`. Trying to do so will result in integer overflows which happen silently along the way.

While I agree that this is a somewhat pathological case, I'd argue that it does have practical implications. I stumbled over it while implementing an `env` class for chess with the board encoding used by AlphaZero.

I'd be happy to provide a PR for this.

christopherhesse, 2020-06-05:
Thanks for the bug report!   I don't see the use case for unbounded upper endpoints for integers, which have bounded upper end points.  I agree that the high + 1 stuff is an issue, but I think it might work with a special case for int64/uint64, since all smaller integers would fit in those.

What sort of PR are you envisioning there?

iamlucaswolf, 2020-06-05:
Thanks for your reply!

**Integers being bounded**: I see your point, but aren't these two pair of shoes? Integers are implicitly bounded due to the number of bits representing them – but so are floats; IEEE754 specifying reserved values to represent +/- infinity is just a design decision. From a standpoint of pure semantics, I see no reason why $\mathbb{N}$ should be less unbounded than $\mathbb{R}$.

**Use cases**: I would argue it makes sense to have the ability to model integer counters (such as timers, game scores, etc). These need not assume crazy high values necessarily, but sometimes an upper bound might just not be apparent or easy to determine from the application context alone. As mentioned above, I recently encountered such a case when writing [a gym env for chess](https://github.com/iamlucaswolf/gym-chess/blob/master/gym_chess/alphazero/board_encoding.py) that implements the AlphaZero board encoding.

**PR**: Depends on what semantics you consider best. If integers are bounded, adding some special cases should do the trick, as you already mentioned. However, if integers are unbounded, sampling from a uniform U(k, max int) makes little sense, as U(k, infinity) is undefined. Perhaps in that case sampling from a shifted geometric would be more appropriate, since we sample from a shifted exponential in the continuous case?

christopherhesse, 2020-06-26:
So if I understand what you're saying correctly, you want:

* sampling from integer box spaces where high=maxint(int64) doesn't work.  I think this is related to https://github.com/openai/gym/issues/1256, where this previously didn't work for `uint8`.  If I had to guess the issue could be related to `sample()` using `random.uniform()` instead of `random.randint()`.  In order to specify a high value of 2**64, it looks like you actually have to use a `dtype` of `object` to use python long ints, since a uint64 will max out at 2**64-1.

* a high value of `np.inf` should be supported for integer spaces.  I would prefer if high/low arrays have the same dtype as the space to avoid confusion, so I don't think `np.inf` makes sense there, unless it's immediately converted to the max of the int type, and even then I think users could use `np.iinfo(np.int).max` as you have shown.

Is that correct?

RedTachyon, 2021-12-09:
So it's been a while since this was brought up, and while the priority on this isn't necessarily very high, I think it'd make sense to change the bounds on int boxes.

It might be tricky to have a proper integer infinity. It might be an arbitrary design from IEEE754, but that's what we're working with. The least bad option imo would be just casting `np.inf` to the maximum/minimum values of the relevant datatype. (maybe one less than maximum and one more than minimum, to avoid the sampling problem)

But again, this is imo relatively low priority, because using `np.inf` to set bounds on an integer space is basically asking for trouble - even if it makes some intuitive sense.

Closed 2021-12-30.

Thread 1941 (2020-06-04):

Windows - OpenGL Exception - glClearColor

XavierGeerinck, 2020-06-04:
When trying to step through my classic_control environment, I randomly get the following stack trace:

```
(<class 'pyglet.gl.lib.GLException'>, GLException(b'invalid operation'), <traceback object at 0x17AF3F28>)
  File "E:\Projects\roadwork-rl\src\Servers\OpenAI\OpenAIEnv.py", line 81, in reset
    obs = env.reset()
  File "C:\Users\thebi\AppData\Local\Programs\Python\Python38-32\lib\site-packages\gym\wrappers\monitor.py", line 39, in reset
    self._after_reset(observation)
  File "C:\Users\thebi\AppData\Local\Programs\Python\Python38-32\lib\site-packages\gym\wrappers\monitor.py", line 185, in _after_reset
    self.reset_video_recorder()
  File "C:\Users\thebi\AppData\Local\Programs\Python\Python38-32\lib\site-packages\gym\wrappers\monitor.py", line 206, in reset_video_recorder
    self.video_recorder.capture_frame()
  File "C:\Users\thebi\AppData\Local\Programs\Python\Python38-32\lib\site-packages\gym\wrappers\monitoring\video_recorder.py", line 101, in capture_frame
    frame = self.env.render(mode=render_mode)
  File "C:\Users\thebi\AppData\Local\Programs\Python\Python38-32\lib\site-packages\gym\core.py", line 233, in render
    return self.env.render(mode, **kwargs)
  File "C:\Users\thebi\AppData\Local\Programs\Python\Python38-32\lib\site-packages\gym\envs\classic_control\cartpole.py", line 213, in render
    return self.viewer.render(return_rgb_array=mode == 'rgb_array')
  File "C:\Users\thebi\AppData\Local\Programs\Python\Python38-32\lib\site-packages\gym\envs\classic_control\rendering.py", line 104, in render
    glClearColor(1,1,1,1)
  File "C:\Users\thebi\AppData\Local\Programs\Python\Python38-32\lib\site-packages\pyglet\gl\lib.py", line 107, in errcheck
    raise GLException(msg)
```

Does anyone have experience with this? It seems that `glClearColor` cannot be executed (even though it is running just fine and randomly hits that issue)

christopherhesse, 2020-06-05:
I don't really know why this would cause an invalid operation.  Presumably it works fine without rendering right?

thebillkidy, 2020-06-06:
It indeed does :) it also works in WSL perfectly but not on Windows... it's quite strange actually

christopherhesse, 2020-06-12:
Do you have an example script that produces the error?  Is it likely to produce the same error if I run it on my windows machine?

XavierGeerinck, 2020-06-16:
Apologies for the late response. This happens for me when just running a very basic code (I added this below), but it happens randomly as well. As in, when I train for around 1000 timesteps, it just kills. I'm suspecting a driver issue, but I have updated them to the latest version and it is still happening. (I have a NVIDIA 1070 card)

```python
import gym

env = gym.make("CartPole-v1")
env.reset()

action = env.action_space_sample()
env.step(action)

for i in range(10000):
    action, _states = model.predict(obs)
    obs, rewards, dones, info = env_local.step(action)
    env_local.render()
```

XavierGeerinck, 2020-06-17:
Update: replicated it exactly with  this code even:

```python
import gym
env = gym.make('CartPole-v1')
env.reset()
for _ in range(1000):
    env.render()
    env.step(env.action_space.sample()) # take a random action
env.close()
```

Resulting in: `GLException(b\'invalid operation\')`

christopherhesse, 2020-06-19:
I made a new python 3.8 conda environment, installed gym, and ran that script on a windows machine and it worked fine.  I suspect something is broken with your particular windows machine :/

XavierGeerinck, 2020-06-21:
:/ thanks for trying! it's a fresh installation though of windows so it's a bit strange... anyways, I'll close this issue seeing that it's too hard to reproduce at the moment (I think it might be due to hardware / driver combination). Will re-open once I have enough information to reproduce it consistently, but until then I'll keep using WSL 2 where it does seem to work.

Closed 2020-06-21.

Thread 2099 (2020-11-18):

CarRacing-v0 - Weird Camera Jerk Issue

praveenVnktsh, 2020-11-18:
I noticed something weird when training my model on carracing-v0. Whenever a jerky braking situation is given, the camera flips vertically occasionally. Here is a picture of the same:

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

The left window shows the flipped image, and the one on the right is the frame previous to the current frame. The frame after the flipped frame is back to normal.

I noticed that there are a few odd lines in the environment's source file:

https://github.com/openai/gym/blob/c4d0af393ef9fba641bd3ebbbf1f60d291c8475d/gym/envs/box2d/car_racing.py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

After some prodding, I noticed that occasionally the velocity of the car becomes negative as a result of which the atan function returns a negative number. The issue seems to be solved by commenting out those lines.

I do not understand the advantage of making the camera move with higher velocities since this can sometimes allow an agent to learn a lot more long range information by just having rapid movements. I observed this in some of my runs!

@olegklimov - Would be great if you could comment on this.

carlosluis, 2021-12-12:
I conducted a little experiment that confirms the sign switching problem reported by @praveenVnktsh

Using this code
```python
        if np.linalg.norm(vel) > 0.5:
            old_angle = ((angle + np.pi) % (2 * np.pi)) - np.pi  # normalize angle
            angle = math.atan2(vel[0], vel[1])
            if np.sign(old_angle) != np.sign(angle):
                print(f"old_angle = {old_angle}, new_angle = {angle}")
```
I then proceeded to steer the car recklessly until I see some angle flipping. Of course, near 0, pi and -pi, I see some angle flipping inherent from numerical approximations, but there's other instances where there's clearly a "wrong" angle flip

```
old_angle = 1.0416961908340454, new_angle = -1.2111190759830692
old_angle = 1.0416961908340454, new_angle = -1.2111190759830692
old_angle = 1.2610578536987305, new_angle = -1.1509918860429935
old_angle = 1.2610578536987305, new_angle = -1.1509918860429935
old_angle = 1.4788283109664917, new_angle = -1.1005596690570452
old_angle = 1.4788283109664917, new_angle = -1.1005596690570452
old_angle = 1.694751262664795, new_angle = -1.0476754974926226
old_angle = 1.694751262664795, new_angle = -1.0476754974926226
old_angle = 1.9067429304122925, new_angle = -0.9976619854163612
old_angle = 1.9067429304122925, new_angle = -0.9976619854163612
old_angle = 2.112739086151123, new_angle = -0.9519961141207258
```

The bug can also be visualized in the following gif:

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

If we comment out the lines suggested by @praveenVnktsh I cannot reproduce the visual jerk effect. In the following gif the angle seems consistent with the movement at all times

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

After playing around with this for a few minutes and without further context on why these lines were there in the first place, my recommendation would be to remove them. In a visual learning context, the current state of the environment is plain wrong and should be fixed

jkterry1, 2021-12-12:
@carlosluis

A few questions:
- The observation space _is_ visual, right?
- What fixes to it should be made beyond the camera jerking?
- This will require a version bump of the environment, right?

carlosluis, 2021-12-12:
1) Yes, the observation space is visual https://github.com/openai/gym/blob/180d8ddd5cce0d23cdc4cada1faa52f3ae45313c/gym/envs/box2d/car_racing.py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
When I said "In a visual learning context, the current state of the environment is plain wrong" I was just pointing out that the image flip is a bug and shouldn't happen. I wasn't talking about the RL state, but the way the environment renders the next image/observation.

2) Related to this specific problem, that would be the only fix AFAIK. The state of the environment is updated via the `render()` function, so fixing the wrong camera angle in `render()` automatically fixes the observation returned when doing `env.step`. This is the only opened issue related to `CarRacing`, so not sure there's anything else to fix right now unless there's some context I'm missing.

3) I didn't thought about that, but yes, I guess the change warrants bumping the version.

jkterry1, 2021-12-13:
Okay, so all that sounds good. Since we have to bump the version of car racing anyways, could you please redo the rendering in pygame as well in that PR? Right now other people are working on doing this for the classic control and the other 2 box2d environments, but I hadn't asked anyone to because I was expecting we were going to remove it. The motivation for pygame is that pyglet creates a bunch of huge headaches for installation and for headless rendering (which is very important on servers). The advantage of doing this all at once is that this update would require a version bump for car racing since the observation space is graphical, so I'm trying to do everything all at once.

Closed 2021-12-30.

Thread 2156 (2021-01-12):

Pendulum-v0 Equations

Psarhadi, 2021-01-12:
Three questions in the implementation of the dynamics for the Pendulum model (can be, issues):

1- Why:  sin(th + np.pi) in line 55:

newthdot = thdot + (-3 * g / (2 * l) * np.sin(th + np.pi) + 3. / (m * l ** 2) * u) * dt

While in the dynamics equation of Pendulum-v0, it is: sin(th);

2- why adding 3/2? It seems the equation should be (or maybe it is not a simple Pendulum):

newthdot = thdot + (-g / l * np.sin(th) + 1/ (m * l ) * u) * dt

3- Shouldn't line 54 and 55 be replaced?

53: newthdot = thdot + (-3 * g / (2 * l) * np.sin(th + np.pi) + 3. / (m * l ** 2) * u) * dt
54: newth = th + newthdot * dt
55: newthdot = np.clip(newthdot, -self.max_speed, self.max_speed)

It seems newthdot should be clipped before using in newth! Otherwise, the clip has not been applied to be integrated in the theta equation! Unless the aim is just to consider it in the reward not in the equations for theta!

RedTachyon, 2021-09-25:
@Psarhadi
Time to put that physics degree to use.

Ad 1 - in the dynamics it's actually -sin(π + θ) which happens to be equal to sin(π) (the minus is hidden with the 3). Theta in this environment is measured clockwise from the positive Y axis, so the angle between the radius vector and the gravitational force vector is exactly π - θ, and sin(π - θ) = sin(π).

After some more thoughts: in fact this could be made a bit clearer, since we have -sin(π + θ) = sin(π - θ) = sin(π). So in essence, changing the `-3` to `3` and `np.sin(th + np.pi)` to `np.sin(th)` won't change the dynamics, but would simplify the math a tiny bit (and I guess you'd save like two flops per step).

Ad 2 - the pendulum isn't a point mass but a rod with uniformly distributed mass, which gives a moment of inertia of \frac{m l^3}{3}, with the torque it adds up to what's implemented.

Ad 3 - I guess this depends on the intention of the original author. I agree it would make a tiny bit more sense to have the clipping performed before the integration, but in the end it's just a mechanism to stabilize the learning. I'm pretty sure the difference in practice is negligible, so it's probably not worth bumping the version for it imo.

@jkterry1 tl;dr there are two potential changes
1 - a small (like removing 9 characters total) rewrite of the math to make it simpler without changing the actual results
3 - clipping the acceleration before applying it to the system, which would have a small (but non-zero) effect on the dynamics

I slightly lean towards implementing 1 because it simplifies the code and doesn't change the dynamics. It's not a big deal either way.

I lean moderately against implementing 2, because it would require bumping the version of the environment, and it's mostly about a design choice. The current version isn't wrong, it might just be slightly unintuitive w.r.t. the details of numerical integration of the system.

jkterry1, 2021-09-25:
Let's do the simplification one given how heavily scrutinized this code often is.

Regarding the clipping, I'm comfortable with a version bump if it would make the behavior of the environment more expected. These environments are heavily used and reviewed and will continue to be for a long time.

jkterry1, 2021-09-25:
Closing in favor of PR

Psarhadi, 2021-09-27:
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

Happy to get feedback after several months! except no:2 other changes were essential. Especially the integrator clipper was an error (with great respect). It seems to be fixed now. Thanks.

Closed 2021-09-25.

Thread 2157 (2021-01-13):

car_racing.py improvement

philipp-seidel1, 2021-01-13:
Hi all,

I had problems running car_racing.py on an old laptop with Windows 7. RAM would accumulate to the point that the rendering of the track and grass would disappear. I figured a way of improving the implementation so it is more efficient. It avoids regenerating the pyglet vertex list of track and grass at every step, by making the vertex list an attribute of the CarRacing class. In fact, now it is just generated once, but still drawn at every step. The visual update of a track tile having been passed occurs by a method that just updates the color of the given tile in the vertex list. Works equivalent to the old code, but much faster and without bumps on my old laptop.

`"""
Easiest continuous control task to learn from pixels, a top-down racing
environment.
Discrete control is reasonable in this environment as well, on/off
discretization is fine.

State consists of STATE_W x STATE_H pixels.

The reward is -0.1 every frame and +1000/N for every track tile visited, where
N is the total number of tiles visited in the track. For example, if you have
finished in 732 frames, your reward is 1000 - 0.1*732 = 926.8 points.

The game is solved when the agent consistently gets 900+ points. The generated
track is random every episode.

The episode finishes when all the tiles are visited. The car also can go
outside of the PLAYFIELD -  that is far off the track, then it will get -100
and die.

Some indicators are shown at the bottom of the window along with the state RGB
buffer. From left to right: the true speed, four ABS sensors, the steering
wheel position and gyroscope.

To play yourself (it's rather fast for humans), type:

python gym/envs/box2d/car_racing.py

Remember it's a powerful rear-wheel drive car -  don't press the accelerator
and turn at the same time.

Created by Oleg Klimov. Licensed on the same terms as the rest of OpenAI Gym.
"""
import sys
import math
import numpy as np

import Box2D
from Box2D.b2 import fixtureDef
from Box2D.b2 import polygonShape
from Box2D.b2 import contactListener

import gym
from gym import spaces
from gym.envs.box2d.car_dynamics import Car
from gym.utils import seeding, EzPickle

import pyglet

pyglet.options["debug_gl"] = False
from pyglet import gl

STATE_W = 96  # less than Atari 160x192
STATE_H = 96
VIDEO_W = 600
VIDEO_H = 400
WINDOW_W = 1000
WINDOW_H = 800

SCALE = 6.0  # Track scale
TRACK_RAD = 900 / SCALE  # Track is heavily morphed circle with this radius
PLAYFIELD = 2000 / SCALE  # Game over boundary
FPS = 50  # Frames per second
ZOOM = 2.7  # Camera zoom
ZOOM_FOLLOW = True  # Set to False for fixed view (don't use zoom)

TRACK_DETAIL_STEP = 21 / SCALE
TRACK_TURN_RATE = 0.31
TRACK_WIDTH = 40 / SCALE
BORDER = 8 / SCALE
BORDER_MIN_COUNT = 4

ROAD_COLOR = [0.4, 0.4, 0.4]

class FrictionDetector(contactListener):
    def __init__(self, env):
        contactListener.__init__(self)
        self.env = env

    def BeginContact(self, contact):
        self._contact(contact, True)

    def EndContact(self, contact):
        self._contact(contact, False)

    def _contact(self, contact, begin):
        tile = None
        obj = None
        u1 = contact.fixtureA.body.userData
        u2 = contact.fixtureB.body.userData
        if u1 and "road_friction" in u1.__dict__:
            tile = u1
            obj = u2
        if u2 and "road_friction" in u2.__dict__:
            tile = u2
            obj = u1
        if not tile:
            return

        self.env.updateTileColor(tile)

        if not obj or "tiles" not in obj.__dict__:
            return
        if begin:
            obj.tiles.add(tile)
            if not tile.road_visited:
                tile.road_visited = True
                self.env.reward += 1000.0 / len(self.env.track)
                self.env.tile_visited_count += 1
        else:
            obj.tiles.remove(tile)

class CarRacing(gym.Env, EzPickle):
    metadata = {
        "render.modes": ["human", "rgb_array", "state_pixels"],
        "video.frames_per_second": FPS,
    }

    def __init__(self, verbose=1):
        EzPickle.__init__(self)
        self.seed()
        self.contactListener_keepref = FrictionDetector(self)
        self.world = Box2D.b2World((0, 0), contactListener=self.contactListener_keepref)
        self.viewer = None
        self.invisible_state_window = None
        self.invisible_video_window = None
        self.road = None
        self.car = None

        ### modified
        self.vl = None

        self.reward = 0.0
        self.prev_reward = 0.0
        self.verbose = verbose
        self.fd_tile = fixtureDef(
            shape=polygonShape(vertices=[(0, 0), (1, 0), (1, -1), (0, -1)])
        )

        self.action_space = spaces.Box(
            np.array([-1, 0, 0]), np.array([+1, +1, +1]), dtype=np.float32
        )  # steer, gas, brake

        self.observation_space = spaces.Box(
            low=0, high=255, shape=(STATE_H, STATE_W, 3), dtype=np.uint8
        )

    def seed(self, seed=None):
        self.np_random, seed = seeding.np_random(seed)
        return [seed]

    def _destroy(self):
        if not self.road:
            return
        for t in self.road:
            self.world.DestroyBody(t)
        self.road = []
        self.car.destroy()
        self.vl = None

    def _create_track(self):
        CHECKPOINTS = 12

        # Create checkpoints
        checkpoints = []
        for c in range(CHECKPOINTS):
            noise = self.np_random.uniform(0, 2 * math.pi * 1 / CHECKPOINTS)
            alpha = 2 * math.pi * c / CHECKPOINTS + noise
            rad = self.np_random.uniform(TRACK_RAD / 3, TRACK_RAD)

            if c == 0:
                alpha = 0
                rad = 1.5 * TRACK_RAD
            if c == CHECKPOINTS - 1:
                alpha = 2 * math.pi * c / CHECKPOINTS
                self.start_alpha = 2 * math.pi * (-0.5) / CHECKPOINTS
                rad = 1.5 * TRACK_RAD

            checkpoints.append((alpha, rad * math.cos(alpha), rad * math.sin(alpha)))

        self.road = []

        # Go from one checkpoint to another to create track
        x, y, beta = 1.5 * TRACK_RAD, 0, 0
        dest_i = 0
        laps = 0
        track = []
        no_freeze = 2500
        visited_other_side = False
        while True:
            alpha = math.atan2(y, x)
            if visited_other_side and alpha > 0:
                laps += 1
                visited_other_side = False
            if alpha < 0:
                visited_other_side = True
                alpha += 2 * math.pi

            while True:  # Find destination from checkpoints
                failed = True
                while True:
                    dest_alpha, dest_x, dest_y = checkpoints[dest_i % len(checkpoints)]
                    if alpha <= dest_alpha:
                        failed = False
                        break
                    dest_i += 1
                    if dest_i % len(checkpoints) == 0:
                        break

                if not failed:
                    break

                alpha -= 2 * math.pi
                continue

            r1x = math.cos(beta)
            r1y = math.sin(beta)
            p1x = -r1y
            p1y = r1x
            dest_dx = dest_x - x  # vector towards destination
            dest_dy = dest_y - y
            # destination vector projected on rad:
            proj = r1x * dest_dx + r1y * dest_dy
            while beta - alpha > 1.5 * math.pi:
                beta -= 2 * math.pi
            while beta - alpha < -1.5 * math.pi:
                beta += 2 * math.pi
            prev_beta = beta
            proj *= SCALE
            if proj > 0.3:
                beta -= min(TRACK_TURN_RATE, abs(0.003 * proj))
            if proj < -0.3:
                beta += min(TRACK_TURN_RATE, abs(0.001 * proj))
            x += p1x * TRACK_DETAIL_STEP
            y += p1y * TRACK_DETAIL_STEP
            track.append((alpha, prev_beta * 0.5 + beta * 0.5, x, y))
            if laps > 4:
                break
            no_freeze -= 1
            if no_freeze == 0:
                break

        # Find closed loop range i1..i2, first loop should be ignored, second is OK
        i1, i2 = -1, -1
        i = len(track)
        while True:
            i -= 1
            if i == 0:
                return False  # Failed
            pass_through_start = (
                track[i][0] > self.start_alpha and track[i - 1][0] <= self.start_alpha
            )
            if pass_through_start and i2 == -1:
                i2 = i
            elif pass_through_start and i1 == -1:
                i1 = i
                break
        if self.verbose == 1:
            print("Track generation: %i..%i -> %i-tiles track" % (i1, i2, i2 - i1))
        assert i1 != -1
        assert i2 != -1

        track = track[i1 : i2 - 1]

        first_beta = track[0][1]
        first_perp_x = math.cos(first_beta)
        first_perp_y = math.sin(first_beta)
        # Length of perpendicular jump to put together head and tail
        well_glued_together = np.sqrt(
            np.square(first_perp_x * (track[0][2] - track[-1][2]))
            + np.square(first_perp_y * (track[0][3] - track[-1][3]))
        )
        if well_glued_together > TRACK_DETAIL_STEP:
            return False

        # Red-white border on hard turns
        border = [False] * len(track)
        for i in range(len(track)):
            good = True
            oneside = 0
            for neg in range(BORDER_MIN_COUNT):
                beta1 = track[i - neg - 0][1]
                beta2 = track[i - neg - 1][1]
                good &= abs(beta1 - beta2) > TRACK_TURN_RATE * 0.2
                oneside += np.sign(beta1 - beta2)
            good &= abs(oneside) == BORDER_MIN_COUNT
            border[i] = good
        for i in range(len(track)):
            for neg in range(BORDER_MIN_COUNT):
                border[i - neg] |= border[i]

        # Create tiles
        for i in range(len(track)):
            alpha1, beta1, x1, y1 = track[i]
            alpha2, beta2, x2, y2 = track[i - 1]
            road1_l = (
                x1 - TRACK_WIDTH * math.cos(beta1),
                y1 - TRACK_WIDTH * math.sin(beta1),
            )
            road1_r = (
                x1 + TRACK_WIDTH * math.cos(beta1),
                y1 + TRACK_WIDTH * math.sin(beta1),
            )
            road2_l = (
                x2 - TRACK_WIDTH * math.cos(beta2),
                y2 - TRACK_WIDTH * math.sin(beta2),
            )
            road2_r = (
                x2 + TRACK_WIDTH * math.cos(beta2),
                y2 + TRACK_WIDTH * math.sin(beta2),
            )
            vertices = [road1_l, road1_r, road2_r, road2_l]
            self.fd_tile.shape.vertices = vertices
            t = self.world.CreateStaticBody(fixtures=self.fd_tile)

            ###
            t.vertices = vertices
            ###

            t.userData = t
            c = 0.01 * (i % 3)
            t.color = [ROAD_COLOR[0] + c, ROAD_COLOR[1] + c, ROAD_COLOR[2] + c]
            t.road_visited = False
            t.road_friction = 1.0
            t.fixtures[0].sensor = True
            self.road_poly.append(([road1_l, road1_r, road2_r, road2_l], t.color))
            self.road.append(t)

        # Create curbs
        for i in range(len(track)):
            alpha1, beta1, x1, y1 = track[i]
            alpha2, beta2, x2, y2 = track[i - 1]
            if border[i]:
                side = np.sign(beta2 - beta1)
                b1_l = (
                    x1 + side * TRACK_WIDTH * math.cos(beta1),
                    y1 + side * TRACK_WIDTH * math.sin(beta1),
                )
                b1_r = (
                    x1 + side * (TRACK_WIDTH + BORDER) * math.cos(beta1),
                    y1 + side * (TRACK_WIDTH + BORDER) * math.sin(beta1),
                )
                b2_l = (
                    x2 + side * TRACK_WIDTH * math.cos(beta2),
                    y2 + side * TRACK_WIDTH * math.sin(beta2),
                )
                b2_r = (
                    x2 + side * (TRACK_WIDTH + BORDER) * math.cos(beta2),
                    y2 + side * (TRACK_WIDTH + BORDER) * math.sin(beta2),
                )
                self.road_poly.append(
                    ([b1_l, b1_r, b2_r, b2_l], (1, 1, 1) if i % 2 == 0 else (1, 0, 0))
                )
        self.track = track
        return True

    def reset(self):
        self._destroy()
        self.reward = 0.0
        self.prev_reward = 0.0
        self.tile_visited_count = 0
        self.t = 0.0
        self.road_poly = []

        while True:
            success = self._create_track()
            if success:
                break
            if self.verbose == 1:
                print(
                    "retry to generate track (normal if there are not many"
                    "instances of this message)"
                )
        self.car = Car(self.world, *self.track[0][1:4])

        return self.step(None)[0]

    def step(self, action):
        if action is not None:
            self.car.steer(-action[0])
            self.car.gas(action[1])
            self.car.brake(action[2])

        self.car.step(1.0 / FPS)
        self.world.Step(1.0 / FPS, 6 * 30, 2 * 30)
        self.t += 1.0 / FPS

        self.state = self.render("state_pixels")

        step_reward = 0
        done = False
        if action is not None:  # First step without action, called from reset()
            self.reward -= 0.1
            # We actually don't want to count fuel spent, we want car to be faster.
            # self.reward -=  10 * self.car.fuel_spent / ENGINE_POWER
            self.car.fuel_spent = 0.0
            step_reward = self.reward - self.prev_reward
            self.prev_reward = self.reward
            if self.tile_visited_count == len(self.track):
                done = True
            x, y = self.car.hull.position
            if abs(x) > PLAYFIELD or abs(y) > PLAYFIELD:
                done = True
                step_reward = -100

        return self.state, step_reward, done, {}

    def render(self, mode="human"):
        assert mode in ["human", "state_pixels", "rgb_array"]
        if self.viewer is None:
            from gym.envs.classic_control import rendering

            self.viewer = rendering.Viewer(WINDOW_W, WINDOW_H)
            self.score_label = pyglet.text.Label(
                "0000",
                font_size=36,
                x=20,
                y=WINDOW_H * 2.5 / 40.00,
                anchor_x="left",
                anchor_y="center",
                color=(255, 255, 255, 255),
            )
            self.transform = rendering.Transform()

        if "t" not in self.__dict__:
            return  # reset() not called yet

        # Animate zoom first second:
        zoom = 0.1 * SCALE * max(1 - self.t, 0) + ZOOM * SCALE * min(self.t, 1)
        scroll_x = self.car.hull.position[0]
        scroll_y = self.car.hull.position[1]
        angle = -self.car.hull.angle
        vel = self.car.hull.linearVelocity
        if np.linalg.norm(vel) > 0.5:
            angle = math.atan2(vel[0], vel[1])
        self.transform.set_scale(zoom, zoom)
        self.transform.set_translation(
            WINDOW_W / 2
            - (scroll_x * zoom * math.cos(angle) - scroll_y * zoom * math.sin(angle)),
            WINDOW_H / 4
            - (scroll_x * zoom * math.sin(angle) + scroll_y * zoom * math.cos(angle)),
        )
        self.transform.set_rotation(angle)

        self.car.draw(self.viewer, mode != "state_pixels")

        arr = None
        win = self.viewer.window
        win.switch_to()
        win.dispatch_events()

        win.clear()
        t = self.transform
        if mode == "rgb_array":
            VP_W = VIDEO_W
            VP_H = VIDEO_H
        elif mode == "state_pixels":
            VP_W = STATE_W
            VP_H = STATE_H
        else:
            pixel_scale = 1
            if hasattr(win.context, "_nscontext"):
                pixel_scale = (
                    win.context._nscontext.view().backingScaleFactor()
                )  # pylint: disable=protected-access
            VP_W = int(pixel_scale * WINDOW_W)
            VP_H = int(pixel_scale * WINDOW_H)

        gl.glViewport(0, 0, VP_W, VP_H)
        t.enable()
        self.render_road()
        for geom in self.viewer.onetime_geoms:
            geom.render()
        self.viewer.onetime_geoms = []
        t.disable()
        self.render_indicators(WINDOW_W, WINDOW_H)

        if mode == "human":
            win.flip()
            return self.viewer.isopen

        image_data = (
            pyglet.image.get_buffer_manager().get_color_buffer().get_image_data()
        )
        arr = np.fromstring(image_data.get_data(), dtype=np.uint8, sep="")
        arr = arr.reshape(VP_H, VP_W, 4)
        arr = arr[::-1, :, 0:3]

        return arr

    def close(self):
        if self.viewer is not None:
            self.viewer.close()
            self.viewer = None

    def render_road(self):
        if self.vl == None:
            colors = [0.4, 0.8, 0.4, 1.0] * 4
            polygons_ = [
                +PLAYFIELD,
                +PLAYFIELD,
                0,
                +PLAYFIELD,
                -PLAYFIELD,
                0,
                -PLAYFIELD,
                -PLAYFIELD,
                0,
                -PLAYFIELD,
                +PLAYFIELD,
                0,
            ]

            k = PLAYFIELD / 20.0
            colors.extend([0.4, 0.9, 0.4, 1.0] * 4 * 20 * 20)
            for x in range(-20, 20, 2):
                for y in range(-20, 20, 2):
                    polygons_.extend(
                        [
                            k * x + k,
                            k * y + 0,
                            0,
                            k * x + 0,
                            k * y + 0,
                            0,
                            k * x + 0,
                            k * y + k,
                            0,
                            k * x + k,
                            k * y + k,
                            0,
                        ]
                    )

            for poly, color in self.road_poly:
                colors.extend([color[0], color[1], color[2], 1] * len(poly))
                for p in poly:
                    polygons_.extend([p[0], p[1], 0])

            self.vl = pyglet.graphics.vertex_list(
                len(polygons_) // 3, ("v3f", polygons_), ("c4f", colors)  # gl.GL_QUADS,
            )

        self.vl.draw(gl.GL_QUADS)

    def updateTileColor(self, tile):

        if self.vl != None:

            self.road : list
            self.vl : pyglet.graphics.vertexdomain.VertexList

            tile_index = self.road.index(tile)
            colors_offset = 6416

            for i in range(4):
                self.vl.colors[colors_offset + 16 * tile_index + 4*i + 0] = ROAD_COLOR[0]
                self.vl.colors[colors_offset + 16 * tile_index + 4*i + 1] = ROAD_COLOR[1]
                self.vl.colors[colors_offset + 16 * tile_index + 4*i + 2] = ROAD_COLOR[2]

    def render_indicators(self, W, H):
        s = W / 40.0
        h = H / 40.0
        colors = [0, 0, 0, 1] * 4
        polygons = [W, 0, 0, W, 5 * h, 0, 0, 5 * h, 0, 0, 0, 0]

        def vertical_ind(place, val, color):
            colors.extend([color[0], color[1], color[2], 1] * 4)
            polygons.extend(
                [
                    place * s,
                    h + h * val,
                    0,
                    (place + 1) * s,
                    h + h * val,
                    0,
                    (place + 1) * s,
                    h,
                    0,
                    (place + 0) * s,
                    h,
                    0,
                ]
            )

        def horiz_ind(place, val, color):
            colors.extend([color[0], color[1], color[2], 1] * 4)
            polygons.extend(
                [
                    (place + 0) * s,
                    4 * h,
                    0,
                    (place + val) * s,
                    4 * h,
                    0,
                    (place + val) * s,
                    2 * h,
                    0,
                    (place + 0) * s,
                    2 * h,
                    0,
                ]
            )

        true_speed = np.sqrt(
            np.square(self.car.hull.linearVelocity[0])
            + np.square(self.car.hull.linearVelocity[1])
        )

        vertical_ind(5, 0.02 * true_speed, (1, 1, 1))
        vertical_ind(7, 0.01 * self.car.wheels[0].omega, (0.0, 0, 1))  # ABS sensors
        vertical_ind(8, 0.01 * self.car.wheels[1].omega, (0.0, 0, 1))
        vertical_ind(9, 0.01 * self.car.wheels[2].omega, (0.2, 0, 1))
        vertical_ind(10, 0.01 * self.car.wheels[3].omega, (0.2, 0, 1))
        horiz_ind(20, -10.0 * self.car.wheels[0].joint.angle, (0, 1, 0))
        horiz_ind(30, -0.8 * self.car.hull.angularVelocity, (1, 0, 0))
        vl = pyglet.graphics.vertex_list(
            len(polygons) // 3, ("v3f", polygons), ("c4f", colors)  # gl.GL_QUADS,
        )
        vl.draw(gl.GL_QUADS)
        self.score_label.text = "%04i" % self.reward
        self.score_label.draw()

if __name__ == "__main__":
    from pyglet.window import key

    a = np.array([0.0, 0.0, 0.0])

    def key_press(k, mod):
        global restart
        if k == 0xFF0D:
            restart = True
        if k == key.LEFT:
            a[0] = -1.0
        if k == key.RIGHT:
            a[0] = +1.0
        if k == key.UP:
            a[1] = +1.0
        if k == key.DOWN:
            a[2] = +0.8  # set 1.0 for wheels to block to zero rotation

    def key_release(k, mod):
        if k == key.LEFT and a[0] == -1.0:
            a[0] = 0
        if k == key.RIGHT and a[0] == +1.0:
            a[0] = 0
        if k == key.UP:
            a[1] = 0
        if k == key.DOWN:
            a[2] = 0

    env = CarRacing()
    env.render()
    env.viewer.window.on_key_press = key_press
    env.viewer.window.on_key_release = key_release
    record_video = False
    if record_video:
        from gym.wrappers.monitor import Monitor

        env = Monitor(env, "/tmp/video-test", force=True)
    isopen = True
    while isopen:
        env.reset()
        total_reward = 0.0
        steps = 0
        restart = False
        while True:
            s, r, done, info = env.step(a)
            total_reward += r
            if steps % 200 == 0 or done:
                print("\naction " + str(["{:+0.2f}".format(x) for x in a]))
                print("step {} total_reward {:+0.2f}".format(steps, total_reward))
            steps += 1
            isopen = env.render()
            if done or restart or isopen == False:
                break
    env.close()
`

jkterry1, 2021-08-21:
The memory leak has been fixed in merged PRs

dbsxdbsx, 2022-02-26:
@philipp-seidel1 , however, with the latest `gym(v0.22.0)`, there is still a black window  even user doesn't call `render()`.
I found some workaround:https://stackoverflow.com/questions/10466590/hiding-pygame-display.  But if doing this way, then all Box2D envrionment can not render correctly.

Closed 2021-08-21.

Thread 2246 (2021-06-28):

How to call env.render(mode='rgb_array') without a window popup?

schissmantics, 2021-06-28:
I need to the following on macos Big Sur 11.4, python3.9.5, gym==0.18.3 to get frame as an array which is not returned by default for bipedal walker env.

    import gym

    env = gym.make('BipedalWalker-v3')
    state = env.render(mode='rgb_array')

This does the job however, I don't want a window popping up because this will be called by pytest so, that window beside requiring a virtual display if the tests are run remotely on some server, is unnecessary. Is there a way to prevent the window from popping up?

  [1]: https://www.xquartz.org
  [2]: https://pypi.org/project/PyVirtualDisplay/
  [3]: https://pypi.org/project/pytest-xvfb/

dibbla, 2021-06-29:
So you want to have it displayed on sth like Jupyter notebook?

I've got this from the site in [Zhihu](https://zhuanlan.zhihu.com/p/112750443), but not the original source

The following from yandexdataschool is quite the same:

```
img = plt.imshow(env.render(mode='rgb_array')) # only call this once
img.set_data(env.render(mode='rgb_array')) # just update the data
display.display(plt.gcf())
display.clear_output(wait=True)
```

emadboctorx, 2021-06-29:
No, what I'm trying to do is run env.render(mode='rgb_array') to get the current frame/state as an array in environments that do not return one by default ex: `BipedalWalker-v3`. I need to be able to do so without a window popping up whih always happen on my macbook. I also want to be able to do the same for `env = gym.wrappers.Monitor(env, video_dir)` when followed by `env.reset()`. Both cases cause a window popup and I need to eliminate that behavior.

dibbla, 2021-06-29:
Yes, you may replace render() with this code(except the first line, the first line should be called once)

```
env=withSnapshot(gym.make("Breakout-v4").env)
env.reset()
env.seed(1995)

img = plt.imshow(env.render(mode='rgb_array')) # only call this once

acList=[0,0,1,0]

for i in acList:
    _,_,done,_=env.step(i)
    #you may render here, but instead, we can use the following three lines
    img.set_data(env.render(mode='rgb_array')) # just update the data
    display.display(plt.gcf())
    display.clear_output(wait=True)
    if done:
        break
print(len(acList))
```

schissmantics, 2021-08-21:
@jkterry1 You haven't contributed to solving the issue, except for the `help wanted` tag above, neither has anyone. Then you just decided based on some unclear criteria to close my issue. Given that there is a logical explanation to your action, either pay me the respect of clarification on how your `help wanted` helped fix the issue. Otherwise I'll be assuming you made a mistake and in that case, you will need to re-open the issue, thanks.

koushik1234, 2022-03-27:
change python environment to <3.9

jkterry1, 2022-03-31:
Does this issue still exist with the newest versions of gym? With the changes to pygame it shouldn't. I just saw this thread now due to the new comment.

promiseve, 2022-06-27:
well i just faced the same issue

Closed 2021-08-21.

Thread 2319 (2021-08-16):

MultiDiscrete flatten_space inconsistencies

rallen10, 2021-08-16:
I ran into some seemingly glaring inconsistencies with [flattening](https://github.com/openai/gym/blob/bfd4f6d179c90c56356b7cd3bba323fdabd0d2d2/gym/spaces/utils.py#L103) a [MultiDiscrete space](https://github.com/openai/gym/blob/master/gym/spaces/multi_discrete.py)

1. `flatten_space(MultiDiscrete)` does __NOT__ behave the same as `flatten_space(Tuple([Discrete, Discrete]))`. Flattening a `Discrete` space results in a one-hot vector space. In turn, flattening a `Tuple([Discrete, Discrete])` results in a space of concatenated one-hot vectors. Therefore it would be expected that flattening a `MultiDiscrete` space would also result in a concatenated one-hot vectors space. This is __NOT__ the case. Instead `flatten_space(MultiDiscrete)` results in a space with the same dimensions as the original `MultiDiscrete` space with bounds drawn from the ranges of each variable in the original `MultiDiscrete` space. Therefore the flattening of `MultiDiscrete` has _almost_ no functional purpose; but it does seem to introduce a significant bug (see 2)
2. `flatten_space(MultiDiscrete)` upper bound is invalid and causes invalid sample draws! The upper bound shouldn't be inclusive. This can be easily demonstrated with a simple `MultiDiscrete([2,2])` space:
```
from gym import spaces
a = spaces.MultiDiscrete([2,2])
valid_samples = [[0,0], [1,0], [0,1], [1,1]]

# this works
for i in range(100):
    sample = a.sample()
    assert list(sample) in valid_samples, "{} is not a valid sample of {}".format(flat_sample, valid_samples)

af = spaces.flatten_space(a)
# this will fail because a sample will be drawn with a value of 2 in one of the elements
for i in range(100):
    flat_sample = af.sample()
    assert list(flat_sample) in valid_samples, "{} is not a valid sample of {}".format(flat_sample, valid_samples)
```

See related thread [here](https://github.com/openai/gym/issues/1830), however inconsistency 2 was not identified nor was inconsistency 1 really addressed.

jkterry1, 2021-08-16:
Thanks for pointing this out. I believe that part of this is a duplicate of https://github.com/openai/gym/issues/1915, but ya the rest probably needs to be dealt with.

jkterry1, 2021-08-21:
I'm closing this in favor of the open PR so I can keep track of what all is going on

rallen10, 2021-08-21:
Sounds good. Ignore the 'confused' reaction emoji on your previous comment. I accidentally clicked it and can't seem to remove it

Closed 2021-08-21.

Thread 2333 (2021-08-19):

Thread safety issue when running multiple environments in parallel using joblib

tarcey, 2021-08-19:
I want to run multiple separate environments of the same kind in parallel. Each environment is ever only called by one thread each, and runs independent of all other instances. Per code, each environment should be called correctly and with correct synchronization (automatic as in joblib's 'embarrassingly parallel' use-case), however the reset-function does not register (despite returning an initial observation) when called asynchronously on multiple environments in parallel.

Assuming that each env environment is entirely independent of all others and there are no thread-local variables, i would think that the code below would work. Is my assumption incorrect? What is the correct way to run multiple environments in parallel in gym?

Runnable example code below. With n_jobs=1 no problem occurs. When only the step-function is called in parallel, but the reset function is called iteratively in plain python, no error is thrown. But i'm hesitant to trust the output.

```
import tensorflow as tf
import gym
from joblib import Parallel, delayed

class BatchEnv:
    def __init__(self, env_id, num):
        self.env_id = env_id
        self.num = num

        self.envs = [gym.make(env_id) for _ in range(num)]

    def reset_envs(self, par):
        def reset(env):
            return env.reset()
        init_observations = par(delayed(reset)(env) for env in self.envs)

        return tf.constant(init_observations, dtype=tf.float32)

    def step_envs(self, actions, par):
        def step(env, action):
            observation, reward, done, _ = env.step(action)
            return [observation, reward, not done]

        measurements = par(delayed(step)(env, action) for env, action in zip(self.envs, actions))

        observations, rewards, alive = zip(*measurements)
        observations = tf.constant(observations, dtype=tf.float32)
        rewards = tf.constant(rewards, dtype=tf.float32)
        alive = tf.constant(alive, dtype=tf.dtypes.bool)

        return observations, rewards, alive

    def record_episodes(self, steps, policynet):
        with Parallel(n_jobs=-1) as par:
            observations = [None] * steps
            rewards = [None] * steps
            actions = [None] * steps
            alive = [None] * steps

            observations_t = self.reset_envs(par)
            print(observations_t.shape)
            # pstates_t = policynet.btu.get_initial_state(batch_size=self.num, dtype=en.dtype)

            for t in range(steps):
                # actions_t, action_sample_t, pstates_t = policynet.act_t(observations_t, pstates_t, training=False)
                actions_t, action_sample_t, pstates_t = None, [env.action_space.sample() for env in self.envs], None

                observations[t] = observations_t
                actions[t] = actions_t
                # action_sample_t = list(tf.squeeze(action_sample_t).numpy().tolist())
                observations_t, rewards[t], alive[t] = self.step_envs(action_sample_t, par)

        return observations, actions, rewards, alive

test = BatchEnv('CartPole-v0', 64)
test = test.record_episodes(60, None)
```

tristandeleu, 2021-08-19:
If you want to run multiple environments in parallel, you could give [`AsyncVectorEnv`](https://github.com/openai/gym/blob/2853ce4797a4dadb1f8702c8e35143d9fbd43ea6/gym/vector/async_vector_env.py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) a try. This runs each environment in a separate process though, not in a separate thread. Here is an example of how to use it:
```python
import gym

envs = gym.vector.AsyncVectorEnv([lambda: gym.make('CartPole-v0')] * 64)
# Or alternatively
# envs = gym.vector.make('CartPole-v0', num_envs=64)
```

And then it behaves like any Gym environment
```python
observations = envs.reset()  # Shape (64, 4)
for _ in range(10):
    actions = envs.action_space.sample()  # Or your policy
    observations, rewards, dones, infos = envs.step(actions)
```

[Here](https://github.com/tristandeleu/gym/tree/docs/vector-env/docs/vector) is some documentation about the `VectorEnv` API if you want to have a look at that. There is no out of the box equivalent for vectorized environments using threads in Gym unfortunately, but there is this PR https://github.com/openai/baselines/pull/958 that was open for baselines that introduced a similar vectorized environment with threads.

tarcey, 2021-08-20:
Thank you for the quick and helpful response, i will try that.

Closed 2021-08-21.

Thread 2357 (2021-08-26):

Box.contains fails on tuple input

FirefoxMetzger, 2021-08-26:
```python
from gym.spaces import Box
import numpy as np

space = Box(low=np.array((-1, -1, -1)), high=np.array((1, 1, 1)))
space.contains((0,0,0))

```

Produces the following stack-trace

```
Traceback (most recent call last):
  File "box_bug.py", line 5, in <module>
    space.contains((0,0,0))
  File "/home/firefoxmetzger/.local/lib/python3.8/site-packages/gym/spaces/box.py", line 144, in contains
    x.shape == self.shape and np.all(x >= self.low) and np.all(x <= self.high)
AttributeError: 'tuple' object has no attribute 'shape'
```

A quick look at the code reveals that only lists are promoted to arrays.

https://github.com/openai/gym/blob/edc233288e4336825540ca2c0dc2e6b8a9291dfc/gym/spaces/box.py#L140-L145

I would lobby for using a more generic call to `np.asarray` to convert anything ArrayLike; perhaps combined with a type hint update `Any -> np.typing.ArrayLike`:

```python
def contains(self, x):
    x = np.asarray(x)

    if x.shape != self.shape:
        return False

    if np.any( (x<self.low) | (x>self.high) ):
        return False

    return True
```

tristandeleu, 2021-08-28:
> @tristandeleu Oh? Am I missing something? What situation do you have in mind where this conversion would be detrimental?

Not detrimental, but less intuitive from a UX perspective because this conversion happens internally to Gym, and is not something that the user requested. But really at the end of the day, I am not strongly against the internal conversion to Numpy arrays.

FirefoxMetzger, 2021-08-28:
> this conversion happens internally to Gym, and is not something that the user requested.

@tristandeleu I'm confused. `np.asarray` would create a copy of its input if it isn't already a ndarray (with correct type and order), which will then be handed to gc once the function returns, so the user would keep the original object that was passed into `space.contains` and (performance aside) wouldn't even notice that gym creates a temporary array internally in some cases. I can see how this can be troublesome if `x` was a tensor located on the GPU since this can have significant performance implications. Then again `space.contains` doesn't seem like a function one would expect to see in the critical loop of HPC code, so I'm not sure if my argument here counts.

Which part is unintuitive from your perspective?

tristandeleu, 2021-08-28:
The issue would be if you ensure dtype as well, as I suggested in https://github.com/openai/gym/issues/2357#issuecomment-907128794 (to eventually also check for the input dtype). Any object that can't be casted in the space's dtype would then raise an error because of the conversion to Numpy array.

If the dtype is not being checked (as it is the case currently), then I agree this has minimal impact since `np.asarray` would just copy the input.

FirefoxMetzger, 2021-08-28:
@tristandeleu Hm, I'm still not sure I 100% get what you're after; I think it might be related to https://github.com/openai/gym/issues/2298#issuecomment-907322981.

In either case, would something like this do what you have in mind?

```python
if isinstance(x, np.ndarray):
    assert x.dtype == self.dtype
else:
    x = np.asarray(x, dtype=self.dtype)
    warn("Casting input to numpy array of correct type)
```

tristandeleu, 2021-08-28:
Sorry for the confusion, but this is indeed more or less what I had in mind. To be very concrete, here is what I would suggest
```diff
diff --git a/gym/spaces/box.py b/gym/spaces/box.py
index 32b5c93..f4c27aa 100644
--- a/gym/spaces/box.py
+++ b/gym/spaces/box.py
@@ -1,4 +1,5 @@
 import numpy as np
+import warnings

 from .space import Space
 from gym import logger
@@ -138,10 +139,11 @@ class Box(Space):
         return sample.astype(self.dtype)

     def contains(self, x):
-        if isinstance(x, list):
-            x = np.array(x)  # Promote list to array for contains check
+        if not isinstance(x, np.ndarray):
+            warnings.warn('Casting input to Numpy array.')
+            x = np.asarray(x, dtype=self.dtype)
         return (
-            x.shape == self.shape and np.all(x >= self.low) and np.all(x <= self.high)
+            np.can_cast(x.dtype, self.dtype) and x.shape == self.shape and np.all(x >= self.low) and np.all(x <= self.high)
         )

     def to_jsonable(self, sample_n):
```

tristandeleu, 2021-08-28:
Also worth noting, there are other places in Gym where the inputs get implicitly casted to a Numpy array with a dtype given by the space. For example when [writing to shared memory in `gym.vector`](https://github.com/openai/gym/blob/150404104afc57ea618acca34d2d1f797d779869/gym/vector/utils/shared_memory.py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). That's why I said I am not against the internal conversion into Numpy arrays.

FirefoxMetzger, 2021-08-28:
@tristandeleu Sure thing. I created a PR with the respective changes.

Closed 2021-09-01.

Thread 2408 (2021-09-15):

[Question] Your graphics drivers do not support OpenGL 2.0.

BeWaterMyFriend7, 2021-09-15:
When I run `env.render()` the rendering fails, a black pop-up window appears, and an warning is reported:

Your graphics drivers do not support OpenGL 2.0.
You may experience rendering issues or crashes.

I have reinstalled the nvidia graphics driver, but the problem still exists

### Enviroment
ubuntu20.04 RTX2080Ti X3
`nvidia-smi`：NVIDIA-SMI 460.91.03    Driver Version: 460.91.03    CUDA Version: 11.2
`nvcc -V`：Cuda compilation tools, release 11.2, V11.2.152

jkterry1, 2021-09-15:
What environment are you trying to render? And does your device have a version of Ubuntu a UI installed and a monitor attached?

dre2004, 2021-09-15:
I get the same issue when trying to render the `CarRacing-v0` environment.

OS: `Linux Mint 20.2 Uma (Ubuntu Focal)`
nvidia-smi: `NVIDIA-SMI 470.63.01    Driver Version: 470.63.01    CUDA Version: 11.4`
nvcc -v: cuda not installed
gpu: `Nvidia RTX3060`

BeWaterMyFriend7, 2021-09-16:
> What environment are you trying to render? And does your device have a version of Ubuntu with a UI installed and a monitor attached?

Thank you very much for your reply.
I get this issue when trying to render the `CartPole-v0` and `MountainCar-v0` environment
And I have the GUI interface of Ubuntu

FelipeMartins96, 2021-09-16:
I had the same problem with similar setup, for further testing I tried running pyglet '[Hello World'](https://github.com/pyglet/pyglet/blob/master/examples/hello_world.py) example and got the same error. I think this issue is on pyglet

I also found this relevant issue on their repo https://github.com/pyglet/pyglet/issues/454, however I still got problems after installing the maintence version as described there

FelipeMartins96, 2021-09-16:
Reverting pyglet version to 1.5.19 seem to have solved this for me, I think we could limit to up to this version until a new release fixes it?

jkterry1, 2021-09-16:
Limiting pyglet to that version will break installs for various people. It used to be limited and then we got a bunch of issues.

FelipeMartins96, 2021-09-16:
> Limiting pyglet to that version will break installs for various people. It used to be limited and then we got a bunch of issues.

got it! And I think it is not necessary anymore, as pyglet released 1.5.21 today and it fixed this issue for me. @BeWaterMyFriend7 and @dre2004 try upgrading pyglet to the latest version and check if it solves the issue. :)

BeWaterMyFriend7, 2021-09-17:
> > Limiting pyglet to that version will break installs for various people. It used to be limited and then we got a bunch of issues.
>
> got it! And I think it is not necessary anymore, as pyglet released 1.5.21 today and it fixed this issue for me. @BeWaterMyFriend7 and @dre2004 try upgrading pyglet to the latest version and check if it solves the issue. :)

Thank you very much! This issue has troubled me for a long time and even I have the idea of   reinstalling the system. Now I upgraded pyglet and it was solved.
Also thank you all developers for your hard work. @jkterry1

keithburden, 2023-04-13:
Running 'Hello World' under Linux with X11, I  got the **'Your graphics drivers do not support OpenGL 2.0....'** but only occasionally when running remotely via exported display in an ssh session.  I diagnosed and then fixed the issue by running with:

```
     pyglet.options['debug_gl'] = True
     pyglet.options['debug_gl'] = True
     pyglet.options['debug_gl_trace'] = True
     pyglet.options['debug_x11'] = True
```
Observing stderr during a failure indicated a bad malloc in X11 was causing the failure. Updated my Nvidia drivers and it fixed it.  **_Try with DEBUG options and see what you get._**
Reference: https://pyglet.readthedocs.io/en/latest/programming_guide/debug.html

Closed 2021-09-17.

Thread 2421 (2021-09-24):

[Bug Report] Env render flickering on WSL

BUCKFAE, 2021-09-24:
I can't get gym work on WSL2 Windows 11.

## Minimal example
```python
import gym

env = gym.make('CartPole-v0')
env.reset()
for _ in range(1000):
    env.render()
    env.step(env.action_space.sample()) # take a random action
    env.close()
```
When i execute the code it opens a window, displays one frame of the env, closes the window and opens another window in another location of my monitor. Most of the time the content of the window is just black, however sometimes it displays the environment correctly. In both cases the window instantly closes itself and opens the next frame somewhere else.

## Troubleshooting i did
### Xeyes
Running xeyes works just fine and as expected
### Pygame
I installed pygame and wrote a minimal example to see if that works
```python
import pygame

pygame.init()
screen = pygame.display.set_mode((400, 300))
done = False

while not done:
    for event in pygame.event.get():
        if event.type == pygame.QUIT:
            done = True
        pygame.draw.rect(screen, (0, 128, 255), pygame.Rect(30, 30, 60, 60))
        pygame.display.flip()
```
This opens, after a few seconds, a window that displays a recangle - just as expected

### Matplotlib
I installed VcXsrv as suggested [here](https://stackoverflow.com/questions/43397162/show-matplotlib-plots-and-other-gui-in-ubuntu-wsl1-wsl2) and ran a minimal example which worked just as expected as well. Without VcXsrv i had no output yet the script kept running.
```python
import matplotlib.pyplot as plt

x = [i for i in range(20)]
y = [i ** 2 for i in range(20)]

plt.plot(x, y)
plt.show()
```

## System config
### Windows version
Windows 11 - Version 21H2 (Build 22000.194)
### WSL Status
```
wsl --status
Standard Distribution: Ubuntu
Standardversion: 2

Das Windows-Subsystem für Linux wurde zuletzt aktualisiert am 23/09/2021
Der Windows-Subsystem für Linux-Kernel kann mit „wsl --update“ manuell aktualisiert werden. Aufgrund Ihrer Systemeinstellungen können jedoch keine automatischen Updates durchgeführt werden.
Um automatischen Kernel-Updates zu erhalten, aktivieren Sie die Windows Update-Einstellung: „Empfangen von Updates für andere Microsoft-Produkte, wenn Windows aktualisiert wird“.
Weitere Informationen finden Sie unter https://aka.ms/wsl2kernel.

Kernel-Version: 5.10.43
```
### Pip Freeze
```
buckfae-wsl@buckfae-pc:~$ pip freeze
absl-py==0.14.0
astunparse==1.6.3
attrs==19.3.0
Automat==0.8.0
blinker==1.4
cachetools==4.2.2
certifi==2019.11.28
cffi==1.14.6
chardet==3.0.4
clang==5.0
Click==7.0
cloud-init==20.1
cloudpickle==2.0.0
colorama==0.4.3
command-not-found==0.3
configobj==5.0.6
constantly==15.1.0
cryptography==2.8
cycler==0.10.0
Cython==0.29.24
dbus-python==1.2.16
distro==1.4.0
distro-info===0.23ubuntu1
entrypoints==0.3
flatbuffers==1.12
gast==0.4.0
glfw==2.2.0
google-auth==1.35.0
google-auth-oauthlib==0.4.6
google-pasta==0.2.0
grpcio==1.40.0
gym==0.20.0
h5py==3.1.0
httplib2==0.14.0
hyperlink==19.0.0
idna==2.8
imageio==2.9.0
importlib-metadata==1.5.0
incremental==16.10.1
Jinja2==2.10.1
jsonpatch==1.22
jsonpointer==2.0
jsonschema==3.2.0
keras==2.6.0
Keras-Preprocessing==1.1.2
keyring==18.0.1
kiwisolver==1.3.2
language-selector==0.1
launchpadlib==1.10.13
lazr.restfulclient==0.14.2
lazr.uri==1.0.3
lockfile==0.12.2
Markdown==3.3.4
MarkupSafe==1.1.0
matplotlib==3.4.3
more-itertools==4.2.0
netifaces==0.10.4
numpy==1.19.5
oauthlib==3.1.0
opt-einsum==3.3.0
Pillow==8.3.2
protobuf==3.18.0
pyasn1==0.4.2
pyasn1-modules==0.2.1
pycparser==2.20
pyglet==1.5.21
PyGObject==3.36.0
PyHamcrest==1.9.0
PyJWT==1.7.1
pymacaroons==0.13.0
PyNaCl==1.3.0
pyOpenSSL==19.0.0
pyparsing==2.4.7
pyrsistent==0.15.5
pyserial==3.4
python-apt==2.0.0
python-dateutil==2.8.2
python-debian===0.1.36ubuntu1
PyYAML==5.3.1
requests==2.22.0
requests-oauthlib==1.3.0
requests-unixsocket==0.2.0
rsa==4.7.2
SecretStorage==2.3.1
service-identity==18.1.0
simplejson==3.16.0
six==1.15.0
ssh-import-id==5.10
systemd-python==234
tensorboard==2.6.0
tensorboard-data-server==0.6.1
tensorboard-plugin-wit==1.8.0
tensorflow-estimator==2.6.0
tensorflow-gpu==2.6.0
termcolor==1.1.0
Twisted==18.9.0
typing-extensions==3.7.4.3
ubuntu-advantage-tools==20.3
ufw==0.36
unattended-upgrades==0.1
urllib3==1.25.8
wadllib==1.3.3
Werkzeug==2.0.1
wrapt==1.12.1
zipp==1.0.0
zope.interface==4.7.1
```

# TLDR
OpenAI Gym window flickers like crazy on WSL2.

jkterry1, 2021-09-24:
A few comments:
-Gym officially does not support windows
-This is a problem with Pyglet that those environments use for rendering, not with gym itself

jkterry1, 2021-09-24:
From the readme:

"We support Python 3.6, 3.7, 3.8 and 3.9 on Linux and macOS. We will accept PRs related to Windows, but do not officially support it."

jkterry1, 2021-09-25:
We're already planning to replace pyglet (there's another issue on this) so I'm going to close this issue given that and the above

Closed 2021-09-25.

Thread 2432 (2021-09-29):

AttributeError: module 'ale_py.gym' has no attribute 'ALGymEnv'

mirzaabdulwahab1612, 2021-09-29:
### Question

I am trying to install Gym on Windows and MacOS (BigSur) as well. However, whenever I install `pip install gym[atari]` and then try to import any Atari environment, I get this error. Any ideas what could be causing this? I am using Python 3.8. Thanks.

kyleabbott, 2021-09-30:
Had this issue as well with a fresh install today. `pip install gym` installs version 0.20.0 of gym for me which depends on ale-py for Atari envs, and `pip install gym[atari]` installs 0.7.1 of ale-py; but this dependency appears to be broken (the way `gym/envs/__init__.py` is registering Atari envs is broken w.r.t. the ale-py interface). This appears to be acknowledged in the [tag notes for gym 0.21.0](https://github.com/openai/gym/releases/tag/v0.21.0). Indeed, installing gym from the 0.21.0 tag seems to resolve this issue.

JesseFarebro, 2021-09-30:
Yes, sorry all, there was a delay with the PyPI `0.21` release which was supposed to drop at the same time as `ale-py==0.7.1`. You can either do as @kyleabbott said and install Gym 0.21 from Github or downgrade ale-py to 0.7, i.e., `pip install --force-reinstall ale-py==0.7`.

tfboyd, 2021-09-30:
Adding a +1, this was the source of a nightly test failure for us. We will wait until 0.21.0 is released as locking to 0.7 seems like tech debt.

JesseFarebro, 2021-10-04:
@tfboyd it is fine to include [Tetris by Colin Hughes](https://atariage.com/software_page.php?SoftwareID=3290). It was self-published with no license, i.e., Colin wrote:

```
Hi,

This is my first 2600 program, a clone of Tetris. I wrote this using DASM
to assemble the code and PC Atari 1.5 to test it. Use the joystick to move
the block and the fire button to rotate it.	I don't know what the speed is
like on a real VCS as I'm using a 486DX25 to test the code.
There's currently no sound ( no soundcard ) and I've tried to keep it all
under 2k.

Feel free to do anything you like with this code, I only wrote it to pass
away a few days. If you have any comments feel free to Email me at:

Colin_Hughes@interactive.sony.com

Cheers,

CJH.

10th June 1997.
```

This is how we do basic [unit tests in the ALE](https://github.com/mgbellemare/Arcade-Learning-Environment/tree/master/tests/resources).

tfboyd, 2021-10-04:
I cannot use that internally, but pulling down this .bin for unit testing could be an option.  It would be awesome if it was included in the .whl but without a license that is likely a big dangerous.  @JesseFarebro **thank you** for the suggestion, I got caught in a bit of tunnel vision. We have a complex internal/external testing setup.  I am still waiting on pins and needles for gym to release the version that is compatible with latest ale.

JesseFarebro, 2021-10-04:
@tfboyd my email is on my profile, could you send me an email so we can better discuss your needs.

jkterry1, 2021-10-07:
OpenAI finally cut 0.21.0, which should fix everything here. Please lmk if anything else goes wrong for people.

Closed 2021-10-07.

Thread 2447 (2021-10-14):

[Bug Report] Bug title

ghost, 2021-10-14:
If you are submitting a bug report, please fill in the following details and use the tag [bug].

**Describe the bug**
When trying to save a video of the Hopper-v2 environment, it stops after a couple (14) of steps with the error:
Process finished with exit code 139 (interrupted by signal 11: SIGSEGV)
I am able to render the environment perfectly (when not capturing) , and the code does work for the Cartpole environment.
In the hopper case, the first 14 frames are captured and saved in the mp4 file though, but I do not understand why the process finishes mid-episode.

**Code example**
```import gym
import os
from gym.wrappers.monitoring.video_recorder import VideoRecorder

path_project = os.path.abspath(os.path.join(__file__, ".."))
path_of_video_with_name = os.path.join(path_project, "videotest.mp4")
env = gym.make('Hopper-v2') # for making environment
state = env.reset()
video_recorder = None
video_recorder = VideoRecorder(env, path_of_video_with_name, enabled=True)

for _ in range(1000):
   env.render()
   video_recorder.capture_frame()
   env.step(env.action_space.sample()) # take a random action

print("Saved video.")

video_recorder.close()
video_recorder.enabled = False
env.close()
```

**System Info**

I am using Linux 20.0.4 (Ubuntu), Gym version 0.21.0 using pip install gym, python version 3.7.6.

**Additional context**
Add any other context about the problem here.

### Checklist

- [x] I have checked that there is no similar [issue](https://github.com/openai/gym/issues) in the repo (**required**)

jkterry1, 2022-05-23:
PR #2762 is about to be merged, introducing V4 MuJoCo environments using new bindings and a dramatically newer version of the engine. If this issue still persists with the V4 ones, please create a new issue for it.

Closed 2022-05-23.

Thread 2468 (2021-10-29):

[Question] Details regarding the terminal conditions for LunarLander-v2

hagerrady13, 2021-10-29:
### When does LunarLander terminate?

I have been carefully looking into LunarLander to model the environment dynamics but there seems to be little documentation on when it terminates; it is not clear in the source code too.

There are two cases:
- If it fails by hitting anywhere outside the landing pad, it receives -100 reward and terminates, but how do you decide on that? The leg contacts do not seem to be enough, can we use the lander coordinates to check for that if we know that the landing pad is at (0,0)?

- If it reaches the landing pad by checking if the lander is awake, is it the state when the lander no longer moves? so it basically provides rewards for landing and not moving anymore? Moreover, what makes a lander not awake?

If someone can provide more information behind the conditions of termination on LunarLander, that would be great!
@olegklimov

kir0ul, 2022-01-24:
My understanding is the following, the `LunarLander` environment terminates if:
1) the lander crashes (the lander body gets in contact with the moon);
2) the lander gets outside of the viewport (`x` coordinate is greater than 1);
3) the lander is not awake. From the [Box2D docs](https://box2d.org/documentation/md__d_1__git_hub_box2d_docs_dynamics.html#autotoc_md61), a body which is not awake is a body which doesn't move and doesn't collide with any other body:
> When Box2D determines that a body (or group of bodies) has come to rest, the body enters a sleep state which has very little CPU overhead. If a body is awake and collides with a sleeping body, then the sleeping body wakes up. Bodies will also wake up if a joint or contact attached to them is destroyed.

I will add this to the docs in https://github.com/Farama-Foundation/gym-docs/pull/9.

Hope that helps!

Closed 2022-01-24.

Thread 2480 (2021-11-04):

NotImplementedError with self.reset()

amverdone, 2021-11-04:
### Question

Trying to create my own custom environment, but keep getting this error with my reset function. I've been switching around the versions of gym but nothing seems to be working. here's my reset function:
 ```

def reset(self):
    self.state = draw_num()
    return self.state

 ```

and my scratch file:
 ```
import gym
import gym_foo

episodes = 10
env = gym.make('foo-v0')

for episode in range(1,episodes):
    state = env.reset()
    done = False
    score = 0

    while not done:
        env.render()
        action = random.choice([0,1])

        n_state, reward, done, info = env.step(action)
        score += reward

    print("EPISODE: {}  SCORE: {}".format(episode,score))

print("SCRATCH EXECUTED")

env.close()

 ```
and I keep getting this error message:
 ```
File "/Users/user1/Desktop/PYTHON/programs/gym-foo/scratch.py", line 8, in <module>
    state = env.reset()
  File "/Library/Frameworks/Python.framework/Versions/3.9/lib/python3.9/site-packages/gym/core.py", line 104, in reset
    return self._reset()
  File "/Library/Frameworks/Python.framework/Versions/3.9/lib/python3.9/site-packages/gym/core.py", line 73, in _reset
    def _reset(self): raise NotImplementedError
NotImplementedError
Anthonys-MacBook-Pro:gym-foo anthony$
```

RedTachyon, 2021-11-06:
There's probably a bug in the whole `gym_foo` thing, hard to say what without knowing the code, and what version of gym you're even using.

amverdone, 2021-11-06:
I'm currently using version 0.9.4 of gym, but I've tried versions 0.21.0, 0.19.0 still didn't work. Here is the entire environment code if there's anything that stands out let me know

```
import gym
from gym import error, spaces, utils
from gym.spaces import Discrete, Box
from gym.utils import seeding
import random
import numpy as np

deck = [1,2,3,4,5,6,7,8,9,10]

def draw_num():
    choice = random.choice(deck)
    return choice

def ret_reward(choice):
    reward = choice * 0.1
    return reward

class FooEnv(gym.Env):
  metadata = {'render.modes': ['human']}

  def __init__(self):
    self.action_space = Discrete(2)
    self.observation_space = Box(low=np.array([0]), high=np.array([10]))
    self.state = draw_num()

  def step(self, action):
    # Execute one time step within the environment
    reward = 0
    done = False
    oldNum = self.state
    #Select action:
    #Action (0): go down
    #Action(1): go
    if action == 1:
        self.state += 1
    else:
        self.state += -1

    if self.state > oldNum:
        reward = 1
    else:
        reward = -1

    #Apply Noise here (maybe)
    info = {}

    return self.state, reward, done, info

def _reset(self):
    self.state = draw_num()
    return self.state

def render(self):
      pass

def close(self):
    pass
```

RedTachyon, 2021-11-06:
0.9.4 is extremely ancient, don't use it, there is just about zero chance that anyone in the world can give good advice on its usage. I'd recommend switching to *at least* 0.19, and ideally 0.21

As for your code - `reset`, `render`, `close` and such methods have to be methods of the environment, the same way that `step` is. And it should be `reset` and not `_reset`. So the class code should be more like:

```python
class FooEnv(gym.Env):
  metadata = {'render.modes': ['human']}

  def __init__(self):
    self.action_space = Discrete(2)
    self.observation_space = Box(low=np.array([0]), high=np.array([10]))
    self.state = draw_num()

  def step(self, action):
    # Execute one time step within the environment
    reward = 0
    done = False
    oldNum = self.state
    #Select action:
    #Action (0): go down
    #Action(1): go
    if action == 1:
        self.state += 1
    else:
        self.state += -1

    if self.state > oldNum:
        reward = 1
    else:
        reward = -1

    #Apply Noise here (maybe)
    info = {}

    return self.state, reward, done, info

  def reset(self):
    self.state = draw_num()
    return self.state

  def render(self):
      pass

  def close(self):
    pass
```

Closed 2021-11-14.

Thread 2560 (2022-01-13):

How do i display the super mario environment on google colab?

flowerboy9, 2022-01-13:
```
done = True
for step in range(5000):
  if done:
    env.reset()
    state, reward, done, info = env.step(env.action_space.sample())
  env.render()

env.close()
```

when run this code i get this error

`AttributeError        Traceback (most recent call last)
/usr/local/lib/python3.7/dist-packages/pyglet/__init__.py in __getattr__(self, name)
    328         try:
--> 329             return getattr(self._module, name)
    330         except AttributeError:

AttributeError: 'NoneType' object has no attribute 'key'

During handling of the above exception, another exception occurred:

NoSuchDisplayException                    Traceback (most recent call last)
11 frames
/usr/local/lib/python3.7/dist-packages/pyglet/canvas/xlib.py in __init__(self, name, x_screen)
    121         self._display = xlib.XOpenDisplay(name)
    122         if not self._display:
--> 123             raise NoSuchDisplayException('Cannot connect to "%s"' % name)
    124
    125         screen_count = xlib.XScreenCount(self._display)

NoSuchDisplayException: Cannot connect to "None"`

how do i display the other screen that displays the game i have tried using matplotlib along with all the necc. imports but its very slow and take a long time to complete the above steps so i had to reduce it to 5000 but still it took a long time in this youtube video this person doesnt install and extra packages and the rendering screen appears how do i do that? if its not possible on colab then how do i do it on jupyter notebook. this is the video [https://www.youtube.com/watch?v=2eeYqJ0uBKE&t=941s](url)

msaroufim, 2022-01-14:
Google collab doesn't have a monitor associated with it, so what you need to do is record the agent playing and then watch

# Record agent

```python
import gym
from gym import wrappers

env = gym.make('SpaceInvaders-v0')
env = wrappers.Monitor(env, "./gym-results", force=True)
env.reset()
for _ in range(1000):
    action = env.action_space.sample()
    observation, reward, done, info = env.step(action)
    if done: break
env.close()
```

# Watch agent

```python
import io
import base64
from IPython.display import HTML

video = io.open('./gym-results/openaigym.video.%s.video000000.mp4' % env.file_infix, 'r+b').read()
encoded = base64.b64encode(video)
HTML(data='''
    <video width="360" height="auto" alt="test" controls><source src="data:video/mp4;base64,{0}" type="video/mp4" /></video>'''
.format(encoded.decode('ascii')))
```

Probably worth someone building Google collab for RL - maybe @simoninithomas has put some more thought into this

flowerboy9, 2022-01-15:
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

okay thank you sir i will try it right now also how what should i do on jupyter lab to make the rendering screen pop up cause when i run that above code(the one i pasted) on jupyter lab as well it throws an error

jkterry1, 2022-01-19:
(closing since the question is answered, but obviously please feel free to have a discussion)

engbJapan, 2022-09-22:
I have done real-time graphics of "Moon Landing, Xeyes, Xterm" in ColabNoteBook.
It provides an X desktop with a NOVNC viewer embedded inside ColabNotebook.

see below
NoteBook:
https://github.com/engbJapan/Programming/blob/main/VNCinCellJapan.ipynb
Youtube:
https://youtu.be/CihGimhrclQ
Qiita:
https://qiita.com/engbJapan/items/f39b2f927de290e6a65f

Closed 2022-01-19.

Thread 2580 (2022-01-28):

Creating gym style environment from real device

PeterPirog, 2022-01-28:
Hello

I would like to create RL controler for [temperature calibrated bath](https://isotech.co.uk/products/fluidized-furnace-model-875/) but the problem is how te create simulator for it.
RL training directly from real device  states has no sense because time of device stabilization is very very long.

action space is: 0 and 1 (heater off or on)
state: [enviroment temperature, bath temperature]
reward: abs( bath temperature - set temperature)
goal: stabilize temperature as quick as possible

I have reecorded data
 action: recorded values if heater is on or off
 state: bath temperatures

Problem is in fact that delay betwen action and state is about 80 seconds.  I tested that device modeling as lowpas filter (inifinite impulse response IIR) works well, equation has form:

Y(n)=a1 x Y(n-1)+a2 x Y(n-2)+...+ak x Y(n-k)+b0 x X(n)+b1 x Y(n-1)+...+bk x X(n-k)

The question is: Does anybody know way to prepare easily  device simulator such type of device (lowpass filter with long delay)?
Now I try to find filter coefficients with excel solver  ut this method is not easy to modify hyperparameters of model.

pseudo-rnd-thoughts, 2022-02-28:
Hi,

Normally in reinforcement learning, we are trying to maximise our reward over time, therefore, reward=abs(bath temperature - set temperature) would reward the agent the larger the difference in temperature.
This can be fixed easily with reward= - abs(bath temperature - set temperature)
In addition, I would add to your state the set temperature as otherwise, the agent has no idea what is the correct temperature to change to is

If you know how the environment and bath temperature will change after N seconds of the heater turned off or on then this is possible to implement as a gym environment. Is this what the Y function does? Sorry I don't understand it

jkterry1, 2022-02-28:
I'm going to close this issue, but you guys are free to keep discussing :)

PeterPirog, 2022-03-01:
@pseudo-rnd-thoughts , Thank you for your suggestions, of course it should be negative values to optimize reward,  and set temperature should be a part of state vector.

I consider to use [SysIdentPy](https://sysidentpy.org/) library as a core of environment simulator. Now I collected data from physical device (calibration bath) ad I try to use it.

pseudo-rnd-thoughts, 2022-03-02:
You should be able to create an openai gym that is basically a wrapper around the SysIdentPy library.
On reset, using some random initial value for the all of the state variables
At each time step, take a certain time step in the environment simulator (e.g., 0.5 second, 1 second, 5 second), updating the state

Do you have anymore questions?

PeterPirog, 2022-03-03:
@pseudo-rnd-thoughts  Thank You for the suggestions, I will try it.

Closed 2022-03-04.

Thread 2603 (2022-02-08):

[Proposal] Adding Constant variable for different Environments available within Gym

gauranshkumar, 2022-02-08:
### Proposal
Create a simple constant file with storing already available environment. Something like this
```python3
from gym.environments import CurrentEnv
print(CurrentEnv.CARTPOLEV1)
```
Expected Output:
```
'CartPole-v1'
```
### Motivation
I am new to the Gym and the major Issue that frustrates me is to change the name of different environments by constantly looking at the [gym envs](https://gym.openai.com/envs) page. In general workflow we know the name of the environments but just to get the exact name of the env we need to switch to docs. So it would be really great to just put a constant in the API itself as described above.

### Pitch

We will be needing to add a file in the environment sub-module and store all the currently available environments in there.

### Alternatives

We can also add a simple class instead of the file in the environment.py and this too will work

### Additional context

I will be happy to work on this and would create a PR if this issue gets validated.

### Checklist

- [x] I have checked that there is no similar [issue](https://github.com/openai/gym/issues) in the repo (**required**)

ikamensh, 2022-02-09:
So you suggest to have an Enum that would have autocompletion in IDE for available environments, right?

gauranshkumar, 2022-02-09:
Yes exactly @ikamensh, It would be very Intuitive to create the environments with this feature

RedTachyon, 2022-02-22:
So I'm not a huge fan of an enum/constants for that, it's another place where a name has to be maintained anyways. Maybe something that would help instead is an easily accessible list of registered environments? For example
```python
print(env.envs.ALL_ENVS)
# [ CartPole-v0, CartPole-v1, Pendulum-v1, ...]
```

Worth remembering that it is always possible to just import the specific env and instantiate it yourself with whatever parameters you need:
```python
from gym.envs.classic_control import CartPoleEnv
env = CartPoleEnv(...)
```

Closed 2022-05-23.

Thread 2676 (2022-03-09):

[Question] Failed to load XML file

t46, 2022-03-09:
### Question
Hi, thanks for contribution.

When trying to make an environment, it gives me a following error. Any suggestions?

```{python}
import gym
env = gym.make('HalfCheetah-v3')
```

```
Traceback (most recent call last):
  File "<stdin>", line 1, in <module>
  File "/usr/local/lib/python3.8/dist-packages/gym/envs/registration.py", line 676, in make
    return registry.make(id, **kwargs)
  File "/usr/local/lib/python3.8/dist-packages/gym/envs/registration.py", line 520, in make
    return spec.make(**kwargs)
  File "/usr/local/lib/python3.8/dist-packages/gym/envs/registration.py", line 140, in make
    env = cls(**_kwargs)
  File "/usr/local/lib/python3.8/dist-packages/gym/envs/mujoco/half_cheetah_v3.py", line 152, in __init__
    mujoco_env.MujocoEnv.__init__(self, xml_file, 5)
  File "/usr/local/lib/python3.8/dist-packages/gym/envs/mujoco/mujoco_env.py", line 54, in __init__
    self.model = mujoco_py.load_model_from_path(fullpath)
  File "cymj.pyx", line 175, in mujoco_py.cymj.load_model_from_path
Exception: Failed to load XML file: /usr/local/lib/python3.8/dist-packages/gym/envs/mujoco/assets/half_cheetah.xml. mj_loadXML error: b"Error: alternative specification error 'yaxis too small' in site 0\nObject name = track, id = 0, line = 55, column = 7"
```

half_cheetah.xml
```
<!-- Cheetah Model

    The state space is populated with joints in the order that they are
    defined in this file. The actuators also operate on joints.

    State-Space (name/joint/parameter):
        - rootx     slider      position (m)
        - rootz     slider      position (m)
        - rooty     hinge       angle (rad)
        - bthigh    hinge       angle (rad)
        - bshin     hinge       angle (rad)
        - bfoot     hinge       angle (rad)
        - fthigh    hinge       angle (rad)
        - fshin     hinge       angle (rad)
        - ffoot     hinge       angle (rad)
        - rootx     slider      velocity (m/s)
        - rootz     slider      velocity (m/s)
        - rooty     hinge       angular velocity (rad/s)
        - bthigh    hinge       angular velocity (rad/s)
        - bshin     hinge       angular velocity (rad/s)
        - bfoot     hinge       angular velocity (rad/s)
        - fthigh    hinge       angular velocity (rad/s)
        - fshin     hinge       angular velocity (rad/s)
        - ffoot     hinge       angular velocity (rad/s)

    Actuators (name/actuator/parameter):
        - bthigh    hinge       torque (N m)
        - bshin     hinge       torque (N m)
        - bfoot     hinge       torque (N m)
        - fthigh    hinge       torque (N m)
        - fshin     hinge       torque (N m)
        - ffoot     hinge       torque (N m)

-->
<mujoco model="cheetah">
  <compiler angle="radian" coordinate="local" inertiafromgeom="true" settotalmass="14"/>
  <default>
    <joint armature=".1" damping=".01" limited="true" solimplimit="0 .8 .03" solreflimit=".02 1" stiffness="8"/>
    <geom conaffinity="0" condim="3" contype="1" friction=".4 .1 .1" rgba="0.8 0.6 .4 1" solimp="0.0 0.8 0.01" solref="0.02 1"/>
    <motor ctrllimited="true" ctrlrange="-1 1"/>
  </default>
  <size nstack="300000" nuser_geom="1"/>
  <option gravity="0 0 -9.81" timestep="0.01"/>
  <asset>
    <texture builtin="gradient" height="100" rgb1="1 1 1" rgb2="0 0 0" type="skybox" width="100"/>
    <texture builtin="flat" height="1278" mark="cross" markrgb="1 1 1" name="texgeom" random="0.01" rgb1="0.8 0.6 0.4" rgb2="0.8 0.6 0.4" type="cube" width="127"/>
    <texture builtin="checker" height="100" name="texplane" rgb1="0 0 0" rgb2="0.8 0.8 0.8" type="2d" width="100"/>
    <material name="MatPlane" reflectance="0.5" shininess="1" specular="1" texrepeat="60 60" texture="texplane"/>
    <material name="geom" texture="texgeom" texuniform="true"/>
  </asset>
  <worldbody>
    <light cutoff="100" diffuse="1 1 1" dir="-0 0 -1.3" directional="true" exponent="1" pos="0 0 1.3" specular=".1 .1 .1"/>
    <geom conaffinity="1" condim="3" material="MatPlane" name="floor" pos="0 0 0" rgba="0.8 0.9 0.8 1" size="40 40 40" type="plane"/>
    <body name="torso" pos="0 0 .7">
      <camera name="track" mode="trackcom" pos="0 -3 0.3" xyaxes="1 0 0 0 0 1"/>
      <joint armature="0" axis="1 0 0" damping="0" limited="false" name="rootx" pos="0 0 0" stiffness="0" type="slide"/>
      <joint armature="0" axis="0 0 1" damping="0" limited="false" name="rootz" pos="0 0 0" stiffness="0" type="slide"/>
      <joint armature="0" axis="0 1 0" damping="0" limited="false" name="rooty" pos="0 0 0" stiffness="0" type="hinge"/>
      <geom fromto="-.5 0 0 .5 0 0" name="torso" size="0.046" type="capsule"/>
      <geom axisangle="0 1 0 .87" name="head" pos=".6 0 .1" size="0.046 .15" type="capsule"/>
      <!-- <site name='tip'  pos='.15 0 .11'/>-->
      <body name="bthigh" pos="-.5 0 0">
        <joint axis="0 1 0" damping="6" name="bthigh" pos="0 0 0" range="-.52 1.05" stiffness="240" type="hinge"/>
        <geom axisangle="0 1 0 -3.8" name="bthigh" pos=".1 0 -.13" size="0.046 .145" type="capsule"/>
        <body name="bshin" pos=".16 0 -.25">
          <joint axis="0 1 0" damping="4.5" name="bshin" pos="0 0 0" range="-.785 .785" stiffness="180" type="hinge"/>
          <geom axisangle="0 1 0 -2.03" name="bshin" pos="-.14 0 -.07" rgba="0.9 0.6 0.6 1" size="0.046 .15" type="capsule"/>
          <body name="bfoot" pos="-.28 0 -.14">
            <joint axis="0 1 0" damping="3" name="bfoot" pos="0 0 0" range="-.4 .785" stiffness="120" type="hinge"/>
            <geom axisangle="0 1 0 -.27" name="bfoot" pos=".03 0 -.097" rgba="0.9 0.6 0.6 1" size="0.046 .094" type="capsule"/>
          </body>
        </body>
      </body>
      <body name="fthigh" pos=".5 0 0">
        <joint axis="0 1 0" damping="4.5" name="fthigh" pos="0 0 0" range="-1 .7" stiffness="180" type="hinge"/>
        <geom axisangle="0 1 0 .52" name="fthigh" pos="-.07 0 -.12" size="0.046 .133" type="capsule"/>
        <body name="fshin" pos="-.14 0 -.24">
          <joint axis="0 1 0" damping="3" name="fshin" pos="0 0 0" range="-1.2 .87" stiffness="120" type="hinge"/>
          <geom axisangle="0 1 0 -.6" name="fshin" pos=".065 0 -.09" rgba="0.9 0.6 0.6 1" size="0.046 .106" type="capsule"/>
          <body name="ffoot" pos=".13 0 -.18">
            <joint axis="0 1 0" damping="1.5" name="ffoot" pos="0 0 0" range="-.5 .5" stiffness="60" type="hinge"/>
            <geom axisangle="0 1 0 -.6" name="ffoot" pos=".045 0 -.07" rgba="0.9 0.6 0.6 1" size="0.046 .07" type="capsule"/>
          </body>
        </body>
      </body>
    </body>
  </worldbody>
  <actuator>
    <motor gear="120" joint="bthigh" name="bthigh"/>
    <motor gear="90" joint="bshin" name="bshin"/>
    <motor gear="60" joint="bfoot" name="bfoot"/>
    <motor gear="120" joint="fthigh" name="fthigh"/>
    <motor gear="60" joint="fshin" name="fshin"/>
    <motor gear="30" joint="ffoot" name="ffoot"/>
  </actuator>
</mujoco>
```

vwxyzjn, 2022-03-11:
Hey I can't reproduce this:

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

t46, 2022-03-11:
Thank you for the quick response. I'm sorry I was not clear. I updated the system info.

**Code example**
Running command below reproduces the result.
```
docker build --platform=linux/amd64 . -t gym
docker run -it -v ~/.mujoco/:/root/.mujoco --name gym --platform linux/amd64 gym
python
>>> import gym
>>> env = gym.make('HalfCheetah-v3')
```
Dockerfile is below.
```
FROM python:3.8-slim-buster
RUN apt update && apt install -y \
         vim \
         git \
         build-essential \
         patchelf \
         libosmesa6-dev \
         libgl1-mesa-glx \
         libglfw3
RUN ln -s /usr/lib/x86_64-linux-gnu/libGL.so.1 /usr/lib/x86_64-linux-gnu/libGL.so
RUN pip3 install -U \
         'mujoco-py<2.2,>=2.1' \
         gym
ENV LD_LIBRARY_PATH=/root/.mujoco/mujoco210/bin/
CMD ["bash"]
```

**System Info**
   * Macbook Pro / Apple M1 Pro / macOS Monterey 12.0.1
   * docker version
     ```
      Client:
       Cloud integration: v1.0.22
       Version:           20.10.12
       API version:       1.41
       Go version:        go1.16.12
       Git commit:        e91ed57
       Built:             Mon Dec 13 11:46:56 2021
       OS/Arch:           darwin/arm64
       Context:           default
       Experimental:      true

      Server: Docker Desktop 4.5.0 (74594)
       Engine:
        Version:          20.10.12
        API version:      1.41 (minimum version 1.12)
        Go version:       go1.16.12
        Git commit:       459d0df
        Built:            Mon Dec 13 11:43:07 2021
        OS/Arch:          linux/arm64
        Experimental:     false
       containerd:
        Version:          1.4.12
        GitCommit:        7b11cfaabd73bb80907dd23182b9347b4245eb5d
       runc:
        Version:          1.0.2
        GitCommit:        v1.0.2-0-g52b36a2
       docker-init:
        Version:          0.19.0
        GitCommit:        de40ad0
     ```
 * Python 3.8.12

### Checklist

- [x] I have checked that there is no similar [issue](https://github.com/openai/gym/issues) in the repo (**required**)

TianhongDai, 2022-05-20:
I also have the same error.

jkterry1, 2022-05-23:
PR #2762 is about to be merged, introducing V4 MuJoCo environments using new bindings and a dramatically newer version of the engine. If this issue still persists with the V4 ones, please create a new issue for it.

Closed 2022-05-23.

Thread 2677 (2022-03-09):

[Bug Report] Can't close rendered window from Jupyter notebook

Takher, 2022-03-09:
When running CartPole-v1 using the starter code from https://gym.openai.com/ within a Jupyter notebook a window opens up and runs the CartPole game but then doesn't close. I have to manually "Force quit" the window, and this leads to the kernel crashing.

**Code example (taken from directly from  https://gym.openai.com/)**
```python
import gym
env = gym.make("CartPole-v1")
observation = env.reset()
for _ in range(1000):
  env.render()
  action = env.action_space.sample() # your agent here (this takes random actions)
  observation, reward, done, info = env.step(action)

  if done:
    observation = env.reset()
env.close()
```

**System Info**
 * Installed gym==0.21.0 using conda 4.11.0 using `conda install 'gym[all]'`
 * Running macOS Monterey 12.1 on an arm-based MacBook Pro
 * Python 3.9.10

jkterry1, 2022-03-11:
#2684 should fix this

modestasgrz, 2023-01-30:
Still freezes on Mac (M1 Pro) using Jupyter Notebook, and then Kernel dies

pseudo-rnd-thoughts, 2023-01-30:
@modestasgrz  Are you using the same code as above? I suspect this might be a pygame issue rather than Gymnasium

Faugermire, 2023-03-12:
I am running into this issue as well. The cartpole env will run through its episodes, but will then lock up when `env.close()` is called. I have to force quit the python app, which then causes the kernel to crash.

I have a Macbook M2 Max, using Jupyter Notebook.

Here is the code:

`episodes = 5

for episode in range(episodes):
    state = env.reset()
    done = False
    score = 0

    while not done:
        env.render()
        action = env.action_space.sample()
        n_state, reward, done, info = env.step(action)
        score += reward
    print(f'Episode: {episode}, Score: {score}')

env.close()`

Here are my imports:

`import os
import gym
from stable_baselines3 import PPO`

Here are my installs:

`%conda install -c conda-forge stable-baselines3
%conda install -c conda-forge gym
%conda install -c conda-forge gym-classic_control`

I am using Anaconda, and am running jupyter from inside a conda env. I have tried using different envs, however, I get the same results.

Here is the output of `conda info`:

`active environment : rein-conda-venv
active env location : /Users/bruh/opt/anaconda3/envs/rein-conda-venv
shell level : 1
user config file : /Users/bruh/.condarc
populated config files : /Users/bruh/.condarc
conda version : 23.1.0
conda-build version : 3.22.0
python version : 3.9.13.final.0
virtual packages : __archspec=1=x86_64
                              __osx=10.16=0
                              __unix=0=0
base environment : /Users/bruh/opt/anaconda3  (writable)
conda av data dir : /Users/bruh/opt/anaconda3/etc/conda
conda av metadata url : None
channel URLs : https://repo.anaconda.com/pkgs/main/osx-64
                          https://repo.anaconda.com/pkgs/main/noarch
                          https://repo.anaconda.com/pkgs/r/osx-64
                          https://repo.anaconda.com/pkgs/r/noarch
package cache : /Users/bruh/opt/anaconda3/pkgs
                             /Users/bruh/.conda/pkgs
envs directories : /Users/bruh/opt/anaconda3/envs
                              /Users/bruh/.conda/envs
platform : osx-64
user-agent : conda/23.1.0 requests/2.28.1 CPython/3.9.13 Darwin/22.3.0 OSX/10.16
UID:GID : 501:20
netrc file : None
offline mode : False`

MesaJonathan, 2023-07-03:
Was this ever figured out because I am currently running into the same issue

Closed 2022-03-11.

Thread 2689 (2022-03-12):

Problem retraining PPO1 model and using Tensorflow with SB2

durantagre, 2022-03-12:
### Question

Dear altruists, I am new at **stable baselines and RL**. I am trying to retrain my previously trained PPO1 model as like it will start learning from where it was left in the previous training. What I am trying to do is :
1. loading my previously trained model from my computer and then re-train it from the point it ended it’s last training. For that, I am loading my previously saved model inside  policy_fn() and I am giving policy_fn as parameter inside pposgd_simple.learn() method. It shows error "***ValueError: At least two variables have the same name: pi/obfilter/count***"

Also, I am unsure of whether it starts the training from the previous ending point or whether it started the training from the very beginning (when it trains correctly in a different setting). Can anyone please help me directing the way to verify it. One option may be printing the model parameters, but I am unsure of it.

2. I am also trying to use **Tensorboard** to monitor my training. But when I run the training, the program says “***tensorboard_log=logger_path, TypeError: learn() got an unexpected keyword argument 'tensorboard_log'.***” My stable baselines version 2.10.2. I am attaching my entire code of training below. I would appreciate any suggestions from you. Thanks in advance.

def make_env(seed=None):
reward_scale = 1.0

rank = MPI.COMM_WORLD.Get_rank()
myseed = seed + 1000 * rank if seed is not None else None
set_global_seeds(myseed)
env = Env()

env = Monitor(env, logger_path, allow_early_resets=True)

env.seed(seed)
if reward_scale != 1.0:
from baselines.common.retro_wrappers import RewardScaler

env = RewardScaler(env, reward_scale)
return env

def train(num_timesteps, path=None):

from baselines.ppo1 import mlp_policy, pposgd_simple

sess = U.make_session(num_cpu=1)
sess.__enter__()

def policy_fn(name, ob_space, ac_space):
	policy = mlp_policy.MlpPolicy(name=name, ob_space=ob_space, ac_space=ac_space,
			hid_size=64, num_hid_layers=3)
	saver = tf.train.Saver()
	if path is not None:
		print("Tried to restore from ", path)
		U.initialize()
		saver.restore(tf.get_default_session(), path)
		saver2 = tf.train.import_meta_graph('/srcs/src/models/model1.meta')
		model = saver.restore(sess,tf.train.latest_checkpoint('/srcs/src/models/'))
		#return policy
		return saver2

env = make_env()

pi = pposgd_simple.learn(env, policy_fn,
max_timesteps=num_timesteps,
timesteps_per_actorbatch=1024,
clip_param=0.2, entcoeff=0.0,
optim_epochs=10,
optim_stepsize=5e-5,
optim_batchsize=64,
gamma=0.99,
lam=0.95,
schedule='linear',
tensorboard_log=logger_path,
#tensorboard_log="./ppo1_tensorboard/",
)
env.env.plotSave()
saver = tf.train.Saver(tf.all_variables())
saver.save(sess, '/models/model1')
return pi

def main():
logger.configure()
path_ = "/models/model1"
train(num_timesteps=409600, path=path_)
if __name__ == '__main__':
rank = MPI.COMM_WORLD.Get_rank()
logger_path = None if logger.get_dir() is None else os.path.join(logger.get_dir(), str(rank))
main()

jkterry1, 2022-03-13:
Hey, SB2 is not really maintained and hasn't been for a very long time. If you switch to SB3 (the current version), you'll be fine. Gym has had some breaking changes changes that SB2 hasn't dealt with supporting.

durantagre, 2022-03-13:
Hi jkterry1, Thank you for your reply. I have migrated to SB3. But this solves neither of my problems. Still both of the errors persist!

jkterry1, 2022-03-13:
Could you please create the issue in SB3? I believe your problem is there not with Gym

Closed 2022-03-13.

Thread 2825 (2022-05-19):

[Bug Report] New render API not working

trigaten, 2022-05-19:
From [this documentation page](https://www.gymlibrary.ml/content/api/), running the following yields an error.

```python
import gym
env = gym.make("LunarLander-v2", render_mode="human")
```

```
Traceback (most recent call last):
  File "<stdin>", line 1, in <module>
  File "/opt/anaconda3/envs/vid/lib/python3.9/site-packages/gym/envs/registration.py", line 503, in make
    env = cls(**_kwargs)
TypeError: __init__() got an unexpected keyword argument 'render_mode'
```

pseudo-rnd-thoughts, 2022-05-19:
That documentation update seems a bit early, that PR is still in progress and will be merged soon https://github.com/openai/gym/pull/2671
For now, please remove the `render_mode` parameter

RedTachyon, 2022-05-20:
Do we have any proper versioning of the documentation repo? It seems the built version is `master`, and new updates are also pushed to `master`, which isn't necessarily a great idea. We should probably do it like most other libraries, where you have a docs page for the last stable release, and separate docs for `master`

younik, 2022-05-20:
Hello @trigaten,
https://github.com/Farama-Foundation/gym-docs/pull/124 was the pull to update documentation for https://github.com/openai/gym/pull/2671; the updated snippets will work when https://github.com/openai/gym/pull/2671 is merged.
Sorry for not pointing this out clearly. It would be nice to have a mechanism as @RedTachyon pointed out or you can reverse https://github.com/Farama-Foundation/gym-docs/pull/124 and merge it only after https://github.com/openai/gym/pull/2671
Thanks

trigaten, 2022-05-23:
@RedTachyon @younik How exactly should versioned documentation work?
Would we have a branch for each new gym version and have the site build from the most up to date branch?
When would master be pushed to?

RedTachyon, 2022-05-24:
So I'm not actually sure what the industry standard is of doing this, but the way I'd envision it is:
- Branch "stable" for the latest release (and the default build target for the website)
- Branch "master" for incremental updates (and maybe as a build target under a subdomain or under a specific path, so that we can access it, but it's not the default that people see)
- When we update the main library from version X to Y, the current "stable" gets pushed to a new branch named vX, and current master gets pushed to "stable"

AhmedTechOffical, 2022-06-06:
Hi, I got a similar problem but instead, its saying that I need to put render_mode = human and I did, yet its telling me I need to do that, Any help please?
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

DDDOH, 2022-06-11:
Before the released package can catch up with the current document, any instructions on how to use the old render API? Or when will a new package will get published to match the current document?

younik, 2022-06-11:
> Before the released package can catch up with the current document, any instructions on how to use the old render API? Or when will a new package will get published to match the current document?
>
> or maybe I'll try building from source before the release of a new version

Hello, if you want to use the old API and you don't know how it works, you can follow old tutorials, like [this one](https://blog.paperspace.com/getting-started-with-openai-gym/)

DDDOH, 2022-06-11:
Thanks a lot, that's a good one! Looking forward to the brand new API anyway!

BlueskyFR, 2022-06-12:
May I ask why this issue was closed? The case where someone uses an other version than the master branch (so more than 99% of the cases) is still not handled AFAIK

DDDOH, 2022-06-12:
It's mainly caused by document and code unmatching. be a little bit patient bro.

Closed 2022-06-02.

Thread 2989 (2022-07-24):

Rendering a single frame and 'human' with MuJoCo

tudorjnu, 2022-07-24:
Hello,

I have a problem with the new renderer when combined with MuJoCo.

I am creating a new environment that uses an image-based observation which works well with `render_mode="single_rgb_array"`. However, I would like to be able to visualise the model with MuJoCo's interactive renderer which currently doesn't seem possible.

Any current workarounds or ideas on how this can be accomplished? Thank you!

Additionally, a possible bug. When rendering with a greater image size than 500, I get the following error:
```bash
RuntimeError: Offscreen rendering not supported
```

pseudo-rnd-thoughts, 2022-07-24:
Would you be able to provide an example script to test with?
An example that doesn't work and an example of what you would like to run

tudorjnu, 2022-07-25:
No problem!

Let's take `Humanoid-v4` as an example. A basic gym loop would be the following:
```python
import gym

env = gym.make('Humanoid-v4')
obs = env.reset()
for _ in range(1000):
    action = env.action_space.sample()
    obs, reward, done, info = env.step(action)
    env.render()
```

Now, let's assume that in the scene, there is a camera in the scene that should give the observation space for the agent. A problem will raise from this as I cannot get the single RGB array from the scene while still being able to watch the scene through MuJoCo's renderer.

A partial solution is to show the scene by showing the images, such as:

```python
import gym
import cv2

env = gym.make('Humanoid-v4', render_mode="single_rgb_array")
obs = env.reset()
for _ in range(1000):
    action = env.action_space.sample()
    obs, reward, done, info = env.step(action)
    image = env.render()
    cv2.imshow("image", image)
    cv2.waitKey(1)
```

Is there any solution in which both are working?

Regarding the other issue. To replicate. just set the `height` and `width` greater than 500:
```python
import gym
import cv2

env = gym.make('Humanoid-v4', render_mode="single_rgb_array",
               width=600, height=600)
obs = env.reset()
for _ in range(1000):
    action = env.action_space.sample()
    obs, reward, done, info = env.step(action)
    image = env.render()
    cv2.imshow("image", image)
    cv2.waitKey(1)
```

, which throws the following error:
```
RuntimeError: Offscreen rendering not supported
```

The latter seems to be an issue more related to `MuJoCo` itself.

younik, 2022-07-26:
@tudorjnu If I understood correctly, you want to use `human` mode and `single_rgb_array` simultaneously.
We deprecated this possibility since changing the mode on-the-fly causes problems with other environments.

For your case, I suggest to initialize the env with `single_rgb_array` and then using this Wrapper https://github.com/openai/gym/blob/master/gym/wrappers/human_rendering.py

In this way, using the Wrapper you will see the human rendering, and when you need you can call gather an RGB frame from the original env.

tudorjnu, 2022-07-29:
Yup, that is exactly what I was trying to do.

It seems that when I wrap the environment it renders a black screen only.

younik, 2022-07-29:
> Yup, that is exactly what I was trying to do.
>
> It seems that when I wrap the environment it renders a black screen only.

You are right, this snippet is not working properly; @rodrigodelazcano @Markus28 do you have any idea why?

```python
import gym
from gym.wrappers import HumanRendering

env = HumanRendering(gym.make('Humanoid-v4', render_mode="single_rgb_array"))
env.reset()

for _ in range(100):
    env.step(env.action_space.sample())

env.close()
```

Markus28, 2022-07-29:
Yes, we are investigating it. It looks like something weird is happening in MuJoCo rendering. Opening a blank PyGame window (completely independently of what we do with the environment) will cause MuJoCo to render only black frames. Check out this snippet:

```python
import numpy as np
import gym
import pygame

env = gym.make("Ant-v4", render_mode="single_rgb_array")
env.reset()
env.render()

########## Comment out to compare #############
pygame.init()
pygame.display.init()
window = pygame.display.set_mode((259, 342))
########## Comment out to compare #############

for _ in range(500):
    _, _, done, _ = env.step(env.action_space.sample())
    print(np.max(env.render()))
    if done:
        env.reset()
```

We tried using osmesa instead of glfw but that didn't fix the problem. I guess this problem might be difficult to debug.

tudorjnu, 2022-07-31:
Ohh, that's a bummer. I will use the standard `cv2.imshow` for now.

In terms of the rendering, would it be possible in the case of MuJoCo, that the renderer from the wrapper would also be MuJoCo's renderer?  This is because it offers some extra functionality such as showing contact forces, increasing the speed and so on.

Markus28, 2022-07-31:
Nope I don’t think that will be possible. The new render API essentially forces us to choose one render mode during initialization, so we can’t really access human and rgb_array rendering of mujoco environments at the same time. The original idea behind the HumanRendering wrapper wasn’t actually to circumvent this, but to add human rendering to environments that don’t implement it natively, using their rgb_array renders.

tudorjnu, 2022-08-02:
Ohh I see. So the image-based environments would lose their native rendering capabilities.
Truthfully, this didn't work in the previous gym iterations, but I was hoping it would work in this one.

I would leave the issue open for the other two problems, the wrapper not rendering and the size >500 making the environment crash for now.

YouJiacheng, 2022-08-23:
Hi! I guess you just use this for visualization and debug purpose, thus the performance is not critical.
So you can create two exactly identical environments and `step` them identically. We can add a wrapper for this suggested by https://github.com/openai/gym/issues/3038#issuecomment-1223066846.

YouJiacheng, 2022-08-24:
"the size >500 making the environment crash", I guess size != 480(`DEFAULT_SIZE`) will crash in offscreen case:
https://github.com/openai/gym/blob/6e2e921b5faaa9c356f589e4e938e718824c7d4a/gym/envs/mujoco/mujoco_env.py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

https://github.com/openai/gym/blob/6e2e921b5faaa9c356f589e4e938e718824c7d4a/gym/envs/mujoco/mujoco_env.py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

That is - offscreen viewer(`RenderContextOffscreen`) need `width` and `height`, but `_get_viewer` use the `DEFAULT_SIZE`, while `read_pixels` use `width` and `height` passed in constructor(`__init__`)
https://github.com/openai/gym/blob/6e2e921b5faaa9c356f589e4e938e718824c7d4a/gym/envs/mujoco/mujoco_env.py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

pseudo-rnd-thoughts, 2022-08-24:
Would you want to make a PR to solve the issue

YouJiacheng, 2022-08-24:
Yes I can make a PR, but I'am not sure that is the root cause. I am trying to reproduce the problem locally, then I will make a PR.

YouJiacheng, 2022-08-24:
Bad news: it seems that this is not the root cause.

YouJiacheng, 2022-08-24:
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

I guess this problem might be related to some global state of GL...

pseudo-rnd-thoughts, 2022-09-12:
@YouJiacheng @tudorjnu Is this issue solved? If not, what is the remaining issue?

tudorjnu, 2022-09-12:
@pseudo-rnd-thoughts Can confirm that now rendering works with different image sizes.

Furthermore, wrapping the "rgb_arrray" environment in `HumanRendering` is not working still.

To clarify, the remaining issue is the one mentioned by @YouJiacheng one comment above, in which the renderer produces only black frames.

pseudo-rnd-thoughts, 2022-09-12:
Thanks @tudorjnu, @rodrigodelazcano (when you have time), could you see if this is an issue with our implementation or mujoco.

Closed 2022-10-25.

Thread 2999 (2022-07-27):

[Question] Clarification on Pendulum Coordinate System

shivaniraochepuri21, 2022-07-27:
### Question

The pendulum coordinate system is not clear, and the diagram mentioned in the comments of pendulum.py is not available in the master branch as far as I can see. Could you please clarify if theta is positive clockwise or anti-clockwise? When I test the Pendulum-v1 environment it seems to be positive anti-clockwise, but the image in assets is clockwise. Do correct me. Thanks.

RedTachyon, 2022-07-27:
I beg you, use the "title" field the way it's intended, and put the content in the... content. Put at least a modicum of effort into asking the question if you want someone to answer it.

pseudo-rnd-thoughts, 2022-07-28:
In the docstring for Pendulum it notes
```
    The diagram below specifies the coordinate system used for the implementation of the pendulum's
    dynamic equations.

    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

    -  `x-y`: cartesian coordinates of the pendulum's end in meters.
    - `theta` : angle in radians.
    - `tau`: torque in `N m`. Defined as positive _counter-clockwise_.
```

Therefore, Im assuming that `tau` will be influenced by `theta` and so it is "positive counter-clockwise" (ant-clockwise) so you are most likely correct

vincentzhang, 2022-07-30:
`theta` is indeed positive counter-clockwise. It follows right-hand rule:
1. x axis points right and y axis points up, so the axis of rotation is z-axis and it points away from screen toward the viewer.
2. positive rotation is counter-clockwise around the axis of rotation.

See this for an illustration: https://www.evl.uic.edu/ralph/508S98/gif/rightx.gif

shivaniraochepuri21, 2022-08-02:
Thank you @vincentzhang  and @pseudo-rnd-thoughts. Counterclockwise seems correct. Here, the upright position is considered as 0 degrees. Assuming no friction at the hinge, how to obtain/derive the dynamic equations considered in the pendulum.py environment? which are as follows:

state = [theta, theta_dot]
d(theta) = theta_dot
d(theta_dot) = (3*g / 2*l) * sin(theta) + (3*u / m*l**2)

We may have to use lagrangian but I am not able to obtain the equation considered in the gym pendulum environment. Here is what I did to derive the equations. Please correct me anywhere.

let m be the mass, l be the length of the pendulum
let x,y be the coordinates of the free end of the pendulum, theta is the angle made by the free end in counter-clockwise direction about the fixed end. Let M be the moment of inertia about the fixed end of the pendulum which is (1/3)*m*l**2

Then, x = l * sin(theta), y = l * cos(theta)

Lagrangian L = 1/2 * m * v**2 + 1/2 * M * theta_dot **2 + PE

As the pendulum is going toward its equilibrium position (180 degrees) from the initial position (0 degrees), work done decreases as y decreases. So PE is Positive and is equal to m* g * l * cos(theta)

and v = (d/dt)(x)**2 + (d/dt)(y)**2

Using the euler-lagrangian equation: (do correct if anything is wrong)
d/dt [(d/d theta_dot) (L)] - (d/d theta) (L) = u ----- eq (1)

I obtained this:
L = (2/3) * m * l**2 * theta_dot**2 + m*g*l*cos(theta)

from eq (1), we get theta_dot as:
theta_dot = 3u/(4ml**2) - 3g*sin(theta)/(4 * l)

Sorry about the possible inconsistency in notation. I am doubtful about the PE but either way I don't get the equation same as the one in gym. Please help me with this.

Thanks IA

RedTachyon, 2022-08-02:
I went through the math in Pendulum like... a year ago? Anyways, it checked out, it's possible you'll find my derivation somewhere in old issues on this repo, though I'm not sure if I put it here in its entirety. I don't think I needed to use a Lagrangian, just regular solid body mechanics, but I don't have the capacity right now to go through your derivation. If you triple-check it and are confident that there's an issue with the implementation, please write it up with LaTeX syntax/rendering so that it's easier to parse, and I can go through it again.

One potential problem off the top of my head: L = T - V, but in your post, you add the potential energy. It might be a matter of the sign of the potential energy though.

shivaniraochepuri21, 2022-08-02:
Thanks @RedTachyon I wasn't able to find relevant information in the old issues.

I added the potential energy in the lagrangian because, originally, L = KE - PE, here PE = m*g*l*cos(theta + 180) = - mlg cos(theta), therefore, finally you add the mlg*cos(theta) term in the lagrangian. Here, I am measuring the angle theta from the equilibrium postion.

I am still not sure how to consider the potential energy and its reference (and if the equilibrium position has anything to do with it). Could you please provide an insight on this? Will update the equations in LaTex anyway soon, so u can go through them and correct me if I am wrong.

Thanks IA

shivaniraochepuri21, 2022-08-02:
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

updated the derivation in previous comment. Please help me find the correct dynamics for this system. Thank you

shivaniraochepuri21, 2022-08-08:
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

I am implementing a model predictive controller with casadi for the pendulum system, and the evolution of state as the system tries to reach the target state is a decaying oscillation with the system I mentioned. I cannot see such a behavior with the dynamics equation implemented in gym (well, maybe that's not necessary, but it confirms the suggested dynamics are correct; how do I verify if the one provided in gym is correct? It would be great if someone can provide an old doc or method as to how we got the equation in gym). Keeping all the parameters, and changing just the equation, I can find the solution with the suggested dynamics but not with the one implemented in gym. I believe given how extensively useful gym is, the equation or some other settings/assumptions need to be looked at in Pendulum-v1 env, or please correct me if I am wrong. An RL agent may be trained for any non-linear equation of that form to do well in a test run, but MPC (and some optimal control methods, online methods) need the right model. Thanks IA

RedTachyon, 2022-08-31:
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

I did the math again, and it checks out again. Uploading the derivation in case of future questions. One thing I didn't properly check is how we actually represent the angle, but it's definitely something like theta, pi - theta, etc. But if this were wrong, the problem would be very apparent (the system have an equilibrium at the top or to either side)

@jkterry1 This can probably be closed, there might be a further discussion but I'm pretty sure there's no critical bugs here.

ReHoss, 2025-01-24:
@RedTachyon
Hi there, according to the literature (see H. K. Khalil - Nonlinear Systems (2001)), the motion is given by

$\ddot{\theta} = - \frac{g}{l} \sin ( \theta )$

I don't get why there is no negative sign in the implementation of the acceleration $\ddot{\theta}$.
See this code snippet (generated by ChatGPT), adding the - sign gives the right expected physical behaviour...

```python
import numpy as np
import matplotlib.pyplot as plt
from scipy.integrate import solve_ivp

# Define constants
g = 9.81  # Gravitational acceleration (m/s^2)
l = 1.0   # Length of pendulum (m)
m = 1.0   # Mass of pendulum (kg)
dt = 0.01  # Time step (s)

# External torque (constant for both systems)
def external_torque(t):
    return 0.0

def gym_pendulum_dynamics(t, y):
    theta, omega = y
    # Gym-like dynamics
    u = external_torque(t)
    dtheta_dt = omega
    domega_dt = (g / l * np.sin(theta) + u / (m * l**2))
    return [dtheta_dt, domega_dt]

def classical_pendulum_dynamics(t, y):
    theta, omega = y
    # Classical dynamics
    u = external_torque(t)
    dtheta_dt = omega
    domega_dt = (-g / l * np.sin(theta) + u / (m * l**2))
    return [dtheta_dt, domega_dt]

# Simulation parameters
time_span = (0, 10)  # Simulate for 10 seconds
t_eval = np.arange(0, 10, dt)  # Evaluation time points

# Initial conditions
initial_conditions = [1.6, 0.0]  # Start at equilibrium (theta=0, omega=0)

# Solve the Gym dynamics
sol_gym = solve_ivp(gym_pendulum_dynamics, time_span, initial_conditions, t_eval=t_eval)

# Solve the classical dynamics
sol_classical = solve_ivp(classical_pendulum_dynamics, time_span, initial_conditions, t_eval=t_eval)

# Extract results
t = sol_gym.t
theta_gym = sol_gym.y[0]
theta_classical = sol_classical.y[0]

# Plot the results
plt.figure(figsize=(10, 6))
plt.plot(t, theta_gym, label='Gym Formulation', linestyle='--')
plt.plot(t, theta_classical, label='Classical Formulation', linestyle='-')
plt.title('Comparison of Pendulum Dynamics: Gym vs Classical')
plt.xlabel('Time (s)')
plt.ylabel('Angle (rad)')
plt.legend()
plt.grid()
plt.show()

```

vincentzhang, 2025-01-24:
"infinite oscillation going back and forth from the starting point and passing by the origin θ=0 angle", this description seems to  to assume that the lowest point corresponds to θ=0. However, in the Gym coordinate system, the lowest point is at θ=pi. So it seems to me that both curves on your plot check out in terms of the central point of oscillation. Mathematically, from the acceleration equation provided, sin(θ) = sin(θ'-pi) = -sin(θ') where θ' is the angle in gym coordinate system. The negative sign cancels out.

ReHoss, 2025-01-25:
> "infinite oscillation going back and forth from the starting point and passing by the origin θ=0 angle", this description seems to assume that the lowest point corresponds to θ=0. However, in the Gym coordinate system, the lowest point is at θ=pi. So it seems to me that both curves on your plot check out in terms of the central point of oscillation. Mathematically, from the acceleration equation provided, sin(θ) = sin(θ'-pi) = -sin(θ') where θ' is the angle in gym coordinate system. The negative sign cancels out.

Exactly, I forgot that point.

Closed 2022-09-13.

Thread 3014 (2022-08-02):

[Question] Documentation for lunar lander rewards incomplete

ToonTalk, 2022-08-02:
[https://www.gymlibrary.ml/environments/box2d/lunar_lander/#rewards](https://www.gymlibrary.ml/environments/box2d/lunar_lander/#rewards) states

> Reward for moving from the top of the screen to the landing pad and coming to rest is about 100-140 points.

This is very vague. Is the reward incrementally awarded or only after landing? What determines whether it is 100, 140, or in between?

pseudo-rnd-thoughts, 2022-08-02:
The full documentation is
>  Reward for moving from the top of the screen to the landing pad and coming
    to rest is about 100-140 points.
    If the lander moves away from the landing pad, it loses reward.
    If the lander crashes, it receives an additional -100 points. If it comes
    to rest, it receives an additional +100 points. Each leg with ground
    contact is +10 points.
    Firing the main engine is -0.3 points each frame. Firing the side engine
    is -0.03 points each frame. Solved is 200 points.

I agree that the documentation is not particular clear but my understanding is
As the robot has four legs I believe and the robot receives 10 points per legs and 100 points for landing. Therefore, the total reward for landing is between 100 to 140.

RedTachyon, 2022-08-02:
The documentation is somewhat incomplete, but the reward function itself is also a bit complext to put into words. I recommend checking out the [source code](https://github.com/openai/gym/blob/master/gym/envs/box2d/lunar_lander.py#L564) to see how the reward is computed (it's dependent on the position, velocity, angle, the contact of two legs, the energy usage, and the completion of the objective). If you or someone can convert it to a nice natural language description, that would be great.

vairodp, 2022-09-05:
I analyzed how the reward is calculated and I can safely say that the "100..140" is inaccurate and misleading.

The reward takes to account at every step:
- position (the closer to the landing pad the better)
- speed (the slower the better)
- the angle (the less tilted the better)
- the legs touching the pad (as accurately described)
- the fuel consumed (as accurately described)

(Also, at the end of the episode  +- 100 as accurately described)

I tried to dissection in the code how the reward is calculated and I couldn't find evidence of the "100..140" range:
- If it was referring for just the calculation of the position of the lander it would be inaccurate cause the range (after I run several experiments/simulations by dissecting the reward calculation) would be from 0 to 140
- if it was referring for the position + any other feature it will be inaccurate cause it can greatly go higher than 140 or lower than 100

To fix this inaccuracy in the documentation I tried to rewrite the doc in a more "complete" way and already did the PR [here](https://github.com/openai/gym/pull/3064)

Closed 2022-09-12.

Thread 3018 (2022-08-03):

[Proposal] Turn enwik9 (Hutter Prize) into an RL agent game

jabowery, 2022-08-03:
### Proposal

Include the Hutter Prize corpus ([enwik9](http://mattmahoney.net/dc/enwik9.zip)) as a "game" for the purpose of sample-efficient reinforcement language modeling.

### Motivation

Recently, [EfficientZero](https://github.com/YeWR/EfficientZero) has demonstrated sample-efficient reinforcement learning in the gym.  The interest in large language models generally ignores 3 deficiencies: model size, sample size and planning.  Ignoring model size is particularly egregious as it implicitly ignores the strongest theorem in unsupervised model selection:  [Solomonoff Induction](https://en.wikipedia.org/wiki/Solomonoff%27s_theory_of_inductive_inference) (ie: approximation of [Algorithmic Information of the sense data](https://en.wikipedia.org/wiki/Algorithmic_information_theory)) to generate optimal predictions.  The sample sizes of the LLM corpora are intractable for all but the wealthiest institutions.  [The lack of LLM planning ability](https://arxiv.org/abs/2206.10498) implies a general inability to perform in dynamical environments.

### Pitch

Consider a simple "game" that consists of one of 2 moves each time step -- 0 or 1 -- resulting in a positive or negative reinforcement based on whether it predicts the next bit in the enwik9 corpus or not.  Obviously, the agent could simply contain the enwik9 corpus and score perfectly.  However, this very fact points to the motivation for Solomonoff Induction as part of an AGI that must learn from its environment.  Therefore, while the utility function for the agent would remain its hits-misses, the SoTA measure would be the size of the agent itself -- the degree to which it approaches the Solomonoff Induction model (aka the Algorithmic Information content of the agent's observations).  While there are bound to be a variety of ways of measuring this size, as well as a variety of ways of incorporating resource utilization (TPUs, CPUs, time, etc.) into any SoTA metric, such is the case with other SoTA measures in the gym.

Such a reinforcement learning agent would define "scientist" in rigorously operational terms and, in approximating the actual information content of Wikipedia, provide epistemological insights into that critical resource.

Finally, as EfficientZero is a sample-efficient derivative of [MuZero](https://arxiv.org/pdf/1911.08265.pdf) and MuZero has inspired the bold hypothesis that "[Reward Is Enough](https://www.sciencedirect.com/science/article/pii/S0004370221000862)" it would be most interesting to see the various approaches to reward-driven science arising from the competitive environment of the gym.

### Alternatives

[The Hutter Prize for Lossless Compression of Human Knowledge](http://prize.hutter1.net/) and [The Large Text Compression Benchmark](http://mattmahoney.net/dc/text.html) were both constructed to advance epistemology through knowledge modeling, but the field's lack of familiarity with Solomonoff's fundamental finding in AGI, combined with the profligacy of computational resources and data, has led to a situation in which SoTA performance metrics are largely eliding a foundational component of AGI.

### Checklist

- [x] I have checked that there is no similar [issue](https://github.com/openai/gym/issues) in the repo (**required**)

pseudo-rnd-thoughts, 2022-08-03:
Thanks for the issue but this sounds more like a research proposal rather an issue for gym.
Currently, gym is maintained by a group of volunteers with no staff from OpenAI so Im not sure how we can help you make this proposal a reality.
Im would contact academic researchers in this area who are more likely a better help than we could be

RedTachyon, 2022-08-04:
Anyone is free to do this kind of a project, but it's definitely not suitable for the core gym library.

Closed 2022-08-08.

Thread 3031 (2022-08-16):

[Bug Report] Bug title

austinmw, 2022-08-16:
If you are submitting a bug report, please fill in the following details and use the tag [bug].

**Describe the bug**
`env.render()` kills my JupyterLab kernel

**Code example**

```python
import random
import numpy as np
import gym
from tensorflow.keras.models import Sequential
from tensorflow.keras.layers import Dense, Flatten
from tensorflow.keras.optimizers import Adam
from rl.agents import DQNAgent
from rl.policy import BoltzmannQPolicy
from rl.memory import SequentialMemory

env = gym.make('CartPole-v1')
states = env.observation_space.shape[0]
actions = env.action_space.n

episodes = 10
for episode in range(1, episodes+10):
    state = env.reset()
    done = False
    score = 0

    while not done:
        env.render()
        action = random.choice([0,1])
        state, reward, done, info = env.step(action)
        score += reward
    print(f'Episode: {episode}, score: {score}')
```

**System Info**
Describe the characteristic of your environment:
- Ubuntu 20.04.4 LTS
- JupyterLab
- Python 3.8.8
- TensorFlow 2.9.1
- Gym 0.25.1

pseudo-rnd-thoughts, 2022-08-16:
Thanks for the issue, I can replicate the issue on mac with the master branch of gym.
Even when closing the environment or adding `render_mode="human"`, this still causes an issue

```python
import gym

env = gym.make('CartPole-v1')

state = env.reset()
done = False
score = 0

while not done:
    env.render()
    action = env.action_space.sample()
    state, reward, done, info = env.step(action)
    score += reward
print(score)
env.close()
```

Issue https://github.com/openai/gym/issues/2677 has the same problem.

RedTachyon, 2022-08-17:
Is the issue still present if you do `img = env.render("rgb_array")`? My guess is that it's yet another issue with the `human` rendering, but I thought that pygame was nicer than pyglet for that

austinmw, 2022-08-17:
@RedTachyon That does prevent the kernel crash (although is practically speaking unusable in a loop as:

```python
    while not done:
        #env.render()
        img = env.render("rgb_array")
        plt.imshow(img)
        display.clear_output(wait=True)
        display.display(pl.gcf())
```
since it updates far too slowly

RedTachyon, 2022-08-22:
So I just tested a basic loop
```python
env = gym.make("CartPole-v1", new_step_api=True)

env.reset()

for _ in range(100):
    env.step(env.action_space.sample())
    env.render()
```

and it works without any issues. My setup is Mac + gym 0.25.2 + jupyterlab 3.2.0.

I'm guessing the issue might be with the local setup or something? Or maybe jupyterlab messed something up in the meantime?

RedTachyon, 2022-08-22:
@austinmw Do you maybe happen to be running the code on a headless machine?

austinmw, 2022-08-22:
@RedTachyon I did try that first using X11 to EC2 instance and thought that might be it, but then I tried directly on my ubuntu desktop and experienced the same issue

RedTachyon, 2022-08-22:
Is there some more detailed error message you can provide? I know jupyter sometimes dumps some logs/stack trace in the terminal where you're running the jupyter instance.

I don't have access to a proper ubuntu desktop at the moment, but on a headless ubuntu 20 machine with gym 0.25.2 I'm getting the "expected" error ("error: video system not initialized"), but no kernels have been harmed

austinmw, 2022-08-22:
@RedTachyon Ah, it looks like the the combination of `new_step_api=True` and `render_mode='human'` fixed it for me, working now, thanks for your help!

RedTachyon, 2022-08-22:
Another thing that does work for me is running a virtual display (via `pyvirtualdisplay.smartdisplay.SmartDisplay`), and then I can just get the image on a headless ubuntu machine.

@pseudo-rnd-thoughts you mentioned you can replicate this issue, can you take a look what's the exact error you're getting too?

RedTachyon, 2022-08-22:
@austinmw Glad that it works now, but I have no idea why it would make a difference. In any case, the API switching is on the way out for the next release, so unless we see this happening in the new version, we can probably ignore the issue.

ash-mac, 2022-08-28:
Sorry, if this isn't the right place, but similar issue is faced in FozenLake8x8-v1 and Taxi-v3 Environments

pseudo-rnd-thoughts, 2022-08-28:
The fix is merged in the master branch but is not in a release yet, it will be v26

RedTachyon, 2022-08-28:
@pseudo-rnd-thoughts Which fix do you mean? I don't recall this having been figured out, there's just the hope that if the issue is indeed due to the API switching (which is odd), then it will go away by itself.

pseudo-rnd-thoughts, 2022-08-28:
Ohh, sorry I must be getting this bug confused with https://github.com/openai/gym/pull/3037

jkterry1, 2022-10-25:
Hey, we just launched [gymnasium](https://github.com/Farama-Foundation/Gymnasium), a fork of Gym by the maintainers of Gym for the past 18 months where all maintenance and improvements will happen moving forward. Could you please move this over to the new repo?

If you'd like to read more about the story behind the backstory behind this and our plans going forward, click [here](https://farama.org/Announcing-The-Farama-Foundation).

bjoaquin, 2023-01-01:
I'm new to this subject and I'm probably much too late anyway, but is it possible that the problem with @austinmw 's code is that it lacks an `env.close()` after the last line?

Thread 3032 (2022-08-17):

[Bug Report] Cannot render toy_text envs in Google Colab

KristianHolsheimer, 2022-08-17:
**Describe the bug**

The `env.render()` functionality is broken for toy text envs when running in google colab.

**Code example**

Below is a simple example to repro this bug, see also this [notebook](https://colab.research.google.com/drive/1aibrJhzxNN7UwbgdhGQR2YhlUWZjCSYU).

```python
%pip install 'gym==0.25.1' --quiet

import gym
print(gym.__version__)  # 0.25.1
```

```python
env = gym.make('FrozenLake-v1')
env.reset()
env.render()  # error: No available video device
```

The error is triggered when pygame tries to initialize the (nonexistent) display:
```python
pygame.init()          # ok
pygame.display.init()  # fail
```

**System Info**
This is running on google colab ([notebook](https://colab.research.google.com/drive/1aibrJhzxNN7UwbgdhGQR2YhlUWZjCSYU)).

**Additional context**

It looks like the backend for toy text envs was changed to pygame. What was the reason for that change?

RedTachyon, 2022-08-19:
FWIW I can't access the notebook, you need to update permissions.

>It looks like the backend for toy text envs was changed to pygame. What was the reason for that change?

It looks better and functions analogously to all other envs (i.e. you can render it as an image, and then record a video or something).

---
In any case, the old mode is available via
```python
env = gym.make('FrozenLake-v1', render_mode="ansi"))
env.reset()
print(env.render()[0])
```

There is an extra hitch in the fact that the `ansi` mode returns a list of renders, but it should work without any rendering devices.

pseudo-rnd-thoughts, 2022-08-19:
I suspect that rendering is broken for collab and jupyter notebook.
My guess is human rendering for collab will never work due to the code not running locally. As for jupyter notebook, it works, it just crashes.
@andrewtanJS is currently investigating the notebook issue

KristianHolsheimer, 2022-08-19:
Thanks, yes I looked into it a bit further this morning and looks like the general rendering API has changed.

As an end user, it's not clear what to expect from `env.render()` in general. It seems that it may ...
- return values without rendering side-effects
- return values with rendering side-effects
- return nothing but has rendering side-effects
- return nothing and no rendering side-effects (maybe because something failed silently)

Also, a small nit: `env.render(mode='somemode')` has no effect if `env.render_mode` is set.

KristianHolsheimer, 2022-08-19:
PS I updated the notebook, it's basically just import gym, env.reset(), env.render().

RedTachyon, 2022-08-19:
>As an end user, it's not clear what to expect from env.render() in general.

Oh yea, that's an unfortunate artifact of the code we were left with when we restarted the maintenance. It's the reason why the render API is undergoing major changes, one of which is the whole `env.render_mode` thing.

In a future release, you won't be calling `env.render(mode='somemode')`, currently it's only kept for backwards compatibility. Instead, you just set the render mode on initialization, and call `env.render()`.

I'm afraid we don't have a clear plan at the moment to properly make it make sense, because the output of `env.render()` will still depend on the render mode. And we can't easily just rip it out and rewrite in a more sane way, because it's very ingrained in many codebases already.

jkterry1, 2022-08-22:
Closing in favor of PR

Closed 2022-08-22.

Thread 3082 (2022-09-09):

[Bug Report] CarRacing module crashes when executed directly and no longer stops after closing the window

foxik, 2022-09-09:
**Describe the bug**
When running the `car_racing.py` module directly, it fails with

```
  File "/tmp/venv/gym/gym/envs/box2d/car_racing.py", line 799, in <module>
    env.render()
  File "/tmp/venv/gym/gym/envs/box2d/car_racing.py", line 568, in render
    return self._render(self.render_mode)
  File "/tmp/venv/gym/gym/envs/box2d/car_racing.py", line 571, in _render
    assert mode in self.metadata["render_modes"]
AssertionError
```

This is caused by the recent rendering changes, because `car_racing.py` is constructing `CarRacing` instance directly in
https://github.com/openai/gym/blob/f4d668f9687ae417ff041cb1735966633d8ba759/gym/envs/box2d/car_racing.py#L798

The problem could be fixed by adding `render_mode="human"` to the `CarRacing` constructor.

There is also a second problem, however. The main cycle is
```
    isopen = True
    while isopen:
        env.reset()
        total_reward = 0.0
        steps = 0
        restart = False
        while True:
            register_input()
            s, r, terminated, truncated, info = env.step(a)
            total_reward += r
            if steps % 200 == 0 or terminated or truncated:
                print("\naction " + str([f"{x:+0.2f}" for x in a]))
                print(f"step {steps} total_reward {total_reward:+0.2f}")
            steps += 1
            isopen = env.render()
            if terminated or truncated or restart or isopen is False:
                break
```
Previously, `isopen` was set when the user closed the viewer, which is no longer the case with `pygame`. However:
- currently `isopen` is not set when closing the window -- the window cannot be closed, actually
- `render` is called twice -- once inside the `step`, and also manually in the cycle

I am not sure how to handle this use case:
- instead of
  ```python
  pygame.event.pump()
  ```
  in the `render` method one can use
  ```python
  if pygame.event.peek(pygame.QUIT):
      # handle close
  else:
      # original code
      pygame.event.pump()
  ```
  to detect that user tried to close the window
- however, it is not clear how to handle the close -- should only a flag be raised? Or the window actually closed?
  - If you only set the `isopen` flag and return it, then because `render` is called twice now (once in `step`), in 50% of the cases this flag will be returned from the `render` call in `step` method and will be ignored (because it will not be handled by the above cycle)
  - If you close the window as a response to the `QUIT` event, then:
    - maybe we could have some API place where this flag will be set, so that something like `env.isopen` is exported from all environments with a viewer?
    -  care must be taken so that a new window is not immediately created (if for example `self.surface` is `None`)

Previously there was a single `Viewer` class handling rendering of all `classic_control` and `box2d` environments, but right now the `pygame` logis is instead replicated in all of them. Maybe we could have again some `Viewer` class to provide basic functionality, so that changes like "allowing the user to close the window" would be implemented on one place, not identically in many modules.

RedTachyon, 2022-09-10:
Thanks, that's a good catch. I'd actually consider removing the whole functionality of running individual files, it seems to be a relic of the old versions of gym, and overall not a great pattern.

pseudo-rnd-thoughts, 2022-09-12:
@foxik Would you be able to make a PR to fix it?

foxik, 2022-09-12:
@pseudo-rnd-thoughts No problem, I just created it.

The handling of `isopen` was easy in the end, I just augmented the event cycle in `register_input` to also handle the `pygame.QUIT` event. When I was at it, I also added handling of `pygame.K_ESCAPE` key.

Closed 2022-09-13.

Thread 3107 (2022-10-01):

[Question] Action Space showing floats when dtype=int

windowshopr, 2022-10-01:
### Question

This isn't NOT a bug, but I also didn't want to submit it as a bug in case it's really not, but when I set an action space as a `Box` with `dtype=int` or `dtype=np.int32`, when the environment is reset for the first time, the actions are showing as floats? Any idea why?

I've provided a minimal reproducible example below:

```
from random import randint
from numpy import inf, float32, array, int32, int64
import gym
from stable_baselines3 import A2C, DQN, PPO

"""Class of environment"""
class Custom_Environment(gym.Env):

    metadata = {'render.modes': ['human', 'text']}

    """Initialize the environment"""
    def __init__(self):
        super(Custom_Environment, self).__init__()
        # Spaces
        self.action_space = gym.spaces.Box(low=0, high=1000, shape=(37,), dtype=int)
        self.observation_space = gym.spaces.Box(low=0, high=1000, shape=(37,), dtype=int)

    """Reset the Environment"""
    def reset(self):
        self.done = False
        self.current_state = self.observation_space.sample()
        return self.current_state

    """Step Through the Environment"""
    def step(self, action):
        # Inspect the action space, see not integers
        for i in range(len(action)):
            print(action[i])
        # Throw an error here to stop the code
        stop()
        step_reward = 0
        return self.current_state, step_reward, self.done, {} # step_reward

env = Custom_Environment()

model = PPO('MlpPolicy', env, verbose=1)
model.learn(total_timesteps=10000)
```

OUTPUT

```
Using cpu device
Wrapping the env with a `Monitor` wrapper
Wrapping the env in a DummyVecEnv.
0.0
0.0
0.0
0.6412628293037415
1.6904927492141724
1.3439135551452637
0.0
1.1811418533325195
0.0
1.066895842552185
0.0
0.0
0.0
0.6355175375938416
0.0
0.0
0.1874774545431137
0.4175698757171631
0.0
0.8219074010848999
0.0
0.0
0.0
0.0
0.0
0.0
0.10093195736408234
0.7056602835655212
0.0
0.2542327344417572
0.17636002600193024
0.0
1.3428149223327637
0.25007113814353943
0.0
0.0
0.6961379051208496
```

The code will stop at my `stop()` function call which doesn't exist, but you can see the floats printed out in the output. Any ideas?

windowshopr, 2022-10-01:
Someone [here](https://stackoverflow.com/questions/70850943/box-space-always-returning-float-values-in-openai-gym) has asked the same question, but there's no answer

balisujohn, 2022-10-02:
This looks like a bug to me, I'll take a look.

windowshopr, 2022-10-02:
```
gym==0.21.0
stable_baselines3==1.6.1
```

It's worth noting that I am running this in a Google Colab notebook...

windowshopr, 2022-10-02:
I also just tried upgrading `gym` in the notebook to `0.26.1`, same issue.

balisujohn, 2022-10-02:
So a box action space with int values is equivalent in some sense to a multi-discrete action space, which stable-baselines3 does currently support. I think stable-baselines3 doesn't support integer values box action spaces from looking at their code, so if you really need int valued box support and a multi-discrete space wont work, then I'd recommend making a feature request on stable-baselines3.

windowshopr, 2022-10-02:
This did fix the issue, changing the action space to:

```
self.action_space = gym.spaces.MultiDiscrete([1000 for _ in range(37)], dtype=int)
```

...worked in turning them into int's so I can go ahead with that, but maybe the Box int thing could be figured out in the future. Thanks!

Closed 2022-10-02.

Thread 3132 (2022-10-21):

[Bug Report] Enviornment Not Closing macOS Monterey

Mukilan-Krishnakumar, 2022-10-21:
This is in reference to a previous issue #2160, @jkterry1 seemed to have closed the issue, but I ran into the same problem.

I am encountering the same error as #2160 whenever I close an environment on gym 0.21.0 and macOS Monterey 12.6, the render window doesn't close, even after using `env.close()`. I am running this from a Jupyter Notebook and every time I Force Quit the render window, my kernel dies.

I am working on a simple CartPole experiment.

Here is the code:
```python
environment_name = 'CartPole-v0'
env = gym.make(environment_name)
episodes = 5
for episode in range(1, episodes+1):
state = env.reset()
done = False
score = 0
while not done:
env.render()
action = env.action_space.sample()
n_state, reward, done, info = env.step(action)
score += reward
print(f'Episode : {episode} Score : {score}')

env.close()
```

Here is a picture of my render window, frozen and unresponsive.
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

Mukilan-Krishnakumar, 2022-10-22:
Upgrading to the latest versions doesn't seem to resolve the error.
I upgraded to Gym=0.26.2, then ran the same code with some minor changes (added `render_mode`)

```python
environment_name = 'CartPole-v1'
env = gym.make(environment_name,render_mode = 'human')

episodes = 5
for episode in range(1, episodes+1):
    state = env.reset()
    done = False
    score = 0
    while not done:
        env.render()
        action = env.action_space.sample()
        n_state, reward, done, trunc, info = env.step(action)
        score += reward
    print(f'Episode : {episode} Score : {score}')
env.close()
```

The environment does seemingly close, but when I rerun the cell for a new demonstration, the following error is thrown.
```
File ~/.pyenv/versions/zenml/lib/python3.8/site-packages/gym/envs/classic_control/cartpole.py:295, in CartPoleEnv.render(self)
    292 gfxdraw.hline(self.surf, 0, self.screen_width, carty, (0, 0, 0))
    294 self.surf = pygame.transform.flip(self.surf, False, True)
--> 295 self.screen.blit(self.surf, (0, 0))
    296 if self.render_mode == "human":
    297     pygame.event.pump()

error: display Surface quit
```
Does it have something to do with the fact that I am running this with Rosetta from an M1 Mac? Should I just Force Quit the application?

Using the latest version of Gym also introduces dependency issues with Stable Diffusion :(

Mukilan-Krishnakumar, 2022-10-22:
Update: I ran the whole code natively (on M1 ARM). I am able to replicate the same error, even with the latest version of Gym.

It displays the same error: `error: display Surface quit`

andrewtanJS, 2022-10-22:
Did you rerun the entire cell including the `gym.make()`? If you call `env.close()`, you'll need to reinitialise the environment by using `env = gym.make(environment_name, render_mode = 'human')` again.

For me, running your code above in one cell works on M2 ARM and Jupyter Notebook.

Mukilan-Krishnakumar, 2022-10-22:
Oh Yes!! I ran `gym.make` and `env.close` in different blocks. It does work when they are both in the same code block.
Thanks @andrewtanJS, Appreciate your help!!

To folks who are directed here in the future, Stable Baselines3 hasn't caught up with the latest gym versions. To work with Stable_Baselines3, we need to downgrade gym to 0.21.0 (As of October 2022). You can read the changelogs [here](https://stable-baselines3.readthedocs.io/en/master/misc/changelog.html). Hopefully, they will upgrade gym version soon!!

Closed 2022-10-22.

Thread 3201 (2023-03-28):

ALE Namespace does not exist.

Nervoload, 2023-03-28:
I am attempting to access the Atari environments, and upon importing the latest versions of ale-py, autorom, gym, gymnasium even, I get the following error when attempting to make and environment of any space under the ALE namespace:

env = gym.make(ALE/Breakout-v5)

---------------------------------------------------------------------------
NamespaceNotFound                         Traceback (most recent call last)
[<ipython-input-33-03246568d1a2>](https://61fn6hm730u-496ff2e9c6d22116-0-colab.googleusercontent.com/outputframe.html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) in <module>
      1 env_name = 'ALE/Breakout-v5'
----> 2 env = gym.make(env_name)

4 frames
[/usr/local/lib/python3.9/dist-packages/gym/envs/registration.py](https://61fn6hm730u-496ff2e9c6d22116-0-colab.googleusercontent.com/outputframe.html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) in _assert_namespace_exists(self, namespace)
    266             else:
    267                 message += f" Have you installed the proper package for `{namespace}`?"
--> 268         raise error.NamespaceNotFound(message)
    269
    270     def _assert_name_exists(self, namespace: Optional[str], name: str) -> None:

NamespaceNotFound: Namespace `ALE` does not exist. Have you installed the proper package for `ALE`?

Yes, I did in fact download namespace ALE.

This may be a notebook exclusive error, but it did happen on my personal base python3.10. Somehow,  after reinstalling and changing a bunch of packages, I actually got it to work on my personal computer.

I suspect that gym.make pulls from existing files under gym/envs, and somehow the ALE package does not reroute the directory when attaching the namespace to it. I will play with this to try to figure out the solution by added the ALE roms to the gym/envs folder, or by changing the namespaces directly.

gym version: 0.28.1

**System Info**
Describe the characteristic of your environment:
ipynb, notebook =
 * Describe how Gym was installed (pip, docker, source, ...)
 latest version of pip,
google colab AND MacOS latest M1 (but it ended up working there)

pseudo-rnd-thoughts, 2023-03-28:
Have you run `pip install "gym[accept-rom-license, atari]"`?
Could you print `gym.envs.registration.registry.keys()`?

rezkanas, 2023-04-01:
I have similar problem when making an environment through gym.make("ALE/Riverraid-v5"). I run both commands you suggested and the return for the print was:
`dict_keys(['CartPole-v0', 'CartPole-v1', 'MountainCar-v0', 'MountainCarContinuous-v0', 'Pendulum-v1', 'Acrobot-v1', 'CartPoleJax-v0', 'CartPoleJax-v1', 'PendulumJax-v0', 'LunarLander-v2', 'LunarLanderContinuous-v2', 'BipedalWalker-v3', 'BipedalWalkerHardcore-v3', 'CarRacing-v2', 'Blackjack-v1', 'FrozenLake-v1', 'FrozenLake8x8-v1', 'CliffWalking-v0', 'Taxi-v3', 'Jax-Blackjack-v0', 'Reacher-v2', 'Reacher-v4', 'Pusher-v2', 'Pusher-v4', 'InvertedPendulum-v2', 'InvertedPendulum-v4', 'InvertedDoublePendulum-v2', 'InvertedDoublePendulum-v4', 'HalfCheetah-v2', 'HalfCheetah-v3', 'HalfCheetah-v4', 'Hopper-v2', 'Hopper-v3', 'Hopper-v4', 'Swimmer-v2', 'Swimmer-v3', 'Swimmer-v4', 'Walker2d-v2', 'Walker2d-v3', 'Walker2d-v4', 'Ant-v2', 'Ant-v3', 'Ant-v4', 'Humanoid-v2', 'Humanoid-v3', 'Humanoid-v4', 'HumanoidStandup-v2', 'HumanoidStandup-v4', 'GymV21Environment-v0', 'GymV26Environment-v0'])`

pseudo-rnd-thoughts, 2023-04-01:
@rezkanas You are using gymnasium not gym, and has an additional requirement, please run `pip install gymnasium[atari, accept-rom-licesnse]`

Elemento24, 2023-04-12:
Hey @pseudo-rnd-thoughts,
I am having the same issue as @rezkanas, with the same keys, even after running the code you suggested. Can you please let us know what to do in this case?

pseudo-rnd-thoughts, 2023-04-12:
If you are using gym then you need to run `pip install "gym[atari, accept-rom-license]"` and if you are using gymnasium you need to run `pip install "gymnasium[atari, accept-rom-license]"`.

If you have run the appropriate command and do
```python
import gym # or "import gymnasium as gym"
print(gym.make("ALE/Pong-v5"))
```
and it doesn't work then run
```python
import ale_py
# if using gymnasium
import shimmy

import gym # or "import gymnasium as gym"
print(gym.envs.registry.keys())
```

OwenFa, 2023-04-12:
Just did the accept rom license for gymnasium, and still did not work. Here is the output for the keys:
dict_keys(['CartPole-v0', 'CartPole-v1', 'MountainCar-v0', 'MountainCarContinuous-v0', 'Pendulum-v1', 'Acrobot-v1', 'LunarLander-v2', 'LunarLanderContinuous-v2', 'BipedalWalker-v3', 'BipedalWalkerHardcore-v3', 'CarRacing-v2', 'Blackjack-v1', 'FrozenLake-v1', 'FrozenLake8x8-v1', 'CliffWalking-v0', 'Taxi-v3', 'Reacher-v2', 'Reacher-v4', 'Pusher-v2', 'Pusher-v4', 'InvertedPendulum-v2', 'InvertedPendulum-v4', 'InvertedDoublePendulum-v2', 'InvertedDoublePendulum-v4', 'HalfCheetah-v2', 'HalfCheetah-v3', 'HalfCheetah-v4', 'Hopper-v2', 'Hopper-v3', 'Hopper-v4', 'Swimmer-v2', 'Swimmer-v3', 'Swimmer-v4', 'Walker2d-v2', 'Walker2d-v3', 'Walker2d-v4', 'Ant-v2', 'Ant-v3', 'Ant-v4', 'Humanoid-v2', 'Humanoid-v3', 'Humanoid-v4', 'HumanoidStandup-v2', 'HumanoidStandup-v4', 'GymV26Environment-v0'])

Elemento24, 2023-04-12:
Hey @pseudo-rnd-thoughts,
Thanks a lot, you are a real saviour 🥳 Hey @OwenFa, try using what Mark has suggested above, it worked in my environment (_gymnasium with version 0.28.1_). I really hope that it works in yours as well 😄

haeren, 2023-04-20:
The solutions Mark suggested didn't work for Python 3.8. But I created a new environment with 3.7 and installed "gym[accept-rom-license, atari]" and Breakout now works fine.

vmoens, 2023-11-03:
I get the same error with gymnasium but not gym.
To give a little bit of context, it's a distributed script where submitit is used to spawn jobs on multiple nodes that all create their own copies of a gym env and send data to the main node asynchronously.
If I create a "ALE/Pong-v5" on the main node it works, but spawn processes cannot.
With gym it's working fine.
To reproduce: on https://github.com/pytorch/rl/pull/1672, execute `rl/examples/distributed/collectors/multi_nodes/delayed_dist.py`. Replacing the backend in that script with `gymnasium` leads to the error reported in this issue on the distant nodes.

Charles-Gormley, 2023-12-02:
I know this issue is basically closed but if you are using gym in a jupyter notebook test it in a normal python file. My environment loaded in everything correctly in normal python.

gurpreetsinghmukker, 2023-12-13:
If someone is still having issues with gymnasium, i just deactivated and activated my virtual environment(venv) again and it fixed things for me.
If you are using jupyter notebook in vscode, switching to different kernel server and then going back to original kernel server again fixed the issue.

kushagra-m, 2024-04-06:
Thanks, I did all of the above but it was still showing the same error. I restarted the colab notebook (with the above fixes) and it worked!

unmani-shinde, 2024-11-22:
I followed all the steps mentioned above, but the error persisted. For anyone facing the same issue, try creating a new virtual environment and then running `pip install gym[all,accept-rom-license]` in that env instead of `gym[atari,accept-rom-license]`. This solution worked for me—hope it helps!

a416297338, 2025-01-16:
The gymnasium 1.0.0 version has removed the option for gymnasium[accept-rom-license].
You can execute pip install ale-py and use the following code to resolve the issue.
import ale_py
import gymnasium as gym
gym.register_envs(ale_py)

duhaime, 2025-01-27:
I also needed to use Python 3.7 (not 3.9)

```bash
conda create --name=3.7 python=3.7
conda activate 3.7
pip install "gymnasium[atari, accept-rom-license]"
AutoROM --accept-license
```

then

```python
import gymnasium as gym
env = gym.make("ALE/Breakout-v5")
```

Thread 3204 (2023-04-07):

Issue with resuming Super Mario Bros game training from interrupted state in Google Colab

WULukeWU, 2023-04-07:
I'm having some issues with training a Super Mario Bros game on Google Colab. I modified some code so that I could resume training from where it left off after an interruption, but I found that the new training did not pick up where the previous one left off.

```python
# Import os for file path management
import os
# Import PPO for algos
from stable_baselines3 import PPO
# Import Base Callback for saving models
from stable_baselines3.common.callbacks import BaseCallback

from google.colab import drive
drive.mount('/content/drive', force_remount=True)

if not os.path.exists(f'{folder_path_temp}/{model_number}'):
    os.makedirs(f'{folder_path_temp}/{model_number}')

# Get the current training times
train_folder_path = f'{folder_path_temp}/{model_number}/train'
if os.path.exists(train_folder_path):
    train_files = os.listdir(train_folder_path)
    train_file_dict = {}
    for file in train_files:
        file_path = os.path.join(train_folder_path, file)
        if os.path.isfile(file_path):
            train_num = int(file.split('_')[-1].split('.')[0])
            train_file_dict[file] = train_num
    current_train_num = train_file_dict[max(train_file_dict, key=train_file_dict.get)]

class TrainAndLoggingCallback(BaseCallback):

    def __init__(self, check_freq, save_path, verbose=1):
        super(TrainAndLoggingCallback, self).__init__(verbose)
        self.check_freq = check_freq
        self.save_path = save_path
        self.model_counter = current_train_num + check_freq  # Set the model counter to the current number of training times

    def _init_callback(self):
        if self.save_path is not None:
            os.makedirs(self.save_path, exist_ok=True)

    def _on_step(self):
        if self.n_calls % self.check_freq == 0:
            model_path = os.path.join(self.save_path, 'best_model_{}.zip'.format(self.model_counter))
            self.model.save(model_path)
            self.model_counter += check_freq  # Increase the model counter by check_freq after each save

        return True

# Setup model saving callback
callback = TrainAndLoggingCallback(check_freq=check_freq, save_path=CHECKPOINT_DIR)

# This is the AI model started
model = PPO('CnnPolicy', env, verbose=1, tensorboard_log=LOG_DIR, learning_rate=learning_rate, n_steps=n_steps)

if os.path.exists(train_folder_path):

    # Get the most training times model
    max_train_num_file = max(train_file_dict, key=train_file_dict.get)

    # Build the path of the most training times model
    max_train_num_file_path = os.path.join(train_folder_path, max_train_num_file)

    # Load the most training times model before model.learn
    if os.path.exists(max_train_num_file_path):
        model.load(max_train_num_file_path)
        print(f'Loaded model from {max_train_num_file_path}')

# Set the total timesteps as the sum of last training numbers and total timesteps
total_timesteps += current_train_num
print(f'total_timesteps: {total_timesteps}\ncurrent_train_num: {current_train_num}')

# Train the AI model, this is where the AI model starts to learn
model.learn(total_timesteps=total_timesteps, callback=callback, reset_num_timesteps=False, tb_log_name='PPO')
```

In my code, I have a variable called train_folder_path, which points to a directory containing two subdirectories: logs and train. Each time I run the code, the logs directory will have new subdirectories with names like PPO_1 and PPO_2, and each of these subdirectories will contain a log file with a name like events.out.tfevents.1680514391.100228883bb9.309.0. Meanwhile, the train directory will contain saved model files with names like best_model_100000.zip and best_model_200000.zip, depending on the value of check_freq.

I would greatly appreciate any help with this issue, as I am hoping to successfully resume training from where it left off after an interruption. Thank you in advance for any assistance you can provide.

StarKnightt, 2023-04-14:
Your code suggests that you are successfully saving the model and loading the most recent model before starting the training process again. It is probable that the `total_timesteps` argument supplied to the `model.learn()` method causes the problem, though.

In order to resume training, you must add the` total_timesteps` value to the number of timesteps from the previous training runs and then send this value to the `model.learn()` method. However, the `model.learn()` method determines the total number of timesteps to train the model rather than the number of timesteps to train in the current run using the `total_timesteps` parameter.

To ensure that the model continues training from where it left off, you should pass the remaining number of timesteps to train to the model.learn() method. You can calculate this by subtracting the number of timesteps already trained (i.e., current_train_num) from the total number of timesteps you want to train (i.e., total_timesteps). Here's an example:

`# Calculate the remaining number of timesteps to train
remaining_timesteps = total_timesteps - current_train_num

# Train the AI model, starting from the current number of timesteps
model.learn(total_timesteps=remaining_timesteps, callback=callback, reset_num_timesteps=False, tb_log_name='PPO')
`
By doing this, the model will continue training from where it left off in the previous run, rather than starting from scratch.

WULukeWU, 2023-04-16:
Hi StarKnightt,

I've modified the code according to your suggestions, but I'm still having trouble with the model not continuing training from where it left off. Could it be because I also need to load the log directory files?

Here's my current modified code:
```python
# Import os for file path management
import os
# Import PPO for algos
from stable_baselines3 import PPO
# Import Base Callback for saving models
from stable_baselines3.common.callbacks import BaseCallback

from google.colab import drive
drive.mount('/content/drive', force_remount=True)

if not os.path.exists(f'{folder_path_temp}/{model_number}'):
    os.makedirs(f'{folder_path_temp}/{model_number}')

# Get the current training times
train_folder_path = f'{folder_path_temp}/{model_number}/train'
if os.path.exists(train_folder_path):
    train_files = os.listdir(train_folder_path)
    train_file_dict = {}
    for file in train_files:
        file_path = os.path.join(train_folder_path, file)
        if os.path.isfile(file_path):
            train_num = int(file.split('_')[-1].split('.')[0])
            train_file_dict[file] = train_num
    current_train_num = train_file_dict[max(train_file_dict, key=train_file_dict.get)]

class TrainAndLoggingCallback(BaseCallback):

    def __init__(self, check_freq, save_path, verbose=1):
        super(TrainAndLoggingCallback, self).__init__(verbose)
        self.check_freq = check_freq
        self.save_path = save_path
        self.model_counter = current_train_num + check_freq  # Set the model counter to the current number of training times

    def _init_callback(self):
        if self.save_path is not None:
            os.makedirs(self.save_path, exist_ok=True)

    def _on_step(self):
        if self.n_calls % self.check_freq == 0:
            model_path = os.path.join(self.save_path, 'best_model_{}.zip'.format(self.model_counter))
            self.model.save(model_path)
            self.model_counter += check_freq  # Increase the model counter by check_freq after each save

        return True

# Setup model saving callback
callback = TrainAndLoggingCallback(check_freq=check_freq, save_path=CHECKPOINT_DIR)

# This is the AI model started
model = PPO('CnnPolicy', env, verbose=1, tensorboard_log=LOG_DIR, learning_rate=learning_rate, n_steps=n_steps)

if os.path.exists(train_folder_path):

    # Get the most training times model
    max_train_num_file = max(train_file_dict, key=train_file_dict.get)

    # Build the path of the most training times model
    max_train_num_file_path = os.path.join(train_folder_path, max_train_num_file)

    # Load the most training times model before model.learn
    if os.path.exists(max_train_num_file_path):
        model.load(max_train_num_file_path)
        print(f'Loaded model from {max_train_num_file_path}')

# Set the total timesteps as the sum of last training numbers and total timesteps
remaining_timesteps = total_timesteps - current_train_num
print(remaining_timesteps)

# Train the AI model, this is where the AI model starts to learn
model.learn(total_timesteps=remaining_timesteps, callback=callback, reset_num_timesteps=False, tb_log_name='PPO')
```

Thank you so much for your help with this issue. I'm grateful for your assistance in understanding the issue and for suggesting solutions to resolve it. Thank you again for all of your help!

StarKnightt, 2023-04-16:
The log directory may also need to have the files loaded. The tensorboard logs that document your model's development throughout training are stored in the log directory files. The model might not be able to pick up where it left off with its training if you do not load them.
To load the log directory files, you can pass the path to the log directory to the `tensorboard_log` argument when you create the `PPO` object. In your code, you're already doing this, so you should be good to go.
However, be sure to use the same log directory that was utilized for the earlier training sessions. The model might not be able to continue training from where it left off if the log directory changes between training sessions.
Hopefully, it will help you.

StarKnightt, 2023-04-27:
It's possible that the model is still starting from scratch due to the way you are setting the total timesteps. If you set reset_num_timesteps=False, the model will continue training from where it left off. However, in your code, you are setting remaining_timesteps to total_timesteps - current_train_num, which could be resetting the timesteps to zero.

You mentioned that the previous training batch had 512 steps, but it's not clear how you arrived at the number 1000448. If the model had already been trained for 1000000 steps and you want to continue training from that point, you should load the model checkpoint that was saved at 1000000 steps.

You can check the number of timesteps trained by inspecting the num_timesteps attribute of the model object. You can also check the name of the latest saved model checkpoint by looking at the files in the checkpoint directory.

I took help from ChatGPT, because I had no idea this time.

WULukeWU, 2023-05-07:
Hi! Thank you for patiently answering my questions. After consulting with ChatGPT, I modified the "learn" section of the code to the following:
```python
import tensorflow as tf
from stable_baselines3 import PPO

ppo_model = PPO("MlpPolicy", "CartPole-v1", verbose=1)

class PPOTrackable(tf.train.Checkpoint):
    def __init__(self, ppo_model):
        super().__init__()
        self.ppo_model = ppo_model

trackable_ppo = PPOTrackable(ppo_model)
checkpoint = tf.train.Checkpoint(model=trackable_ppo)

# Save model
checkpoint.save('my_model')

# Load model
checkpoint.restore(tf.train.latest_checkpoint('./'))

# Continue training
# model.learn(total_timesteps=remaining_timesteps, callback=callback, reset_num_timesteps=False, tb_log_name='PPO')
model.learn(total_timesteps=total_timesteps, callback=callback, reset_num_timesteps=False, tb_log_name='PPO')
```
In this modified code, when "model.learn()" is called, it successfully loads the logs and continues the previous training process. The "training_steps" that are printed out also continue to increment from the previous value, rather than starting from 0.

I believe that I have successfully solved the issue and there are no major problems. Thank you again for your help, I have learned a lot as a beginner. 🙏

Closed 2023-05-07.
