openai/gym/(commit log)

2016-04-27 Initial release. Hello world :).
    [ant.xml, half_cheetah.xml, hopper.xml, humanoid.xml, inverted_double_pendulum.xml, inverted_pendulum.xml, point.xml, reacher.xml]
2016-04-28 README: switch to public clone URL
2016-05-01 Mark current requirements as dev tool, add real dependencies as requirements
2016-05-01 Disable Python 3's exception chaining when reraising
2016-05-03 fixed bug (frame_shape -> frame.shape) (#50)
2016-05-04 Set restriction on selected actions for MountainCar-v0 (#47)
    * Set restriction on selected actions
    * Used self.action_space instead of custom set
    * Move action validation to core.py
2016-05-07 Issue 45 - Easily return environment score values (#57)
    * Added env.score() function to return current score
    * Set up multi monitor scoring
    * Removed unneccesary package inclusions
    * Monitor writes scores automatically. Video callable can now use monitor_id
    * Monitor ID not necessary for video filtering
    * Fix so final stats get written when env.reset() doesn't happen
    * gitignore PyCharm Project Files
    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
2016-05-07 Fix flushing of final episode in monitor
    Thanks @JKCooper2.
    We also change to getting the PID at monitor construction time, rather
    than at runtime. This means you need to start your environments
    post-fork, which should be fine.
2016-05-10 Fix Python3 compatibility in Go env (#64)
    Under Python3, user inputs are in string format and needs be
    converted
    into bytes before passing to pachi-py. The returned __repr__ from
    pachi-py for the boards are bytes and needs be converted into string
    for
    line breaks to work.
    Also fixed raw_input and print functions in play_go under
    examples/scripts with six package.
2016-05-10 n-Chain environment added (#61)
    * n-Chain environment added
    * nchain: match original paper's timestep limit
2016-05-16 windows: Switch video_recorder to use -
2016-05-16 Capture logs in tests
    [unittest.cfg]
2016-05-16 BipedalWalker, LunarLander heuristic, retuned (#101)
    * bipedal_walker: trivial fixes
    * lunar_lander: heuristic test code, renormalized and tested reward, longer state vector
    * bipedal_walker: heuristic test code, renormalized and tested reward, legs contact with ground in state vector
    * bipedal_walker: description text
2016-05-20 Add Doom envs (group key doom)
    [basic.cfg, deadly_corridor.cfg, deathmatch.cfg, defend_the_center.cfg, defend_the_line.cfg, health_gathering.cfg, my_way_home.cfg, predict_position.cfg]
2016-05-26 Fix crash bug in DoomDeathmatchEnv
    [deathmatch.cfg]
2016-05-27 Add HumanoidStandup-v0 env (PR #125)
    [humanoidstandup.xml]
2016-05-29 [WIP] add support for seeding environments (#135)
    * Make environments seedable
    * Fix monitor bugs
    - Set monitor_id before setting the infix. This was a bug that would yield incorrect results with multiple monitors.
    - Remove extra pid from stats recorder filename. This should be purely cosmetic.
    * Start uploading seeds in episode_batch
    * Fix _bigint_from_bytes for python3
    * Set seed explicitly in random_agent
    * Pass through seed argument
    * Also pass through random state to spaces
    * Pass random state into the observation/action spaces
    * Make all _seed methods return the list of used seeds
    * Switch over to np.random where possible
    * Start hashing seeds, and als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
2016-05-31 Switch to a global PRNG for action/observation spaces (#144)
    cf https://github.com/openai/gym/commit/58e6aa95e5af2c738557431f812abb81c505a7cf#commitcomment-17669277
2016-05-31 Fix mountain car rendering (#147)
2016-05-31 Suppress warning from deathmatch.cfg (Fix #130)
    [deathmatch.cfg]
2016-06-01 Fix failing DoomDeathmatch test (altattack -> alattack)
    [deathmatch.cfg]
2016-06-01 Make agent examples compatible with python 3 (#150)
    * make cem agen exaple compatible with python 2 and 3
    * make the keyboard_agent example compatible with python 2 and 3
    Changing `xrange` to `range` should not impact performance unless we're
    generating millions of elements (currently only 1000).
    * remove algorithm_id from the upload call
2016-06-06 Update README.rst (#158)
    Fixed LunarLander version in code sample.
2016-06-09 Go back to lazily creating the monitor
    The refresh case is complicated enough that special handling is needed anyway
2016-06-13 Improves safety docs (#182)
    * add interruptibility method
    * revise docs for interruptibility method
    * improves safety docs
2016-06-14 Doom - Same Action Space Across Environments (#157)
    * Doom - Added reward_threshold and timestep_limit for all environments
    * Doom - Returning all available game variables
    * Doom - Moved _seed to doom_env to avoid repetition in every environment
    * Doom - Added ALT_ATTACK and made all action_space equivalent (same controls between environments).
    * Doom - Actions can either be a short list of allowed actions or the full list of 41 commands
    * Doom - Returning black observation space on error or is_finished, rather than empty list (which was triggering an error)
    * Doom - HighLow.sample() returns the small list.
    * Doom - Updated difficulty for some missions
    * Doom - Fixed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
    [basic.cfg, deadly_corridor.cfg, deathmatch.cfg, defend_the_center.cfg, defend_the_line.cfg, health_gathering.cfg, my_way_home.cfg, predict_position.cfg]
2016-06-16 Tighten assertions (#197)
2016-06-18 adds timestep limit to cartpole safety envs (#215)
    * add probabilistic off-switch cartpole environment
    * renames prob_offswitch_cartpole to offswitch_cartpole_prob
    * adds timestep_limit to cartpole safety envs
2016-06-22 Add _configure option to adjust Doom output resolution
    [basic.cfg, deadly_corridor.cfg, deathmatch.cfg, defend_the_center.cfg, defend_the_line.cfg, health_gathering.cfg, my_way_home.cfg, predict_position.cfg]
2016-07-04 Deallocate opponent and board in _close in GoEnv (#233)
2016-07-19 Issue #243 - Invalid action space for DoomDeathmatch-v0 (#245)
    [deathmatch.cfg]
2016-08-04 Pin scipy
2016-08-08 Fixed Issue #267 - Hex9v9-v0 does not behave as it should when there is a full game board. (#274)
2016-08-10 Switch to Docker for tests (#285)
2016-08-11 Switch to quay.io/openai/gym:base for tests
2016-08-15 Wrapper - Common frame skipping (#293)
    * Common frame skipping
    * Common frame skipping - Fixes
    * Raising error if skip.stepcount already in info.
2016-08-24 Moved doom to gym_doom (#319)
    [basic.cfg, deadly_corridor.cfg, deathmatch.cfg, defend_the_center.cfg, defend_the_line.cfg, health_gathering.cfg, my_way_home.cfg, predict_position.cfg]
2016-08-24 added continuous mountain car v0 (#306)
    * added continuous mountain car v0
    * spotted that the action should be a vector, not a scalar
    * fixed bug on action format
    * bug fixed in scoreboard registering
    * the observation (aka state) should be a numpy array
    * added comment on reward range as requested
2016-08-25 Add Atari environments with deterministic frameskip
2016-08-30 limit the action on mountain car so that there isn't a trivial win scenario. otherwise, you can simply pass action=10 into the env.step() and win. see https://gym.openai.com/evaluations/eval_4oWGpaKr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
    also did a couple minor cleanups while I was in there
2016-09-02 Recording traces
    With monitor is started with `.start(…save_trace=True)`, record
    complete action/observation/reward tuples for any environment. Does it
    efficiently in picked numpy arrays in the same directly as the other
    monitoring files.
2016-09-04 [WIP] Start adding Filter API (#329)
    Expand Wrapper API
2016-09-08 Change trace recording from a monitor to a wrapper.
2016-09-21 Switch the Gym automated logger setup to configure the root logger rather than just the 'gym' logger
    Python doesn't make it easy for libraries to take responsibility for
    logging configuration (which we do to make simple usage much easier),
    and as we see more Gym plugins, we want their loggers to have an
    appropriate log level too. So we may as well configure the root logger
    level.
2016-10-10 Separate benchmark and evaluation control flow in upload(), add client side validation of benchmark contents
2016-10-15 add reverse action filter for demos
2016-10-21 Thread data_source and initial_reset_timestamps through to scoreboard
2016-10-23 Print out env_id when stepping too far
2016-11-01 Supply default algorithm name in sample upload code
2016-11-22 Switch from median to mean when computing binned graphs
2016-12-02 Cut 2 more nondeterministic envs
2016-12-14 swap avconv / ffmpeg. ffmpeg is obsolete, so it shouldn't be evaled first (crashes on my pc) (#364)
    Avconv seems more likely to work for more people, so switch
2017-02-01 TimeLimit refactor with Monitor Simplification (#482)
    * fix double reset, as suggested by @jietang
    * better floors and ceilings
    * add convenience methods to monitor
    * add wrappers to gym namespace
    * allow playing Atari games, with potentially more coming in the future
    * simplify example in docs
    * Move play out of the Env
    * fix tests
    * no more deprecation warnings
    * remove env.monitor
    * monitor simplification
    * monitor simplifications
    * monitor related fixes
    * a few changes suggested by linter
    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
2017-02-09 Mark current version as 0.7.4-alpha
2017-02-09 Mark current version as 0.7.4-dev
2017-02-12 improve toy_text printing
2017-02-12 switch to pytest (#495)
    * switch to pytest
    * remove observation space sampling
    * fix test
2017-02-13 * Print local benchmark score
    * Turn off video recording for benchmark_runner
    * Add force argument to benchmark runner
2017-02-13 Thread episode lengths through when scoring, add tests
2017-03-06 README: link to What’s New, fix two other glitches
2017-03-06 Tighten up this docstring
2017-03-28 Generalized Kelly Coinflip game: add a check to init in case anyone accidentally calls init with seed=False, per tlbtlbtlb
2017-04-23 Add mujoco manipulations tasks to environments (#557)
    * Add pusher, striker, thrower
    * Remove comments in striker xml
    [pusher.xml, striker.xml, thrower.xml]
2017-05-08 Add GYM_NO_LOGGER_SETUP to disable logging config
    This is useful for frameworks which are often used with Gym but don't
    have a direct dependency on it
2017-05-14 include Atari environments v4 in the change log
    gym 0.9.1 upgrades the Atari environments to v4 by:
    - upgrading atari-py to the latest ALE, including ROM fixes
    https://github.com/openai/atari-py/pull/15
    - upgrading gym to the latest atari-py and declaring Atari v4
    https://github.com/openai/gym/pull/584
    - exposing snapshot/restore of Atari environments through gym
    https://github.com/openai/gym/pull/575
    Switching to v4 is encouraged for correctness, although the environment
    differences are minor. For exact comparison with existing Atari v3
    results, make use of earlier gym and atari-py versions.
2017-06-21 Pin mujoco-py to <1.0.0
    We'll upgrade Gym to use it at a later date, however that will likely involve bumping all the envs, which we're trying to avoid for now.
2017-06-22 Pin mujoco-py in tox.ini as well
2017-09-03 only close env if it exists (otherwise we get bad stack traces when construction fails)
2018-01-26 Cleanup, removal of unmaintained code (#836)
    * add dtype to Box
    * remove board_game, debugging, safety, parameter_tuning environments
    * massive set of breaking changes
    - remove python logging module
    - _step, _reset, _seed, _close => non underscored method
    - remove benchmark and scoring folder
    * Improve render("human"), now resizable, closable window.
    * get rid of default step and reset in wrappers, so it doesn’t silently fail for people with underscore methods
    * CubeCrash unit test environment
    * followup fixes
    * MemorizeDigits unit test envrionment
    * refactored spaces a bit
    fixed indentation
    disabled test_env_semantics
    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
2018-02-06 Add tracking cameras to mujoco environments (#862)
    This adds a camera which tracks the robot from a fixed pose relative to
    the center of mass.
    [ant.xml, half_cheetah.xml, hopper.xml, humanoid.xml, humanoidstandup.xml, walker2d.xml]
2018-02-26 New robotics environments (#912)
    [F1.stl, F2.stl, F3.stl, TH1_z.stl, TH2_z.stl, TH3_z.stl, base_link_collision.stl, bellows_link_collision.stl]
2018-03-01 Add missing license notices (#919)
    [robot.xml]
2018-03-23 Fix (#943) missed underscored methods (#944)
    Appears a couple of underscores were missed during the cull. Should
    now render.
2018-04-05 Remove joints from table to avoid that Fetch can slide it to cheat (#962)
    * Remove joints from table to avoid that Fetch can slide it to cheat
    * Bump Gym version
    * Bump version
    * Do not bump Hand
2018-04-07 Add new Environment in environments.md (#951)
    I added a reference to my recently published Sokoban environment.
    I am not 100% sure if this is the right place to add the environment. In case it is not the right place please let me know which is better. ;-)
2018-08-24 Pass frameskip and repeat_action_probability to AtariEnv EzPickle (#1124)
2018-08-30 add maxwidth parameter to viewer; resize image if it’s larger (#1151)
2018-09-17 pass device_id=-1 when rendering mujoco in rgb_array mode (#1167)
2018-09-21 Add depth rendering from camera (#1114)
    * Add depth rendering from camera
    Allow the mujoco renderer to return the depth image using the `depth_array` mode.
    It follows the `rgb_array` extraction method.
    * Depth data is a 2d array.
    * Add depth_array to render modes.
2018-09-21 test dockerfiles for ubuntu 14.04 and 18.04 (#1168)
    * pass device_id=-1 when rendering mujoco in rgb_array mode
    * trying ubuntu18.04 build
    * use travis build matrix
    * use travis build matrix
    * use travis build matrix
    * use fix 18.04 installation steps
    * use fix 18.04 installation steps
    * try py3 instead of py35
    * trying the 14.04 build; cleaning up the 16.04 package list
    * fixes to dockerfile.14.04
    * fixes to dockerfile.14.04
    * fixes to dockerfile.14.04
    * fixes to dockerfile.14.04
    * fixes to dockerfile.14.04
    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
2018-09-21 Updated Calculation Order (#1019)
    * Updated order Calculation
    Updated order of `x` and `theta` calculations so that they are no longer one timestamp behind `x_dot` and `theta_dot`.
    https://github.com/openai/gym/issues/1018
    * Added semi-implicit euler option
    * Got implicit and standard euler mixed up
    * switched default option
2018-09-24 remove vertical camera motion on env.reset() (#1174)
    * remove vertical camera motion on env.reset()
    * In MuJoCo envs, don't reset viewers on environment reset. If the user moves around the camera in the viewer, allow them to keep the camera wherever they put it.
    * Docstring update.
2018-10-02 use binary wheels for atari-py and box2d (#1183)
    * bump versions
    * deploy on tags
    * disable ubuntu14.04
    * remove swig and cmake from dockerfiles
2018-12-20 a few minor changes: (#1250)
    - enable atari env to use full action set of 18
    - modify rendering.py to prevent some bad stack traces upon closing
    - enable dict space to be more concisely specified as spaces.Dict(a=Box(…),…)
2019-01-29 Support kwargs in gym.make and export register (#1301)
    * Support kwargs in gym.make
    We avoided adding kwargs for a long time in order to encourage people
    to statically register their environment definitions. However, over
    time we've found a few important use-cases for kwargs, such as:
    - Runtime-specific objects, such as which GPU to run the environment
    on
    - Parametrized environments, which can have an infinite number of meaningful
    variants
    The latter breaks the invariant that the environment ID alone
    determines the semantics of the environment, but it's an advanced
    use-case and such users should be able to manage this on their own.
    * Export the register method so it's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
2019-01-30 fix KellyCoinFlipGeneralizedTest (sample from action_space after seed and reset, as action dimensions in it are also random)
2019-02-06 fix for issue 1256 (Box(low=0, high=255, dtype='uint8').sample() returned zeros) (#1307)
2019-02-09 Add optional touch sensors for hand environments (#1299)
    * extending robotics shadow hand with touch sensors
    * extending robotics shadow hand with touch sensors
    * extending robotics shadow hand with touch sensors
    * extending robotics shadow hand with touch sensors
    * extending robotics shadow hand with touch sensors
    * extending robotics shadow hand with touch sensors
    * extending robotics shadow hand with touch sensors
    * add touch sensors layout
    * add touch sensors layout
    * extending robotics shadow hand with touch sensors
    * extending robotic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
2019-02-27 Fixes to car_racing.py (rendering in mode=human and main method) (#1339)
    * record_video=False by default
    * remove print(isopen)
    * change isopen flag handling to a more compatible way
2019-03-01 Switch to np.frombuffer when rendering image data (#1333)
2019-03-01 Updated Humanoid left_hip range to match right_hip (#932)
    right_hip_y has range -110 to 20. left_hip_y should have the same range.
    [humanoid.xml]
2019-03-07 Set motor and gravity forces as variables (#466)
    Set motor and gravity forces as variables of MountainCarEnv, so they can be modified
2019-03-07 remove reraise logic (#1342)
    * remove reraise logic - replace with re-raising import errors in the only place it is used
    * remove reraise
    * remove reset call from MountainCar constructor
    * further remove reraise
    * remove reraise import in classic_control/rendering.py
2019-03-22 getting play working with montain_car game (#1393)
    * Update play.py
    getting the play function working with game where the observation space is not a Box.
    * Update mountain_car.py
    adding get_keys_to_action method to the montain_car environement
    * Update play.py
    clean for pull request
    * Update play.py
    cleaning
    * Update play.py
    cleaning
2019-03-22 move env docs around (#1399)
    * move env docs around
    * rst
    * de-rst
    * headers
2019-03-25 add optional tracking for mujoco locomotion in the rgb rendering mode (issue 1135) (#1405)
    * switch rgb_array camera to 0
    * merge latest master
    * add tracking camera for swimmer
    * test track camera name to be in valid names
    * add rgb_rendering_tracking kwarg to locomotion mujoco envs; fixes 1135
    * fix track camera logic in mujoco_env.py
    [swimmer.xml]
2019-04-03 gym/envs/robotics - HandManipulate{Block, Egg, Pen}TouchSensors-v1 (#1421)
    * envs/__init__.py: register all HandManipulate...TouchSensors envs
    * manipulate_touch_sensors.py > touch_get_obs='sensordata'
    * HandManipulate...TouchSensors-v0 - boolean sensor readings; HandManipulate...TouchSensors-v1 - original MuJoCo sensordata readings;
2019-05-10 test docker images based on python images (#1474)
    * base test docker image on python images
    * fix py3 build
    * fixes for python-based dockerfile
    * re-enable py27 build
    * remove requirements_dev.txt and unittest.cfg (cleaning up build pipeline)
    [unittest.cfg]
2019-05-24 Implement FilterObservationWrapper (#1500)
2019-07-14 Added velocity goal constraint in continuousmountaincar (#1562)
    * Update continuous_mountain_car.py
    * Update continuous_mountain_car.py
2019-07-14 Added velocity goal constraint in mountaincar (#1561)
    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
2019-07-20 Recursively ravel nested observations (#1581)
    * Recursively check for nested gym.spaces.Dict objects in observation_space.spaces
    * add tests; support nested tuples; asserts for dtype and space
    * support for observation ravel, and more comprehensive tests
    * cleanup print
2019-07-20 Rename FilterObservationWrapper to FilterObservation to be consistent with namings (#1558)
    * Update filter_observation.py
    * Update __init__.py
    * Create test_filter_observation.py
    * Delete filter_observation_test.py
2019-08-14 fix hand serialization tests (#1647)
    * fix serialization by moving EzPickle inheritance to the leaf classes and passing correct arguments to EzPickle
    * fix touch sensor serialization too
2019-08-23 [Wrappers]: add LazyFrames, FrameStack (#1485)
    * Create frame_stack.py
    * Create test_frame_stack.py
    * Update test_frame_stack.py
    * Update frame_stack.py
    * Update test_frame_stack.py
    * Update test_frame_stack.py
    * Update test_frame_stack.py
    * Update frame_stack.py
    * Update gym/wrappers/frame_stack.py
    Thanks !
    * Update gym/wrappers/frame_stack.py
    Thanks !
    * make framestack tests actually run (with and without lz4)
    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
2019-08-23 Feature/pixel observation wrapper (#1499)
    * Implement PixelObservationWrapper
    * Change MujocoEnv.render to support custom camera_{name,id}
    * Implement tests for PixelObservationWrapper
    * Use env.get_pixels instead of direct env.render
    * Fix camera_{id,name} check in pixel observation wrapper
    * Fix rendering with explicit camera_id
    * Add Wrapperget_pixels to allow call to be propagated to wrapped env
    * Remove use of unnecessary `get_pixels` method
    * Update PixelObservationWrapper to support multiple pixel keys
    * Remove unnecessary `rgb_rendering_tracking` argument
    * Remove rgb_rendering_tracking logic
2019-10-04 Adding Frame Normalization in Atari Pre-Processing (#1680)
    * added frame scaling in atari preprocessing
    - default value is False
    * added frame scaling in atari preprocessing
    - default value is False
    * corrected logic for selection of observation_space params
    * initial commit for scale test
    * added test-case for observation scaling in atari
    * added message related to framestack in docstring.
    * refactored scaled obs test for atari preprocessing
2019-10-18 [Delete dict.py]: replace with FilterObservation + FlattenObservation (#1669)
    * Delete dict.py
    * Update nested_dict_test.py
    * update nested_dict_test
    * oh huh revert commented out part of the test, now the test fails due to the lack of proper error :(
    * remove incorrect argument test - now all combinations of spaces and dtypes are possible to flatten (eveything is reduced to float32, discrete are one-hot encoded)
    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
2019-10-18 Added an environment for the board game Go (#1660)
    * Added GymGo to environments list
    * Update environments.md
    moved gym environment to bottom of list
2019-10-25 add gym-electric-motor env to third party list (#1718)
2019-11-01 fix sampling bug (#1730)
    * fix sampling bug
    * remove clipping and do floor samples before type conversion
2019-11-04 added assertion of 'NoFrameskip' in AtariPreprocessing (#1725)
    * added assertion of noframeskip in atari pre-proecessing
    * - corrected frameskipping assertion
    - added non-op assertion as well
2019-11-08 Bugfix: spaces.MultiDiscrete.contains() can handle different shapes (#1740)
    See also space.Box.contains(), it already has this change
    Reproduce Error with following lines:
    from gym import spaces
    import numpy as np
    space_Multidiscrete = spaces.MultiDiscrete(np.ones((10,3)))
    sample_test = np.ones((9,3))
    space_Multidiscrete.contains(sample_test) #errors: ValueError: operands could not be broadcast together with shapes (9,3) (10,3)
2020-01-24 Discrete contains may not handle numpy types correctly
    ```
    np.uint8(0).dtype.kind in np.typecodes['AllInteger'] == False
    np.uint8(0).dtype.char in np.typecodes['AllInteger'] == True
    ```
    ```
    dtype.kind A character code (one of ‘biufcmMOSUV’) identifying the general kind of data.
    dtype.char A unique character code for each of the 21 different built-in types.
    ```
2020-01-25 Add usage for MultiBinary space (#1791)
    * Add usage for MultiBinary space
    * Add multibinary observation space example usage and sample
2020-01-31 Fix BipedalWalker - now returns closest lidar trace instead of furthest (#1789)
    * Fix BipedalWalker - now returns closest lidar trace instead of furthest
    * additional fix for raycast failing to get nearest point
    * bump bipedal walker versions from v2 to v3
2020-02-29 Video recorder: distinguish input and output fps (#1817)
    * Video recorder: distinguish input and output fps
    Common video players such as VLC, or Quicktime struggle to play videos
    with low framerate, which is problematic for environments where the
    policy
    frequency is low (e.g. 1 Hz).
    See: https://superuser.com/a/601916
    This commit sets:
    - The input image sequence framerate to the metadata
    'video.frames_per_second'
    - The output video framerate to at least 30 fps
    * Use a configurable output video framerate
    This output video framerate is different from the image sequence
    framerate:
    - when the environment fps is low, the output video fps can be increased
    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
2020-02-29 Fix unnecessary warnings (#1800)
    * Update pendulum.py
    * Update cartpole.py
    * Update mujoco_env.py
    * Update acrobot.py
    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
2020-03-06 Add gym-jiminy in the third-party environments doc (#1835)
    I have developed a new open source simulator for poly-articulated system called Jiminy. It relies on the powerful rigid body dynamics framework Pinocchio for the physics evaluation, and meshcat for real-time visualization.
    I think the project is now mature enough for everyone to use it, despite being partially undocumented. The library has been designed for fast prototyping of control algorithms and machine learning. It is easy to use and several examples of classical control theory and machine learning are available (cartpole, double and simple pendulums).
2020-04-10 Make reward always return a float number (#1857)
    In the current implementation, *reward* sometimes returns integer values, and other times returns float values.
    The example below corresponds to three random episodes and showcases how reward contains -1.0 and -1 values.
    [((13, 1, False), 0, -1.0)]
    [((18, 10, False), 1, -1)]
    [((5, 10, False), 1, 0), ((8, 10, False), 1, 0), ((18, 10, False), 1, 0), ((20, 10, False), 0, -1.0)]
    This change tries to fix that, and guarantee that a float value is always returned.
    Hope it helps!
    Miguel
2020-04-10 Clean up continuous mountain car environment (#1867)
    * Clean up continuous mountain car
    * Convert possible numpy bool to Python bool.
2020-04-10 Use action space bounds in continuous mountain car environment (#1869)
2020-04-17 Update atari_preprocessing.py (#1790)
    Correct bug that prevents AtariPreprocessing from working with frame_skip = 1.
2020-04-24 Clean some docstrings (#1854)
    * add type of argument
    * fix typos
    * split lines for formatting
    * reformat string, add ellipsis, remove r string
    * make docstring stylistically consistent
    * make docstrings a little more elaboratet
    * reduce by 1 space
    * make line wrap 120
    * remove unnecessary line
    * add returns to docstring
    * add docstring, make code more pep8 and delete some unused print functions
    * more pep8
    * file docstring instead of comments
    * delete unused variables, add file docstring and add some pep8 spring cleaning
    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
2020-04-24 made fetchenv sample goal flexible (#1799)
2020-05-08 Improve observation space of FlattenObservation wrapper (#1884)
    * Add tests for gym.spaces.utils.
    * Add docstrings to gym.spaces.utils.
    * Remove some trailing whitespace.
    * Add gym.spaces.utils.flatten_space.
    The new function also is reexported as gym.spaces.flatten_space. It
    improves the determination of observation_space in
    gym.wrappers.FlattenObservation.
    * Produce OrderedDict instead of dict in gym.spaces.unflatten().
    `gym.spaces.Dict` is very particular about producing its samples as
    `OrderedDict` in order preserve the order of its items. Hence,
    `unflatten()` should reproduce this behavior.
    * In test_utils.compare_nested, also verify order of OrderedDict items.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
2020-05-08 fix "Could not create GL context" (#1889)
    * fix "Could not create GL context"
    * get available display in case of None spec - create context all the time
2020-05-08 Allow Box more flexibility in how shape is provided (#1873)
    The current implementation of Box doesn't allow passing an array as low or high while also providing a shape.
    The current implementation of Box doesn't allow passing an array as low or high and a constant as the other bound.
2020-05-15 fixed close() method for Viewer to be consistent with SimpleImageViewer() (#1912)
    fixed close() method for Viewer to be consistent with SimpleImageViewer(), otherwise I get the same error:
    Exception ignored in: <bound method Viewer.__del__ of <gym.envs.classic_control.rendering.Viewer object at 0x112ea2f60>>
    Traceback (most recent call last):
    File "/Users/hadavid/anaconda/lib/python3.6/site-packages/gym/envs/classic_control/rendering.py", line 162, in __del__
    File "/Users/hadavid/anaconda/lib/python3.6/site-packages/gym/envs/classic_control/rendering.py", line 81, in close
    File "/Users/hadavid/anaconda/lib/python3.6/site-packages/pyglet/window/cocoa/__init__.py", line 277,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
2020-05-15 Description for mountain_car.py (#1904)
    Added description for the mountain_car environment. As a beginner this description would have saved a lot of time for me for understanding the environment.
2020-05-15 Fix robot.xml spelling mistake (#1908)
    [robot.xml]
2020-05-29 Change tabs into spaces (#1932)
    Tabs were mixed up with spaces, resulting in the file being weirdly formatted in editors were tabs are not rendered with 4 spaces (e.g. GitHub https://github.com/openai/gym/edit/master/gym/envs/classic_control/mountain_car.py)
2020-05-29 pyglet GL context for SimpleImageViewer case (#1916)
    * pyglet GL context for SimpleImageViewer case
    * typo fxd 'viewer_type' argument in get_window()
    * use **kwargs in get_window()
    * remove viewer_type from Viewer class
2020-06-12 Improve description of MountainCar environment.
2020-06-19 Clean up mountain car environment (#1961)
    * Clean up mountain car environment.
    * Add whitespace around division operator.
2020-06-19 Specify the camera of depth_array (#1960)
    * specify the camera of depth_array
    * exclude human
2020-06-19 Set default image color to white (#1928)
    In gym.envs.classic_control.rendering, Geom has a color attribute,
    which is initialized as black. This is a good default for most Geom
    subclasses, such as lines and circles. However, in the case of Image
    instances, the result is a completely black image - in the case of an
    image without transparency, the result is a black square. This can be
    easily fixed by setting the default color for Image instances as white,
    which causes images to be displayed normally.
2020-08-14 include low, high, & dtype in spaces.Box.__repr__ (#1974)
    * include low, high, & dtype in spaces.Box.__repr__
    multitask learners need a way to make a sensor for each space, and it's possible for two different Box spaces to have the same shape but different low/high/dtype, so this pull request just adds the minimum low value, maximum high value, and the dtype to Box.__repr__ so we can use str(box_space) as a key in a ModuleDict of sensors
    * f-string to format
    * fix typo
2020-08-28 Clarify relationship between reset() and RNGs (#2019)
    The current docstring for `reset()` seems to indicate that the
    environment will be identical after separate calls to `reset()`.
    However, the `reset()` function isn't supposed to reset the states of
    the environment's RNGs [1]. This change clarifies the relationship
    between the `reset()` function and the RNGs.
    [1]: https://github.com/openai/gym/issues/250
2020-11-07 Remove Python 3.5 support, travis and setup.py maintenance (#2084)
    * remove python 3.5, update travis
    * add travis
    * add cmake during tests
    * add swig
    * disable python 3.8 removal?
    * remove depricated failover
    * add opencv and pillow minimum versions
    * try removing pillow minimum version
    * try older version of ubuntu
    * reup ubuntu
    * make pillow version suitable for pyglet version range
    * remove extraneous run
    * rerun stalled CI
2021-03-31 Revise the unattainable reward_threshold to an attainable value (#2205)
    **Issues:** The current `reward_threhold` for `FrozenLake-v0` and `FrozenLake8x8-v0` is too high to be attained.
    Commit: https://github.com/openai/gym/commit/df515de07d0a0767b1b3c8c79e0c1386e0c3f172 @joschu
    **Solution:** Reduce the `reward_threhold` to make them attainable.
    **Reference:** Codes to calculate the theoretic optimal reward expectations:
    ```python
    import gym
    env = gym.make('FrozenLake-v0')
    print(env.observation_space.n) # 16
    print(env.action_space.n) # 4
    print(env.spec.reward_threshold) # 0.78, should be smaller
    print(env.spec.max_episode_steps) # 100
    v = np.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
2021-05-17 fix build by disabling mujoco and moving to newer python patch versions (#2220)
    * reverting to older version of 3.6 python to test if the build is failing because of that
    * revert 3.7 to 3.7.3 for the build
    * revert python 3.8 version to 3.8.1
    * do not install mujoco on 3.8 and 3.9
    * enable mujoco for 3.7
    * .
    * .
    * .
    * use regex to navigate python version dependent package installation
    * .
    * try only one python version at a time
    * switch to possibly more popular python tag for 3.6
    * disable mujoco
2021-07-26 BUG FIX: Bipedal Walker; Car Racing; Guessing Game; Hotter Colder - Showing Warning (#2126)
    * Fixing Warning issue
    Fixing an issue causing a Warning message to pop because of conversion from python standard float64 to np.float32
    * car_racing.py Warning Fix
    Fixed a bug generating a warning with conversion from standard `float 64` to `numpy float 32`.
    * Fixing Warning issue
    Fixed a bug generating a warning with conversion from standard `float 64` to `numpy float 32`.
    * Fixing Warning issue
    Fixed a bug generating a warning with conversion from standard `float 64` to `numpy float 32`.
    * bracket missing
    * Bracket misplaced
2021-07-26 Add description to countinous mountain car task (#2107)
2021-07-26 Fix broken link in docstring (#2154)
    The link to the original implementation of mountain car on incompleteideas.net was broken. Replaced with the correct link.
2021-07-27 Fixes video recorder ffmpeg on Centos7 and RHEL7 (#1893)
    * Conditionally select different arguments for ffmpeg, and add meaningful error for third party application in charge of encoding
    * Consistency with other logger() calls
2021-07-29 Update README.md (#2269)
    Add basic API section. Fix a couple typos toward beginning.
2021-08-26 Autoclose manually maintained video recorders (#2318)
    * Autoclose manually maintained video recorders
    * Update test case for VideoRecorder
    * Update test case for VideoRecorder
    * Update test case for VideoRecorder
2021-09-01 change FrameStack wrapper to inherit from ObservationWrapper (#2378)
2021-09-07 Fix the natural handling in Blackjack (#2398)
    * Added support for fully S&B-compliant version of blackjack
    * Added registration of Blackjack-v1, fully compliant with S&B
    * black
    * black
    * Fix for an edge case where both self.sab and self.natural are true in blackjack. Shouldn't happen, but just in case.
    * black
    * Removed blackjack-v0 registration
    * Add explicit "natural" kwarg to Blackjack-v1
    * Bump Blackjack version in a test
2021-09-11 Remove AtariEnv in favour of official ALE Python package (#2348)
    * Remove AtariEnv in favour of official ALE Python
    * More robust frame stacking test case
    * Atari documentation update
2021-09-25 Pendulum updates (#2423)
    * Pendulum env updates
    Simplify the math a bit (no difference in behavior)
    * Reorder the clipping of angular velocity
    * Bump version of Pendulum
    * Update mentions of Pendulum-v0 to Pendulum-v1.
    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
2021-09-26 Update test case for `VideoRecorder` (#2404)
    * Remove closer for VideoRecorder
    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
